TKyoseva/ARmini/docs/decisions/0002-chassis-on-beams.md

# 0002 · The chassis hangs from the beams, tracks level with the hull bottom (2026-10-02)

Context: the ROB0154 is a top plate plus side plates; the drive wheels are at the front top, and the motor axis is 62 mm above the tracks (measured). The waterline is ~42 mm.
Decision: the plate is bolted directly under the two beams (385 / 500 mm); the tracks are level with the bottom of the hulls, with no hangers and no lift.
Consequences: the motors are 20 mm above the water; the robot leaves the water on a wide ramp together with the hulls; v2 can raise the chassis by 10 mm if the tracks slow the boat down in the water.
