TKyoseva/ARmini/docs/releases/R-1101.md

# R-1101 · 01.11.2026 · G1

**What it shows:** AR-Mini left the bathtub. On one thruster hung from the beams (beam_leg), steered by a printed rudder, wired from the FINAL 2 sheet into a food box and powered by the 3S LiPo, it was launched from the bank at Pancharevo in rain and fog, drove and turned from the phone and came back to the bank. Before that: the right thruster's fault proven on a third driver, the left track driven from the DevKit, both thermal cameras giving first frames, the whole robot assembled dry with tracks.

Cut from Done on the AR-Mini Board, 10 cards. Previous cut: R-1024 (24.10).

| Card | What | Outcome | Number |
|---|---|---|---|
| C029 | MLX90640 110° on the arch, wired to the DevKit | Partial | 0x33 answers, hand max 34.8–35.0 °C, wall 18.3–18.6 °C vs ThermoSpot 17.6; intermittent "not found" at boot; 110° orientation unverified |
| C048 | MLX90642-D45 first heat map | Partial | 0x66 fw 1.20.0, 4 Hz, hand max 36.1 °C, wall 18.1–18.4 °C; range to Pesho not measured |
| C050 | Left track motor, one BTS7960 from the DevKit | Pass | idle 0.002 A at 12.00 V; `s 0.2` 0.067–0.088 A; dead-man stops in 2.000 s |
| C053 | First dry assembly of the whole robot with the tracks | Pass (record) | assembled; tracks removed again for the water runs |
| C054 | The home lab, 28.10 | Pass (record) | — |
| C055 | Both thrusters on an Arduino Mega (FAILS 173) | Pass | left 0.217 / 0.570 / 0.202 A at 1600 / 1650 / 1400 µs (C025 within 5 %); right brown-out loop 1.1–2.1 A, 12 → 8.75 V → right thruster faulty, confirmed |
| C056 | beam_leg: the thruster on the centreline under the beams | Pass | 2 h 37 min · 123.0 g black PETG; carried the thruster in the lake run |
| C057 | Rudder: MG90S + NACA 0015 blade behind the duct | Pass | blade + hub 3 h 09 min · 103.0 g; rudder_frame 2 h 27 min · 104.0 g; calibrated 31.10, turned the robot in the lake |
| C058 | Balance charge of the 3S LiPo | Pass | 11.10 → 12.60 V in 34 min, 1212 mAh, cells 4.20 / 4.20 / 4.20 V |
| C059 | Lake test at Pancharevo, FINAL 2 wiring, `remote_pool`, on battery | Partial | 01.11 08:40–08:52, rain, fog, 7–9 °C: launched, floated level, drove, turned and came back (C059_77 93 s). Lift: one servo on CH13 moved the cradle in the water and above it; Pesho was left at home, so no pick-up · VBAT at the end: not recorded · water in the box: none |

Still open and not in this cut: C021 Pesho v3, C030 pinout freeze, C032 carrier rev B (order pending), C047 camera mount, C049 OV3660 stream, C051 right track motor.

## ★ media (copied to iCloud `AR-Mini-Media/04_Releases/R-1101/`, originals stay in 01_Loops)

C050_11, C050_13, C050_15 · C053_01, C053_02, C053_07, C053_08 · C054_01, C054_04 · C055_03, C055_04, C055_06, C055_10, C055_11 · C056_05, C056_07, C056_08 · C057_04, C057_06, C057_07, C057_08, C057_09, C057_12 · C058_05, C058_06, C058_07, C058_09 · C059_01, C059_28, C059_31, C059_33, C059_37, C059_41, C059_44, C059_46, C059_50, C059_52, C059_53, C059_60, C059_62, C059_67, C059_72, C059_77, C059_78, C059_83, C059_91, C059_92

## Lessons (FAILS_AND_FIXES)

175–177 cameras (see C029/C048) · 178 the FINAL 2 sheet had the breadboard rails mirrored · 179 GPIO1 jumper in the 74HCT125 1OE row (thruster never got a pulse) · 180 OPEN: the cradle lift drives only the higher PCA9685 channel; the lake run used one lift servo on CH13.

## Milestones

R2a (thruster spins in a bucket from the DevKit) was met in R-1024 and is cut with this release. R2c ("swims in the pool on remote control") is met in open water instead of a pool: on battery, one thruster and a rudder, from the phone (12 min on battery; pick-up of Pesho not tried). R3a/R3b (thermal search → approach → lift) are not met: the cameras give frames but are not in the control loop.

## Portfolio

MIT Maker Portfolio v1 (G1): 24 slides P01–P02, P04–P25 + video P03 in iCloud `07_Portfolio/` (25 of 25 media). Not in git (photos never go into git).
