TKyoseva/ARmini/docs/releases/R-1024.md

# R-1024 · 24.10.2026 · G1

**What it shows:** both hulls are joined into one frame with beams, arch and arm; the arm lifts Pesho from the bench; the thruster spins from the DevKit and from a phone over WiFi with a tested fail-safe; and the whole robot floats stable in the bathtub and moves on one thruster.

Cut from Done on the AR-Mini Board, 13 cards. Previous cut: R-1018 (18.10).

| Card | What | Outcome | Number |
|---|---|---|---|
| C005 | thruster_arm on the thruster: 4 × M4 | Pass | all 4 M4 × 12 by hand → pattern 35.0 × 15.9 right; duct ring 42.95 long (not 112) |
| C006 | Thruster ESC at 9 V / 0.10 A in a bucket | Pass | idle 0.009 A; yellow idles 4.983 V, ~3.9 kΩ pull-up to 5 V → S8050 shifter, inverted output |
| C019 | 2 × pivot_bracket + 2 × TD-8120MG + linkages | Pass | assembled, bolted to both hull_fores, mirrored, swings by hand |
| C020 | Cradle: Ø5 aluminium rod bent into a U | Pass | legs ≈ 232, base not yet on the caliper; lifts Pesho between the hulls |
| C022 | R1b frame: right hull_fore + 2 × arch_post + arch tube | Pass | right hull_fore 6 h 17 min · 345.0 g PLA |
| C023 | Bench `pair` command: two TD-8120MG mirrored | Pass | lifts Pesho between the hulls at ~0.24 A |
| C024 | Bench `esc` env: both ESCs on GPIO1/2 | Pass | 1500 µs from the first line of setup(), arm 3 s, limit 1350–1650, ramp 200 µs/s |
| C025 | Thruster spins in a bucket from the DevKit | Pass | 1600 µs → 0.22 A, 1650 → 0.58 A, 1400 reverse → 0.21 A at 12 V; KILL → 1500 µs in 40 ms; right thruster faulty (FAILS 173) |
| C027 | Ladder bench: battery divider, leak, KILL | Pass | v_bat fit within ±0.02 V from 10 to 12.6 V |
| C028 | Drive on remote over WiFi + first float of the whole robot | Partial | draft 20 mm, dry hulls; left thruster 1640 µs · 0.58 A at 12 V moves and turns it; SAFE on stop / kill / disconnect / heartbeat. Open: second thruster, range walk, pool |
| C034 | hull_aft × 2 in PETG | Pass | 7 h 30 min + 7 h 34 min · 410.0 g each |
| C042 | Thruster mounts on the transom | Pass | 4 × ruthex M3 per pad at 220 °C; bracket plates do not rock |
| C045 | 4 × beam_bracket + 15 × 15 aluminium beams | Pass | 8 printed, 1 h 14 min · 39.0 g black PLA; beams seated at x 385 / 500 |

## ★ media (copied to iCloud `AR-Mini-Media/04_Releases/R-1024/`, originals stay in 01_Loops)

C005_04, C005_05 · C006_05 · C019_36, C019_41 · C020_03 · C022_16 · C023_15, C023_27 · C025_02, C025_04 · C027_01 · C028_04, C028_08, C028_10, C028_13, C028_16 · C034_35 · C042_04, C042_12 · C045_13

## Lessons (FAILS_AND_FIXES)

171 I2C one pin off · 172 two arm screws sheared on the first powered lift (arms clocked differently on the splines) · 173 right thruster clicks and never starts (swap onto the proven channel first) · 174 the phone remote went SAFE on ARM (unsigned time difference).

## Milestones

R2a ("thruster spins in a bucket from the DevKit; kick-up coupon fits") is met by C025 + C005/C042 and can be cut. R2c ("swims in the pool on remote control") is half-way: on remote in the bathtub, one thruster, tethered.

## Video

Release video: not cut yet (release video agent, `tools/video`).
