TKyoseva/ARmini/tasks/night/2026-10-22_T8_ladder-30k.md

# T8 · Ladder divider is 100k/30k, not 100k/33k · C027

**Branch** `night/ladder-30k` → PR to `dev` (small; can also go straight on `dev` from Desk 2)
**Budget** 15 min

## Goal
The fitted bottom resistor on the bench is 30 kΩ (measured 30 kΩ, top 100 kΩ, total 130 kΩ). Update the nominal so v_bat = v_adc × 130/30 (4.33) instead of 133/33 (4.03).

## Files to change
- `firmware/bench/include/pins_devkit.h` line ~60: `VBAT_DIV_R_BOT_OHM 30000.0f`, SOURCE note "C027 bench, measured 30 k".
- `firmware/bench/src/ladder/main.cpp`: comments "4.03" and "12.6 V × 33/133 = 3.13 V" → 4.33 and 12.6 × 30/130 = 2.91 V.
- `firmware/bench/src/ladder/PROTOCOL.md`: 133/33 → 130/30 everywhere.
- Do NOT change `pcb/carrier-revA/SPEC.md` (the PCB keeps 33 k); add one line there only if a note is useful: "bench C027 uses 30 k".

## Definition of done
- [ ] `grep -rn "133\|33000" firmware/bench` shows no stale divider value
- [ ] `pio run -e ladder` builds, `scripts/check.sh` green
- [ ] commit `firmware: ladder divider bottom (33k → 30k) · C027`
