TKyoseva/ARmini/docs/releases/R-1018.md

# R-1018 · 18.10.2026 · G1

**What it shows:** the R1b mechanical parts are printed and fitted by hand, the motor PWM pins are safe at boot, and every ordered part has arrived.

Cut from Done on the AR-Mini Board, 8 cards. Previous cut: R1a (11.10). Board tab History (CH01–CH15) added in the same period.

| Card | What | Outcome | Number |
|---|---|---|---|
| C011 | Orange plate: arm_drive, 2 × arm_idler, 2 × coupler (PLA) | Partial | 1 h 12 min · 41.0 g; thruster_coupon skipped (C005 tests the real arm) |
| C015 | GPIO39–42 at boot: is the left BTS7960 driven at reset? | Partial | 39 reads 3.148 V running / 3.231 V in download mode, 0 V with 10 kΩ → 10 kΩ pull-downs on 39–42 |
| C035 | Arrivals 12.10: lab supply, 4 × ST3215, MLX90640, BNO055, Pi 5, logic analyser | — | delivery record |
| C037 | Black R1b plate: 2 × pivot_bracket (mirrored) + 2 × arch_post | Pass | 5 h 45 min · 176.0 g |
| C038 | Cable hole in both pivot_brackets so the TD-8120MG seats | Pass | ears flat on the block face, arm_drive on the disc horn |
| C039 | Pesho v3: head + lid (PETG), body (PLA) | Partial | body 4 h 44 min · 143.0 g; left arm broke on removal |
| C040 | Arrivals 13.10: the last Amazon batch | — | BOM has no row left in Ordered or Dispatch |
| C041 | Thruster kick-up mounts after the CAD fix (pin 14 → 19) | Pass | 2 h 52 min · 96.0 g PETG |

## ★ media (copied to iCloud `AR-Mini-Media/04_Releases/R-1018/`, originals stay in 01_Loops)

C011_01 (timelapse), C011_11, C011_15, C011_16 · C015_02 · C019_04, C019_07 (C038) · C021_10, C021_21, C021_22 (C039) · C035_04 · C037_04, C037_08 · C040_18 · C041_03, C041_04, C041_06

## Lessons (FAILS_AND_FIXES)

151 thruster arm boss collided with the bracket plate (caught in CAD) · C038 servo pocket had no cable slot · C039 cut tree supports before lifting a part off the bed.

## Video

Release video: not cut yet (release video agent, `tools/video`).
