TKyoseva/ARmini/docs/timeline/TIMELINE.md

# Timeline (real dates)

The repository was created on 2026-10-06. Everything before that date was **imported** with the original files kept; the dates below are the real ones (photo EXIF, documents, emails), not the commit dates.

| Date | What | Evidence in the repo |
|---|---|---|
| 2025-09 | Start of AmphiReach with Horizon Academic (mentor John Hood) | — |
| 2025-… | Simulation environment, 64 missions | sim/ |
| 2026-… | Paper accepted by NHSJS; revision ready 30.09.2026 | (the manuscript is not in the repo) |
| 2026-… | Presented at the Bulgarian Academy of Sciences (IMI) and UchIMI | docs/ |
| 2026-09-28 | Decision to build the physical prototype AR-Mini for the MIT Maker Portfolio | docs/decisions/ |
| 2026-10-02 | First measurements of the ROB0154, TD-8120MG, XIAO; CAD v1.4–1.6 | cad/openscad |
| 2026-10-03 | Power box (printed, blue PLA, test piece); rev 0 breakout board generated | pcb/xiao-breakout-rev0 |
| 2026-10-04 | Lab equipment (Bauhaus); BOM v04.10; repository structure | docs/bom |
| 2026-10-05 | TD-8120MG measured → CAD v1.8; rev 0 DRC in three rounds → clean | pcb/xiao-breakout-rev0/drc |
| 2026-10-06 | 3D model → beams collide with the power box → CAD v1.9; architecture v1; visual BOM; first thruster arrived; repository created | cad/3d, docs/diagrams, media/photos |
| 2026-10-07 | DevKit-Lipo and measuring tools arrive; breadboard sheets; new plan: alone + AI agents, goal 01.11; test tracker, AGENTS.md, CI checks | AGENTS.md, docs/process, hardware/breadboard, .github |
| 2026-10-08 | C001 thruster measured, C002 thruster wires tested; first night task (T1) | data/board, docs/decisions/0004 |
| 2026-10-09 | C003 plate measured (Fail) → CAD v2.0 with the kick-up thruster mount; kanban board; specs for the parts and video agents | cad/openscad, tasks/night, parts/ |
