TKyoseva/ARmini/tasks/night/2026-10-08_T2_safety.md

# T2 · Safety layer (leak, kill, battery, heartbeat) with tests

**Branch:** `night/safety` → PR to `dev`
**Budget:** ~2 h agent time, or 3 failed attempts at one step.
**Depends on:** T1 (`firmware/armini/`). If T1's branch is not merged yet, branch from `night/state-machine`; say so in the PR.

## Goal
A pure C++ `Safety` module in `firmware/armini/lib/core/` that decides, every tick, whether the robot may run. It debounces the leak probe, reacts to the kill switch immediately, applies battery hysteresis, watches a heartbeat, **latches** once tripped and releases only on an explicit reset with no active cause. Its verdict feeds `StateMachine` (SAFE). Fully unit-tested on the host. Plus the ESP32 hardware watchdog armed in `main.cpp`.

## Context
Read: `pcb/carrier-revA/SPEC.md` (R10 / OE / kill rocker section, the A1 ladder), `hardware/wiring/PINOUT.md`, `hardware/breadboard/AR-Mini_breadboard_2b_devkit-lipo.png`, `docs/FAILS_AND_FIXES.md` (search "kill", "OE", "leak", "fuse").

Facts with source:
- XIAO design, A1 ladder (SPEC.md / breadboard sheet 2): 10 kΩ pull-up to 3.3 V; leak probe pulls down through 4.7 kΩ when wet; KILL pulls down through 1 kΩ. Expected ADC voltages: open ≈ 3.30 V, leak only ≈ 1.06 V, kill only ≈ 0.30 V, both ≈ 0.25 V. Decode thresholds: `< 0.6 V → KILL`, `0.6–2.0 V → LEAK`, `> 2.0 V → OK`. Put the resistor values and the formula in the header comment.
- DevKit-Lipo design (breadboard sheet 2b): leak and kill may be on separate GPIOs. The module must accept **both** forms: a ladder voltage decoder *and* plain booleans.
- Battery: 2 × LiPo 3S (README). VBAT divider 100 kΩ / 33 kΩ (PINOUT) → `v_bat = v_adc × 133 / 33`. Thresholds are **config**, defaults `trip 9.9 V` (3.3 V/cell) and `reset 10.5 V`, both `// VERIFY: Teddy decides`.
- PCA9685 OE: hardware kill already forces the PWM outputs off (SPEC.md). The software layer is the second line, not the first. Say that in the README.

## Files to create / change
```
firmware/armini/lib/core/Safety.h / .cpp
firmware/armini/lib/core/Ladder.h                  decodeLadder(float v) -> OK | LEAK | KILL (pure function)
firmware/armini/test/test_core/test_safety.cpp
firmware/armini/test/test_core/test_ladder.cpp
firmware/armini/src/main.cpp                       call Safety every tick; feed verdict into StateMachine; arm esp_task_wdt (2 s) and reset it each loop
firmware/armini/README.md                          add "Safety" section: causes, debounce times, hysteresis, latch/reset, what hardware does vs software
```

### Behaviour
- `Verdict tick(const SafetyInputs&, uint32_t now_ms)`; inputs: `leak_raw` (bool), `kill_raw` (bool), `v_bat`, `heartbeat_ok` (bool, main loop alive), optional `ladder_v` (if ≥ 0, decode it and OR into leak/kill).
- Leak: must be continuously true for `cfg.leak_debounce_ms` (default 100 ms, `// VERIFY`) before tripping. A 50 ms splash does not trip.
- Kill: trips on the **first** tick it is seen. No debounce.
- Battery: trips when `v_bat < cfg.v_trip` for `cfg.batt_debounce_ms` (default 500 ms); clears only when `v_bat > cfg.v_reset` (hysteresis). A single bad ADC sample (one tick) does not trip.
- Heartbeat: `heartbeat_ok == false` for `cfg.heartbeat_timeout_ms` (default 500 ms) → trip.
- Latch: once tripped, `verdict.safe == false` and `verdict.reason` stays until `reset()` is called **and** no cause is currently active. `reset()` with an active cause returns false and changes nothing.
- `reason` is a small enum: `NONE, LEAK, KILL, BATTERY, HEARTBEAT`. If several trip in the same tick, priority KILL > LEAK > BATTERY > HEARTBEAT.
- No heap, no Arduino types, time passed in.

## Do not touch
Everything outside `firmware/armini/` and `scripts/check.sh`. Do not change T1's state machine logic beyond consuming the verdict (it already has leak/kill/battery_low inputs; map `!verdict.safe` onto them or add one `safety_tripped` input, your choice, tests updated accordingly).

## Tests — minimum
Ladder: the four voltage cases; the two thresholds exactly at the boundary; negative value = "not present".
Safety:
1. leak 50 ms then dry → no trip; leak 100 ms → trip, reason LEAK
2. kill one tick → trip immediately, reason KILL
3. kill + leak same tick → reason KILL
4. battery 9.8 V one tick → no trip; 600 ms → trip; rises to 10.2 V → still tripped (latch); reset at 10.2 V → refused; reset at 10.6 V → accepted
5. heartbeat false 400 ms → ok; 500 ms → trip
6. latch: cause clears, verdict still unsafe until reset
7. verdict feeds StateMachine: SEARCH + leak 100 ms → SAFE (integration test over both modules)
8. ladder path and boolean path give the same result

## Definition of done
- [ ] `pio test -e native` all pass, 0 warnings, including T1's tests
- [ ] `pio run -e devkit_lipo` builds with the task watchdog armed
- [ ] `bash scripts/check.sh` → `check: OK`
- [ ] README "Safety" section written, with the resistor math
- [ ] PR to `dev`, title `fw: safety layer with latch + tests (T2)`

## PR description must include
- the defaults you chose and which are `VERIFY`
- confirmation that kill is the only non-debounced cause
