TKyoseva/ARmini/tasks/night/2026-10-08_T3_bench.md

# T3 · Bench sketches for every module (DevKit-Lipo) + serial logger

**Branch:** `night/bench` → PR to `dev`
**Budget:** ~3 h agent time, or 3 failed attempts at one step.
**Independent of T1/T2.**

## Goal
In the morning Teddy can plug one module at a time into the DevKit-Lipo and run a known-good test sketch that prints CSV at 10 Hz, accepts a few serial commands, ramps slowly, has a soft power limit and a dead-man timeout. Each sketch has a one-page protocol: wiring, what to measure before power, expected numbers, pass criterion, what to photograph. A Python logger saves the CSV under the loop id for the tracker.

## Context
Read: `firmware/mega/bench/bench_v1.ino` (the Mega version: pot → BTS7960 with PWM_MAX 150, servo 20–160°, CSV 10 Hz — keep the same spirit), `hardware/breadboard/*.png` (the three breadboard sheets; sheet 2b is the DevKit-Lipo), `hardware/wiring/PINOUT.md`, `pcb/carrier-revA/SPEC.md`, `docs/bom/bom.csv` (module names and specs), `firmware/xiao/platformio.ini` (library names already chosen: Adafruit MLX90640, PWM Servo Driver, BNO055; SCServo from Waveshare).

Olimex ESP32-S3-DevKit-Lipo facts (manual p7, already in the repo image `Olimex_DevKit-Lipo_pinout_manual-p7.png`): used on board: GPIO5 = PWR_SENS, GPIO6 = BAT_SENS, GPIO38 = LED (active low), GPIO0 = button — **do not use these for modules**. 3V3 output max 600 mA. On-board LiPo connector is 1S only, never the 3S pack.

Pins: take them from the DevKit-Lipo breadboard sheet (2b). Put every pin in **one** header `include/pins_devkit.h`, each line with `// SOURCE: breadboard 2b` or `// VERIFY` if the sheet is ambiguous (e.g. which of a pair is SDA/SCL: pick one, mark VERIFY, list it in the README). Also add a "DevKit-Lipo" table to `hardware/wiring/PINOUT.md` from that header.

## Files to create
```
firmware/bench/platformio.ini          one env per module, build_src_filter selects src/<module>/ + src/common/
firmware/bench/include/pins_devkit.h
firmware/bench/src/common/{Csv.h, Ramp.h, Deadman.h, Cli.h/.cpp}   small shared helpers
firmware/bench/src/bts7960/main.cpp    one BTS7960: cmd `s <-1..1>`, ramp 0.5/s, soft limit cfg (default 0.6 = 150/255), prints t,cmd,pwm_r,pwm_l,is_r,is_l(mV)
firmware/bench/src/pca9685/main.cpp    PCA9685: `ch <n> <us>`; sweeps a hobby servo on ch0; prints t,ch,us; OE handling per SPEC
firmware/bench/src/st3215/main.cpp     bus servo via Waveshare adapter: `id <n>`, `pos <deg>`, `read` → prints t,id,pos,load,temp,volt
firmware/bench/src/mlx90640/main.cpp   32×24 at 4 Hz: prints t,min,max,mean,hot_x,hot_y and every 2 s one ASCII heat map; `raw 1` streams all 768 values
firmware/bench/src/bno055/main.cpp     prints t,heading,roll,pitch,cal_sys,cal_gyro,cal_acc,cal_mag; `cal` prints calibration offsets
firmware/bench/src/ladder/main.cpp     reads VBAT divider + leak/kill inputs: prints t,v_adc,v_bat,leak,kill (no actuators)
firmware/bench/src/<module>/PROTOCOL.md   one per module (see below)
firmware/bench/README.md               how to pick an env, flash, log; table env → module → protocol
scripts/bench_log.py                   `python3 scripts/bench_log.py --port /dev/tty.usb* --card C005 --name bts-bench` → data/logs/<date>_C005_bts-bench.csv, echoes to screen, Ctrl-C closes cleanly
tests/data/README.md                   naming rule for CSV files (same loop id as the tracker)
```

### Common behaviour (all sketches)
- CSV header once, rows at 10 Hz (MLX: 4 Hz), `t_ms` first column, no units in values, units in the header name (`is_r_mV`).
- CLI over Serial 115200: `?` help, `0` stop everything, module commands as above. Unknown command → `ERR <cmd>`.
- **Dead-man:** any actuator sketch stops outputs if no command arrived for 2 s (configurable). Print `DEADMAN` once.
- **Ramp:** actuator commands never jump; rate limit in the `Ramp` helper.
- **Soft limit:** actuator sketches start with the limit at 60 % and refuse `s 1.0` until `limit 1.0` is sent explicitly (printed as a warning).
- No WiFi, no secrets, nothing stored.

### PROTOCOL.md (each module, ≤ 1 page)
1. Wiring table pin → pin (from `pins_devkit.h`), wire colours.
2. **Before power:** continuity / short checks with the multimeter and expected readings (Ω).
3. **First power:** source (bench supply, current limit value), what to watch.
4. Steps with the CLI commands and the expected CSV numbers, with tolerance where known (e.g. ST3215 reports position within ±2° of command). Where you do not know the expected number, write `expected: record` — never invent.
5. Pass criterion, 1 line.
6. Photos: which (meter display, wiring, screen) and the file name pattern `C###_NN.jpg` in the card folder (see media/LINKS.md).

## Do not touch
`firmware/xiao/`, `firmware/mega/`, `firmware/armini/`, `cad/`, `pcb/`, `docs/bom/`, `.github/`.

## Tests
Put `Ramp`, `Deadman` and the CSV formatter in `firmware/bench/lib/benchcore/` (pure C++) and add `[env:native]` with Unity tests:
1. Ramp never exceeds the rate; reaches the target; handles sign change
2. Deadman trips after the timeout, resets on any command
3. CSV row formatting (fixed decimals, no trailing comma)
4. Soft limit refuses above-limit commands until unlocked

## Definition of done
- [ ] `cd firmware/bench && pio run` builds **every** env, 0 warnings
- [ ] `pio test -e native` passes
- [ ] `bash scripts/check.sh` → `check: OK` (add `firmware/bench` to section 5 if the loop does not pick it up)
- [ ] 6 PROTOCOL.md files + README + `tests/data/README.md`
- [ ] `python3 scripts/bench_log.py --help` works; a `--fake` flag generates 3 s of fake CSV so the script can be tested without hardware
- [ ] `hardware/wiring/PINOUT.md` has the DevKit-Lipo table, with every `VERIFY` listed at the bottom
- [ ] PR to `dev`, title `fw: bench sketches for 6 modules + serial logger (T3)`

## PR description must include
- the pins marked `VERIFY`
- library versions pinned in `platformio.ini`
- anything that did not compile and why
