TKyoseva/ARmini/docs/diagrams/AR-Mini_architecture_v4.pdf

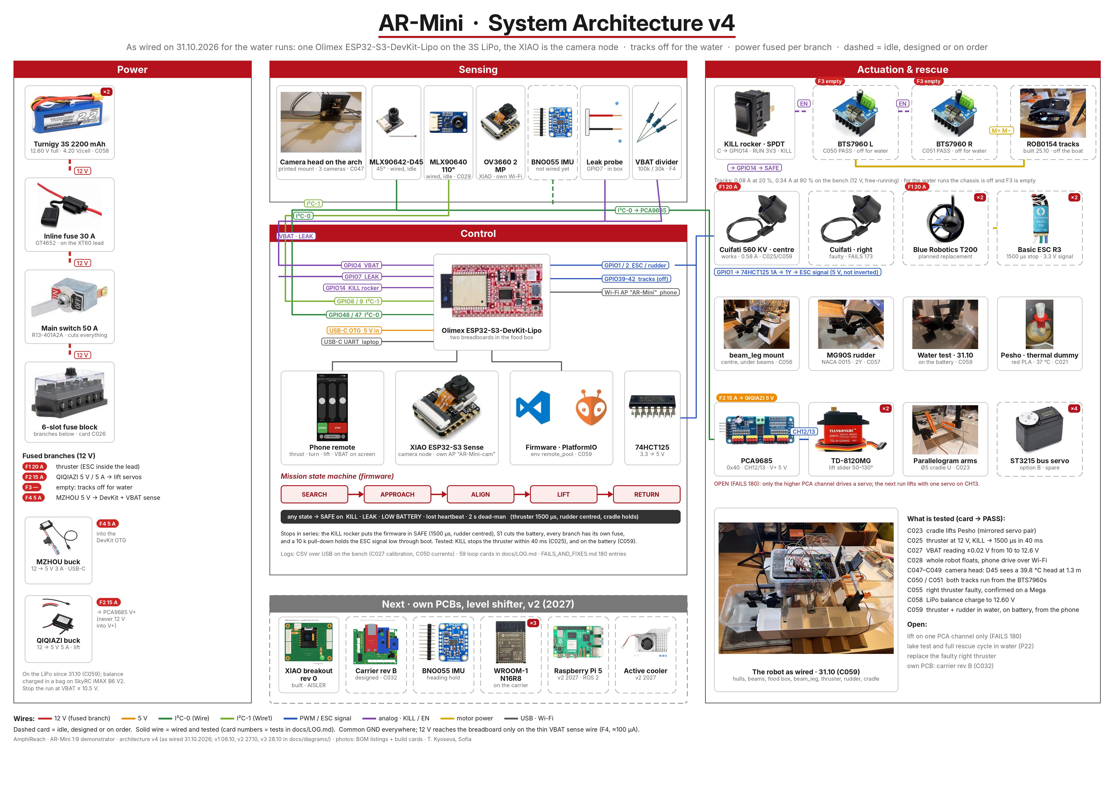
[picture p2: page 1]
