TKyoseva/ARmini/docs/diagrams/AR-Mini_hardware_poster_A3.pdf

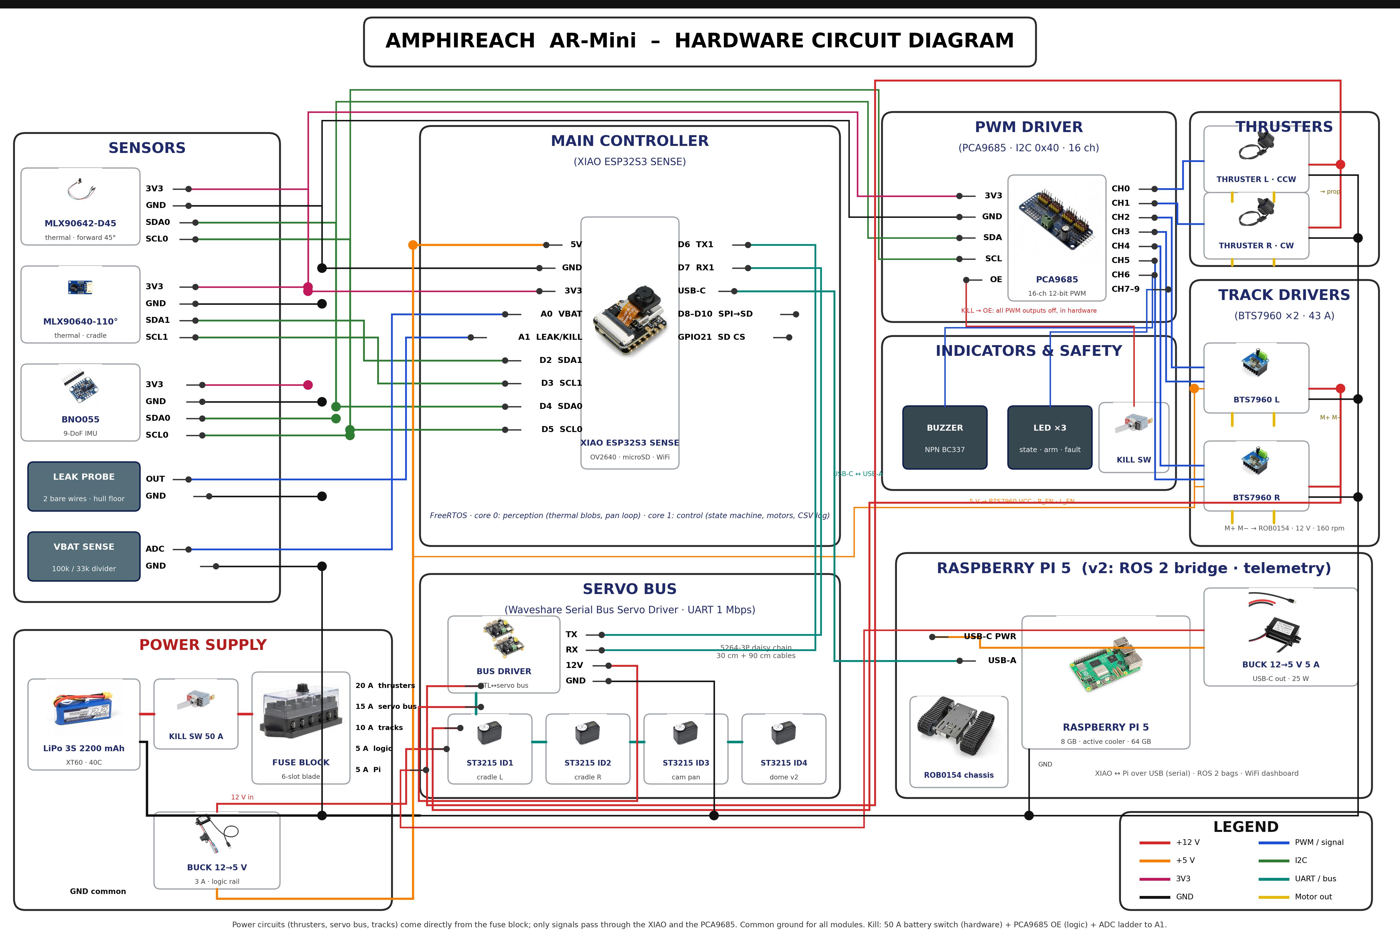
[picture p6: page 1]
