TKyoseva/ARmini/docs/process/AR-Mini_human_in_the_loop_v1.pdf

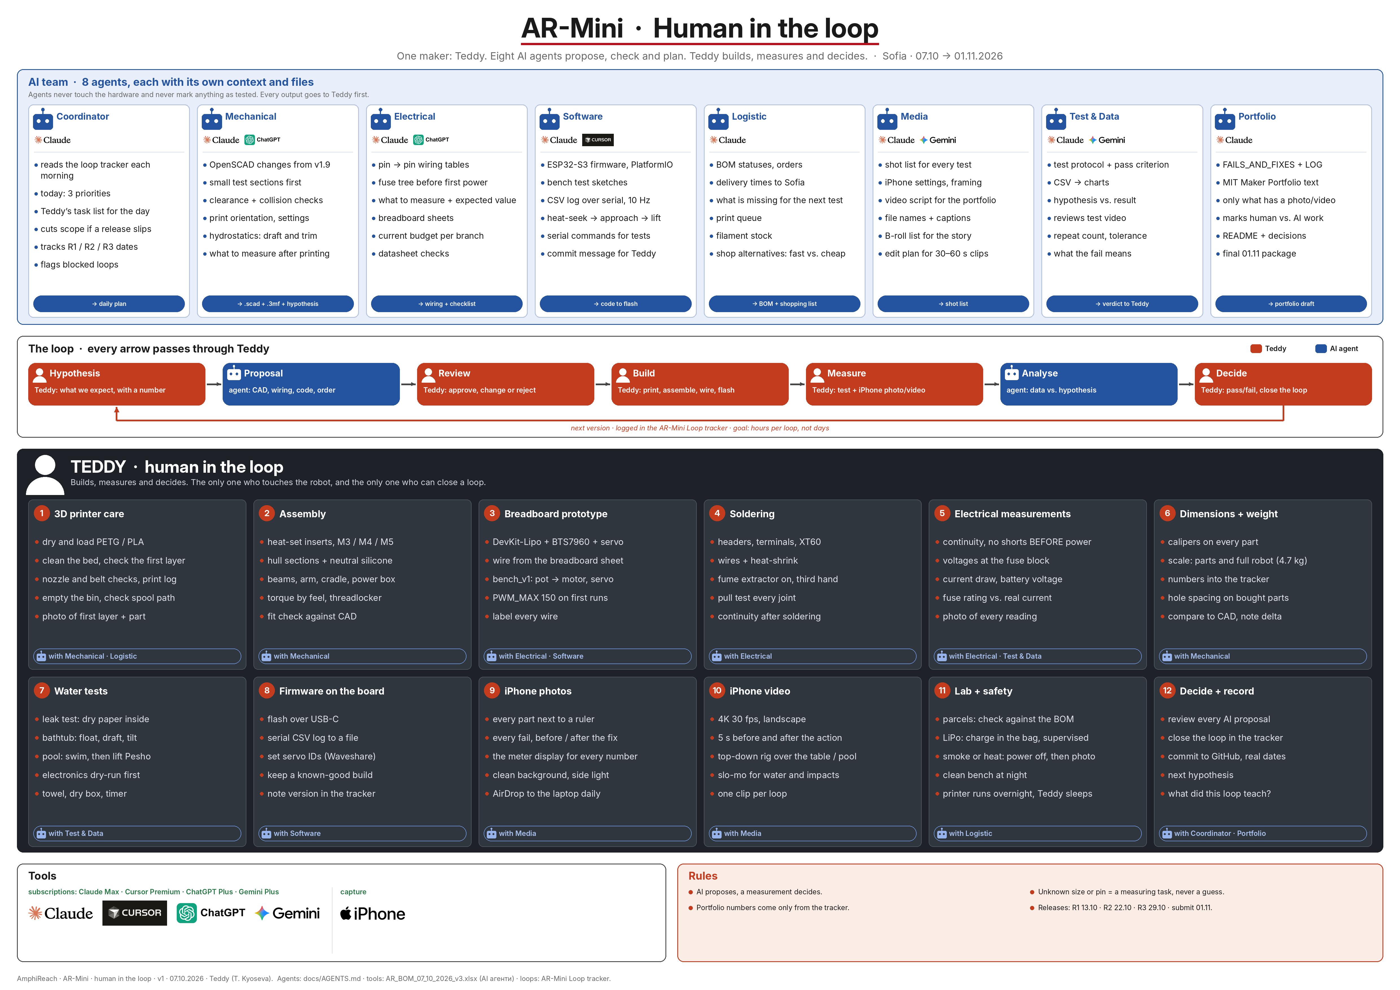
[picture p7: page 1]
