TKyoseva/ARmini/docs/process/AR-Mini_structure_v2.pdf

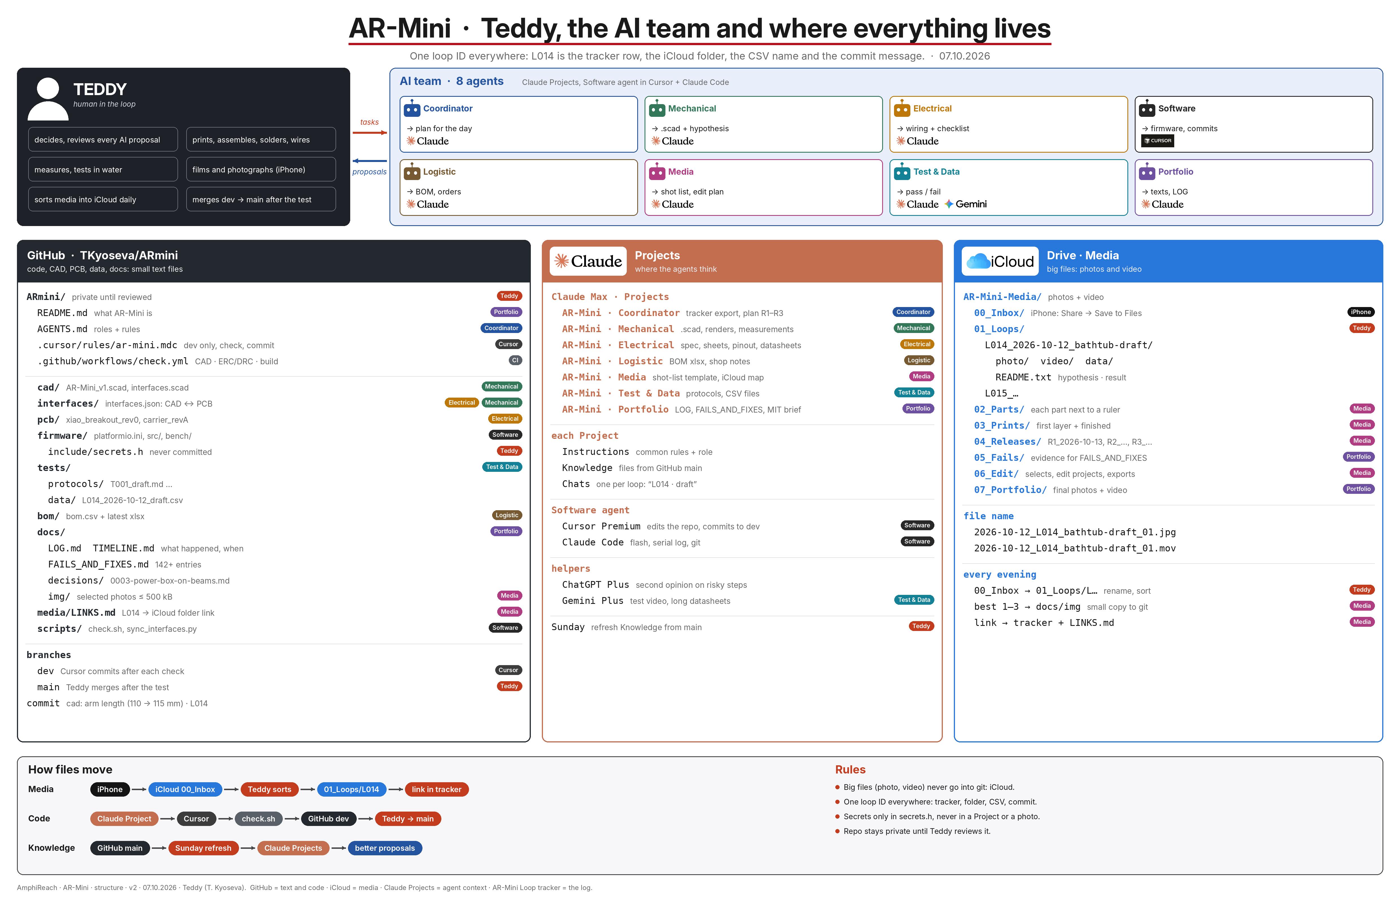
[picture p8: page 1]
