TKyoseva/ARmini/docs/process/AR-Mini_tool_map_v1.pdf

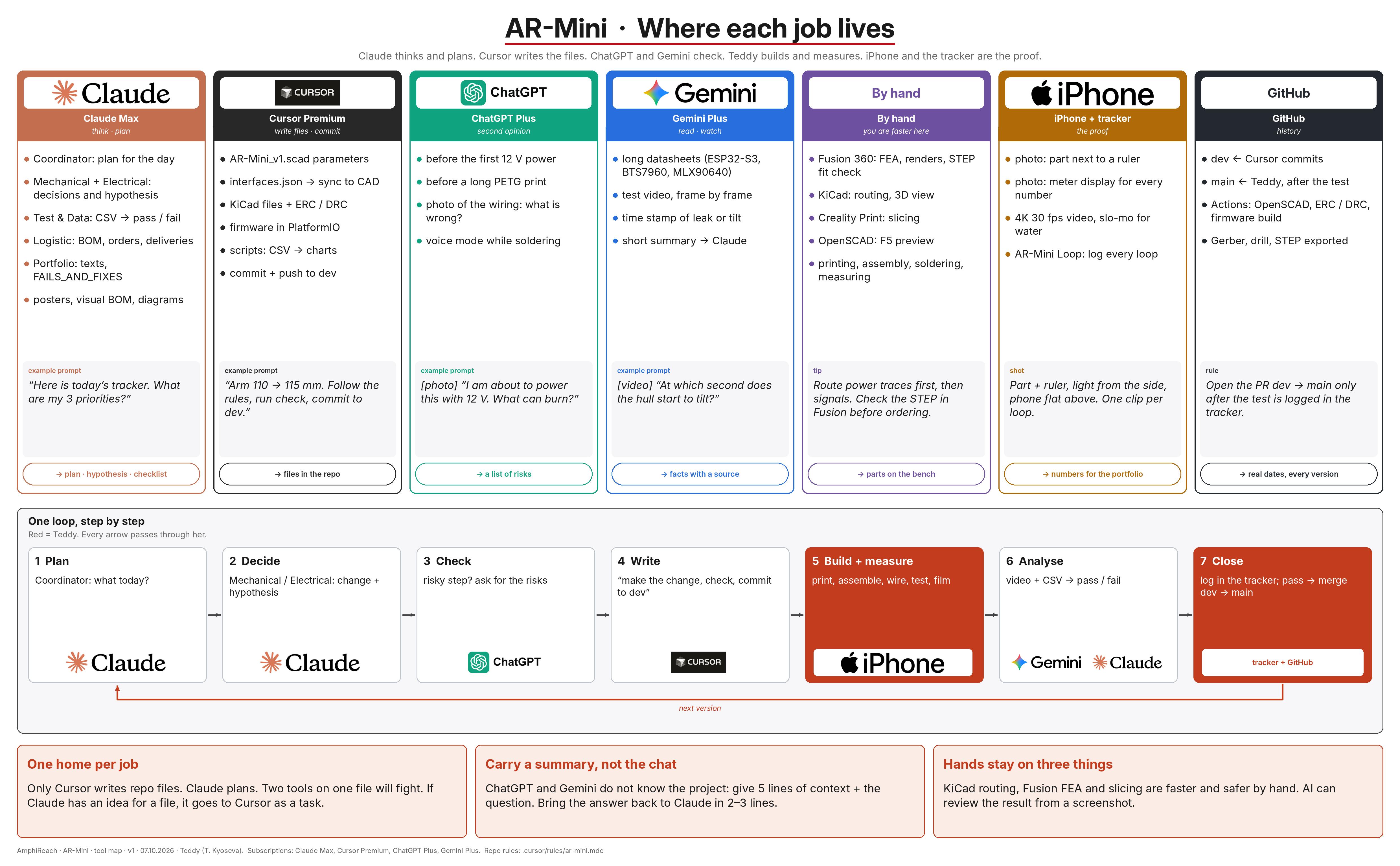
[picture p9: page 1]
