TKyoseva/ARmini/docs/diagrams/AR-Mini_states_T1_mission.pdf

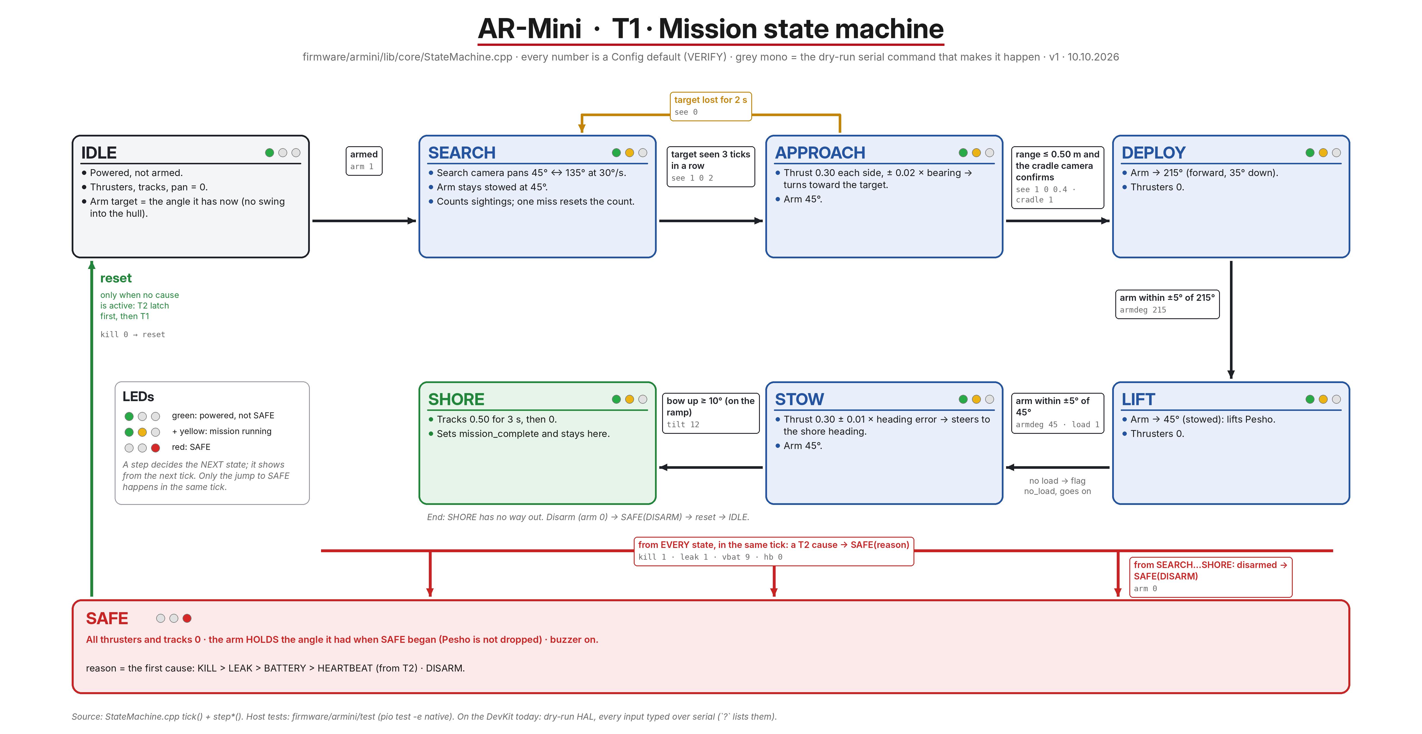
[picture p10: page 1]
