TKyoseva/ARmini/docs/diagrams/AR-Mini_states_T2_safety.pdf

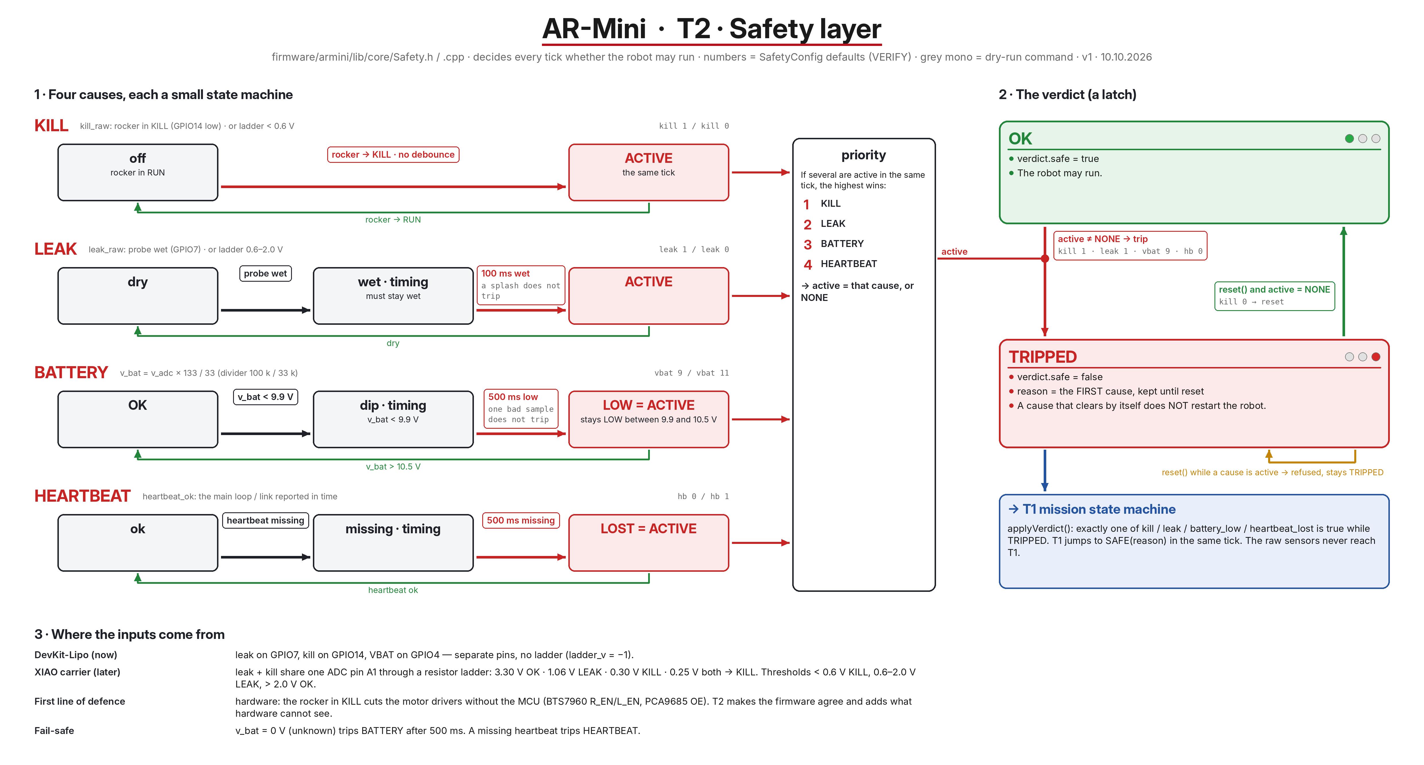
[picture p11: page 1]
