TKyoseva/ARmini/docs/diagrams/AR-Mini_states_T3_bench.pdf

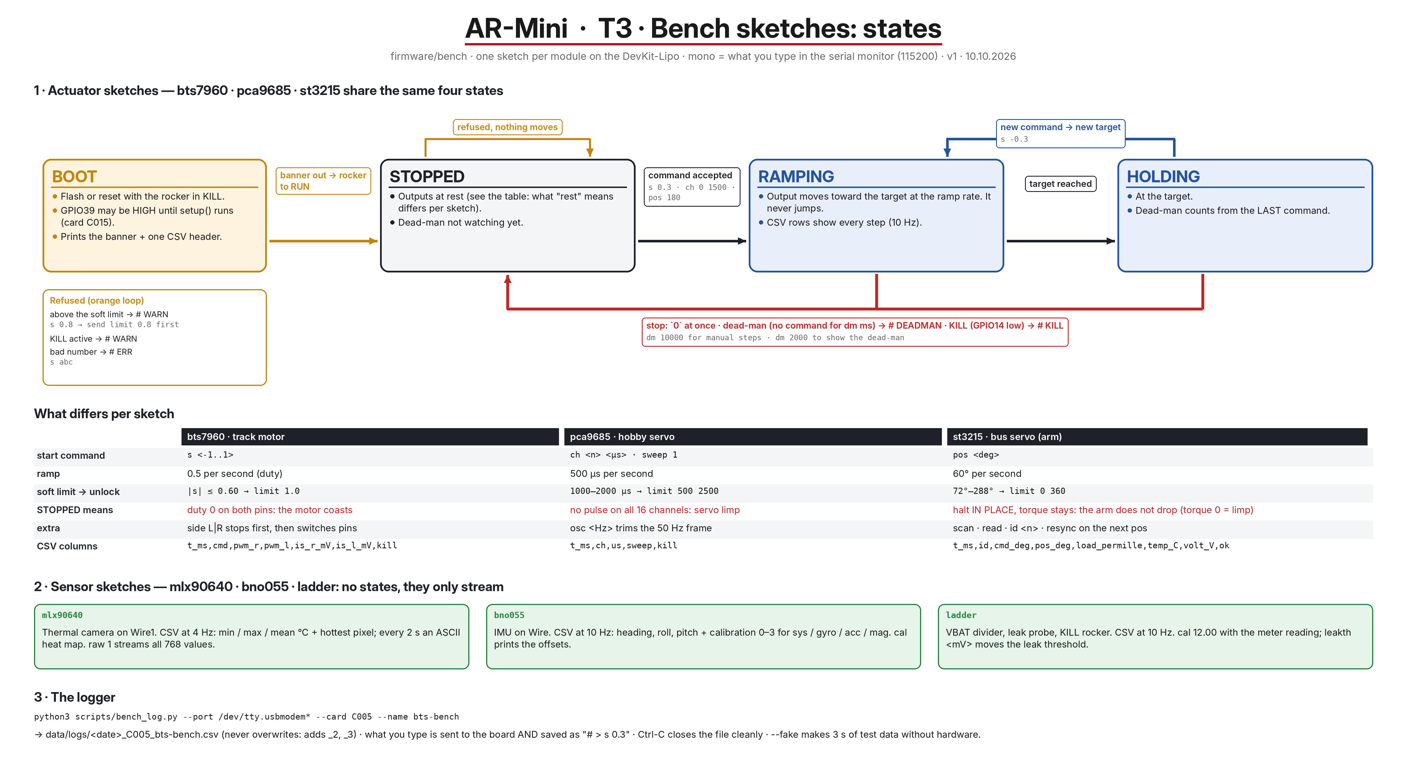
[picture p12: page 1]
