TKyoseva/ARmini/docs/process/AR-Mini_github_flow_v1.pdf

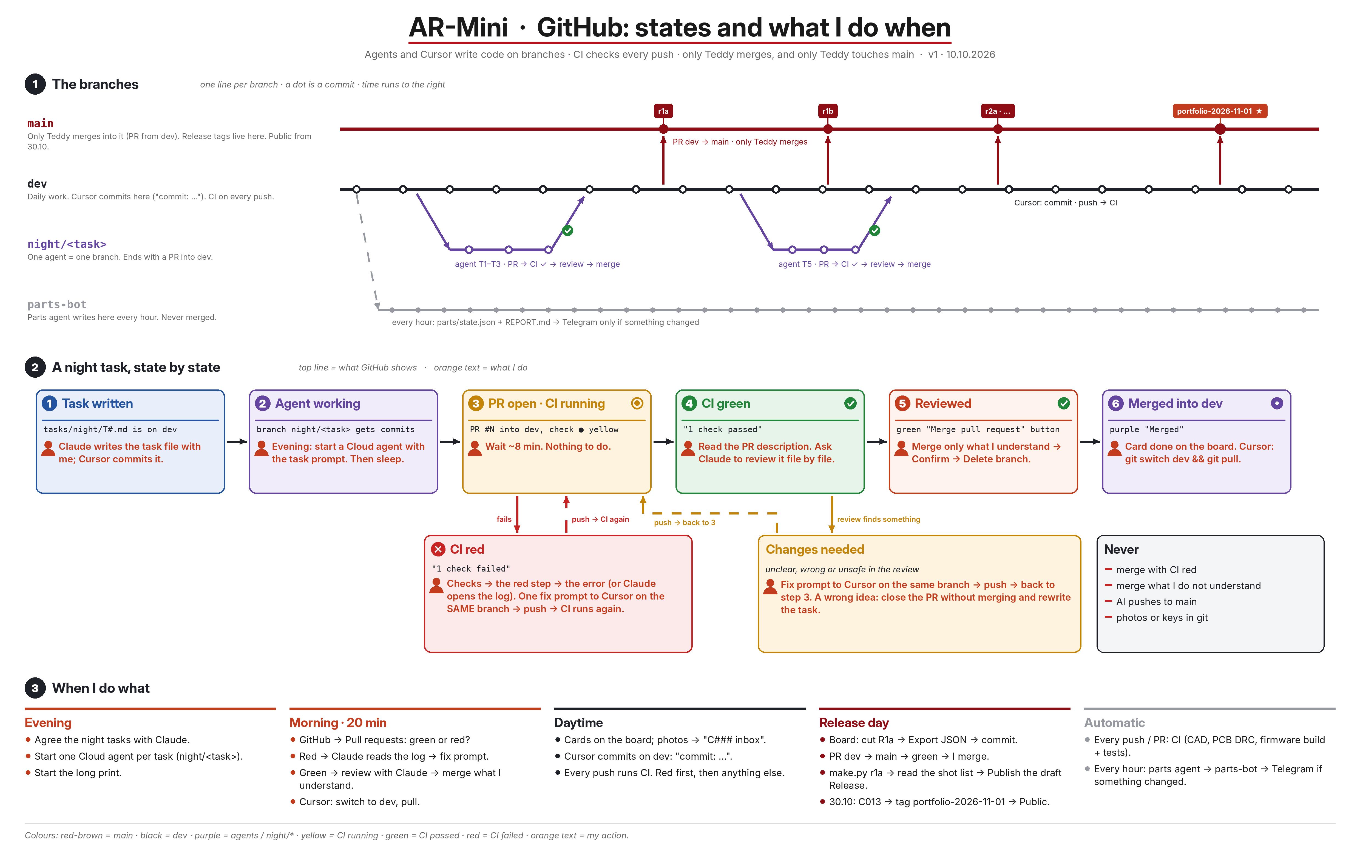
[picture p13: page 1]
