TKyoseva/ARmini/docs/process/AR-Mini_info_flow_v1.pdf

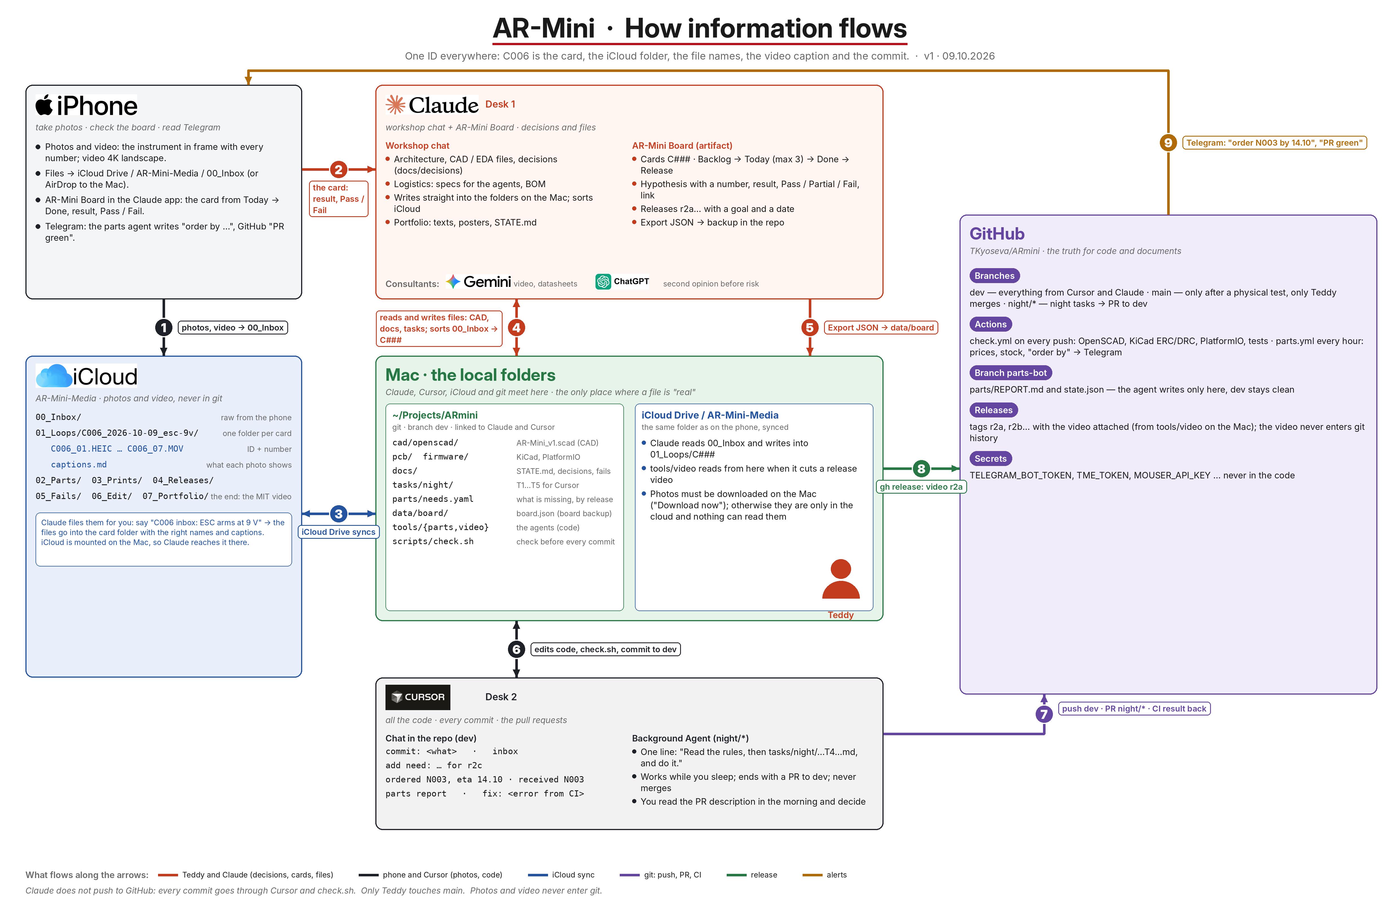
[picture p14: page 1]
