TKyoseva/ARmini/docs/process/AR-Mini_lab_protocol_v2_A3.pdf

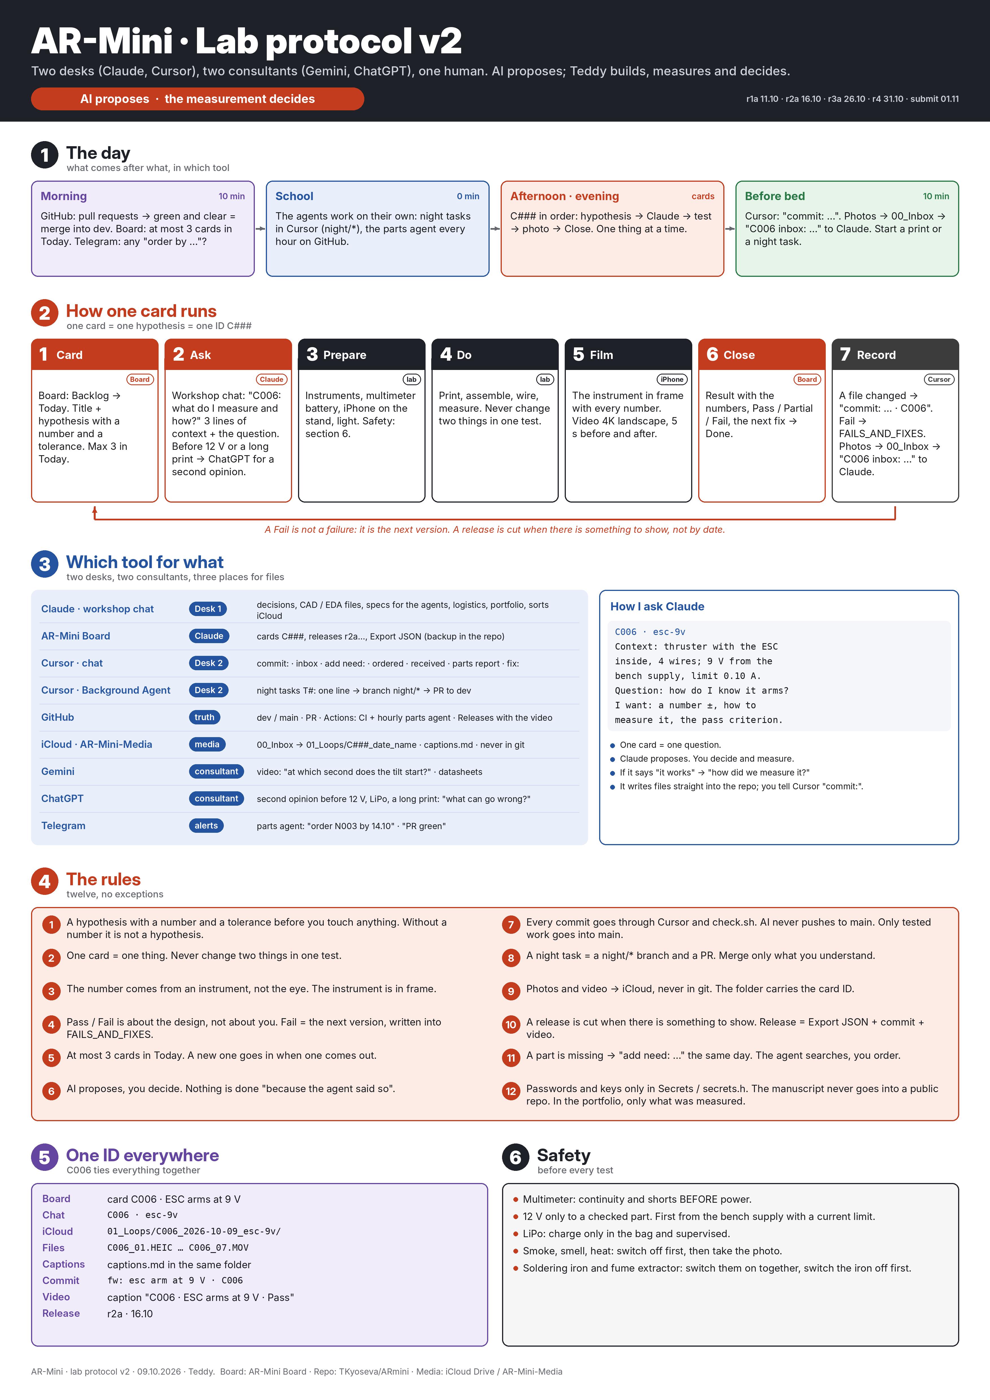
[picture p15: page 1]
