TKyoseva/ARmini/docs/diagrams/AR-Mini_architecture_v3.pdf

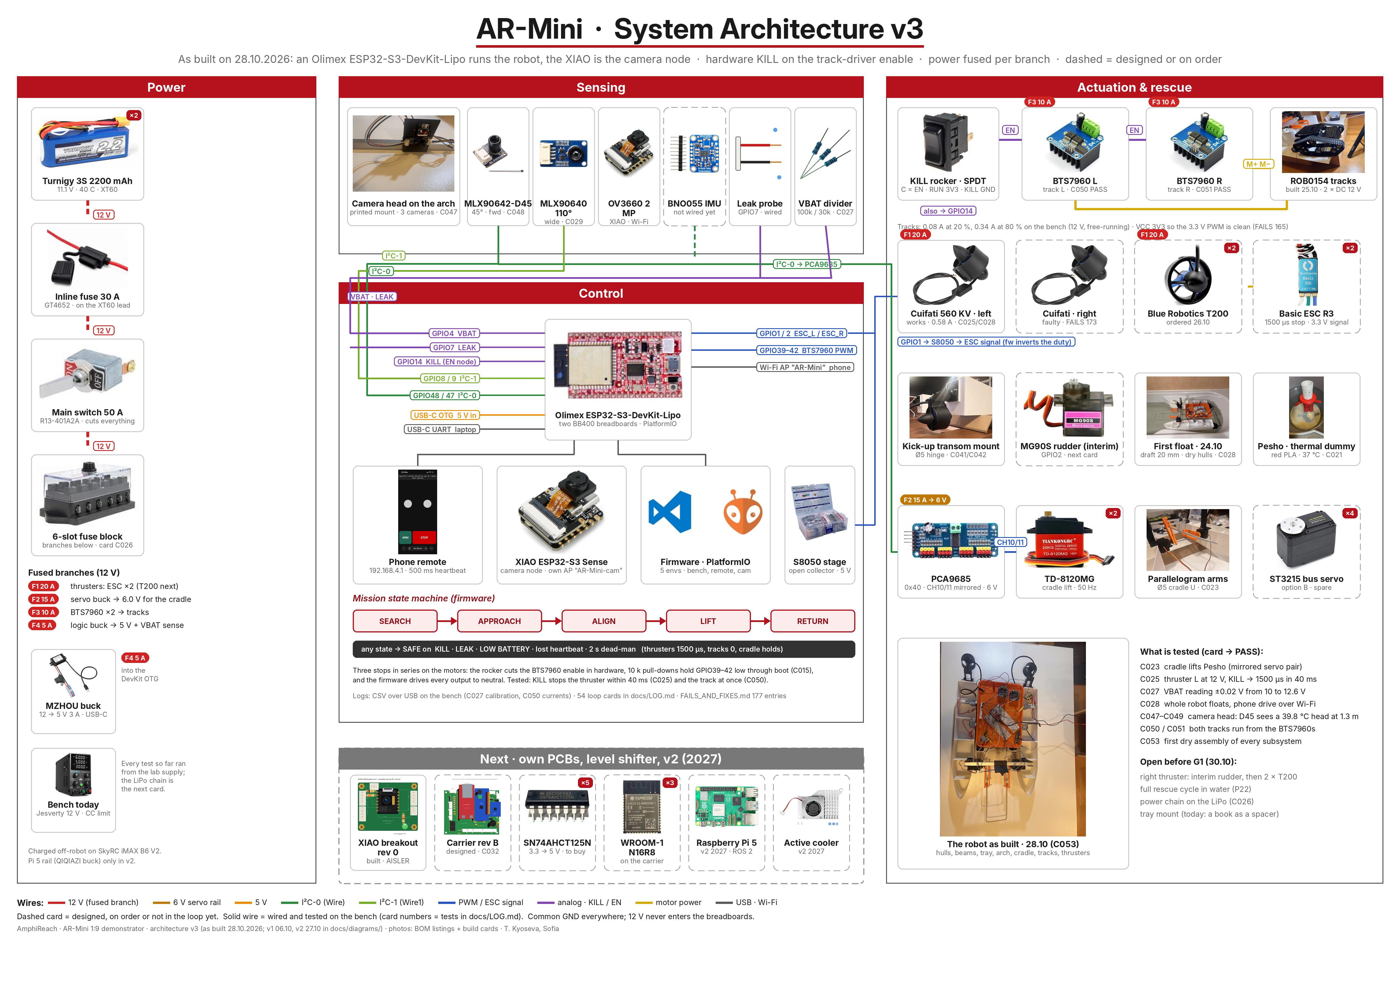
[picture p16: page 1]
