TKyoseva/ARmini/docs/diagrams/AR-Mini_architecture_v1.pdf

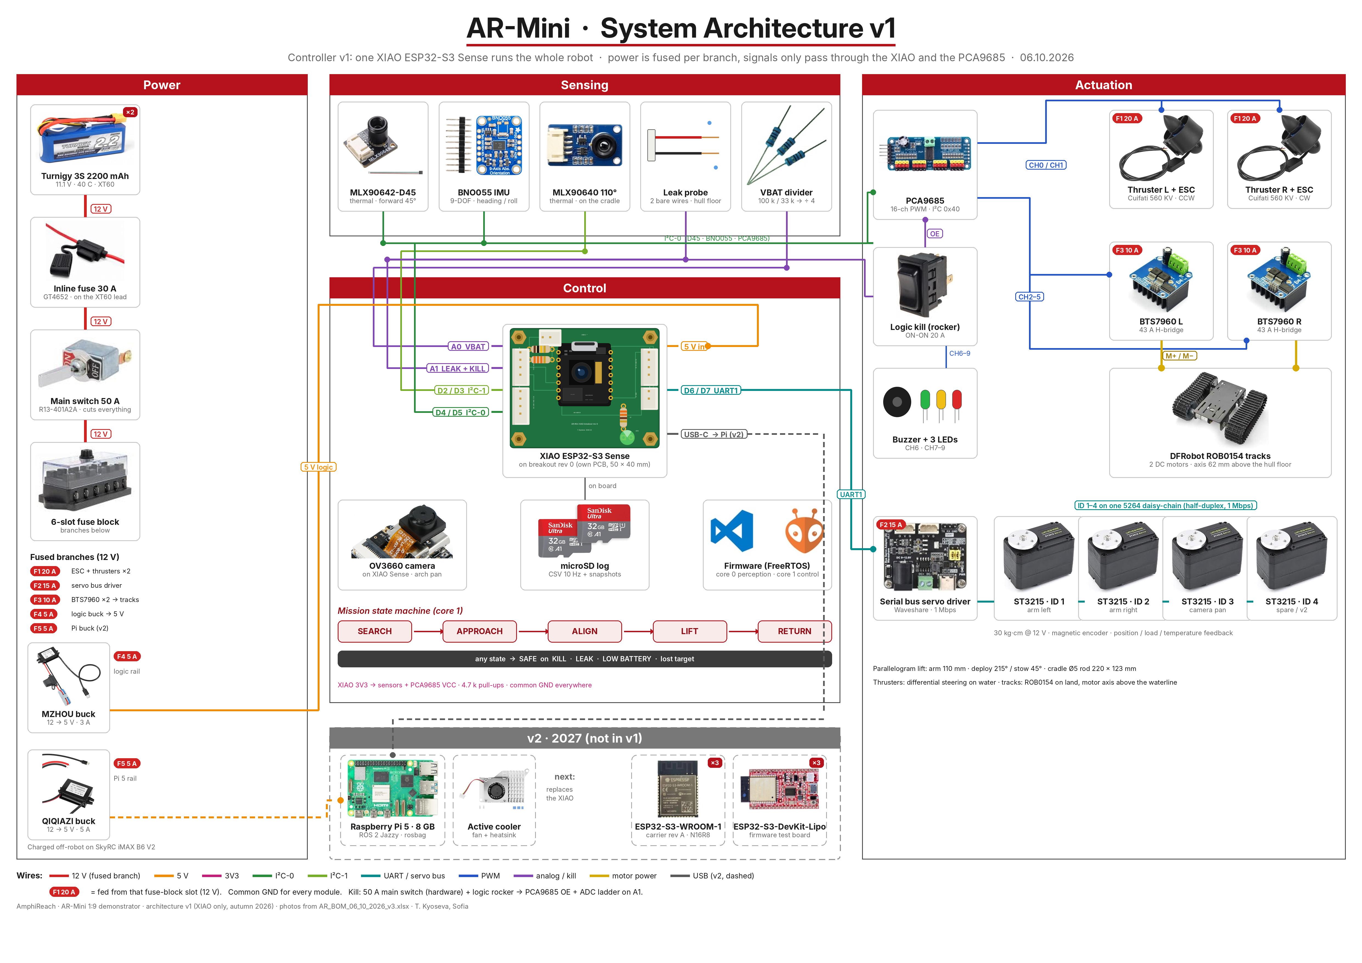
[picture p17: page 1]
