TKyoseva/ARmini/cad/3d/AR-Mini_3D_hero.png

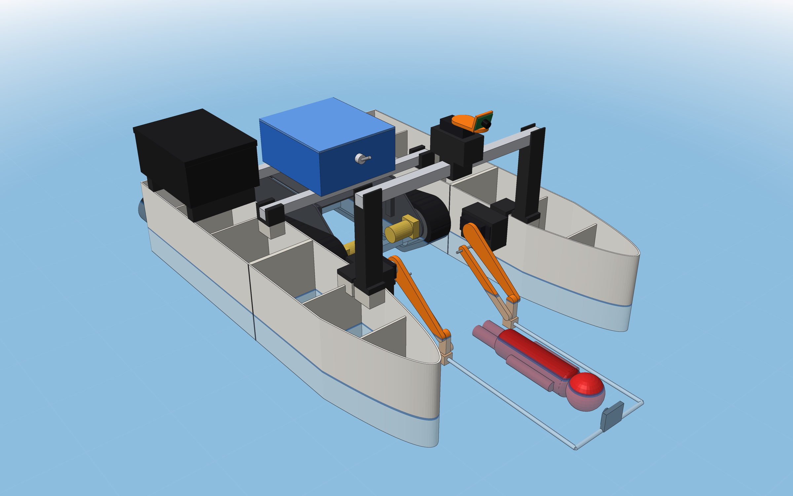
cad/3d/AR-Mini_3D_hero.png
