TKyoseva/ARmini/cad/3d/C072_logic_tray_fit_preview.png

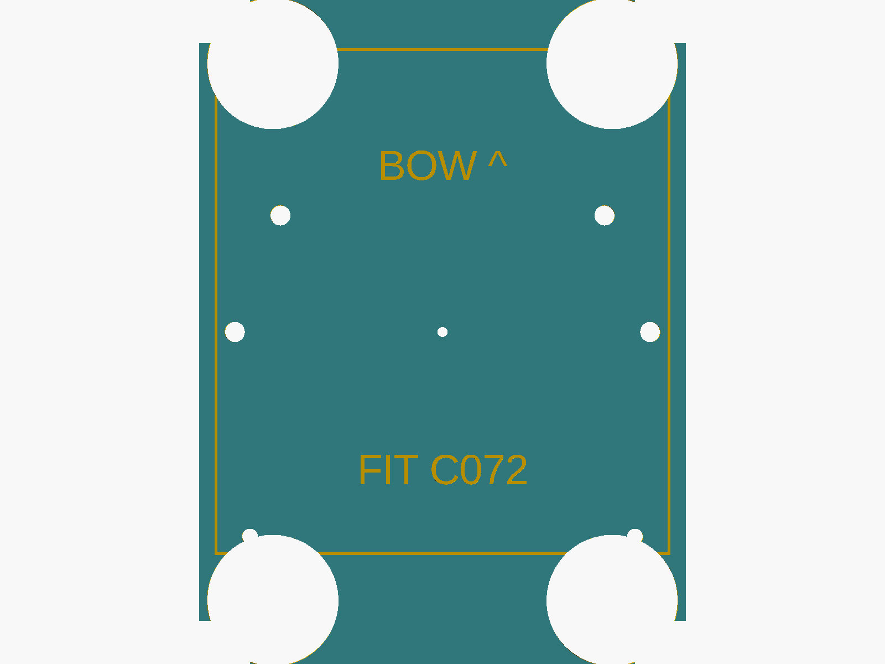
cad/3d/C072_logic_tray_fit_preview.png
