TKyoseva/ARmini/cad/pesho/pesho_float.png

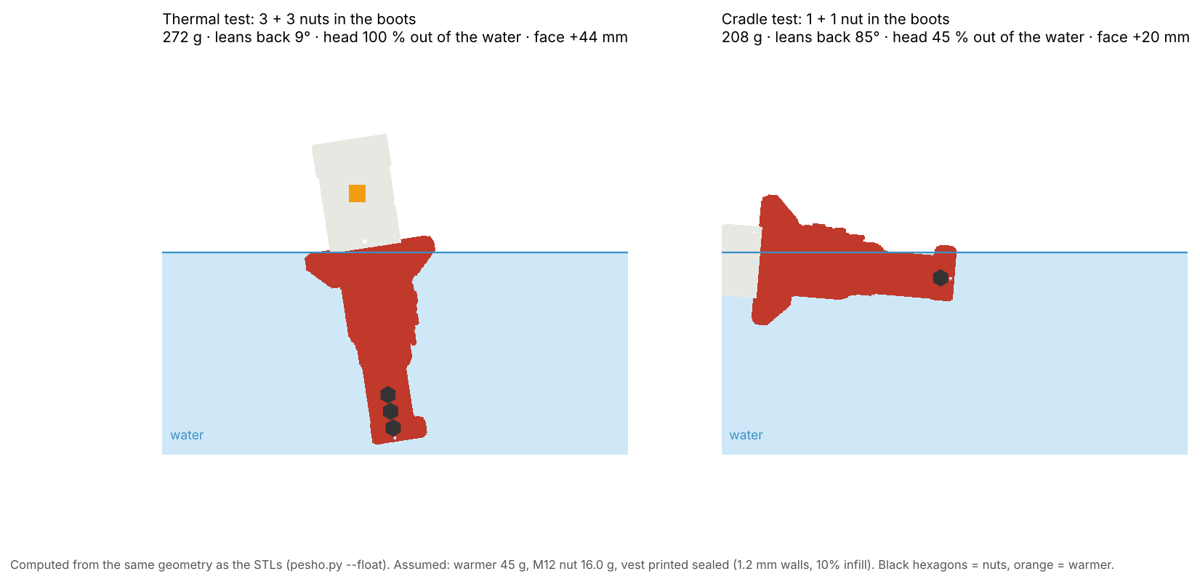
cad/pesho/pesho_float.png
