TKyoseva/ARmini/cad/pesho/pesho_views.png

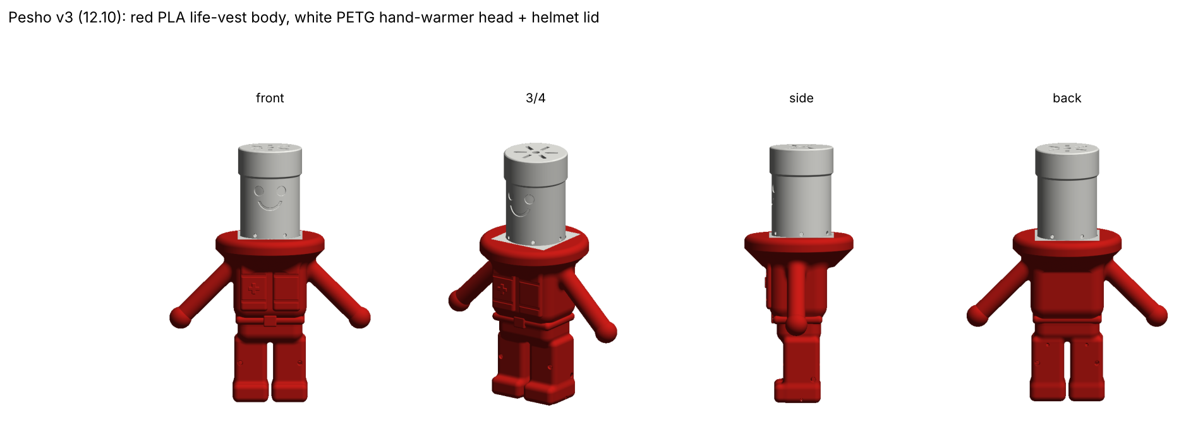
cad/pesho/pesho_views.png
