TKyoseva/ARmini/docs/diagrams/AR-Mini_5d_vbat_fuseblock_1031.png

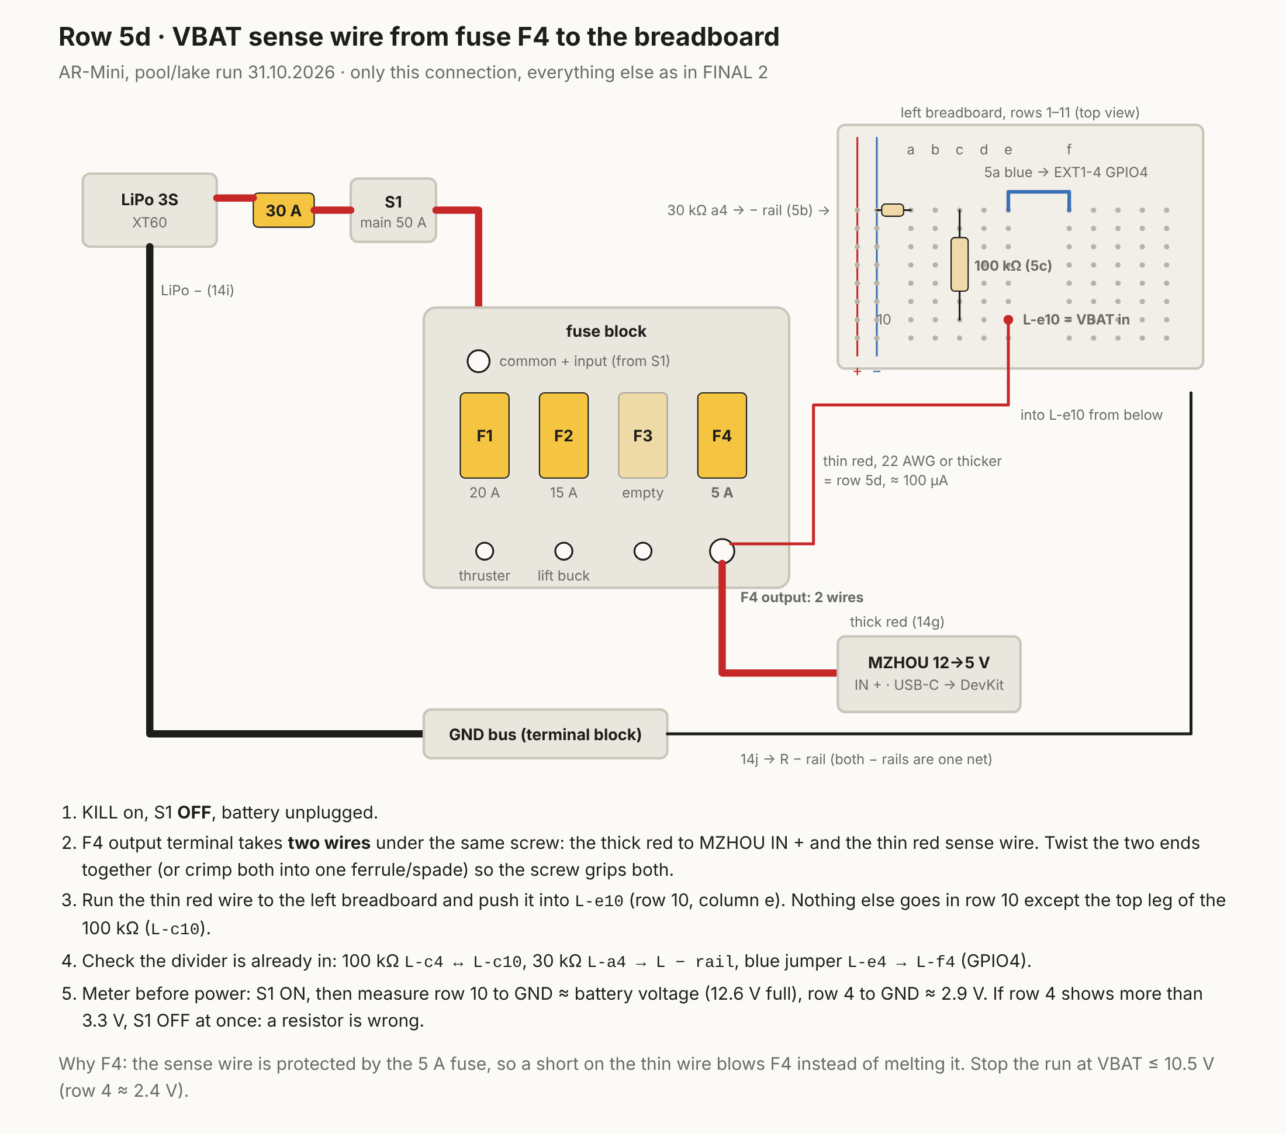
docs/diagrams/AR-Mini_5d_vbat_fuseblock_1031.png
