TKyoseva/ARmini/docs/diagrams/AR-Mini_9a_5v_bus_1031.png

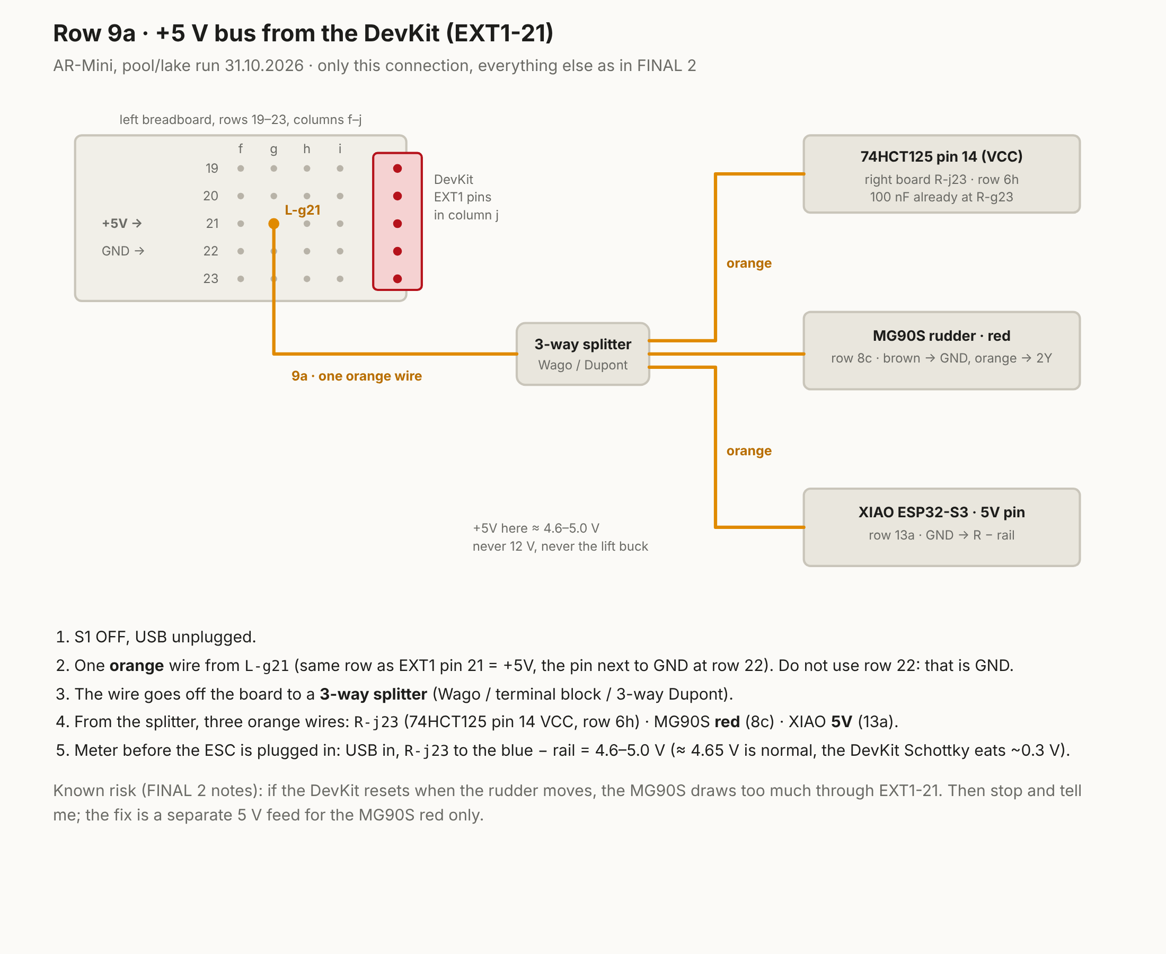
docs/diagrams/AR-Mini_9a_5v_bus_1031.png
