TKyoseva/ARmini/docs/diagrams/AR-Mini_10_i2c0_1031.png

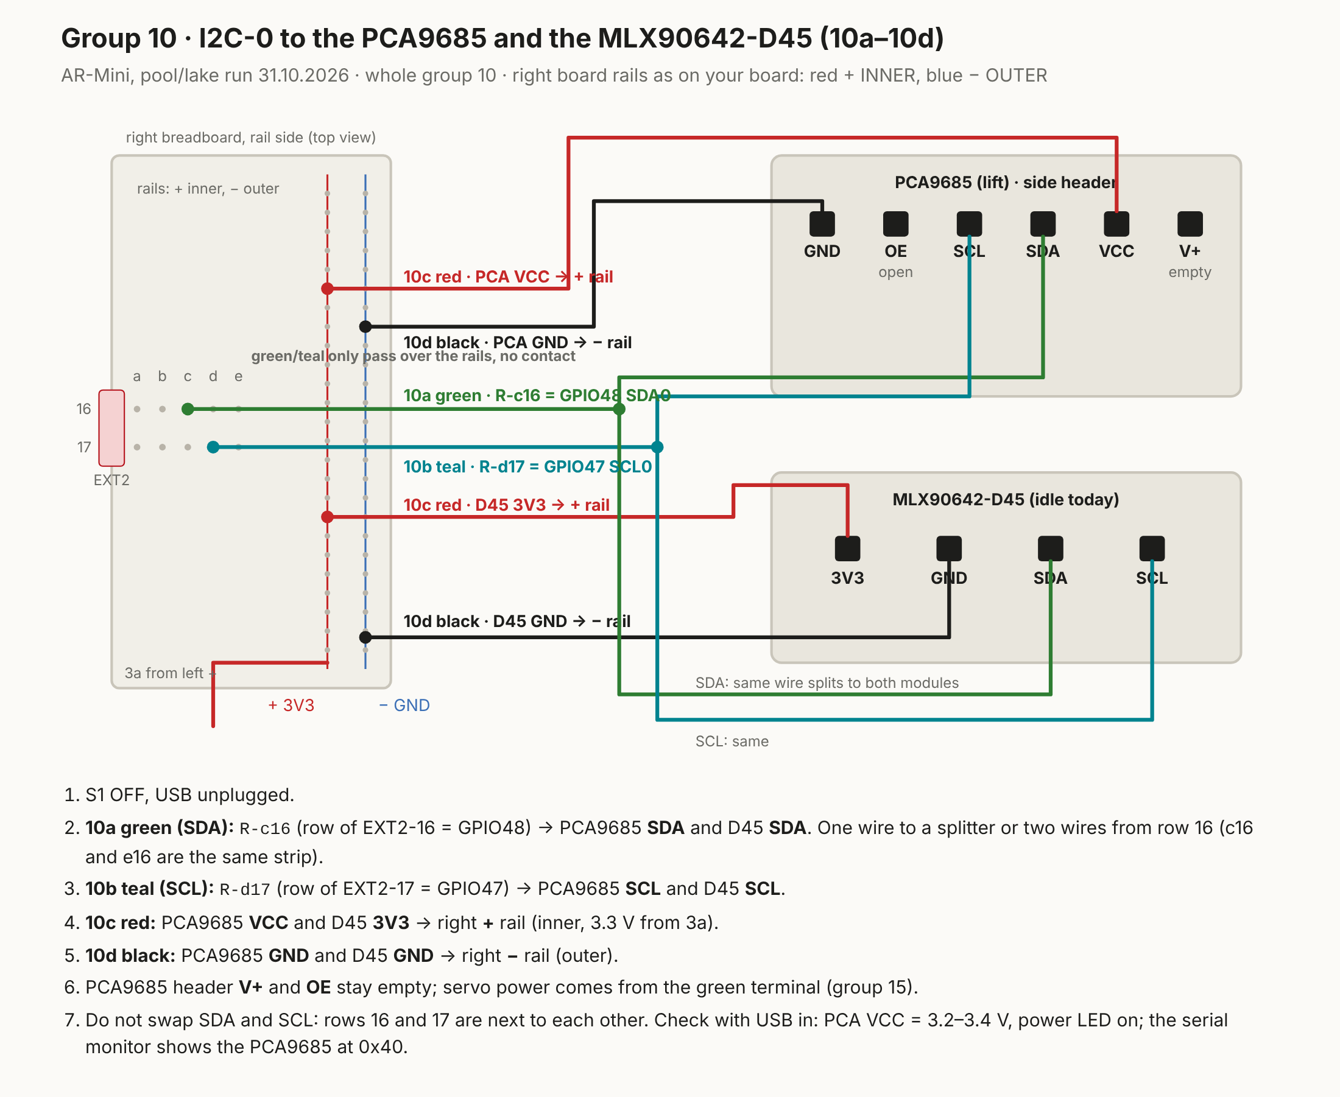
docs/diagrams/AR-Mini_10_i2c0_1031.png
