TKyoseva/ARmini/docs/diagrams/AR-Mini_10cd_logic_power_1031.png

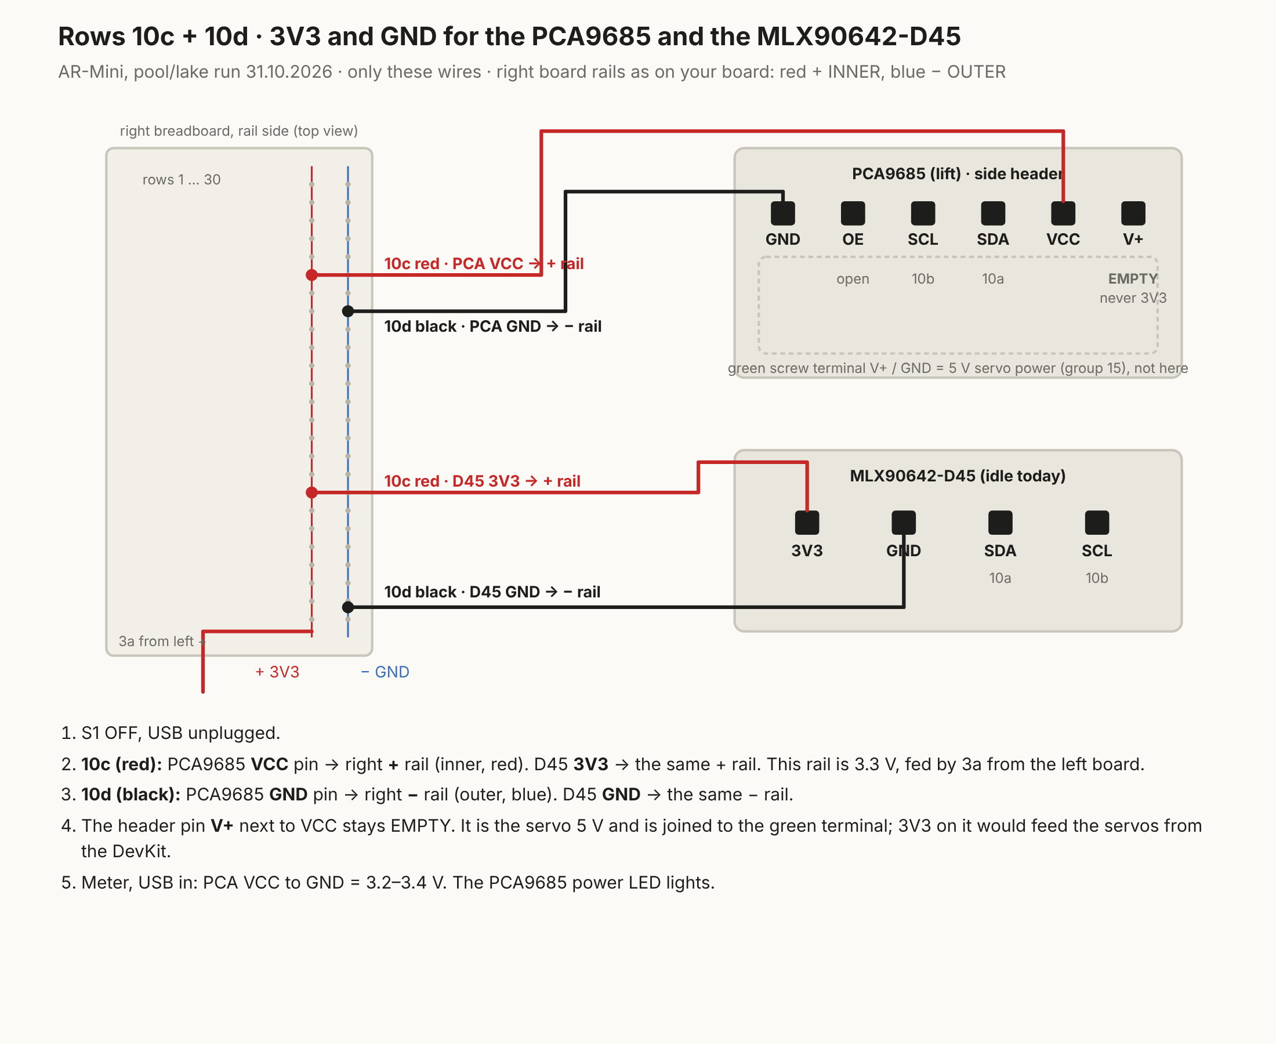
docs/diagrams/AR-Mini_10cd_logic_power_1031.png
