TKyoseva/ARmini/docs/diagrams/AR-Mini_12d_leak_probe_1031.png

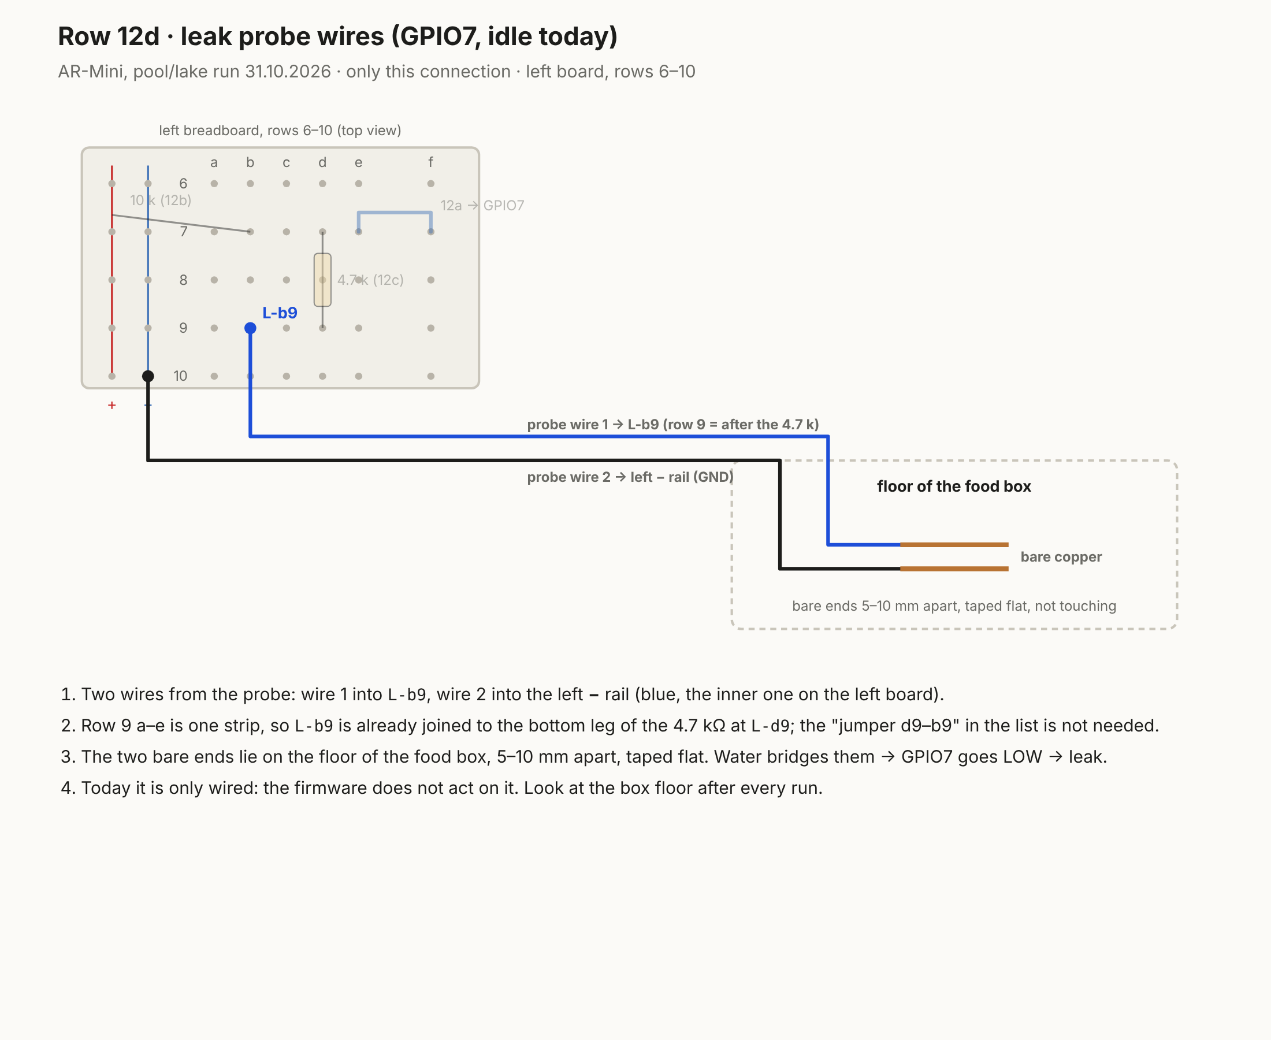
docs/diagrams/AR-Mini_12d_leak_probe_1031.png
