TKyoseva/ARmini/docs/diagrams/AR-Mini_14_battery_chain_1031.png

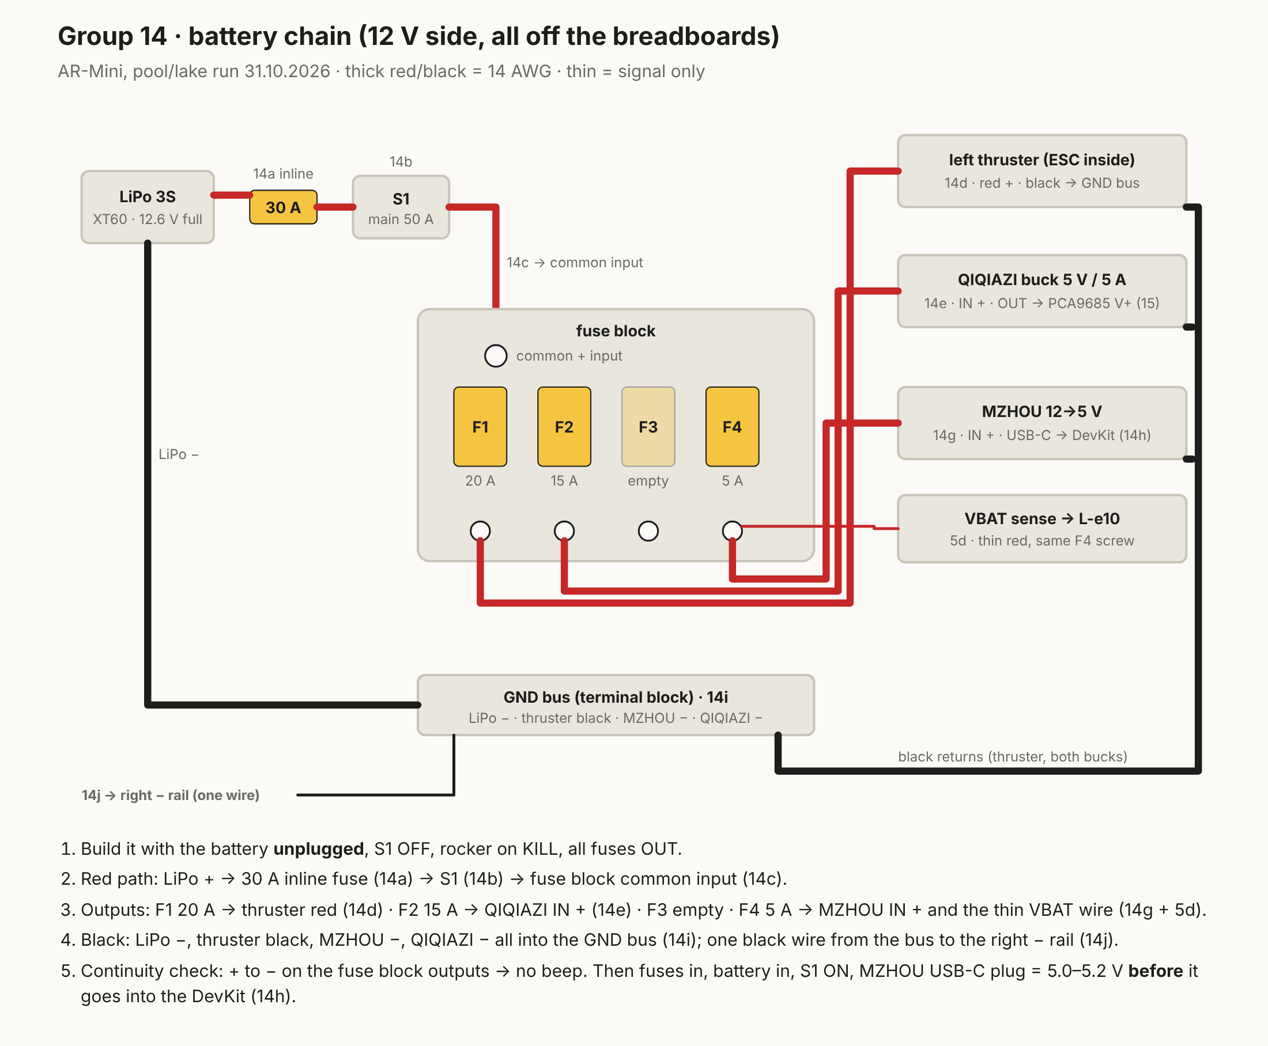
docs/diagrams/AR-Mini_14_battery_chain_1031.png
