TKyoseva/ARmini/docs/diagrams/AR-Mini_15_cradle_lift_1031.png

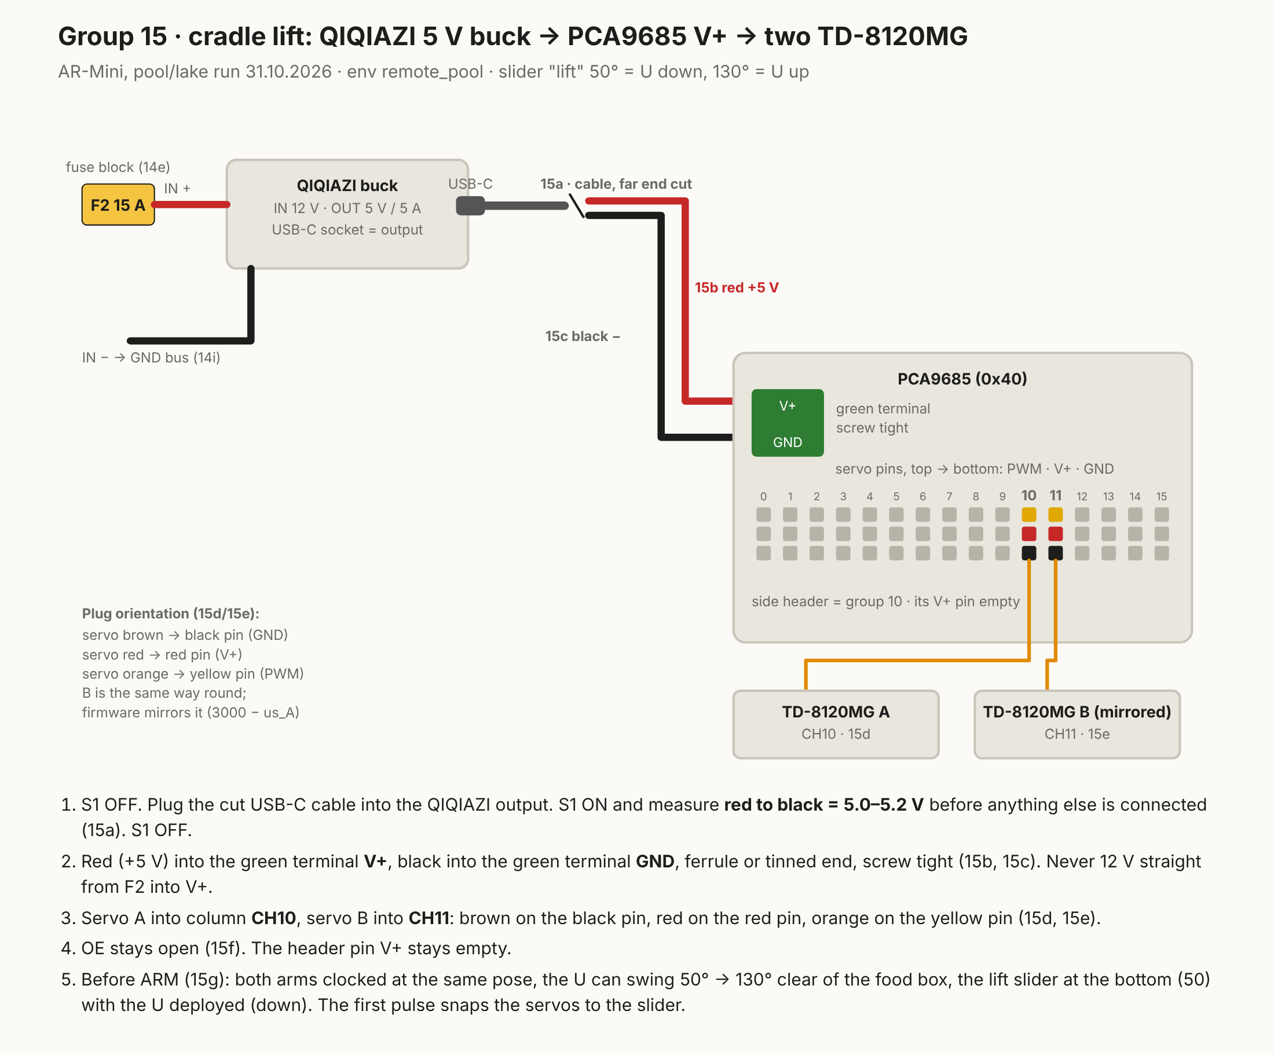
docs/diagrams/AR-Mini_15_cradle_lift_1031.png
