TKyoseva/ARmini/docs/diagrams/AR-Mini_architecture_v2.png

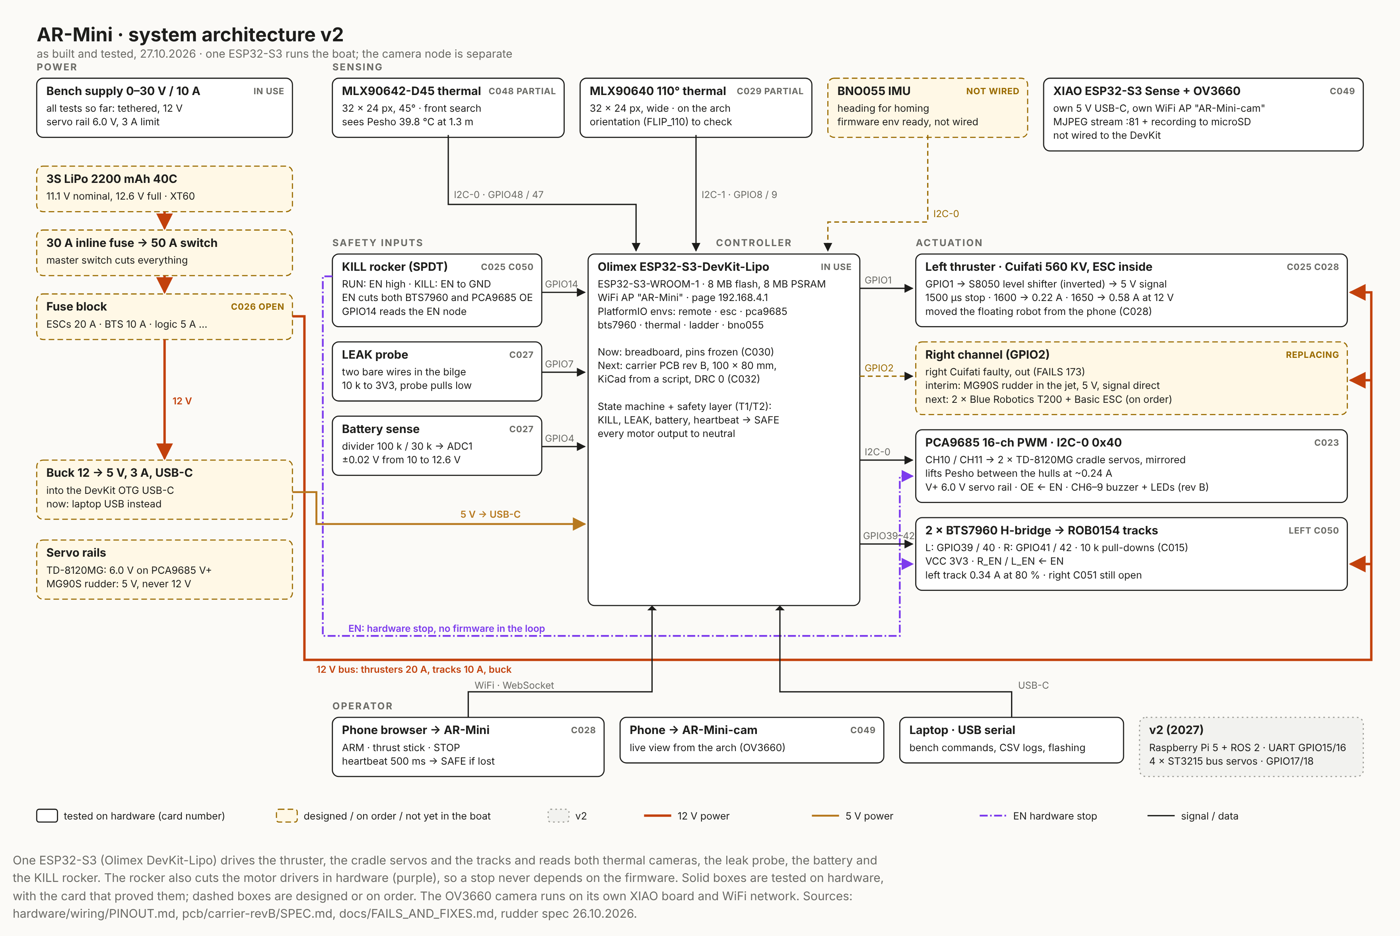
docs/diagrams/AR-Mini_architecture_v2.png
