TKyoseva/ARmini/docs/diagrams/AR-Mini_architecture_v2_pictorial.png

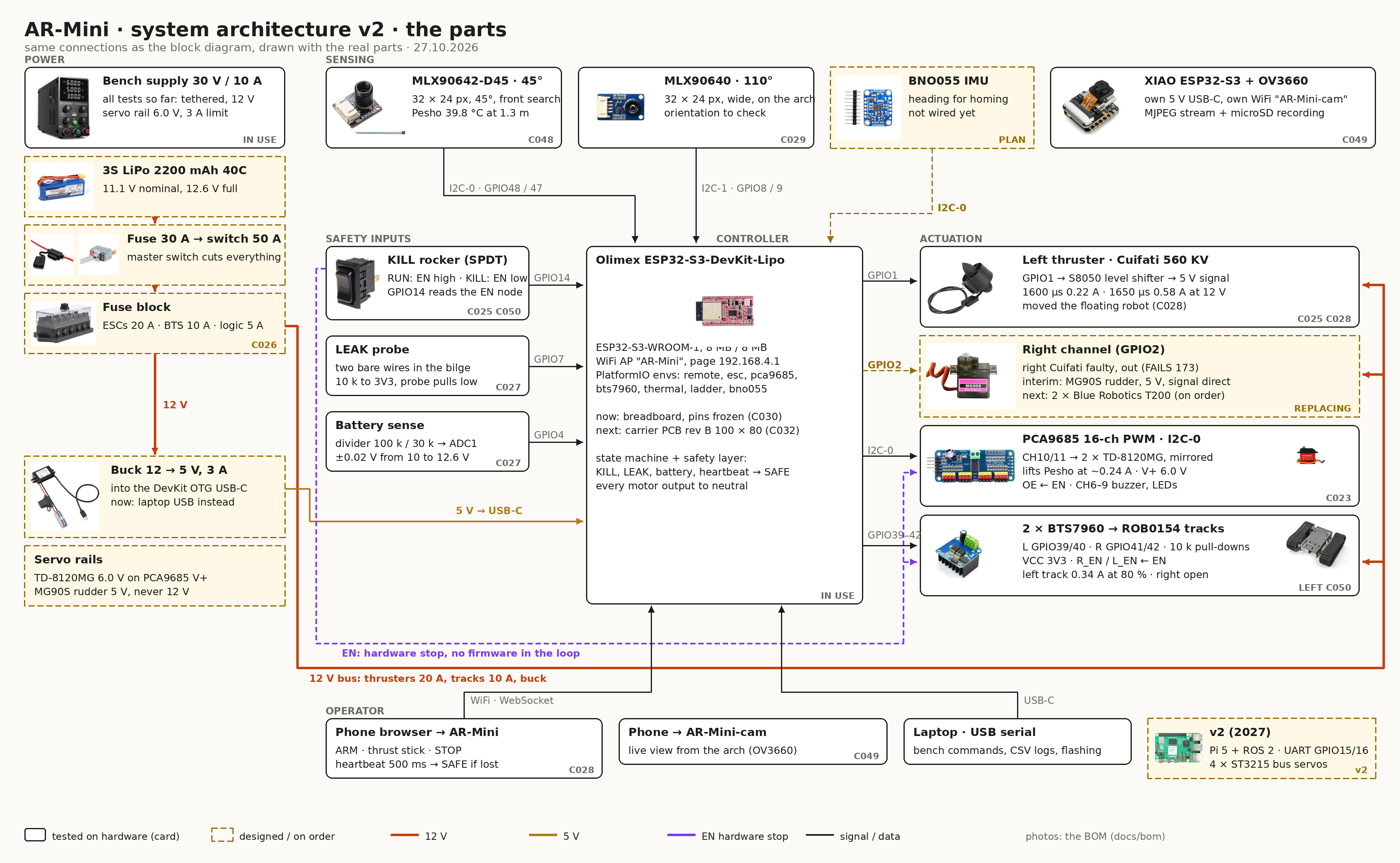
docs/diagrams/AR-Mini_architecture_v2_pictorial.png
