TKyoseva/ARmini/docs/diagrams/AR-Mini_breadboard_v2_as-wired.png

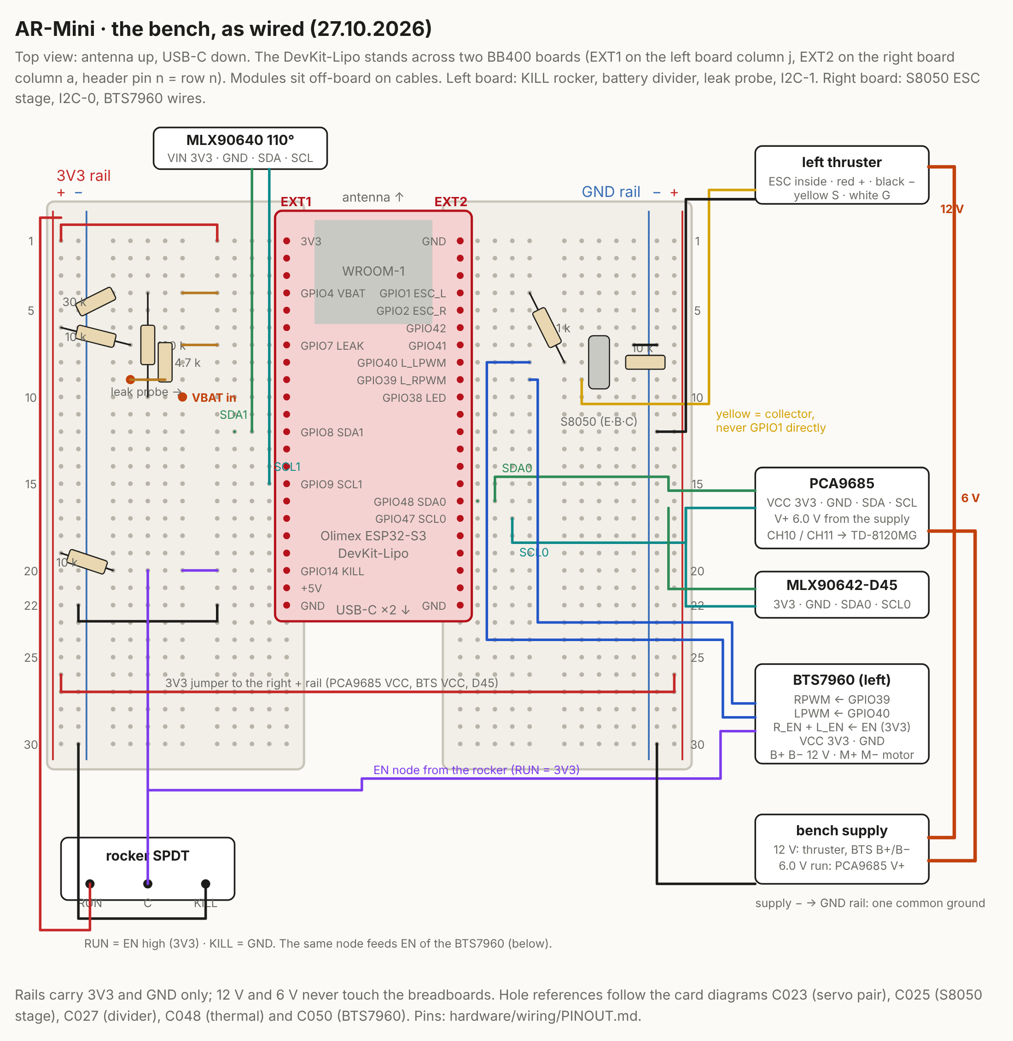
docs/diagrams/AR-Mini_breadboard_v2_as-wired.png
