TKyoseva/ARmini/docs/diagrams/AR-Mini_FINAL2_breadboard_pool_1031.png

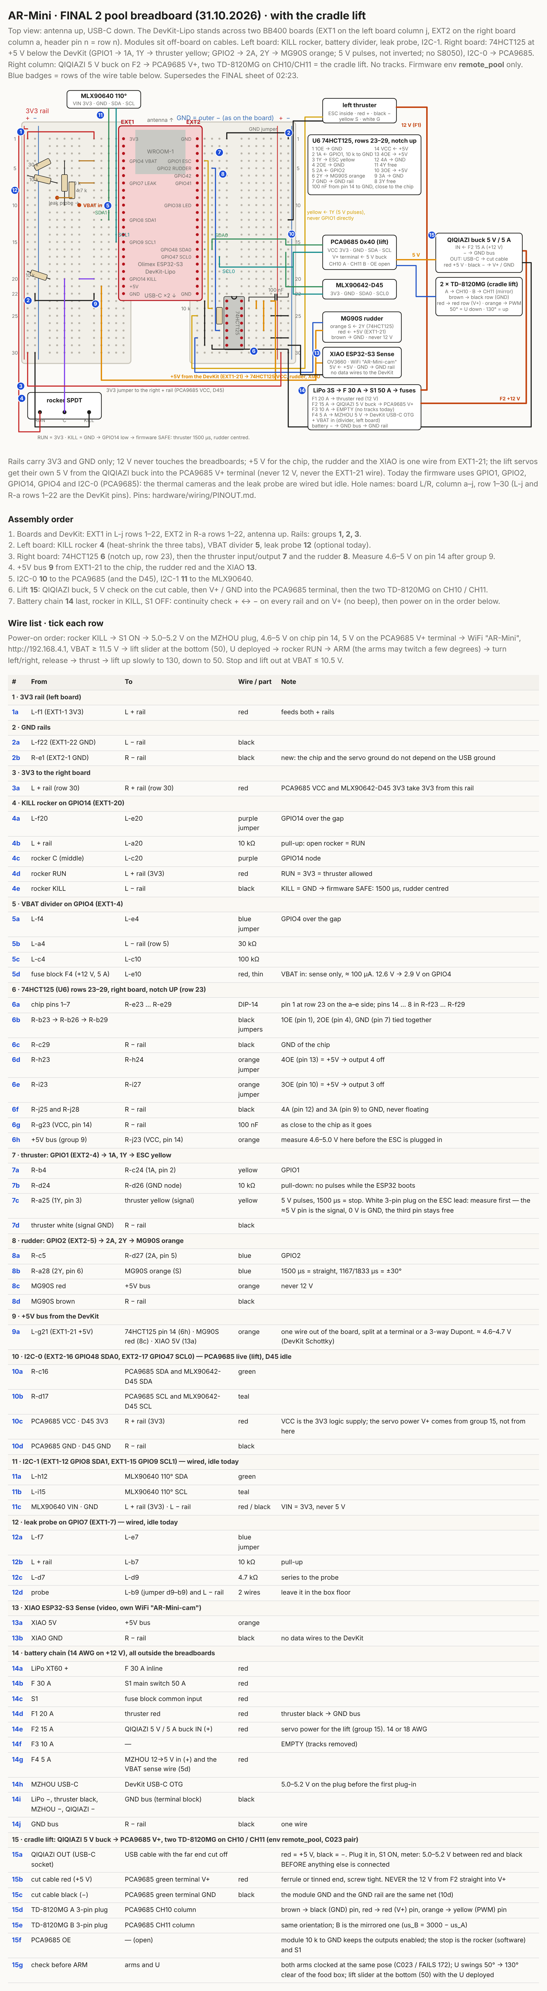
docs/diagrams/AR-Mini_FINAL2_breadboard_pool_1031.png
