TKyoseva/ARmini/docs/diagrams/AR-Mini_FINAL2_schematic_pool_1031.png

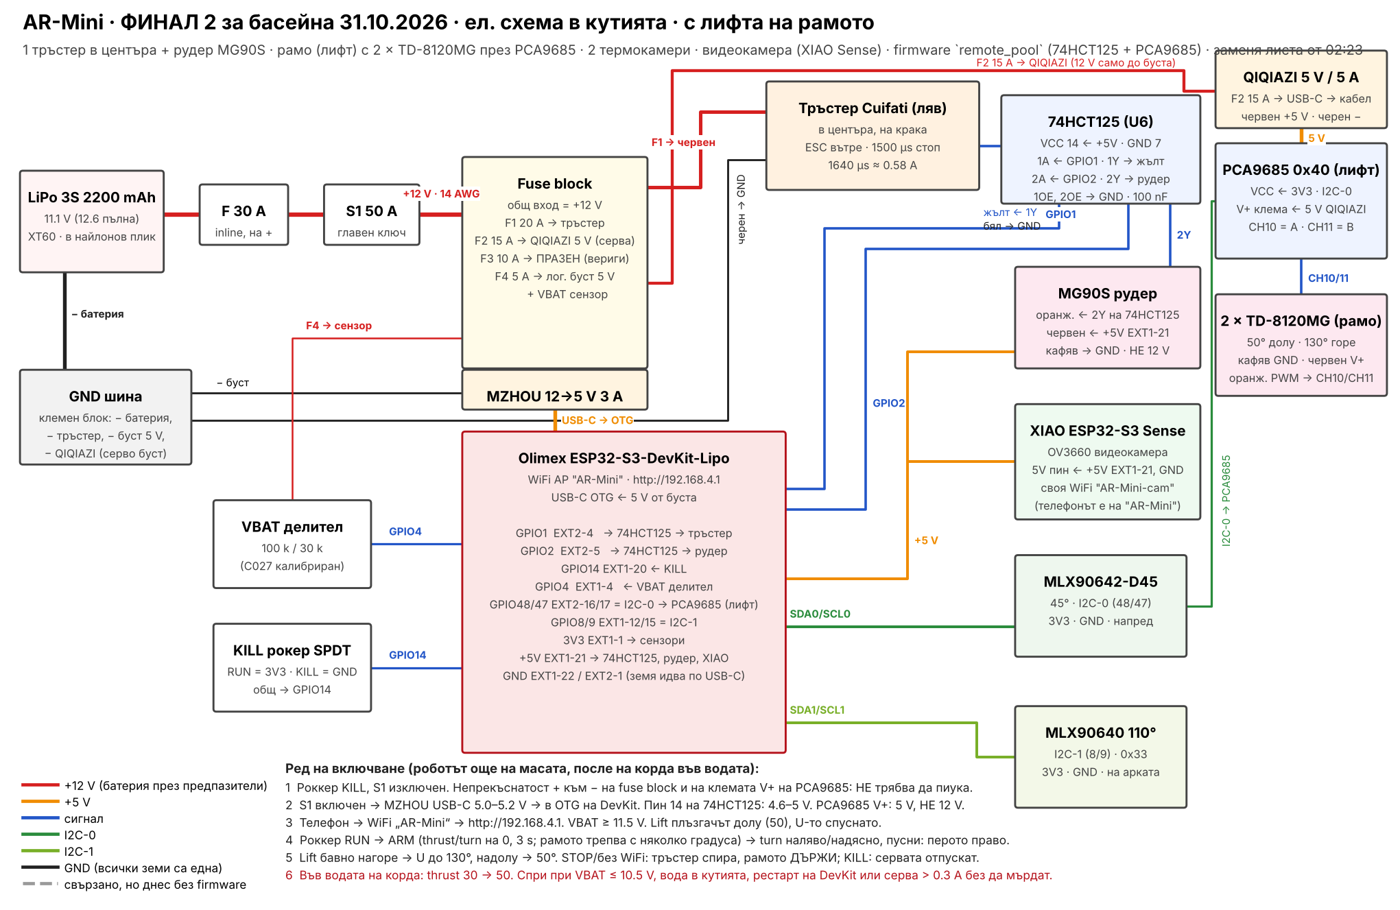
docs/diagrams/AR-Mini_FINAL2_schematic_pool_1031.png
