TKyoseva/ARmini/docs/diagrams/AR-Mini_hardware_diagram.png

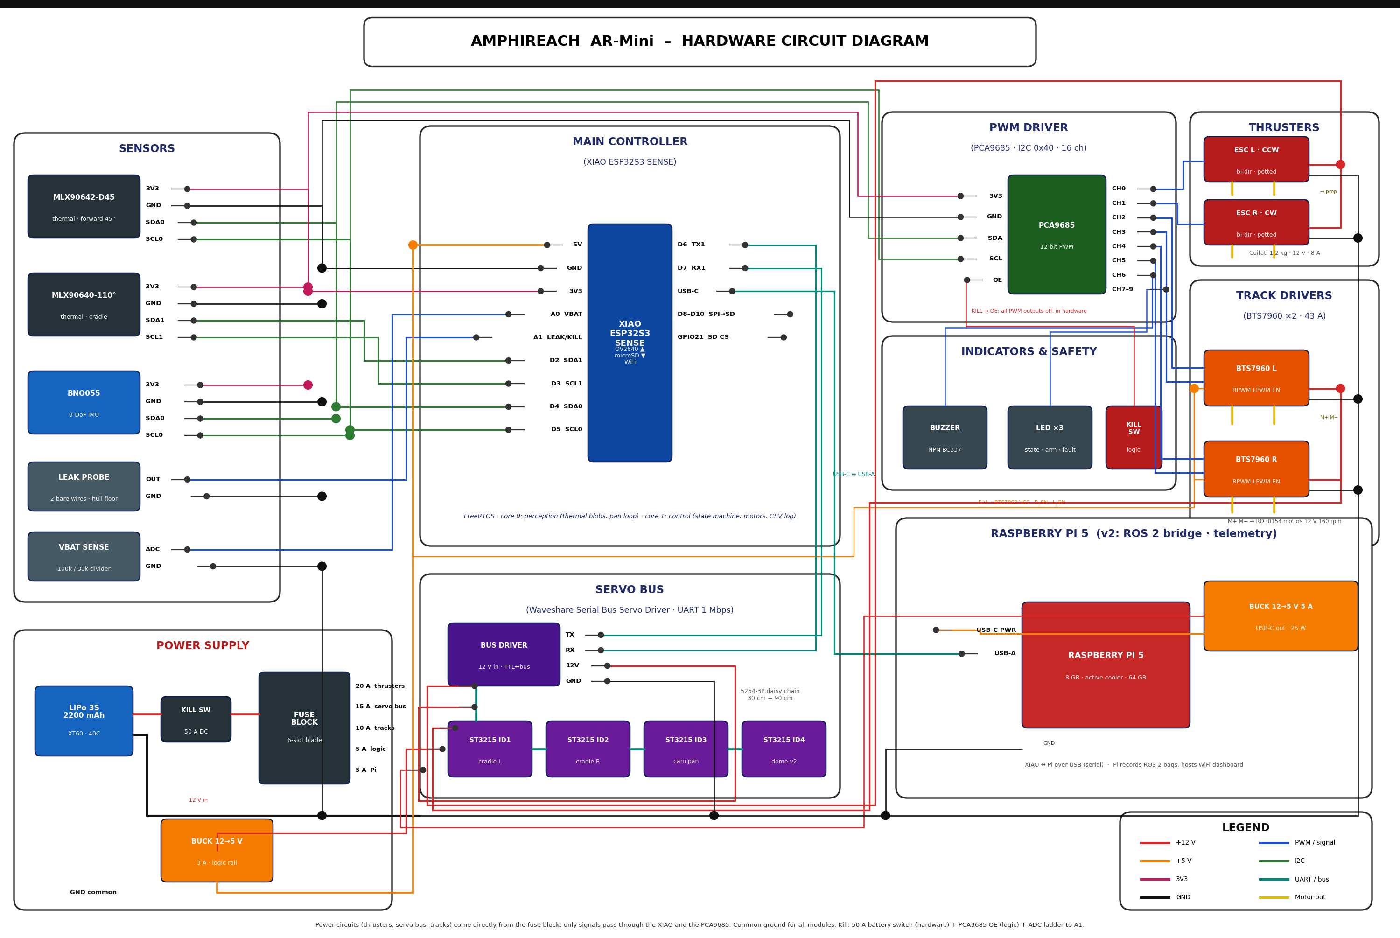
docs/diagrams/AR-Mini_hardware_diagram.png
