TKyoseva/ARmini/docs/diagrams/AR-Mini_pivot_bracket_mount.png

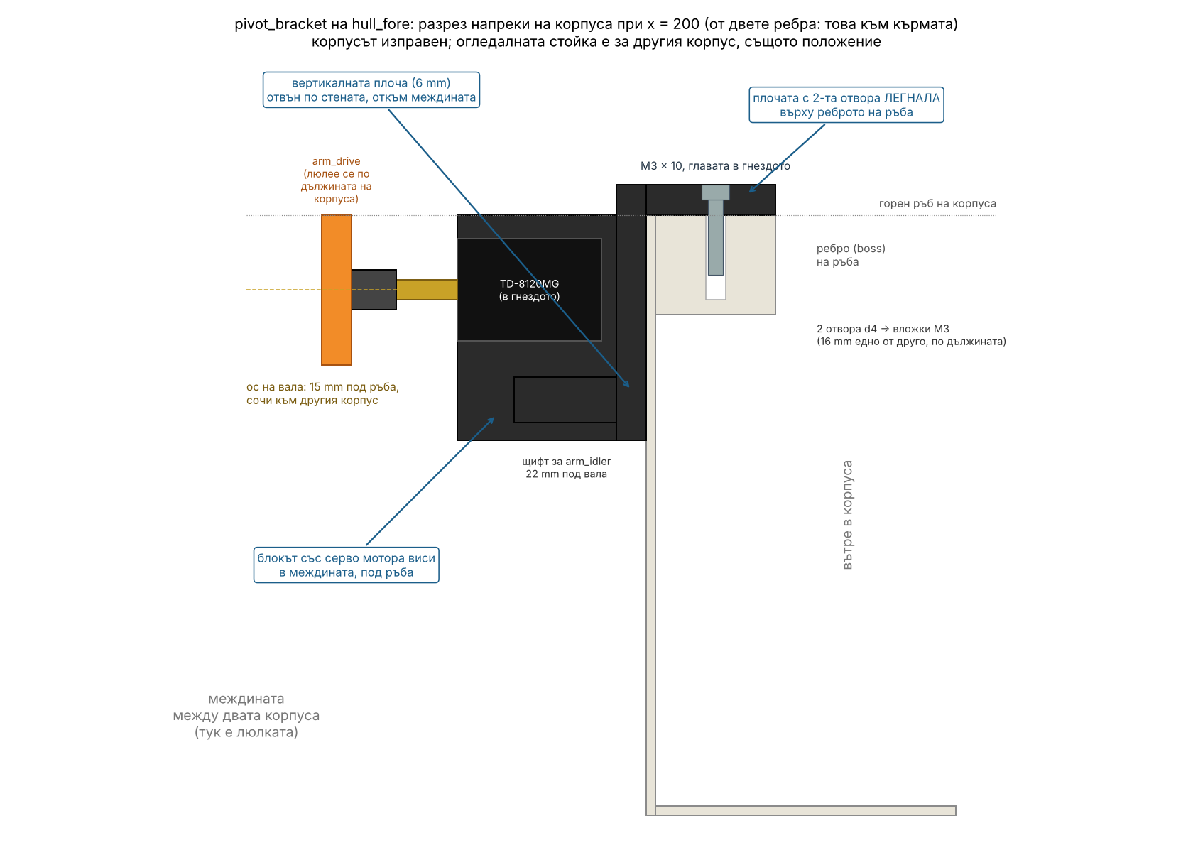
docs/diagrams/AR-Mini_pivot_bracket_mount.png
