TKyoseva/ARmini/docs/diagrams/AR-Mini_schematic_v1_as-built.png

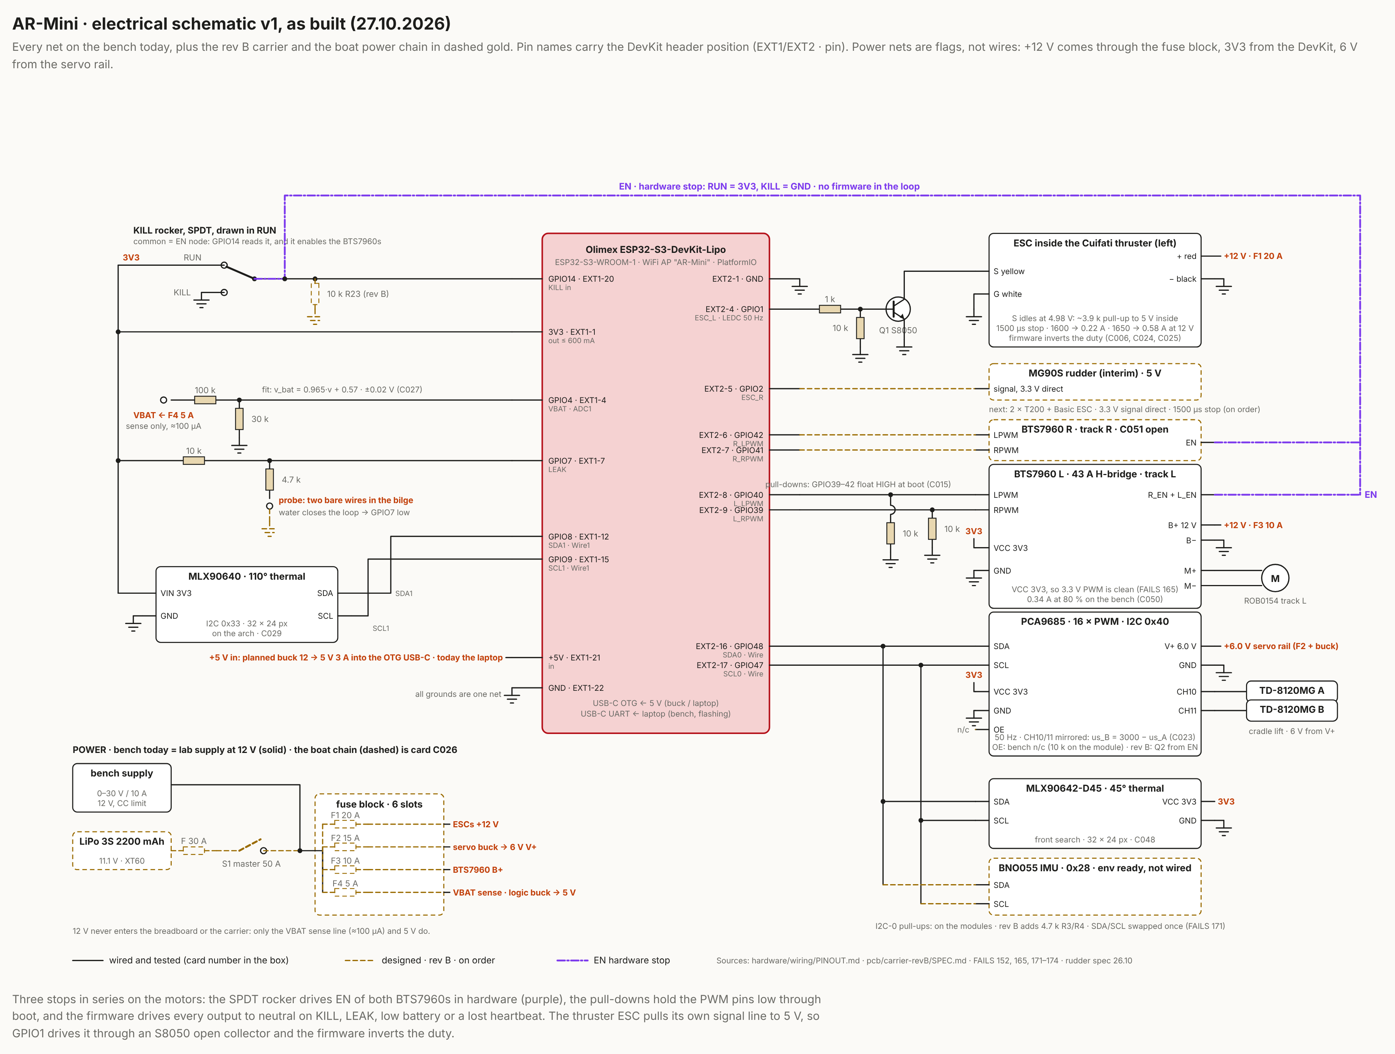
docs/diagrams/AR-Mini_schematic_v1_as-built.png
