TKyoseva/ARmini/docs/diagrams/AR-Mini_states_T2_safety.png

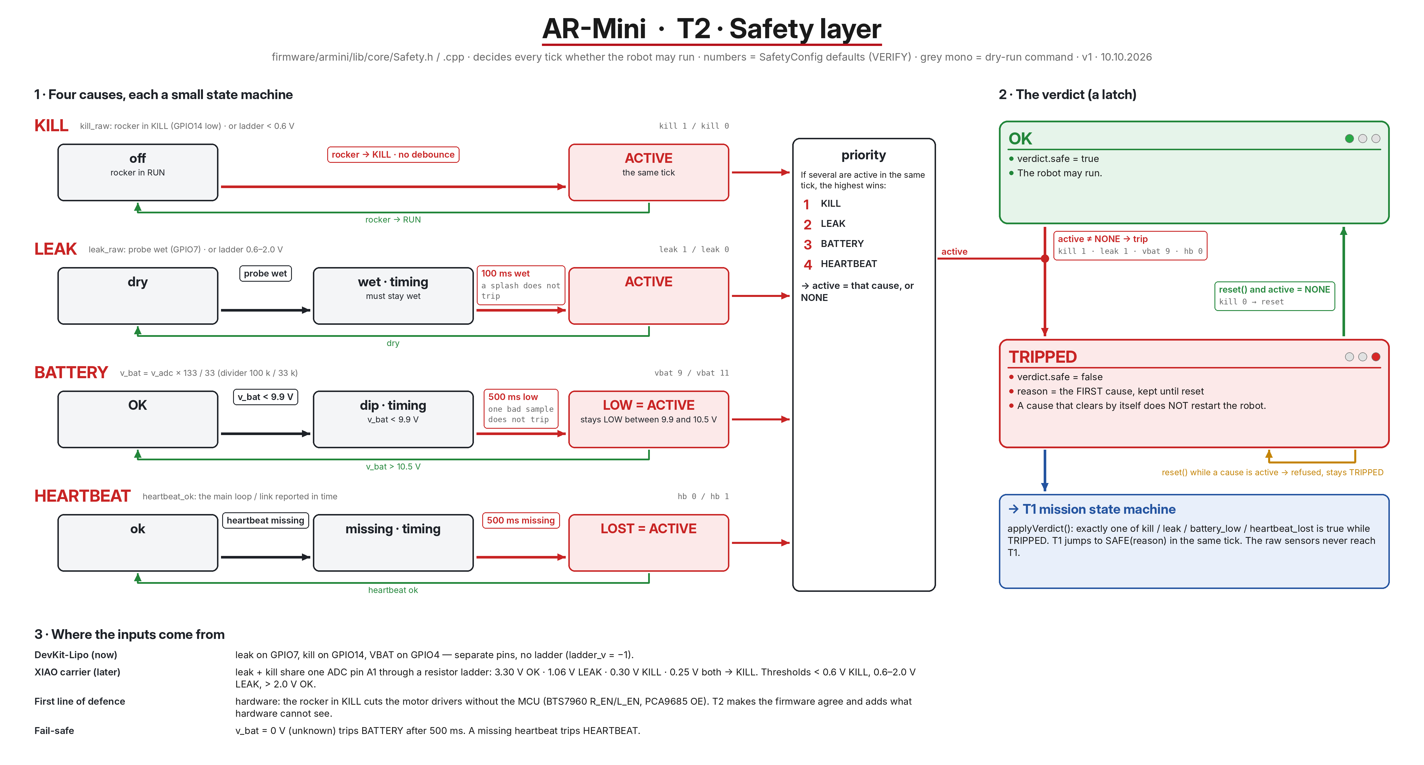
docs/diagrams/AR-Mini_states_T2_safety.png
