TKyoseva/ARmini/docs/diagrams/AR-Mini_thruster_kickup_mount.png

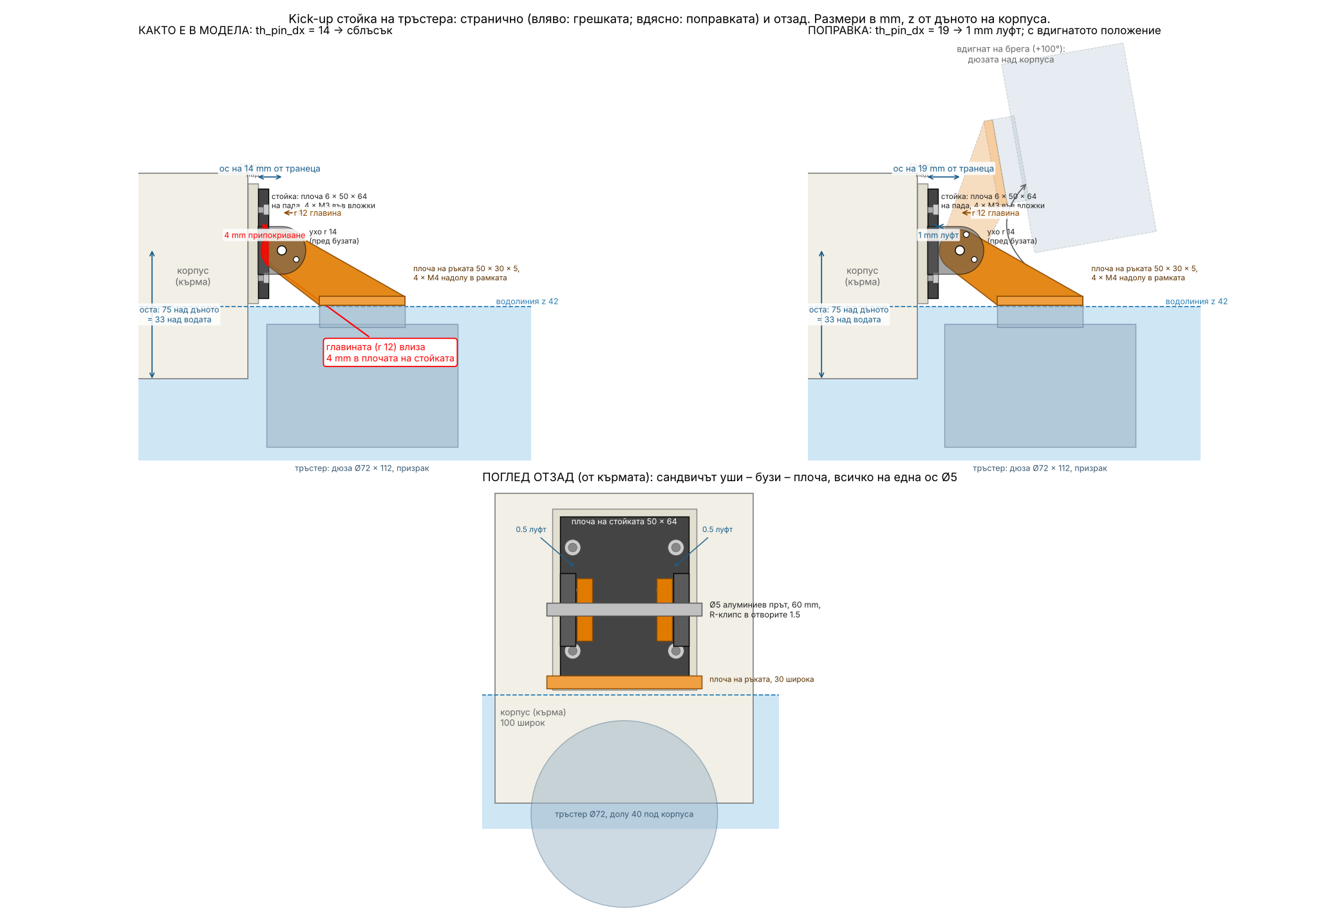
docs/diagrams/AR-Mini_thruster_kickup_mount.png
