TKyoseva/ARmini/docs/diagrams/C055_diagram_mega-thruster.png

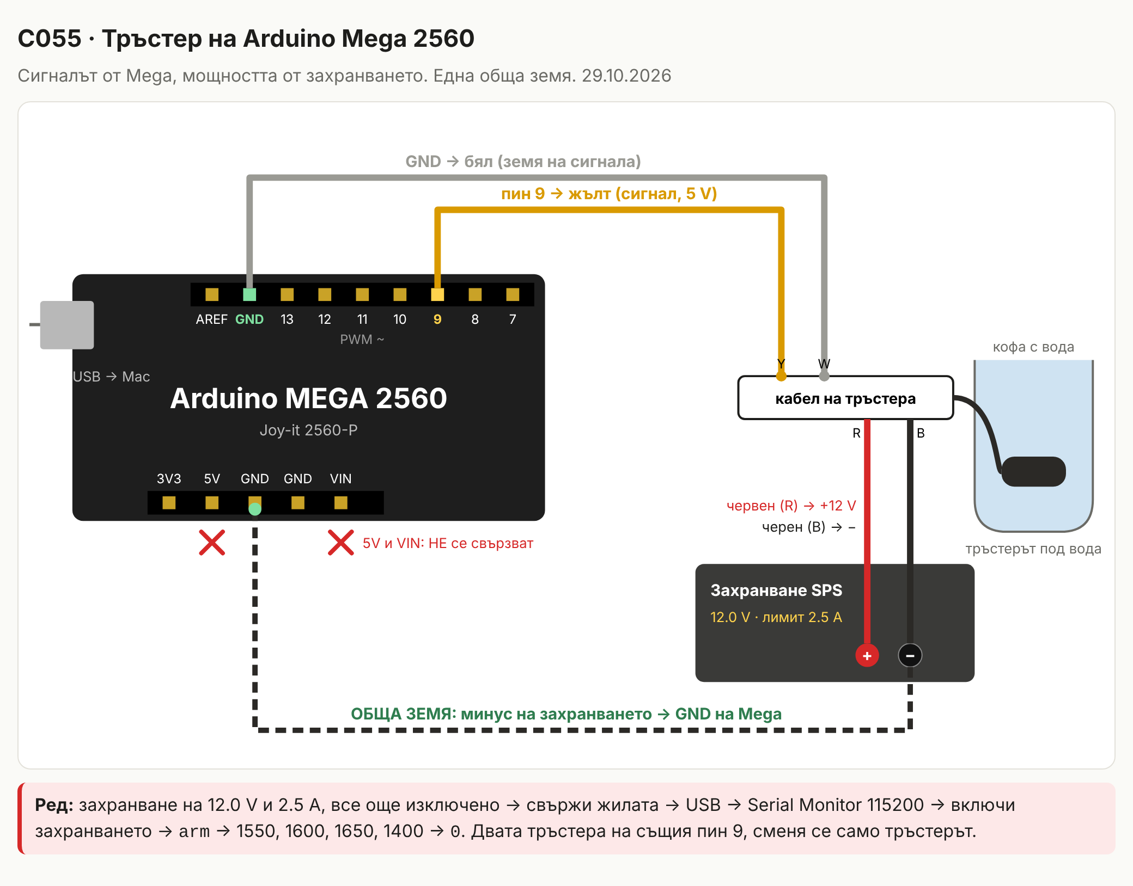
docs/diagrams/C055_diagram_mega-thruster.png
