TKyoseva/ARmini/docs/diagrams/C060_diagram_address-pads.png

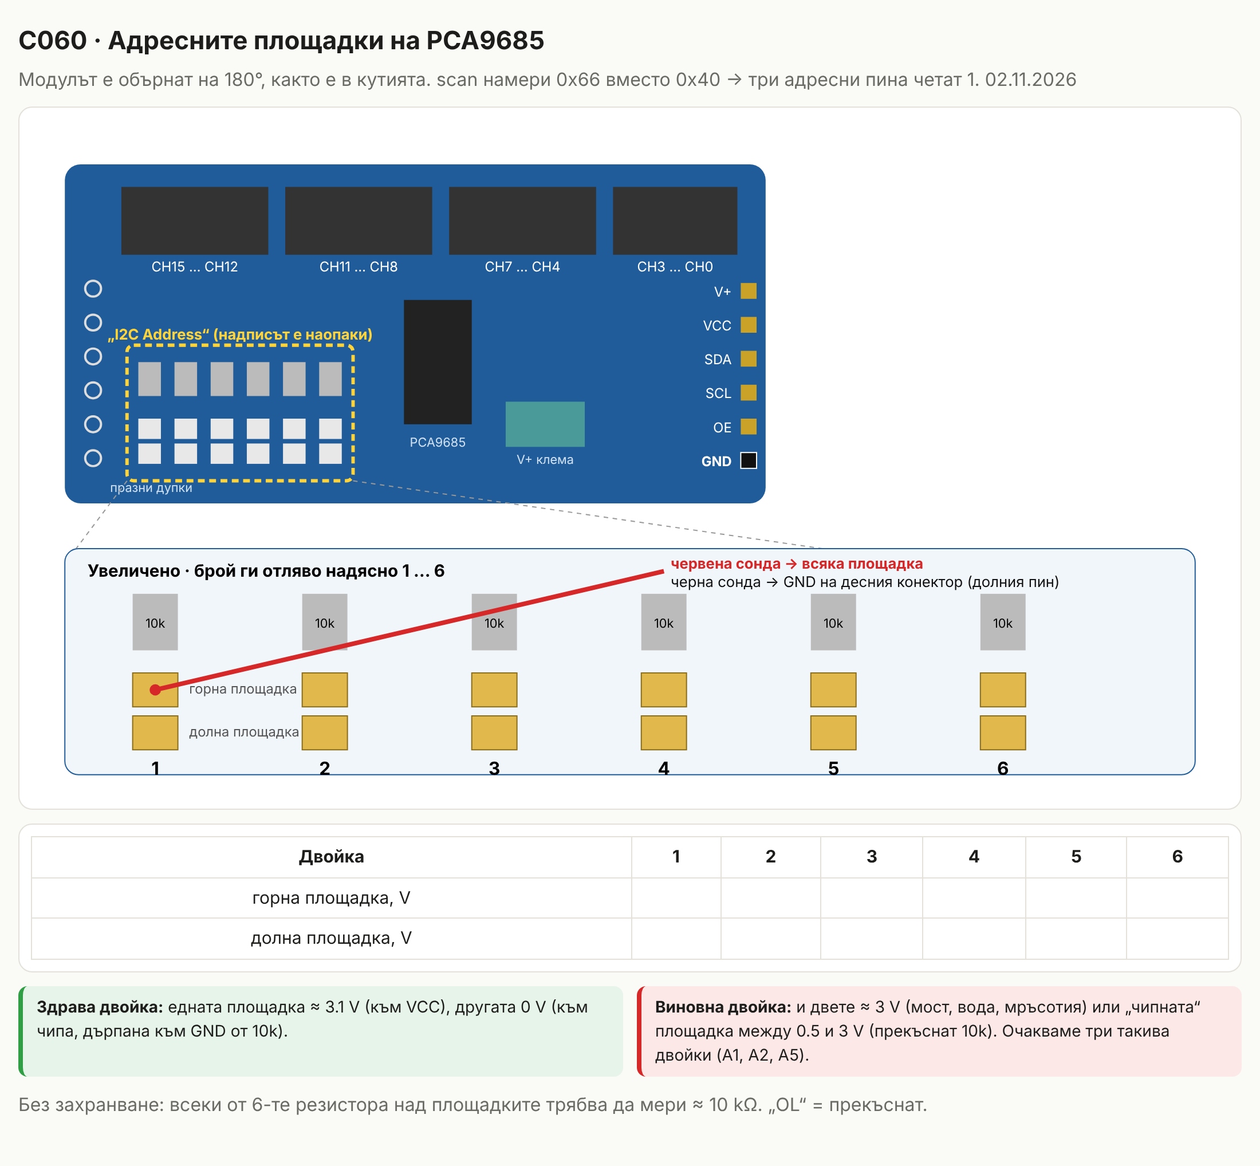
docs/diagrams/C060_diagram_address-pads.png
