TKyoseva/ARmini/docs/diagrams/C060_diagram_logic-analyser.png

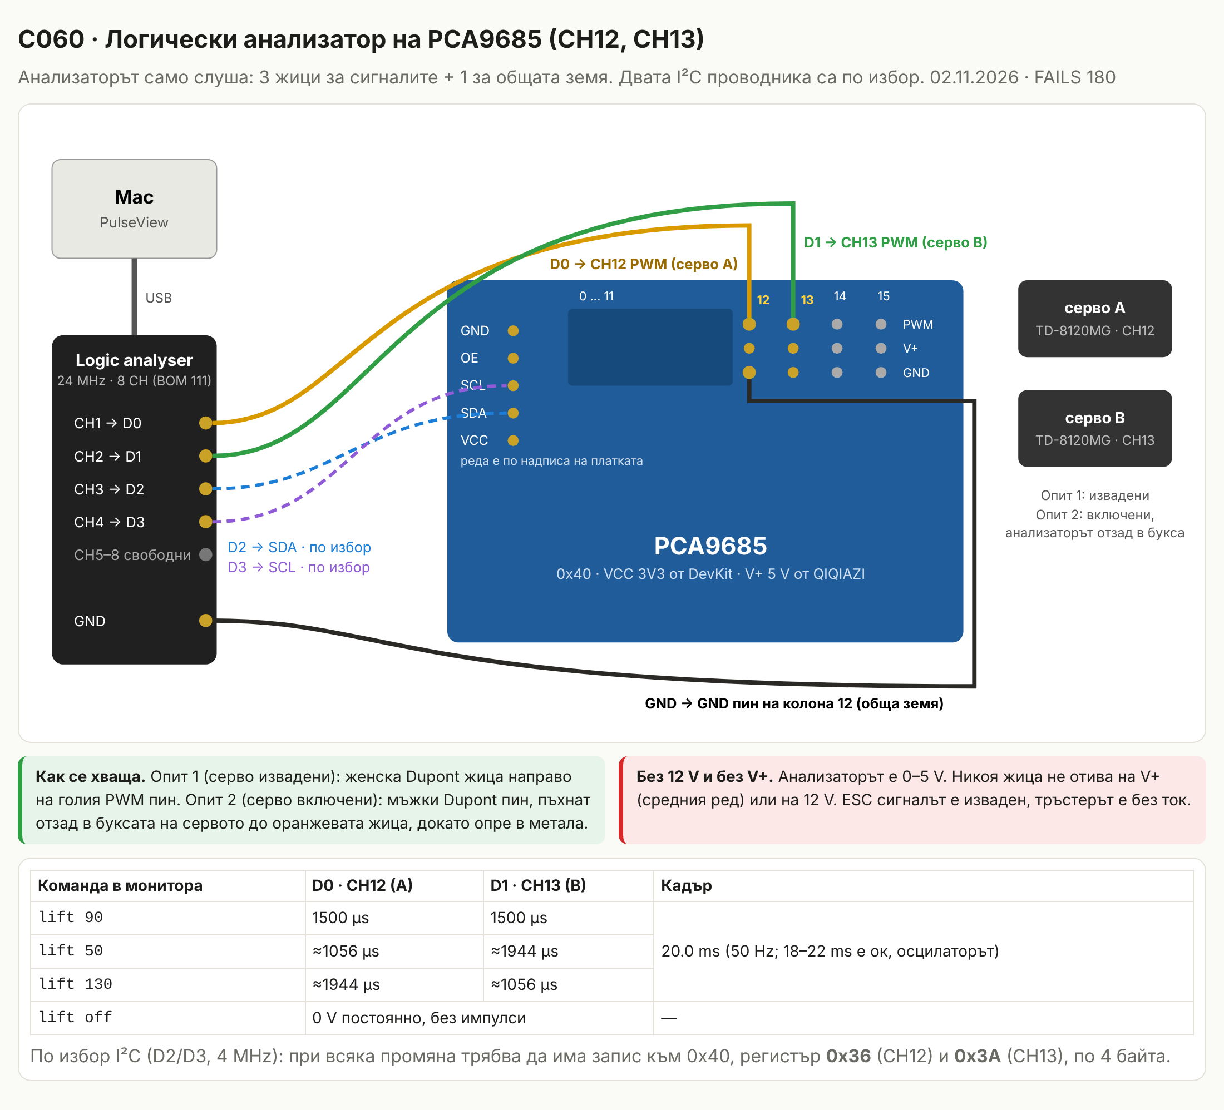
docs/diagrams/C060_diagram_logic-analyser.png
