TKyoseva/ARmini/docs/diagrams/C072_diagram_boxes.png

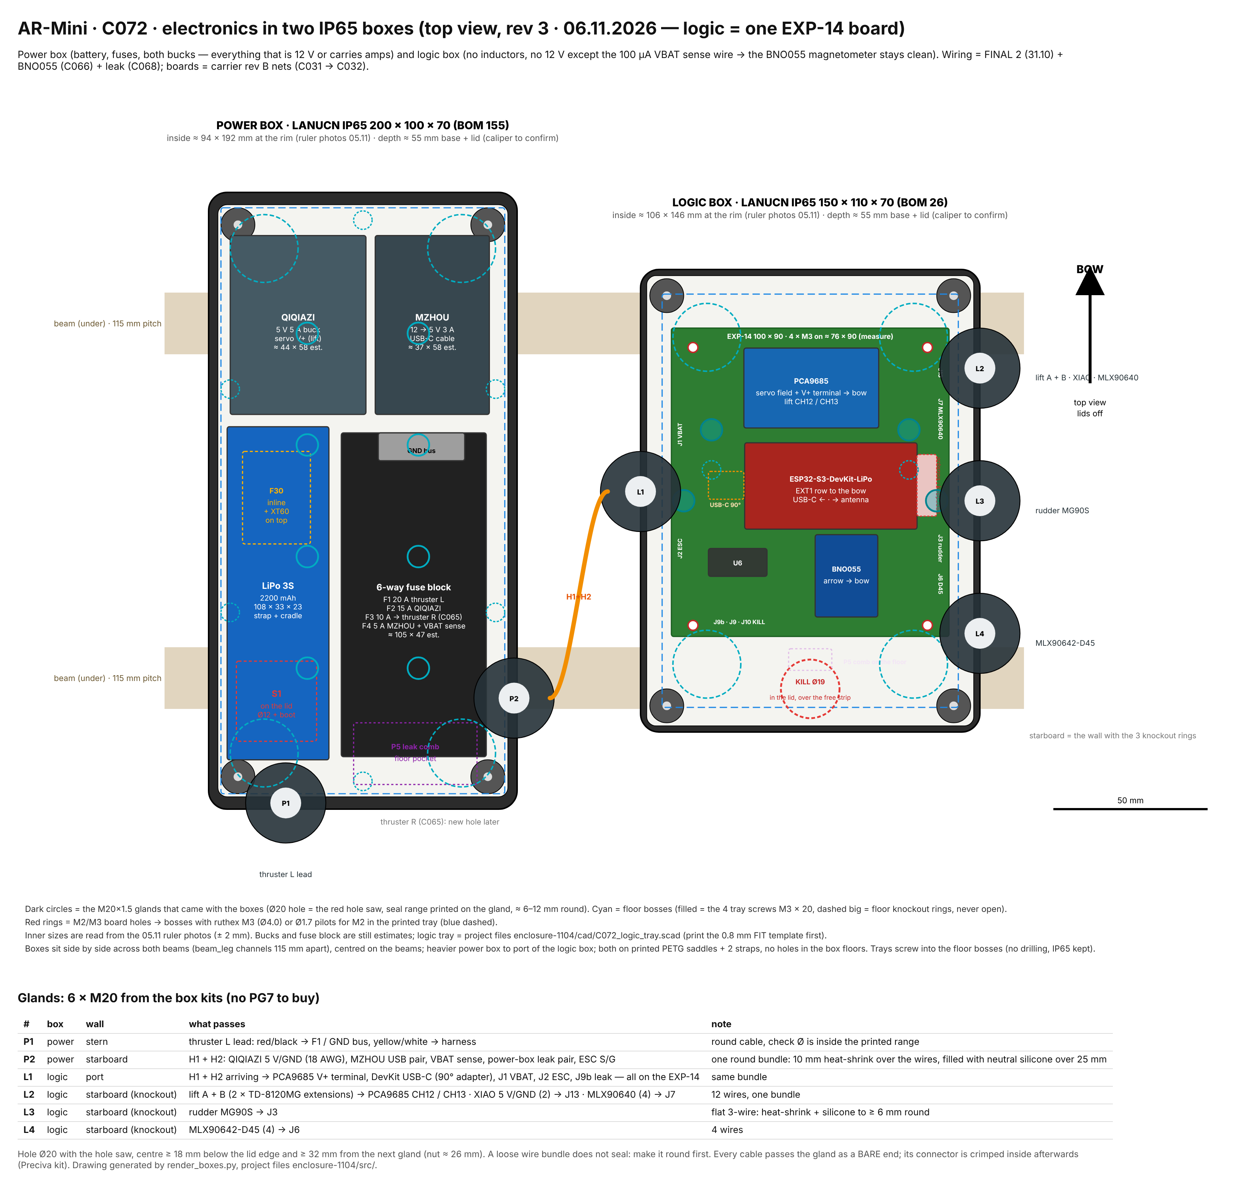
docs/diagrams/C072_diagram_boxes.png
