TKyoseva/ARmini/docs/diagrams/C072_diagram_carrier_exp14.png

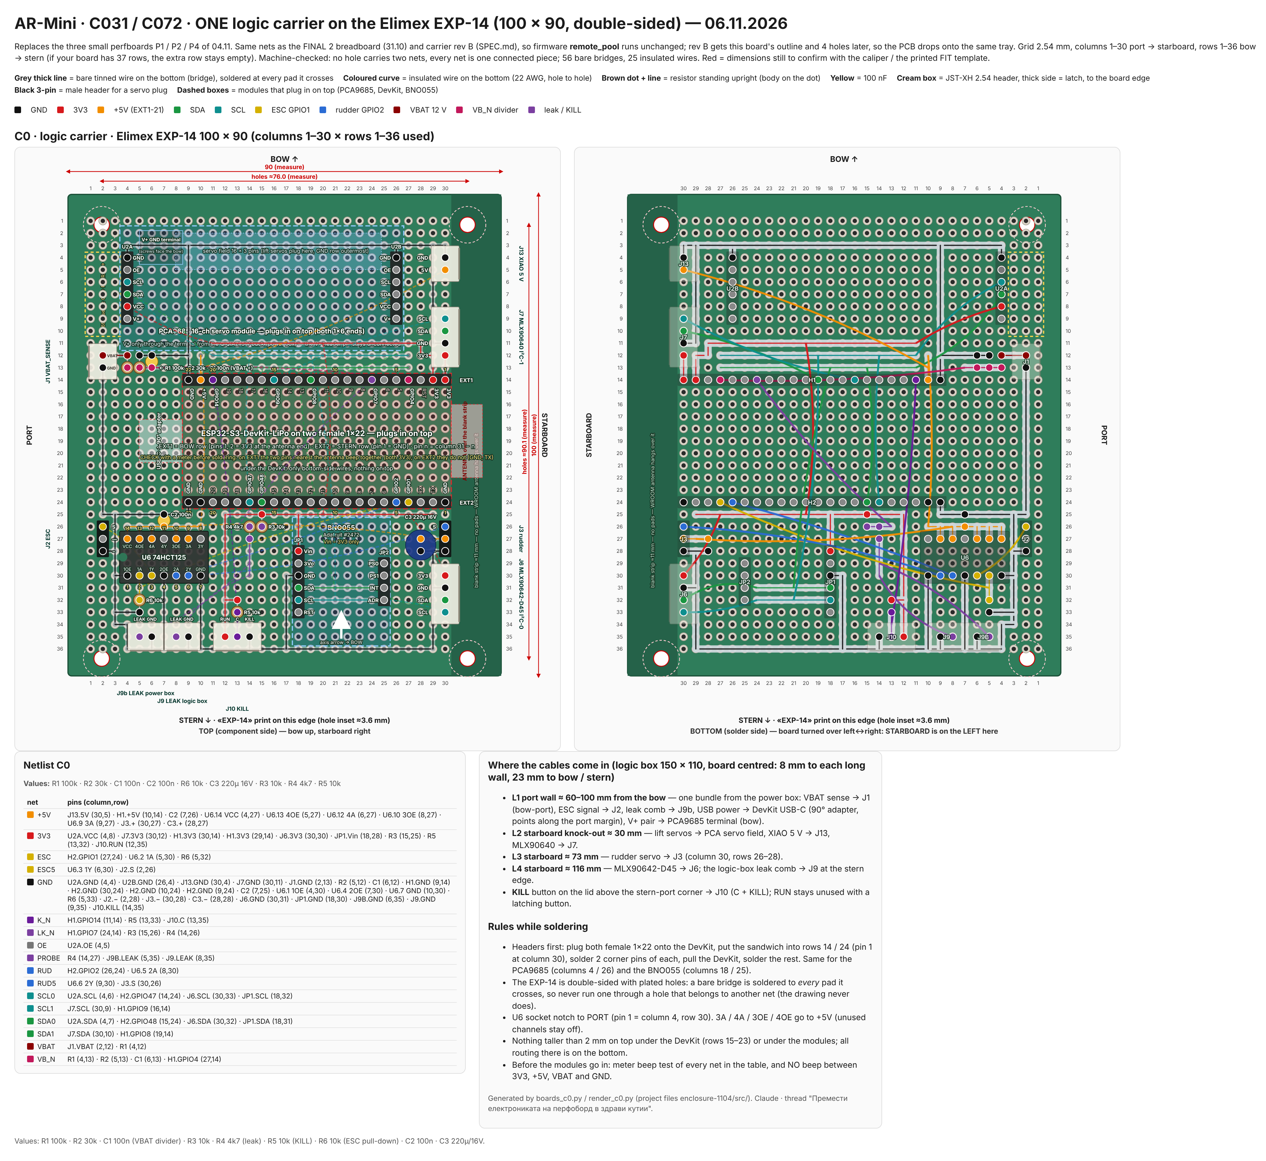
docs/diagrams/C072_diagram_carrier_exp14.png
