TKyoseva/ARmini/docs/diagrams/C072_diagram_perfboards.png

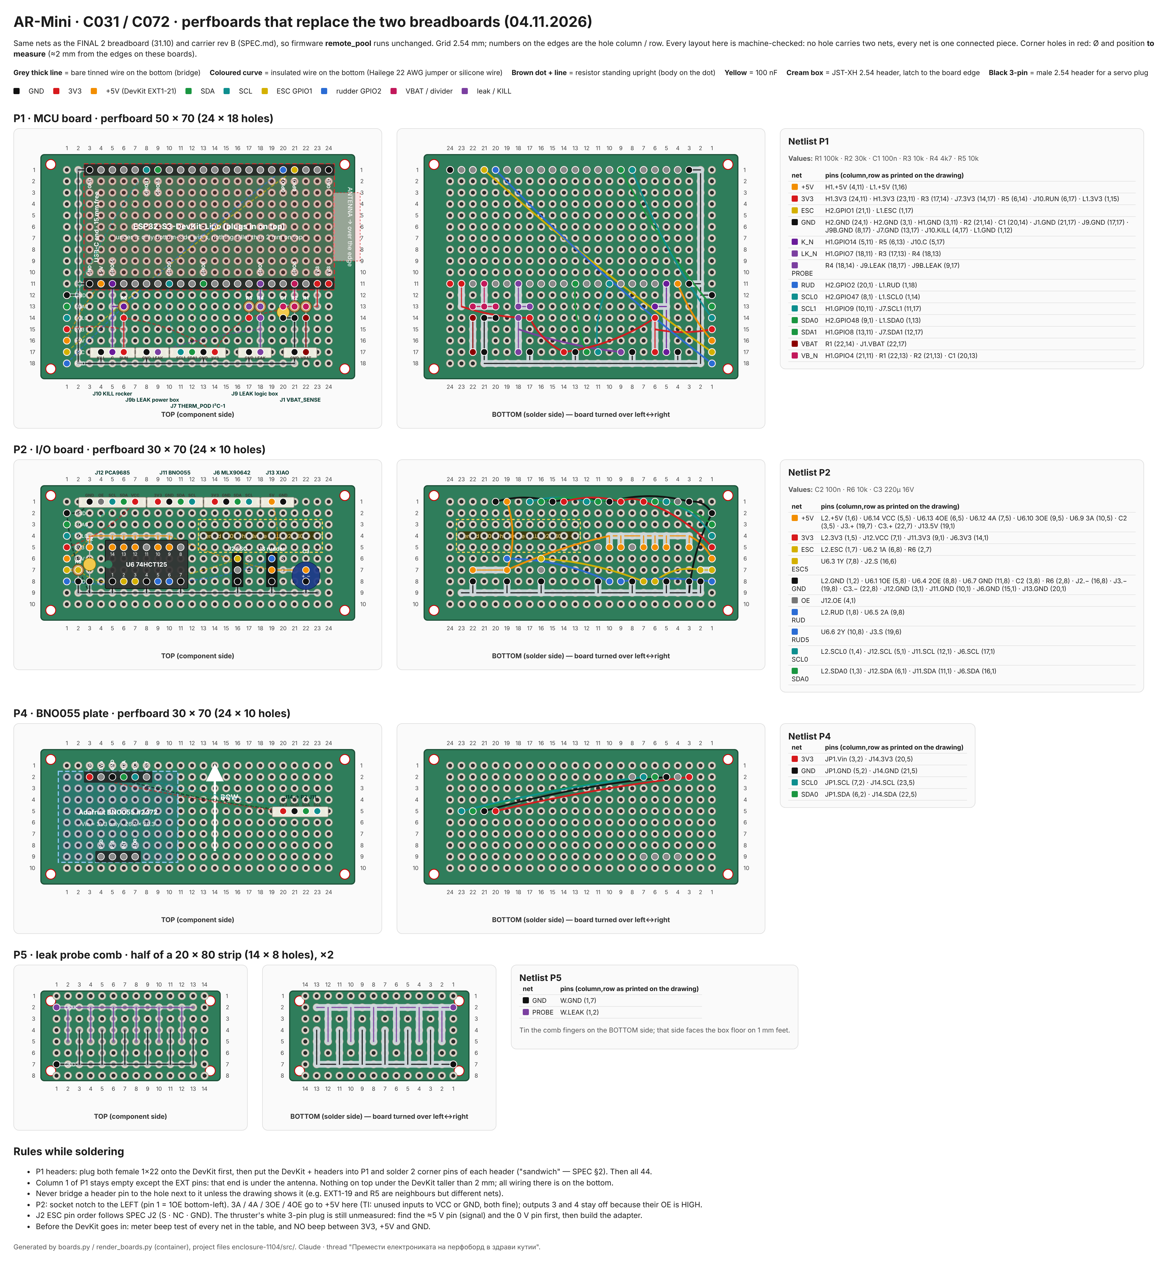
docs/diagrams/C072_diagram_perfboards.png
