TKyoseva/ARmini/hardware/breadboard/AR-Mini_breadboard_3_v1-all.png

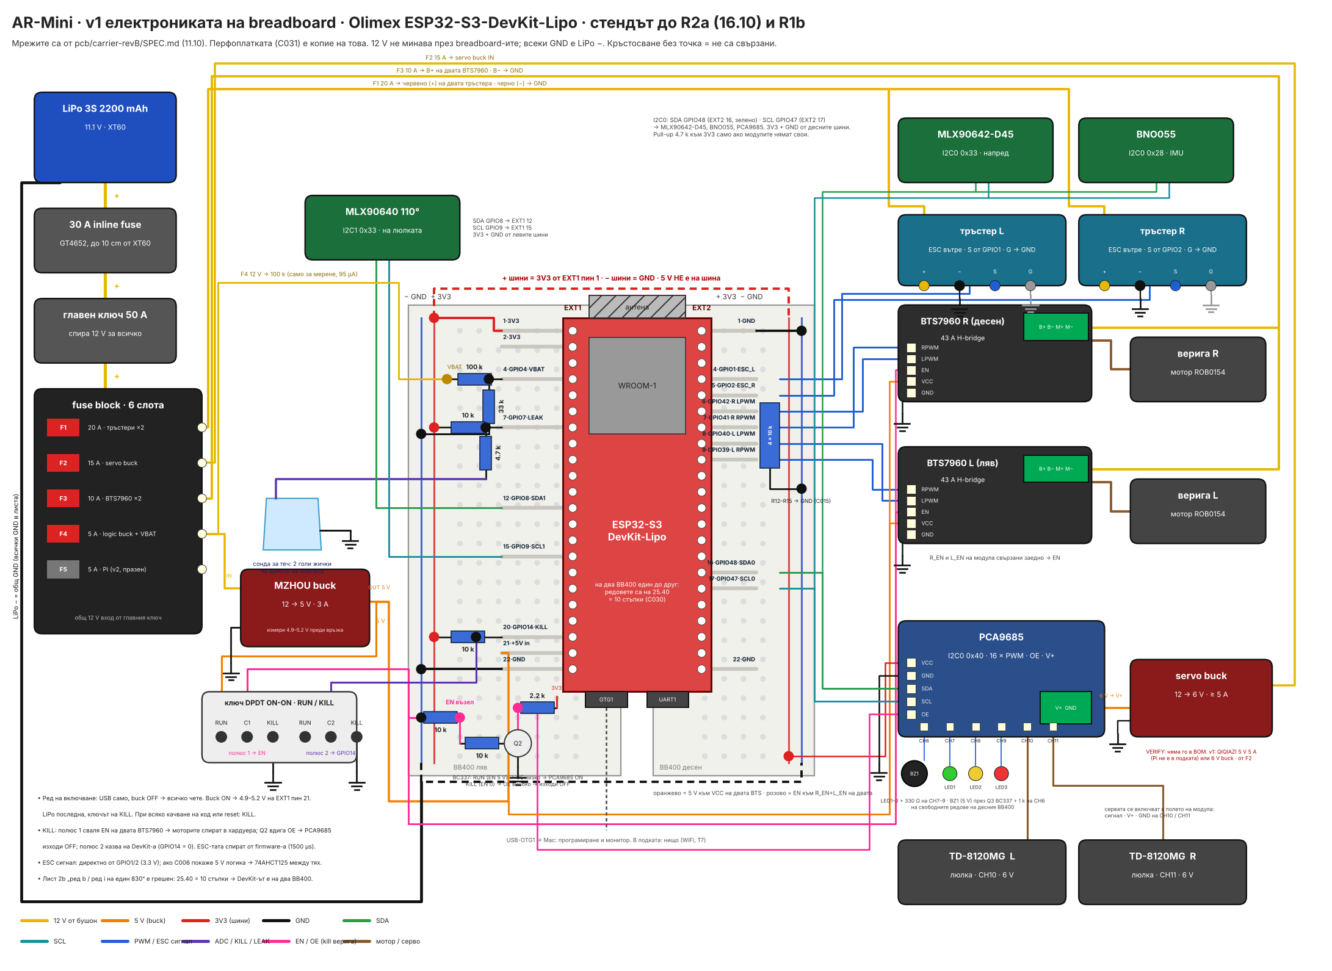
hardware/breadboard/AR-Mini_breadboard_3_v1-all.png
