TKyoseva/ARmini/media/photos/2026-10-06_thruster-and-servo-adapters/IMG_1200.jpg

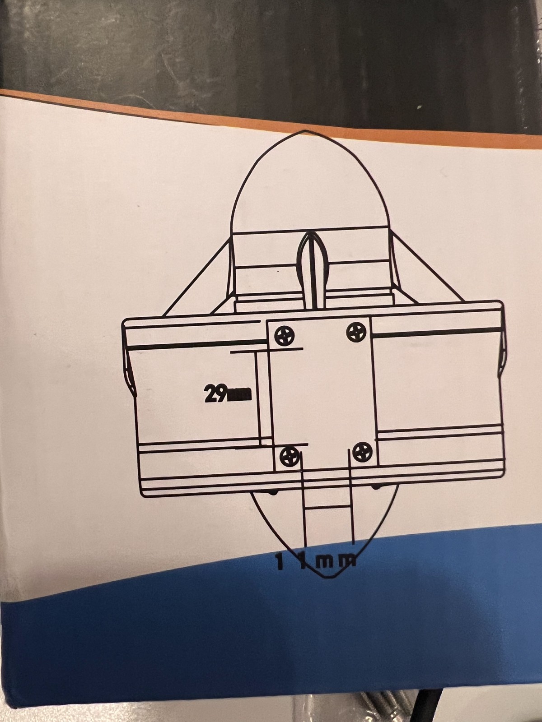
media/photos/2026-10-06_thruster-and-servo-adapters/IMG_1200.jpg
