TKyoseva/ARmini/pcb/carrier-revB/AR-Mini_carrier_revB_mockup.png

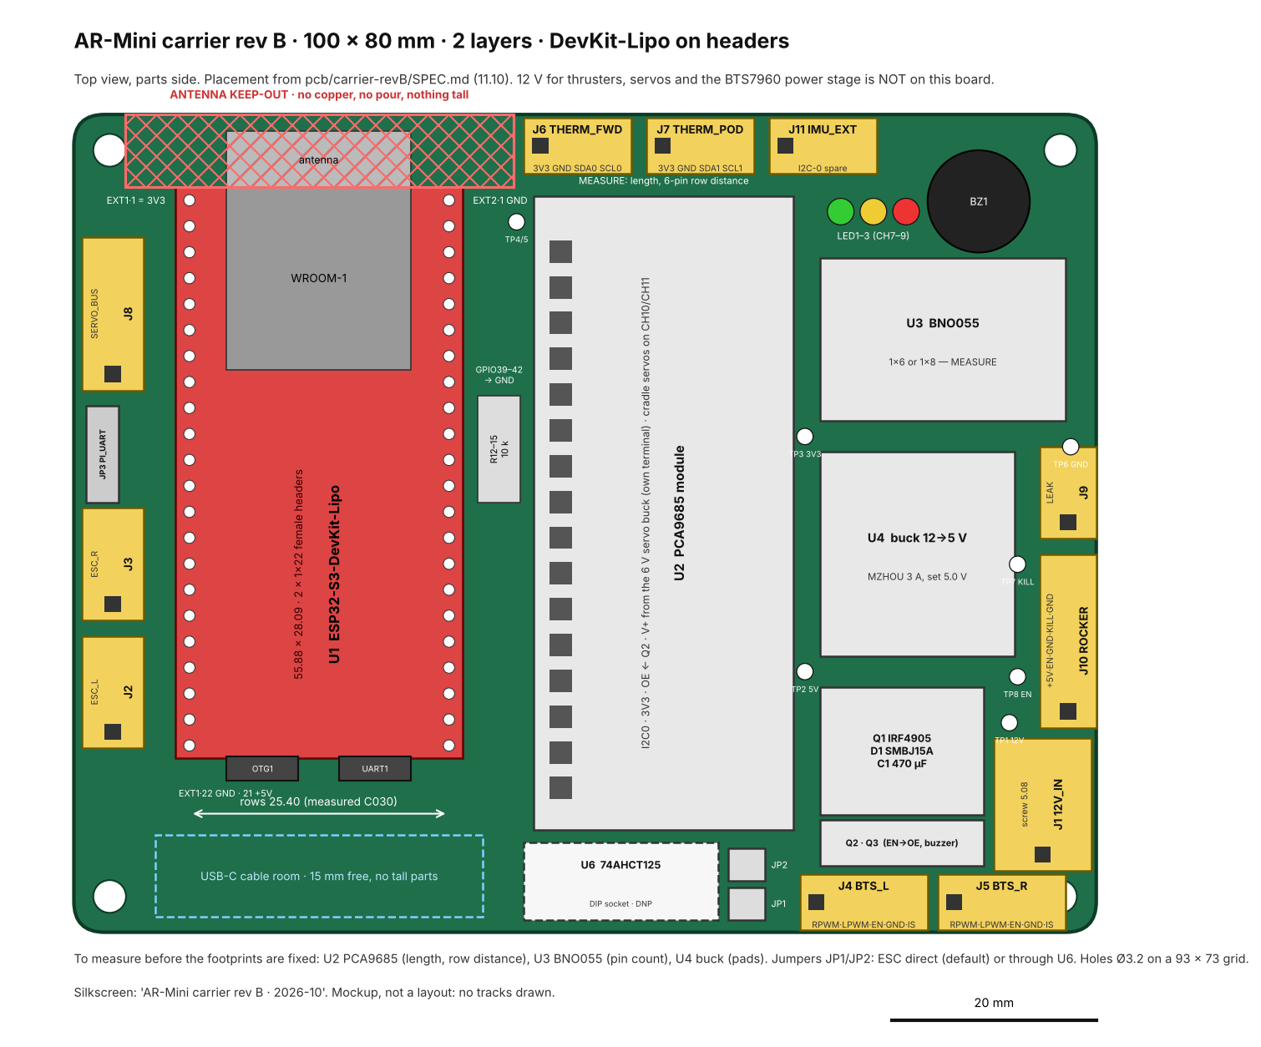
pcb/carrier-revB/AR-Mini_carrier_revB_mockup.png
