TKyoseva/ARmini/pcb/carrier-revB/AR-Mini_carrier_revB_top_view_v2.png

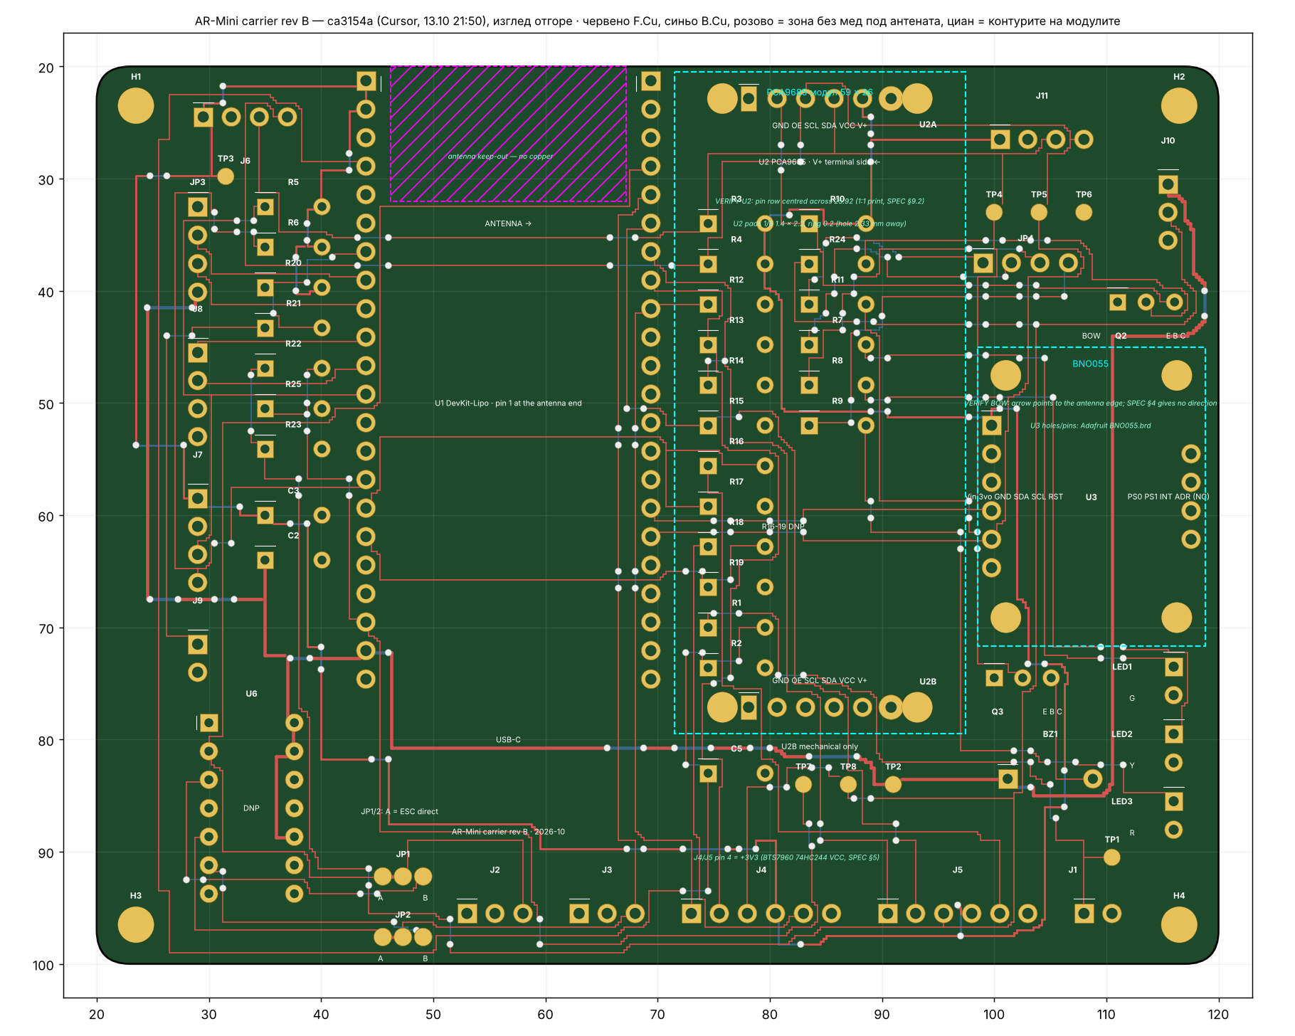
pcb/carrier-revB/AR-Mini_carrier_revB_top_view_v2.png
