TKyoseva/ARmini/docs/bom/bom.csv

# | Name | Qty | Type | Category | Specs (important for AR-Mini) | Use in AR-Mini | Status | Source
1 | Kantoflex aluminium square tube 15×15×1 mm | 2 | Mechanics | Metal | 1000 mm · 1.0 mm wall · ~0.15 kg/m · cut 3 × 304 mm (912 from one length) · drill Ø4.5 for M4 to the plate | 3 beams between the hulls (under the ROB0154 plate) + camera arch; the second one is spare/future beams | Have | Bauhaus
2 | Solid aluminium rod Ø5 mm | 1 | Mechanics | Metal | 1000 mm · Ø5.0 → 5.3 hole in the coupler · bends by hand around a Ø25 pipe (radius ~15 mm) · ~570 mm needed for the U-frame (220+123+220) + loss at the corners | The U-frame (cradle): two sides + front crossbar; the rest for axles and hinges | Have | Bauhaus
3 | Pattex Neutral Silicone (Alkoxy) | 1 | Mechanics | Adhesives | neutral cure (alkoxy) · 310 ml · skins over in ~15 min · full cure 24 h / 2 mm · −40…+150 °C · does not corrode copper/brass · does not bond well to PETG without primer → its role is sealing, not bonding | Gasket in the flanges between sections; groove in the power box lid; around the cable glands; thin layer along the outer edges of the joint | Have | Bauhaus
4 | Sikadur-31 CF Normal | 1 | Mechanics | Adhesives | 2K epoxy, thixotropic PASTE · A:B = 2:1 by weight · pot life ~45 min at 20 °C · handling strength 12 h, full 48 h · 10–30 °C when applying · tensile strength > 20 MPa · cannot be brushed on | Structural bonding: the rod into the couplers, the bosses to the hull, corner fillets along the inner edges. A thin coating on the hull needs liquid epoxy/XTC-3D | Have | Bauhaus
5 | Caulking gun 310 ml | 1 | Mechanics | Tools | standard skeleton · for 310 ml cartridges | For the Pattex | Have | Bauhaus
6 | Stanley hacksaw 300 mm | 1 | Mechanics | Tools | metal frame · 300 mm blades · cut with slow long strokes, aluminium snags under pressure | Cutting the beams (3 × 304) and the rod; always in the vise | Have | Bauhaus
7 | Wisent Bi-Metal blades 300 mm, 24 TPI | 1 | Mechanics | Tools | 24 teeth/inch · for walls ≤ 2 mm (rule: ≥ 3 teeth in the material) · bi-metal = do not snap | Fine teeth for 1 mm aluminium without a jagged edge | Have | Bauhaus
8 | Needle file set | 1 | Mechanics | Finishing | flat, round, triangular, square, half-round · ~140 mm · for holes 3–10 mm | Fitting the servo pocket, the insert holes, the edges of the printed parts | Have | Bauhaus
9 | Flat file 150 mm | 1 | Mechanics | Finishing | 150 mm · medium cut | Edges of the cut aluminium, flanges | Have | Bauhaus
10 | Bosch sandpaper P240 + P400 | 2 | Mechanics | Finishing | sheets · P240 = prepping PETG before silicone/epoxy · P400 = finish | Hull flanges (P240), smooth surfaces for photos (P400) | Have | Bauhaus
11 | Sanding Block | 1 | Mechanics | Finishing | hand block for 1/4 sheet | Flat flanges — a hand without a block makes waves | Have | Bauhaus
12 | Nuts M12 DIN 934 | 12 | Mechanics | Fasteners | zinc-plated · ~20 g/pc · total ~240 g | Ballast for the trim and heel of the hulls | Have | Bauhaus
13 | Nuts M3 DIN 934 | 100 | Mechanics | Fasteners | plain hex · 5.5 wrench · NOT self-locking | General assembly. For the arm axles → Loctite 243 or a jam nut | Have | Bauhaus
14 | Screws M3×25 + M3×30 DIN 7985 | 200 | Mechanics | Fasteners | cross head PH1 · zinc-plated · 25/30 mm | Parallelogram axles (6+8+6 mm stack + nut = 25 mm) and the power box lid | Have | Bauhaus
15 | Screws M5×20 + M5×30 DIN 912, nuts M5 DIN 985 | 200 | Mechanics | Fasteners | 4 mm hex socket · self-locking M5 · if the plate slots are ≥ 5.2 mm, instead of M4 | The ROB0154 plate to the beams; the arch mounts; vise → workbench | Have | Bauhaus
16 | DSM 640 pcs DIN 912 M3–M6 + nuts/washers | 1 | Mechanics | Fasteners | stainless A2 · hex socket · M3 up to 20 mm (the axles need 25/30 — from Bauhaus) | General assembly: brackets, mounts, bosses | Delivered | Amazon.de
17 | M2 kit 600 pcs | 1 | Mechanics | Fasteners | M2 bolts 4–20 mm, nuts, washers · black | Servo disc horns (M2), the MLX camera board | Delivered | Amazon.de
18 | ruthex inserts M2/M3/M4/M5 assortment + M3S ×100 | 2 | Mechanics | Fasteners | brass · M3: OD 4.0 mm, L 5.7 (RX-M3x5.7) → 4.0 mm hole · M3S: L 4.0 for thin walls · pressed in with the soldering iron at 230 °C | All bosses and lids on the printed parts (insert_d = 4.0 in CAD) | Delivered | Amazon.de
19 | Loctite 243 (medium-strength threadlocker) | 1 | Mechanics | Fasteners | 10 ml · medium strength · removable with tools · 24 h cure · for M3–M12 | The arm axles with plain M3 nuts — instead of the missing self-locking ones | To buy | Bauhaus / Vikiwat
20 | Screws M3 × 8 hex socket, 150 pcs | 1 | Mechanics | Fasteners | M3 × 8 · hex socket · black · 150 pcs | Modules and lids to the boxes; brackets and mounts into M3 inserts | Delivered | Amazon.de
21 | EVA foam 3 mm | 1 | Mechanics | Materials | closed-cell · 3 mm · cuts with a craft knife · does not absorb water | Gasket between the two bulkheads of the joint (two frames following the hull outline); torso of Pesho (the dummy) (variant A) | To buy | bookshop
22 | WEDZE hand warmers (Decathlon) | 30 | Mechanics | Materials | single-use · 5–6 h · up to ~50 °C in air · iron powder + charcoal + vermiculite · THEY NEED OXYGEN (the holes in the head) · bought 12.10: box 2 × 15 · pad 82.6 × 52.3 mm · EXP 2029.6 | Heat for Pesho (the dummy) — one warmer per session; for measurements at a set temperature → bottle of warm water | Have | Decathlon
23 | Creality Hyper PLA RFID 1.75 mm (7 spools: Black, Red, White ×2, Blue, Green, Orange) | 7 | Mechanics | Materials | PLA · 190–230 °C · RFID profile · softens at ~55 °C, brittle in the cold, creeps under load → NOT for the hull or for parts that sit in water or carry Pesho (the dummy); ideal for fit prototypes and anything dry | Colour code v1: orange = moving parts (arms, couplers, pivot bracket — fit version), black = structure (brackets, mounts, camera), white = fit prototype of a hull section, red = Pesho (the dummy), blue = boxes/lids/cable clips, green = Gridfinity bins | Have | have
24 | Creality Hyper PETG 1.75 mm | 4 | Mechanics | Materials | PETG · 230–260 °C · does not soften in warm water · tougher than PLA · 4 spools | The hulls (4 sections of 305 mm, at 45° on the plate), the flanges and everything wet | Delivered | Amazon.de
25 | PG7 cable glands | 0 | Mechanics | Hull | PG7 thread → 12.5 mm hole · cable 3–6.5 mm · IP68 with nut · nut ≈ 19 mm across flats → ≥ 25 mm between glands | C072 (05.11): NOT NEEDED. The two LANUCN boxes came with M20×1.5 glands + a Ø20 hole saw; 6 M20 glands cover all cables. Keep this row only as a fallback for a thin single cable | Not needed | Vikiwat
26 | LANUCN IP65 enclosure 150 × 110 × 70 mm | 1 | Mechanics | Hull | ABS · IP65 · with cable glands for 6–12 mm cable · black · inner ≈ 106 × 146 mm at the rim, base depth ≈ 55 mm (ruler 05.11) · 3 knockout rings on one long wall · came with M20×1.5 glands | C072 LOGIC box: P1 DevKit board, P2 74HCT125 / I²C hub, PCA9685 on a printed wall bracket, P4 BNO055 plate, leak comb. No bucks and no 12 V inside except the VBAT sense wire (clean magnetometer) | Delivered | Amazon.de
27 | DFRobot ROB0154 tracked chassis | 1 | Mechanics | Chassis | tracks · 2 DC motors · measured: height 124.6 mm, plate 152.2×134.8×2 mm, motor shaft 62 mm above the bottom edge · sprockets at the front top | The land part: the plate bolts under the beams (x = 385 / 500), the motor shafts are above the waterline; driven via BTS7960 | Delivered | Elimex
28 | Cuifati 560 KV underwater thruster | 2 | Mechanics | Drive | 560 KV · up to 300 m · bidirectional ESC included (three thin signal wires) · 12 V · anti-corrosion bearings | One at the stern of each hull; differential heading control (CH0 / CH1 on PCA9685; 12 V from 20 A fuse) | Delivered | Amazon.de
29 | Waveshare ST3215 30 kg servo (serial bus) | 4 | Mechanics | Servos | 30 kg·cm @ 12 V · 360° magnetic encoder · servo / motor mode · feedback (position, load, temperature) · ID 1–4 | The parallelogram arms (left / right) + thermal camera pan; the fourth = spare. Measure the mounting ears before the pivot_bracket | Delivered | Amazon.de
30 | TD-8120MG 20 kg servo | 2 | Mechanics | Servos | 20 kg·cm · metal gears · measured 40.3 × 20.14 × 40.7 mm, mounting ears at 50 mm, Ø4.34 holes at 10 mm, shaft 10.4 mm from the front wall | Preset "TD8120" in the SCAD: first tests of the arms and the pan before the ST3215s arrive; spare afterwards | Delivered | Ardboard
31 | MG90S 9 g micro servo | 8 | Mechanics | Servos | 9 g · metal gears · 180° · 4.8–6 V · 8 pcs | Light camera pan, cradle lock, test rigs | Delivered | Amazon.de
32 | iFixit Pro Tech Toolkit | 1 | Electronics | Kits | 64 bits (PH, Torx, Hex 1.5–6, Pentalobe) · tweezers · opening tools · anti-static wrist strap | Everything with M2/M2.5/Torx; the tweezers for JST terminals; the wrist strap to the ESD mat | Have | Bauhaus
33 | Joy-IT ARD-Set01 (Mega 2560 kit) | 1 | Electronics | Kits | ATmega2560 16 MHz · 54 I/O · 4 UART · 5 V logic · 2 breadboards · resistors/LED/buzzer/potentiometer/7-seg | Thrust test rig (potentiometer → ESC → scale); resistors for the divider; buzzer; wired teleoperation | Delivered | have
34 | Freenove Ultimate Starter Kit (Raspberry Pi) | 1 | Electronics | Kits | breadboard + 40-pin expansion board · joystick · HC-SR04 · thermistor · relay · L293D (0.6 A — too small for ROB0154) | Teleoperation with the joystick via Mega; ultrasound for the shore; thermistor for the v2 dome; relay for the thrusters on a leak | Delivered | have
35 | FNIRSI HS-03 soldering iron | 1 | Electronics | Soldering | battery-powered 2600 mAh · ~40 min at 350 °C · heat-up 3 s · 200–420 °C · for Sn60Pb40: 300–320 °C · switch to 350 for 14 AWG | All solder joints: splicing 5264 cables, the boards, cable lugs | Delivered | Amazon.de
36 | Solder CYNEL Sn60Pb40 0.8 mm 100 g | 1 | Electronics | Soldering | leaded · melts at 183–190 °C · 2.5 % flux core · 0.8 mm = all-purpose | Boards and cables; wash your hands; fumes away | Have | Proton
37 | Flux TOPNIK-ZEL RMA gel | 3 | Electronics | Soldering | syringe 1.4 ml · RMA · residue is mildly corrosive → wash off with IPA | Splicing wires, tinning 14 AWG, SMD repairs | Have | Proton
38 | Third hand ZD-126-4 with LED and soldering iron stand | 1 | Electronics | Soldering | 4 flexible arms · heavy base · LED · soldering iron stand | Holds the two wires while splicing; stand for the HS-03 | Have | Proton
39 | iFixit anti-static mat | 1 | Electronics | Soldering | heat-resistant up to 500 °C · magnetic/with compartments · on top of the ESD mat | While soldering; small screws do not roll away | Delivered | Amazon.de / Vikiwat
40 | Isopropyl alcohol 99 % + old toothbrush | 1 | Electronics | Soldering | 500 ml · 99 %, not 70 % (the water stays on the board) | Washing off flux — flux + water = corrosion within weeks | To buy | Vikiwat / pharmacy
41 | Desoldering braid 2 mm | 1 | Electronics | Soldering | 1.5 m · 2.0 mm · with flux | Removing a soldered wire from the BTS7960 / removing excess solder | To buy | Vikiwat
42 | Toolour third hand (parallel clamps, magnetic base) | 1 | Electronics | Soldering | two non-marring parallel clamps · magnetic base · 10 × 10 × 0.5 cm | Holds the XIAO / breakout rev 0 while soldering the headers (substitute for the PCB vise from row 37) | Delivered | Amazon.de
43 | KNIPEX NexStrip 12 72 190 | 1 | Electronics | Cables | stripper 0.03–10 mm² (AWG 32–8) · crimps ferrules 0.25–4 mm² · cuts up to 10 mm² | Stripping 14/18/22 AWG silicone; ferrules for the screw terminals on the BTS7960, the bucks, the terminal strips | Delivered | Amazon.de
44 | Preciva crimp kit Dupont/JST-XH/waterproof | 1 | Electronics | Cables | SN-28B type · 0.25–1.5 mm² (AWG 23–16) · 627 pieces · does NOT crimp 5264 (ST3215) or 6.3 mm lugs | JST-XH for all sensor and servo connectors; waterproof connectors for the thrusters and the leak sensor | Delivered | Amazon.de
45 | Alkan ferrules 800 pcs 0.5–10 mm² | 1 | Electronics | Cables | DIN 46228 · 22 AWG → 0.5 · 18 AWG → 0.75/1.0 · 14 AWG → 2.5 | Stranded wire in screw terminals | Delivered | Amazon.de
46 | Heat-shrink tubing, box Ø1.5–13 mm | 1 | Electronics | Cables | 2:1 · 100 mm pieces · 1.5/2.5 for single wires, 4/6 for sleeving a bundle · without adhesive (for below the waterline → with adhesive) | Splicing the 5264 cables, insulating solder joints | Delivered | Vikiwat
47 | Insulated flat terminals 6.3 mm, 25 M + 25 F | 1 | Electronics | Cables | flat (spade) 6.3 mm · insulated · 1.5–2.5 mm² | To the master switch, the rocker and the fuse block (14 AWG) | Delivered | Vikiwat
48 | Turnigy 14 AWG silicone wire, 1 m (2 × black + 2 × red) | 4 | Electronics | Cables | silicone · 2.1 mm² · flexible · up to ~30 A · 4 × 1 m | Battery → inline fuse → switch → fuse block → ESCs (everything over 10 A) | Delivered | NenovTechnic
49 | 18 AWG silicone wire, 1 m (2 × black + 2 × red) | 4 | Electronics | Cables | silicone · 0.82 mm² · 4 × 1 m | 5 V rails, BTS7960 → motors, 12 V to the servo driver | Delivered | NenovTechnic
50 | XT60 cables with connector, 10 pcs | 1 | Electronics | Cables | 5 male + 5 female · 12 AWG silicone · 100 mm | The battery line; adapters for the iMAX B6 and for the lab power supply | Delivered | Amazon.de
51 | Waveshare 5264 servo cables, 3-pin | 2 | Electronics | Cables | 5264 connector · 3 wires · ~20 cm | Daisy-chaining the four ST3215s (spliced with the 5264 connectors, not Dupont) | Delivered | Amazon.de
52 | SkyRC iMAX B6 V2 charger | 1 | Electronics | Batteries | 60 W · 1–6S · up to 6 A · input 11–18 V DC · 3S 2200 mAh: 2.2 A (1C), ~1 h · storage 3.8 V/cell | Balance charging and storage mode for both LiPos; from the lab supply at 13 V | Delivered | NenovTechnic
53 | Turnigy 2200 mAh 3S 40C LiPo | 2 | Electronics | Batteries | 11.1 V · 2200 mAh · 40C (88 A) · XT60 · measured 108×33×23 mm | One in the robot (XT60 → 30 A inline fuse → 50 A switch → fuse block), one on the charger; ~15–20 min test with two thrusters | Delivered | NenovTechnic
54 | FT232RL USB-TTL converter | 1 | Electronics | Programmers | 3.3/5 V switch · RX/TX LED · to servo driver: TX→RX, RX→TX, GND, no VCC | Waveshare software for ST3215 ID and testing without code | Delivered | Ardboard
55 | JST-XH 2.54 mm kit: PCB headers + housings + 22 AWG crimped leads (2–6 pin) | 8 | Electronics | Boards | JST-XH 2.54 mm · male PCB headers + female housings 2/3/4/5/6 pin · 22 AWG silicone, pre-crimped | Connectors on XIAO breakout rev 0 (J3–J7) and carrier rev A (J2–J11); the ready-made cables save crimping | Delivered | Amazon.de
56 | Resistors 100k and 33k 1 % (1/4 W) | 10 | Electronics | Boards | metal film 1 % · divider 12.6 V → 3.13 V · current 95 µA · if the kit has no 33 k → 10 k / 3.3 k (same ÷ 4) | rev 0 breakout + carrier | Delivered | Amazon.de (MOGAOPI kit)
57 | VooGenzek PCB kit 75 pcs | 2 | Electronics | Boards | 20 double-sided prototype boards · 20 M/F headers · 15 screw terminals 2/3-pin · 20 nylon standoffs | Perfboard version of the carrier, test boards for the ladder/divider, standoffs for mounting the modules in the IP65 enclosure | Delivered | Amazon.de
58 | YIXISI screw terminals 5 mm, 2/3/4 pin, 100 pcs | 100 | Electronics | Boards | 5.0 mm pitch (fits 5.08 / 2 × 2.54 mm) · green · 2, 3 and 4 pin · for 14–22 AWG with ferrules | J1 12V_IN on carrier rev A, buck input/output, VBAT; perfboard | Delivered | Amazon.de
59 | MOGAOPI component kit, 1390 pcs | 1 | Electronics | Boards | metal film resistors 1 % · ceramic and electrolytic capacitors · diodes · LED · NPN/PNP transistors | VBAT divider, the ladder (10 k / 4.7 k / 1 k), pull-up 2.2 k, 100 nF, buzzer (NPN), LEDs; check that the 470 µF is ≥ 25 V | Delivered | Amazon.de
60 | Glarks pin headers 2.54 mm, 112 pcs | 1 | Electronics | Boards | 100 stackable (Arduino shield: 6/8/10 pin, long legs) + 12 × 1×40 breakaway male | Modules on carrier rev A must be removable; XIAO: 8-pin female → cut to 7 | Delivered | Amazon.de
61 | ESP32-S3-DevKit-Lipo (Olimex) | 3 | Electronics | Controllers | ESP32-S3-WROOM-1 · 8 MB flash / 8 MB PSRAM · USB-C · LiPo charger + battery connector · can run Linux 6.3 | Candidate for controller v2 and test board for the firmware before carrier rev A (same chip as the WROOM module). 3 pcs: robot / desk / spare | Delivered | Comet.bg
62 | ESP32-S3-WROOM-1-N16R8 module | 3 | Electronics | Controllers | Wi-Fi 802.11 b/g/n + BT · 2.4–2.5 GHz · 150 Mb/s · 16 MB flash · 8 MB octal PSRAM · avoid GPIO 26–32, 35–37 | The module for carrier rev A — soldered directly to the board (January). 3 pcs for the 3 Aisler boards | Delivered | Comet.bg
63 | Seeed XIAO ESP32-S3 Sense | 1 | Electronics | Controllers | ESP32-S3 · 8 MB PSRAM / 8 MB flash · Wi-Fi + BLE 5 · OV3660 camera · microSD slot · 2×7 headers, 15.24 mm spacing between rows · measured 15.35 mm width | Controller v1: state machine, PCA9685 on I2C-0 (D4/D5), the two thermal cameras on two I2C buses, the servo bus on UART1 (D6/D7), ADC ladder leak + kill on A1, VBAT on A0; USB to Pi 5 for v2 | Delivered | Comet.bg
64 | Raspberry Pi 5 · 8 GB | 1 | Electronics | Controllers | 4× Cortex-A76 2.4 GHz · 8 GB · USB 3 · 5 V / 5 A via USB-C (from the QIQIAZI buck) · 85×56 mm | v2 (2027): ROS 2 Jazzy, rosbag recording and planning; talks to the XIAO over USB serial. During v1 it stays on the desk for development. | Delivered | Amazon.de (Astradis)
65 | Active cooler for Raspberry Pi 5 | 1 | Electronics | Controllers | PWM fan + aluminium heatsink · clips onto the two pins on the Pi 5 | Pi 5 in a closed case without cooling throttles at ~80 °C | Delivered | Amazon.de
66 | Eldraqth alligator clips double-ended, 10 pcs | 2 | Electronics | Measuring | 10 pcs insulated double-ended test lead clips | Multimeter to the fuse block / battery without holding the probes; temporary connections when testing the kill | Delivered | Amazon.de
67 | Cleqee alligator ↔ breadboard jumpers, 10 pcs | 1 | Electronics | Measuring | 10 pcs alligator clip → Dupont male, ~20 cm | Servo/ESC cables and bare wires (leak probe) to the breadboard during tests | Delivered | Amazon.de
68 | Hailege U-shaped breadboard jumpers, 2 × 140 pcs | 1 | Electronics | Prototyping | 2 boxes × 140 rigid U-jumpers · 22 AWG · colour-coded by length | Breadboard mock-ups: ADC ladder, VBAT divider, I2C bus with two sensors | Delivered | Amazon.de
69 | U-shaped breadboard jumpers, 840 pcs, 14 lengths | 1 | Electronics | Prototyping | 2–125 mm · rigid · colour-coded by length | Breadboard 1 / 2 / 2b — the ladder, the rails, the I²C branches | Delivered | Amazon.de
70 | SanDisk Extreme 64 GB microSDXC | 1 | Electronics | Storage | A2 · V30 · up to 170 MB/s read · with SD adapter | Pi OS Bookworm + ROS 2 Jazzy; the rosbag logs from the tests | Delivered | Amazon.de
71 | SanDisk Ultra 32 GB microSDHC | 2 | Electronics | Storage | A1 · up to 120 MB/s · 2 pcs | XIAO Sense microSD slot: CSV logs at 10 Hz + photos from the missions; the second one = spare/archive | Delivered | Amazon.de
72 | PCA9685 16-channel 12-bit PWM module | 1 | Electronics | Drivers | 16 channels · 12 bit · I2C address 0x40 · OE pin · V+ terminal for servo power · measured board length 62.15 mm | CH0/1 → ESC left/right, CH2–5 → BTS7960 RPWM/LPWM, CH6 buzzer, CH7–9 LEDs; OE is pulled by the logic kill | Delivered | Ardboard
73 | Hailege PCA9685 Servo Shield (Arduino) | 1 | Electronics | Drivers | shield format for Uno/Mega · 16 channels · same PCA9685 chip · I2C | The Mega 2560 test rig: testing the ESCs and servos before the XIAO; module spare | Delivered | Amazon.de
74 | BTS7960 43 A H-bridge (dual) | 2 | Electronics | Drivers | 43 A peak · 5.5–27 V · RPWM / LPWM + R_EN / L_EN · heatsink · measured 40.8 mm | One per ROB0154 track (left / right motor); 12 V from 10 A fuse; PWM from PCA9685 CH2–5 | Delivered | Ardboard
75 | Waveshare Serial Bus Servo Driver | 2 | Electronics | Drivers | UART TTL → half-duplex servo bus · input 6–12.6 V · up to 253 servos · small board | XIAO UART1 (D6 TX / D7 RX) → 4 × ST3215; 12 V from 15 A fuse. The second one = spare / test rig | Delivered | Amazon.de
76 | MLX90642-D45 thermal camera | 1 | Electronics | Sensors | 32×24 px · 45° field of view · I2C · 3.3 V · up to ~8 Hz | The front search camera (I2C-0, Wire D4/D5) — finds Pesho (the dummy) from 1–2 m by heat | Delivered | Amazon.de
77 | Waveshare MLX90640 110° thermal camera | 1 | Electronics | Sensors | 32×24 px · 110° · I2C address 0x33 · 3.3 V · wide-angle | On the cradle: confirms the object is between the arms before lifting (I2C-1: Wire1 SCL = D2, SDA = D3) | Delivered | Amazon.de
78 | BNO055 9-DOF IMU breakout | 1 | Electronics | Sensors | 9-axis · on-board fusion → Euler angles over I2C · 3.3 V · address 0x28 · measure the header for carrier rev A | Heading while homing on the target; roll / pitch while lifting (I2C-0) | Delivered | Amazon.de (GoTo)
79 | MZHOU 12 → 5 V USB-C buck | 1 | Electronics | Power | input 8–20 V · 5 V / 3 A · USB-C output · with cables | The logic 5 V rail (XIAO, sensors, PCA9685 VCC) from 5 A fuse | Delivered | Amazon.de
80 | QIQIAZI 10–90 V → 5 V 5 A buck | 1 | Electronics | Power | 25 W · USB-C · 5 A — what the Pi 5 asks for | Separate 5 V rail for the Pi 5 (v2); in v1 — Pi on the desk from the lab supply | Delivered | Amazon.de
81 | Master switch R13-401A2A-07, 50 A / 12 V DC | 1 | Electronics | Power | SPST OFF-ON · 50 A / 12 V DC · 2 terminals (6.3 mm flat) · Ø12 panel hole | Main switch after the inline fuse — cuts EVERYTHING (thrusters, servos, logic) | Delivered | Vikiwat
82 | Rocker switch ON-ON, 20 A / 12 V | 1 | Electronics | Power | 2-position ON-ON · 20 A / 12 V DC · 2 terminals | Logic kill: pulls PCA9685 OE + a step in the ADC ladder → motors stop, XIAO stays alive and logs | Delivered | Vikiwat
83 | Fuse holder GT4652 (inline) | 1 | Electronics | Power | moisture-proof · 12/24 V DC · blade fuses up to 30 A · 12 AWG wire | 30 A main fuse, directly on the battery XT60 (before the switch) | Delivered | Vikiwat
84 | Fuse block with cover, 6 slots | 1 | Electronics | Power | 6 slots · common input · cover · LED for a blown fuse · ~"too big" → in the printed power box | Distribution: 20 A ESCs, 15 A servo bus, 10 A BTS7960, 5 A logic, 5 A spare | Delivered | Vikiwat
85 | Automotive fuses, 250 pcs kit | 1 | Electronics | Power | blade standard + mini · 2–35 A · colour-coded | Fuses for the block (20/15/10/5/5 A) + 30 A for the inline holder; spares | Delivered | Vikiwat
86 | Autodesk Fusion 360 (Education) | 1 | Software | CAD/CAE | parametric CAD · Simulation (Static Stress, local solve) · Motion Study · STEP/STL export · cloud files | The hull from the AR_Mini_hull.py script; hydrostatics (CG vs CB); FEA of the arm and the bracket; renders and exploded view for the portfolio | Installed | autodesk.com
87 | OpenSCAD 2024 | 1 | Software | CAD | text-based parametric CAD · F5 preview / F6 render · STL export · the whole robot in AR-Mini_v1.scad | All printed parts, the assembly with the chassis and the waterline, plate_check for the K2 Pro bed | Installed | openscad.org
88 | KiCad 9 | 1 | Software | ECAD | schematic + PCB · DRC · 3D viewer · AISLER Push plugin · opens .kicad_pcb v7 | rev 0 XIAO breakout (finished file) and carrier rev A per the spec; Gerber/upload to Aisler | Installed | kicad.org
89 | Creality Print 6 (or Orca Slicer) | 1 | Software | Slicer | profiles for K2 Pro · RFID materials · 4 perimeters / 10 bottom layers for the hull · sending over WiFi | Slicing the STLs; rotating the hull section by 45°; drying PETG with the printer | Installed | creality.com
90 | VS Code + PlatformIO | 1 | Software | Firmware | Arduino framework for ESP32-S3 · libraries: Adafruit MLX90640, Melexis MLX90642, SCServo (Waveshare), Adafruit PWMServoDriver, Adafruit BNO055, SD, WiFi · FreeRTOS tasks | XIAO firmware: state machine, perception, pan loop, CSV log, WiFi telemetry | To install | platformio.org
91 | Arduino IDE 2 | 1 | Software | Firmware | for Mega 2560 · Servo, Wire libraries | Thrust test rig (potentiometer → ESC), wired teleoperation with the joystick, quick module tests | To install | arduino.cc
92 | Waveshare Bus Servo Control (Windows) | 1 | Software | Tool | via FT232 (TX↔RX, GND) · sets ID, middle position, limits · shows position/load/temperature live | ID 1–4 on the ST3215s, first arm test without code, zero calibration | To install | waveshare.com/wiki
93 | PulseView (sigrok) | 1 | Software | Tool | UART, I2C, SPI, PWM decoders · for the FX2 analyser (fx2lafw) | Debugging the servo bus and I2C when it "does not respond" | To install | sigrok.org
94 | Python 3 + pandas + matplotlib | 1 | Software | Data | CSV → graphs · the scripts for the diagrams and the poster (AR-Mini_hardware_diagram.py) | Graphs for the portfolio: homing, servo load, voltage, table of the 20 missions | Installed | python.org
95 | Git + GitHub | 1 | Software | Code | repo: firmware/ cad/ pcb/ docs/ data/ · commit every evening · README with BOM and schematic | The project history = proof of the process; S works in a branch | Installed | github.com
96 | Raspberry Pi OS Bookworm + ROS 2 Jazzy | 1 | Software | Software v2 | 64-bit · ROS 2 Jazzy · rosbag · USB serial bridge to the XIAO | v2: the ROS 2 stack from the simulation on the real robot; mission recordings | To install (v2) | raspberrypi.com / ros.org
97 | Eurocircuits PCB Visualizer | 1 | Software | Service | free DFM analysis of Gerbers · shows thin traces, small holes, mask | Checking rev 0 and rev A before Aisler | Online | eurocircuits.com
98 | AISLER | 1 | Software | Service | 2 layers 1.6 mm · 3 pcs minimum · ~1 week to Bulgaria · accepts .kicad_pcb directly | PCB manufacturing | Online | aisler.net
99 | Printables | 1 | Software | Service | STL library · Gridfinity, PCB vise, tool holders | Organisation bins, holders; uploading your models after December | Online | printables.com
100 | SlideRoom (MIT Maker Portfolio) | 1 | Software | Service | separate account · questionnaire · ≤ 2 min video total · photos ≤ 5 MB · $10 · by 4.01.2027 | Portfolio submission by 28.12 | Online | mitadmissions.slideroom.com
101 | DaVinci Resolve (free) or CapCut | 1 | Software | Video | cutting, split screen, text · export 1080p H.264 ≤ 250 MB | 90 s full cycle + 30 s "what broke" for the portfolio | To install | blackmagicdesign.com
102 | Claude Max (Projects + Claude Code) | 1 | Software | AI agents | Max subscription (200 USD) · separate Project for each agent · Project knowledge = the agent's files · Claude Code on the laptop: reads the repo, compiles, uploads to the board | The Coordinator, Mechanical, Electrical, Logistic, Media, Test & Data and Portfolio agents; Claude Code for the firmware on the laptop | Subscription | claude.ai
103 | Cursor Premium | 1 | Software | AI agents | Premium subscription, 3000 USD limit · AI editor based on VS Code · works with the PlatformIO extension · chat and edits across the whole project | Software agent: ESP32-S3 firmware with AI in the editor; the main code editor; Claude Code for compiling, uploading and git | Subscription | cursor.com
104 | ChatGPT Plus | 1 | Software | AI agents | subscription 20 USD · separate model for independent checking · uploading photos and PDFs | Second opinion (red team) on key Mechanical and Electrical decisions before printing or first power-up; voice mode while soldering | Subscription | chatgpt.com
105 | Gemini Plus | 1 | Software | AI agents | Plus subscription · accepts long videos and PDF datasheets | Test & Data: frame-by-frame review of the water test video; second opinion on datasheets | Subscription | gemini.google.com
106 | AR-Mini Loop tracker | 1 | Software | AI agents | page in Claude · loops (hypothesis → result), tasks, dashboard · written from the phone | The log of every loop and the source of the numbers in the portfolio | Using | claude.ai (artifact)
107 | Laserliner ThermoSpot One | 1 | Lab | Measuring | IR: −38…+365 °C · accuracy ±2.5 °C · resolution 0.2 °C · 12:1 optics (at 30 cm measures a Ø2.5 cm spot = the head of Pesho (the dummy)) · fixed emissivity 0.95 (plastic/skin ok, NOT shiny metal) · 2×AAA · 173 g | Temperature of the head of Pesho (the dummy) and of the water before each test; calibration of the MLX cameras (target = same surface, same spot); ESC, BTS7960, motors, LiPo while charging | Have | Bauhaus
108 | Jesverty SPS-3010N lab power supply 30 V / 10 A | 1 | Lab | Measuring | 0–30 V · 0–10 A · CC/CV · V/A/W display · USB 5 V/2 A · ordered as 60 V / 5 A, the 30 V / 10 A model came (12.10) · for tests: 12.0 V, CC = 3 A at first (protects against shorts), then the 20 A branch from LiPo only | The whole robot on the desk without LiPo; input for iMAX B6 V2 (13 V); current draw of each module; thrust test rig | Delivered | Amazon.de
109 | Caliper SUW-DIGIP54 0–150 mm | 1 | Lab | Measuring | 0–150 mm · 0.03 mm · inside/outside/depth · LR44 battery | All MEASURE values in the CAD; checking the printed parts (3.3 hole, 110.0 between the axles) | Delivered | Vikiwat
110 | UNI-T UT61E+ multimeter | 1 | Lab | Measuring | True RMS · 22000 counts · 10 A jack (thruster 8 A ok, not 20 A) · mA/µA · CAT III 600 V · bargraph | Rails, motor/servo current, the battery divider, solder joints (continuity) | Delivered | Amazon.de
111 | USB logic analyser 24 MHz 8 CH | 1 | Lab | Measuring | 24 MS/s · 8 channels · 0–5 V · 1.5 V threshold · PulseView (sigrok) · UART up to ~2 Mbps, I2C up to 1 MHz | Debugging the servo bus (UART 1 Mbps) and both I2C buses | Delivered | Amazon.de
112 | Scale up to 5–10 kg (kitchen) | 1 | Lab | Measuring | 1 g resolution · tare | Weight of the parts and of the whole robot (target 4.7 kg) → draft · used 12.10 for the warmer (45 g) and the M12 nut (16 g) | Have | at home
113 | Scotch Mounting Tape 19 mm | 1 | Lab | Mounting | foam, double-sided · 19 mm · ~1 kg hold per 10 cm · not on PETG under water | Boards and bucks in the boxes during tests (before mounts); the fuse block temporarily | Have | Bauhaus
114 | Cable ties white + coloured | 2 | Lab | Mounting | assortment 100–200 mm · 2.5–3.6 mm width | Cable bundles; colour = subsystem (red power, green sensors, yellow servos) | Have | Bauhaus
115 | iFixit Portable Anti-Static Mat | 1 | Lab | Organisation | ESD mat · with grounding cord (1 MΩ) · surface resistance 10⁶–10⁹ Ω · not heat-resistant (the soldering iron does not rest on it) | "Clean" zone: XIAO, boards, sensors. Grounded to the Schuko earth or the lab supply's ground | Have | Bauhaus
116 | TEDi Mini Printer D-44309 | 1 | Lab | Organisation | thermal · no toner/ribbon · Bluetooth from the phone · thermal paper fades with heat/sun → not on the BTS7960 | Label on every connector, cable and box — four people on the project | Have | TEDi
117 | Anti-static zip bags 10×15 and 15×20 cm | 50 | Lab | Organisation | pink (dissipative) or silver (shielding) · with zip | Every board that is not mounted lives in a labelled bag | To buy | Vikiwat / Amazon.de
118 | Gridfinity bins (printed) | 20 | Lab | Organisation | 42 mm grid · baseplate + bins 1×1…2×3 · PLA from leftovers · labels from TEDi | Inserts, M3 by length, M2, JST terminals, fuses — each in its own bin | Printing | Printables
119 | IKEA SAMLA 78 L + 45 L | 2 | Lab | Organisation | 79×57×43 cm (the robot is 61×45) / 45 L · with lids | Transporting the robot to the pool; "the pool kit" | To buy | IKEA
120 | Stanley vise | 1 | Lab | Workbench | bench-mounted · jaw width ~75–100 mm · with pads for soft material (printed) | Cutting beams and rod; holds a hull section while filing | Have | Bauhaus
121 | Wisent vise | 1 | Lab | Workbench | small · for parts ≤ 50 mm | Couplers, brackets, filing small parts | Have | Bauhaus
122 | Brennenstuhl power strip | 1 | Lab | Workbench | 16 A · switch(es) · surge protection (if it is this version) | Printer, lab supply, soldering iron, charger — on separate switches | Have | Bauhaus
123 | Work gloves | 1 | Lab | Safety | nitrile/latex for epoxy; heavy-duty for cutting | Cutting, filing, epoxy (Sikadur is a strong sensitiser — always with gloves) | Have | Bauhaus
124 | YIHUA 948DQ-I fume extractor (with third hand + 6 filters) | 1 | Lab | Safety | tilting fan · carbon filter + 6 spares · built-in third hand · EU plug | Leaded solder → fumes away from the face | Delivered | Amazon.de
125 | FLASLD LiPo safe bag 22 × 17 × 15 cm | 1 | Lab | Safety | fireproof, with an opening for the charger cable · 22 × 17 × 15 cm (both 3S 2200 mAh fit together) | Battery charging and storage | Delivered | Amazon.de
126 | Inflatable pool 2 m | 1 | Lab | Tests | Ø ~2 m · depth ≥ 40 cm (draft 42 + tracks) · ~1000 L · room ≥ 2.5 × 2.5 m · floor protection · the boat is 61 × 45 cm → there is room to turn | All water tests October–December; ramp (250 mm board + rubber) from the edge | To buy | eMAG
127 | NEEWER Magic Arm 22" with desk clamp | 1 | Lab | Filming | 56 cm · 1/4" and 3/8" · ~1.5 kg load · C-clamp for tabletops up to 5 cm | The phone above the table — overhead process shots, hands in frame | Delivered | Amazon.de
128 | ULANZI MT-79 tripod 204 cm | 1 | Lab | Filming | light stand 204 cm · 1/4" screw · no phone clamp (ST-02/ST-10 separate) · no remote | Overhead shot above the pool; with phone clamp and timer | Delivered | Amazon.de
129 | ULANZI VL49 LED light | 1 | Lab | Filming | 5500 K · CRI 95+ · 2000 mAh ~3 h · 1/4" + 3 cold shoe · aim at a white wall, not at the subject | Light for soldering and for the process photos | Delivered | Amazon.de
130 | iPhone | 1 | Lab | Filming | 4K 30 fps landscape · slo-mo for waves and impacts · timer · AirDrop to the laptop | All photos and video for the portfolio; proof for every closed loop | Have | Apple
131 | iCloud+ 2 TB | 1 | Lab | Filming | 2 TB · photos and video from iPhone · iCloud Drive visible on the laptop · folder link for sharing | AR-Mini/ in iCloud Drive: 00_Inbox → 01_Loops/L### … 07_Portfolio; link to each loop in the tracker | Subscription | Apple
132 | Phone clamp 1/4" (e.g. ULANZI ST-02) | 1 | Lab | Filming | 1/4" thread · for MT-79 and Magic Arm | iPhone on the tripod above the pool and on the arm above the table | To buy | Amazon.de
133 | Creality K2 Pro Combo | 1 | Lab | Manufacturing | 300 × 300 × 300 mm · enclosed chamber · RFID filament · CFS (multicolour) · PLA / PETG profiles | All printed parts; hull sections at 45° along the plate diagonal (291 / 300 mm) | Delivered | 3D Colour
134 | MacBook Pro 14" (2021) | 1 | Lab | Computers | Apple M1 Max · 64 GB · macOS Sequoia 15.7.4 | The main workstation: the repo, Cursor, OpenSCAD, Creality Print; the Claude desktop app linked to this project | Have | have
135 | Lenovo 21G2000PBM laptop | 1 | Lab | Computers | Intel Core Ultra 7 165H · 64 GB · NVIDIA RTX 500 Ada Laptop GPU 4 GB + Intel Arc Pro · 2 TB SSD · Windows 11 Pro 25H2 (x64) | Research simulations: Gazebo + ROS 2, NVIDIA Isaac Sim (the NVIDIA GPU); second machine next to the MacBook | Have | have
136 | Dremel 4000 rotary tool (kit with 225 flex shaft, 565 cutting guide, 678 line & circle cutter, accessory box) | 1 | Lab | Workbench | 175 W · 5,000–35,000 rpm · 3.2 mm collet · flex shaft for work in the vise · cut-off wheels, sanding drums, grinding and polishing bits in the box | Cutting the cable slot in the pivot brackets (C038); trimming supports and brim on PETG/PLA; cut-off wheel for the Ø5 rod and the 15 × 15 arch tube; deburring the printed holes | Have | have
137 | Dremel Workstation 220 | 1 | Lab | Workbench | drill-press stand for the rotary tool · vertical and tilted drilling · depth stop · slotted base with a scale · holds the tool horizontally for the flex shaft | Square holes in printed parts (the insert holes if a print closes them, the transom pad), the beam holes drilled true; the flex shaft hangs from it while cutting | Have | have
138 | Dremel Multi-Vise 2500 | 1 | Lab | Workbench | clamps to the table edge · ball joint: rotates 360°, tilts · jaws open ~100 mm · the jaws come off to hold the rotary tool as a bench grinder | Holds a pivot bracket while the slot is cut and the arch tube while it is sawn; third vise next to the Stanley and the Wisent | Have | have
139 | Digital hanging (luggage) scale, 50 kg / 10 g | 2 | Lab | Measuring | strain-gauge hanging scale · 50 kg range · 10 g steps · auto-hold on the display · strap loop (black) and hook (red) · check both on a 1 L water bottle first | Bollard-pull thrust of each thruster: scale in line with the tether in the tub (C025), read it live or film the display because of the auto-hold; the cradle lift force at the rod (servo stall check); weighing the whole boat hanging from the strap (target 4.7 kg) | Have | have
140 | Quick ratcheting bar clamp 12" / 300 mm | 1 | Mechanics | Tools | one-hand trigger · 300 mm opening · push button to release and slide the jaw · plastic jaw pads (non-marring) · fixed jaw probably reverses into a spreader (wing nut) | Clamps the Dremel Workstation 220 base and the wood blocks to the work stool while drilling; holds parts to the table edge while sawing, presses glued parts while the Pattex cures | Have | have
141 | Pebaro pyrography set (Brandmalen), tips + stamps | 1 | Mechanics | Tools | Art. 0261 · pen MT-30WBEU · 30 W · 230 V~ 50 Hz · NO temperature control (always full power, hotter than the 220–230 °C inserts need; not measured) · mains cable 2 × 0.5 mm² · wire stand · ~9 screw-in brass tips + extension · 9 brass stamps · craft-knife insert · for wood only, not on PETG/PLA (fumes) | Burning labels and the AR-Mini mark into the wood blocks/jigs (fume extractor on). Not for ruthex inserts on real parts: no temperature control → the plastic around the insert overheats; inserts stay on the HS-03 at 220 °C | Have | have
142 | Pine wood blocks | 4 | Mechanics | Materials | untreated pine/spruce · one measured 20.10: 172.81 × 38.41 × 24.36 mm (caliper; the other 3 look the same) · soft, takes pyrography and screws | Parallels on the Dremel Workstation 220 base (row 137): the part sits on two blocks so the bit exits into wood, not the aluminium; spacers under the hulls while gluing or curing | Have | have
143 | Plastic mop bucket with wringer basket | 1 | Lab | Tests | grey plastic · round · pour spout · steel handle · lift-out wringer basket on one side · volume TBD (fill it with a 1 L bottle and count) · keep the thruster clear of the basket | The bucket for the first thruster runs: ESC at 9 V with a 0.10 A limit (C006), then DevKit → ESC forward and reverse (C025); also the bollard-pull tether with the hanging scale (row 139) if it is deep enough | Have | have
144 | SN74AHCT125N quad buffer (DIP-14) | 5 | Electronics | ICs | 5 V supply (pin 14), GND pin 7 · TTL inputs: HIGH ≥ 2.0 V, so 3.3 V GPIO reads HIGH · 0/5 V push-pull out · OE active low (tie to GND) · N = DIP-14 · NOT 74HC125 (needs 3.5 V for HIGH at 5 V) | ESC signal level shifter (C006, 21.10: the ESC yellow wire idles at 4.983 V through a ~3.95 kΩ pull-up to 5 V). One chip drives both ESCs: breadboard (C025), perfboard (C031), rev B U6 (C032) + 2 spares | To buy
145 | DIP-14 IC socket | 3 | Electronics | ICs | 2.54 pitch · 7.62 row spacing · turned-pin or flat | Socket for the 74AHCT125 on the perfboard (C031) and rev B U6 (C032): the chip stays replaceable | To buy
146 | Brass M3 standoff kit, 240 pcs (Elimex 88692) | 1 | Electronics | Fasteners | brass hex standoffs, 20 pcs each: female–female M3 × 5 / 10 / 15 / 20 mm (DI5M3X05–X20) and male–female M3 × 5 / 10 / 15 / 20 mm (DA5M3X05–X20) · 40 × M3 × 5 screws · 40 × M3 nuts · "5" in the code is probably the 5 mm hex (caliper to confirm) · compartment box | Lifting the boards off the carrier and the deck: DevKit-Lipo, PCA9685, BNO055; stacking two boards with male–female. Pi 5 has M2.5 holes → not these | Have | Elimex
147 | Cotter pins DIN 94, 2 × 30, zinc (BMontage) | 16 | Mechanics | Fasteners | 2 packs × 8 · nominal 2 = for a Ø2.0 hole · 30 mm long · zinc-plated steel (rusts slowly in water; rinse after the pool) | Retaining the Ø5 hinge rod of the thruster kick-up (C042) and other pins: Ø2.0 cross-hole near the rod end, legs bent back — to confirm in the CAD | Have | have
148 | Cotter pins DIN 94, 3.2 × 40, zinc (BMontage) | 8 | Mechanics | Fasteners | 2 packs × 4 · nominal 3.2 = for a Ø3.2 hole · 40 mm long · zinc-plated steel | Spare / bigger pins only: a Ø3.2 hole in the Ø5 rod leaves 0.9 mm per side → too weak there | Have | have
149 | inventiv Métal HSS drill set ×5 (Ø 1 / 1.5 / 2 / 2.5 / 3 mm) | 1 | Mechanics | Tools | HSS · for steel, galvanised steel, aluminium · shank = drill Ø · the Dremel 4000 (row 136) needs the matching collet or a keyless chuck for shanks under 3.2 mm | Ø2.0 cross-holes for the 2 × 30 cotter pins; Ø2.5 = tapping drill for M3 in aluminium; pilot holes in the 15 × 15 beams before Ø4.5 | Have | have
150 | Bosch Metal HSS drill Ø1.5 mm (2 608 577 831) | 4 | Mechanics | Tools | 2 packs × 2 · 18 mm flute / 40 mm overall · the thinnest bit breaks first → spares | Pilot holes in aluminium and the Ø5 rod; spares for the Ø1.5 of the inventiv set | Have | have
151 | Countersunk screws DIN 965 M4 × 40, zinc, PH2 (BMontage) | 15 | Mechanics | Fasteners | Phillips PH2 · 90° countersunk head · zinc-plated steel · 40 mm long | M4 through the beams and the plate (row 1: Ø4.5 holes), head flush after countersinking — to confirm where | Have | have
152 | Hex nuts DIN 934 M4, stainless A2 (BMontage) | 40 | Mechanics | Fasteners | stainless A2/304 · 7 mm wrench · NOT self-locking → Loctite 243 (row 19) or a second nut | The nuts for the M4 × 40 (row 151); stainless for everything that gets wet | Have | have
153 | GTIWUNG servo extension cables T328, JR/Futaba 3-pin male–female, pack of 30 | 30 | Electronics | Cables | 3-pin 2.54 mm · male–female · 22 AWG, 60 strands · black/red/white = GND/+5 V/signal (Futaba colours) · lengths 10 / 15 / 30 / 50 / 60 cm (split per length not stated) · arrived 04.11.2026 | Extending the MG90S rudder and TD-8120MG lift servo leads to the PCA9685 / 74HCT125 without loose jumper wires at the breadboard (the 31.10 lake-test problem) | Delivered | Amazon
154 | M3 socket screw kit 1110 pcs, alloy steel, black | 1 | Mechanics | Fasteners | hex socket · black alloy steel (rusts in water → rinse, or stainless for wet parts) · M3 × 6 / 8 / 10: 55 pcs each · M3 × 16 / 18 / 20: 30 pcs each · M3 × 25 / 30 · 300 nuts · 300 washers · arrived 04.11.2026 | Fills the gap of row 16 (DSM stops at M3 × 20): M3 × 16/20 for the rudder frame and thruster bracket into ruthex inserts, M3 × 30 for the beam leg; spares for all brackets and lids | Delivered | Amazon
155 | LANUCN IP65 junction box 200 × 100 × 70 mm, black (LEU153) | 1 | Mechanics | Hull | ABS · IP65 · outer 200 × 100 × 70 mm · 4 corner lid screws · arrived 04.11.2026 · inner ≈ 94 × 192 mm at the rim, base depth ≈ 55 mm (ruler 05.11) · floor bosses for screws · came with M20×1.5 glands, terminal strips, Ø20 hole saw | C072 POWER box (replaces the taped food box 280 × 190 × 130): LiPo, 30 A inline fuse + XT60, S1 on the lid, 6-way fuse block, QIQIAZI + MZHOU bucks, GND bus, leak comb | Delivered | Amazon
156 | Elimex EXP-14 double-sided perfboard 100 × 90 mm | 1 | Electronics | Boards | green FR4 · plated through-holes both sides · 2.54 mm grid ≈ 30 × 36 pads with a blank ≈ 11 mm strip along one long edge · 4 factory corner holes ≈ 76.0 across × 90.1 along (caliper 06.11, confirm with the FIT template) · NOT cut, NOT drilled | C072 logic board: ONE board instead of P1 + P2 + P4 (layout C072_diagram_carrier_exp14); uses its own 4 holes on the logic-tray standoffs; carrier rev B gets the same outline + holes later | Have | Elimex
157 | Latching push button 19 mm, IP67 (KILL) | 1 | Electronics | Switches | Ø19 mm panel hole · latching (push on / push off) · IP67 front seal · contacts to choose: NO + NC or C/NO/NC (RUN / C / KILL) | C072: KILL on the logic-box lid → P1 J10 (GPIO14); replaces the rocker; later C069 hardware KILL through PCA9685 OE | To buy | to choose
158 | Battery disconnect switch (main power, 12 V / 30 A class) | 1 | Electronics | Switches | must carry the 30 A fuse current · panel mount · sealed (IP65+) · model to choose | C072 power box: main disconnect next to the LiPo / 30 A fuse, so the battery can be isolated without opening XT60 | To buy | to choose
159 | USB-C 90° angled adapter / cable end | 1 | Electronics | Cables | male USB-C → female USB-C, right angle (90°) · data not needed, 5 V / 3 A | C072: MZHOU 5 V → DevKit USB-C; the DevKit USB face sits ≈ 31 mm from the logic-box port wall, a straight plug + strain relief does not bend in time | To buy | to choose
160 | Preciva 992D+ soldering station + hot-air rework station (2-in-1) | 1 | Electronics | Soldering | mains-powered bench station · soldering iron with stand, brass-wool tip cleaner and sponge · hot-air gun with holder and auto-sleep when docked · separate HOT AIR and SOLDERING switches and ▲▼ set buttons · AIR knob MIN–MAX · 3 presets CH1–CH3 · MENU/COOL · brushless fan · ESD-safe · arrived 09.11.2026 · wattage and temperature range to read from the manual/label | Bench iron for the C072 EXP-14 logic board and all 14 AWG / XT60 joints (the HS-03 of row 35 stays the portable iron); hot air for heat-shrink (row 46) and SMD rework on the carrier rev B | Delivered | Amazon
161 | Cuifati 560 KV underwater thruster (replacement for the defective right one) | 1 | Mechanics | Drive | same model as row 28 · ESC inside, 4 wires: red +12 V, black GND, yellow PWM signal, white signal GND · arrived 09.11.2026 · not bench-tested yet (remote_pool, 12.0 V / 2.5 A limit, 1600 → ≈0.22 A, 1650 → ≈0.58 A) | Replaces the right thruster of row 28 that fails since 24.10 (FAILS 173, C055); drops into the same bracket and 74HCT125 1Y signal path | Delivered | Amazon
 | Status: Have / Delivered = on the table · Ordered = ordered, not shipped yet · Dispatch = in transit · To buy · Printing = from the printer. Specs column: only the parameters that affect the project.
 | Type: Mechanics / Electronics / Software / Lab (filter on row 1). Status: Have / Delivered / Installed = done · Dispatch = in transit · To buy / To install · Printing. Subscription = paid and active · Using = in use. Check at home = we probably have it.
