TKyoseva/ARmini/docs/bom/AR-Mini_BOM_visual_v3.pdf

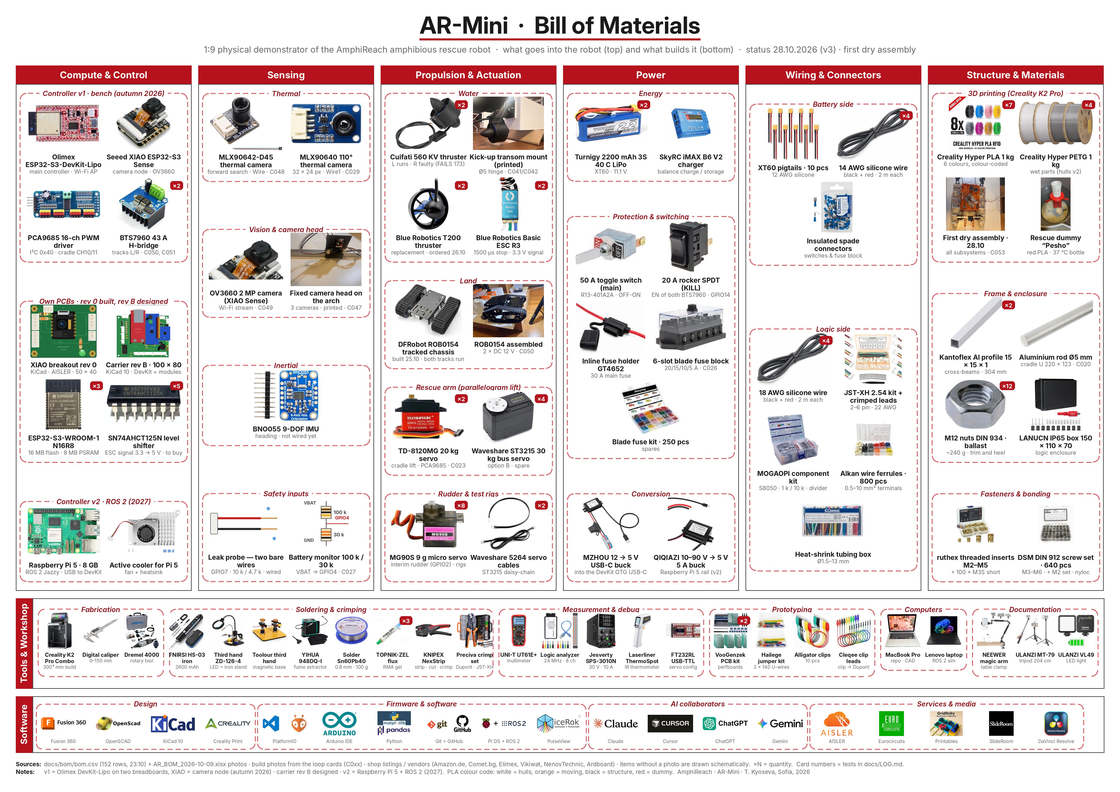
[picture p56: page 1]
