TKyoseva/ARmini/docs/bom/history/2026-10-06_AR-Mini_BOM_visual_v1.pdf

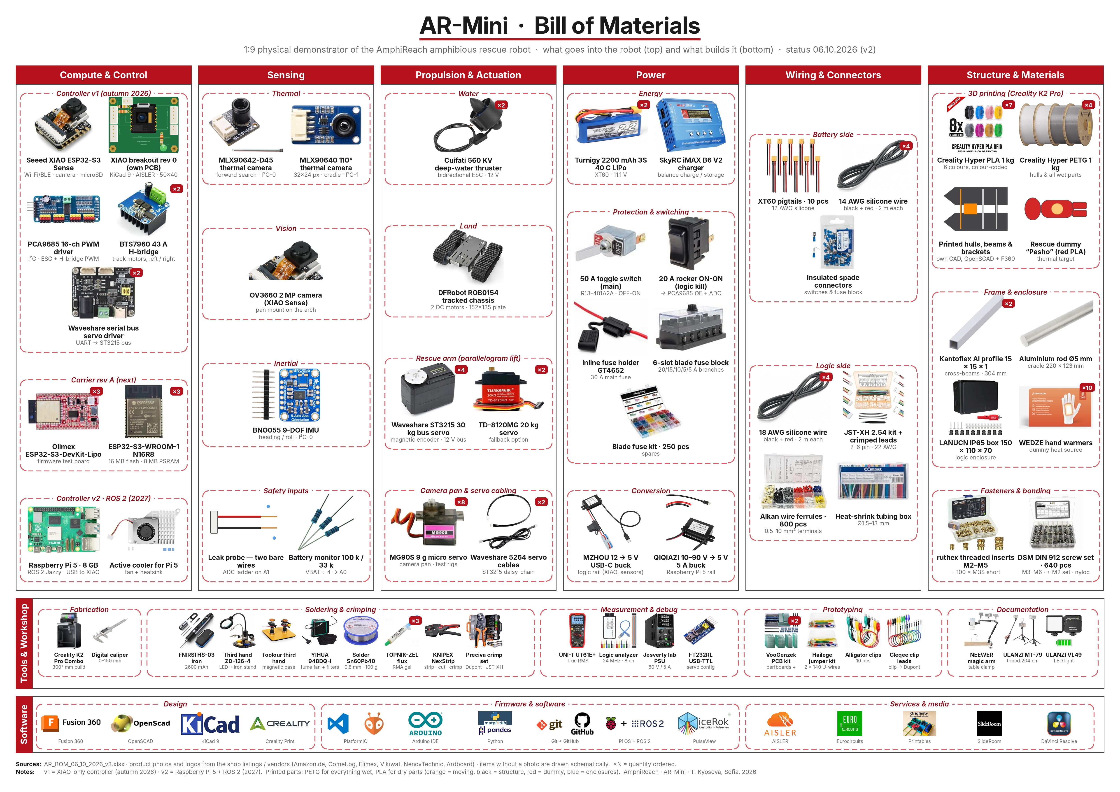
[picture p57: page 1]
