TKyoseva/ARmini/docs/bom/history/2026-10-09_AR-Mini_BOM_visual_v2.pdf

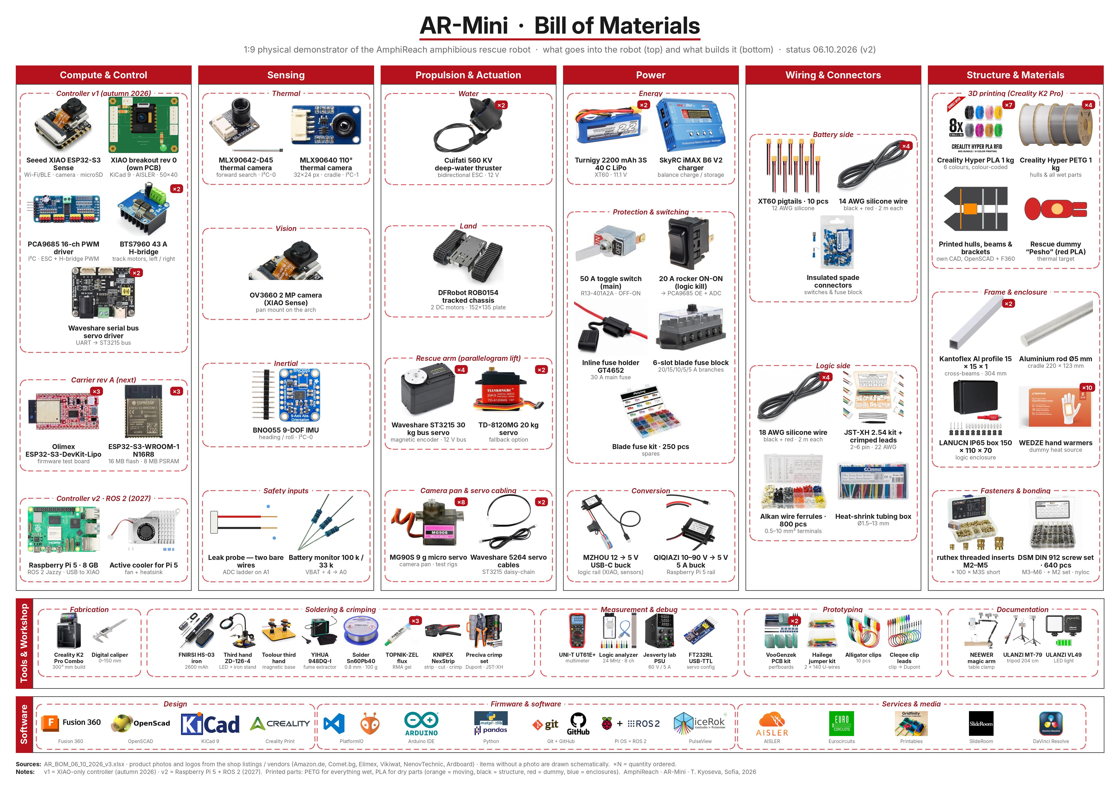
[picture p58: page 1]
