TKyoseva/ARmini/docs/bom/src/photos/basic_esc.png

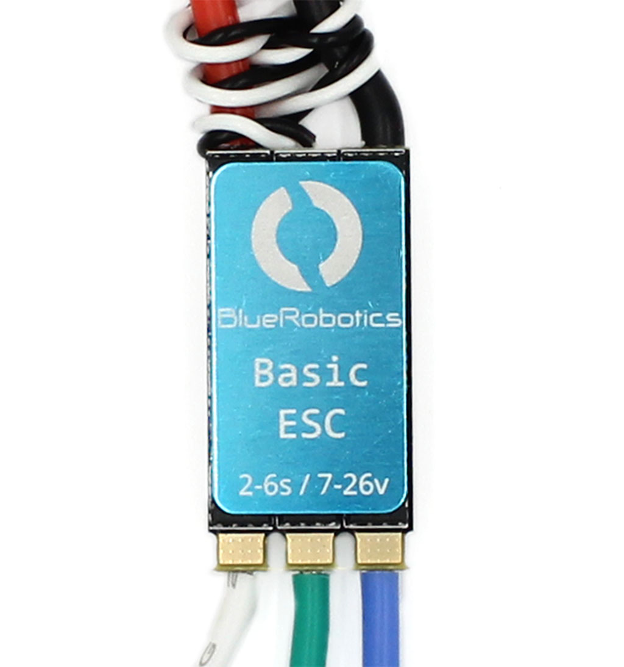
docs/bom/src/photos/basic_esc.png
