TKyoseva/ARmini/docs/bom/src/photos/dremel4000.png

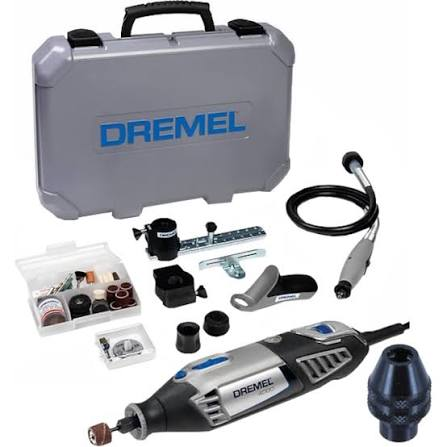
docs/bom/src/photos/dremel4000.png
