TKyoseva/ARmini/docs/bom/src/photos/lenovo.png

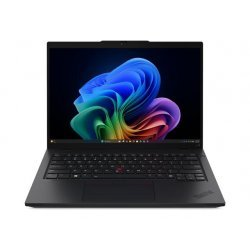
docs/bom/src/photos/lenovo.png
