TKyoseva/ARmini/docs/bom/src/photos/macbook.png

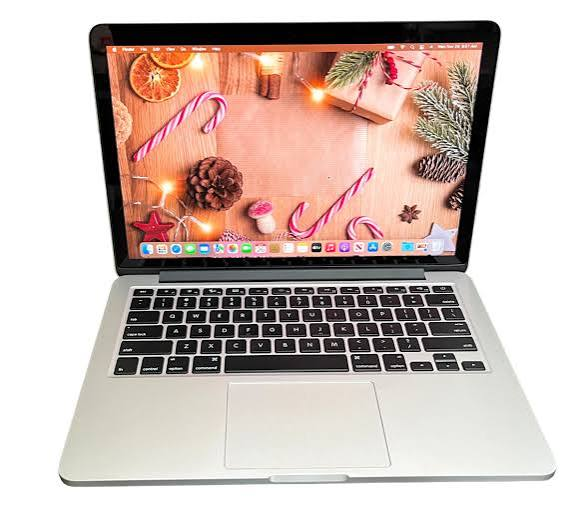
docs/bom/src/photos/macbook.png
