TKyoseva/ARmini/docs/bom/src/photos/sn74ahct125n.png

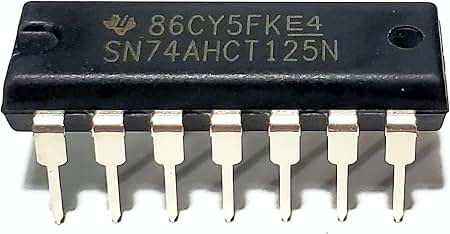
docs/bom/src/photos/sn74ahct125n.png
