TKyoseva/ARmini/docs/bom/src/photos/t200.png

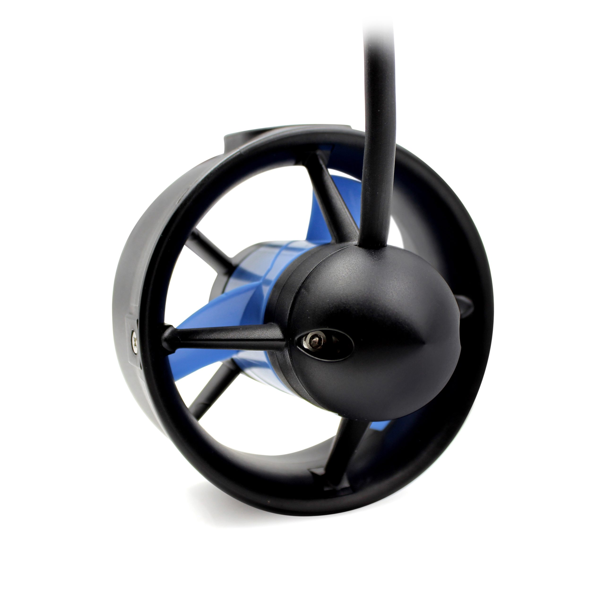
docs/bom/src/photos/t200.png
