TKyoseva/ARmini/cad/printed/AR-Mini_printed_parts.step

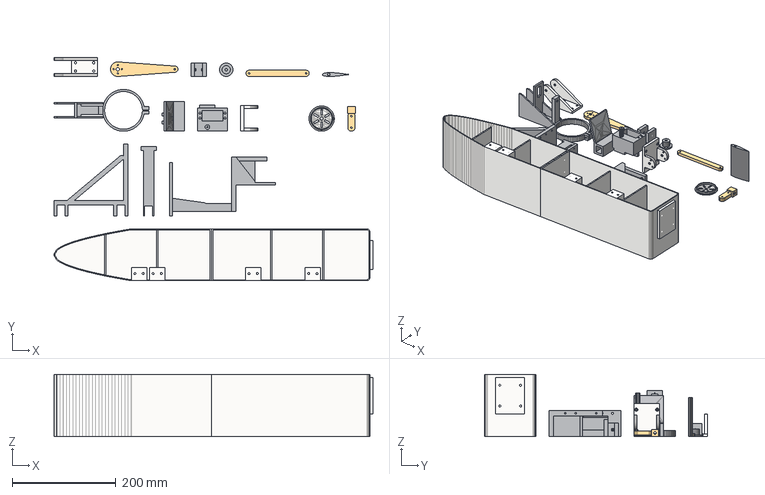
[picture p65: CAD file, 2026-11-01]
cad/printed/AR-Mini_printed_parts.step
615.0 x 430.8 x 120.0 mm
