TKyoseva/ARmini/cad/stl/v1/rudder_mount.stl

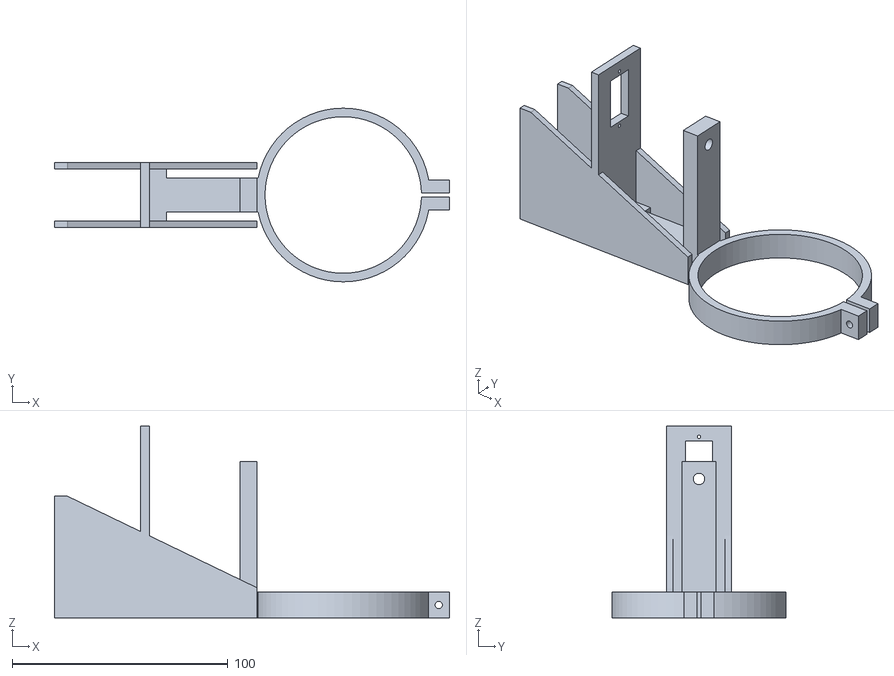
[picture p66: CAD file, 2026-11-01]
cad/stl/v1/rudder_mount.stl
183.3 x 80.6 x 89.0
