TKyoseva/ARmini/cad/stl/v1/rudder_hub.stl

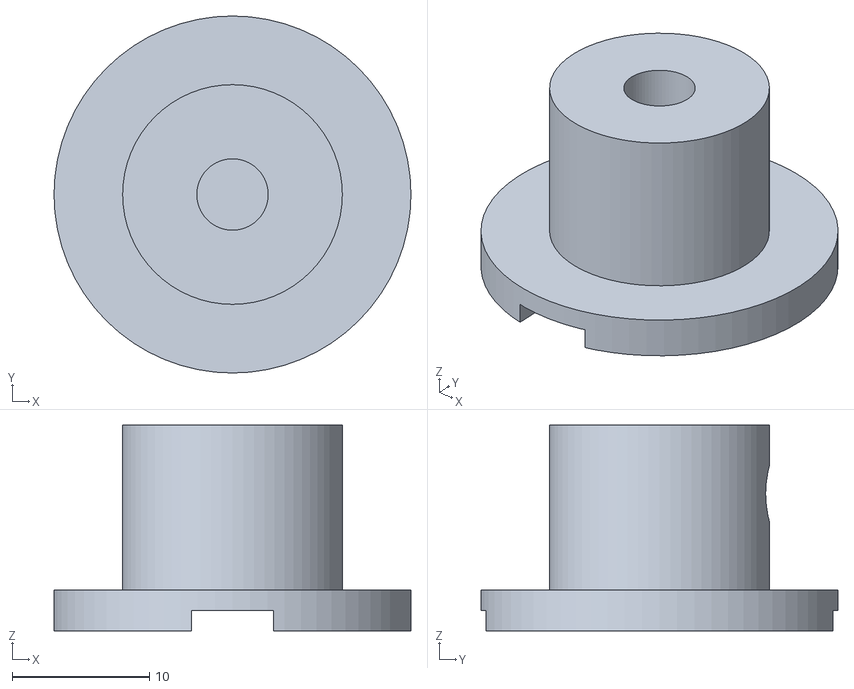
[picture p67: CAD file, 2026-11-01]
cad/stl/v1/rudder_hub.stl
26.0 x 26.0 x 15.0
