TKyoseva/ARmini/cad/stl/v1/rudder_frame.stl

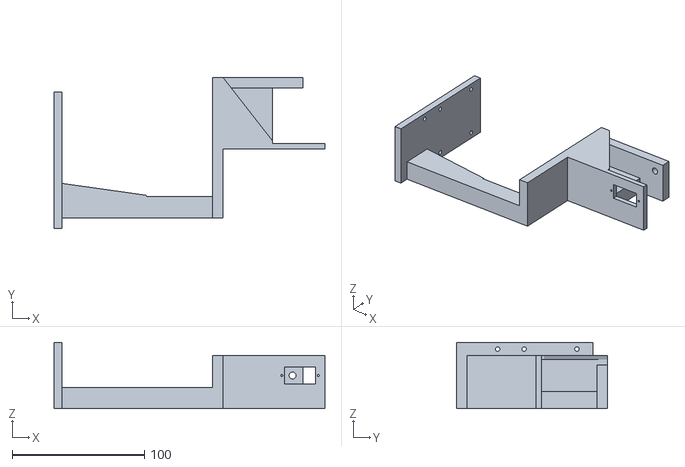
[picture p68: CAD file, 2026-11-01]
cad/stl/v1/rudder_frame.stl
205.1 x 114.0 x 50.0
