TKyoseva/ARmini/cad/stl/v1/beam_bracket.stl

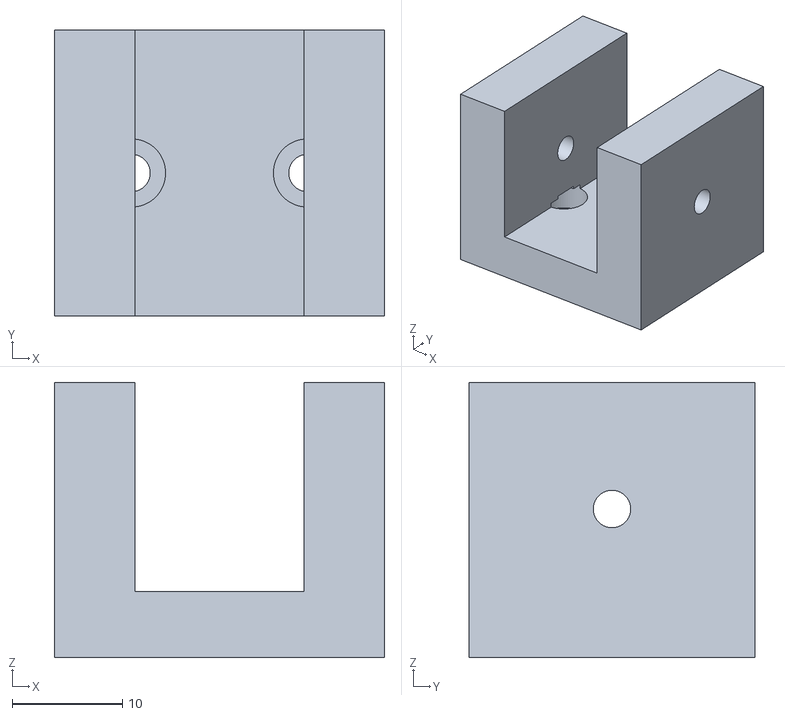
[picture p69: CAD file, 2026-11-01]
cad/stl/v1/beam_bracket.stl
30.0 x 26.0 x 25.0
