TKyoseva/ARmini/cad/stl/v1/rudder_blade.stl

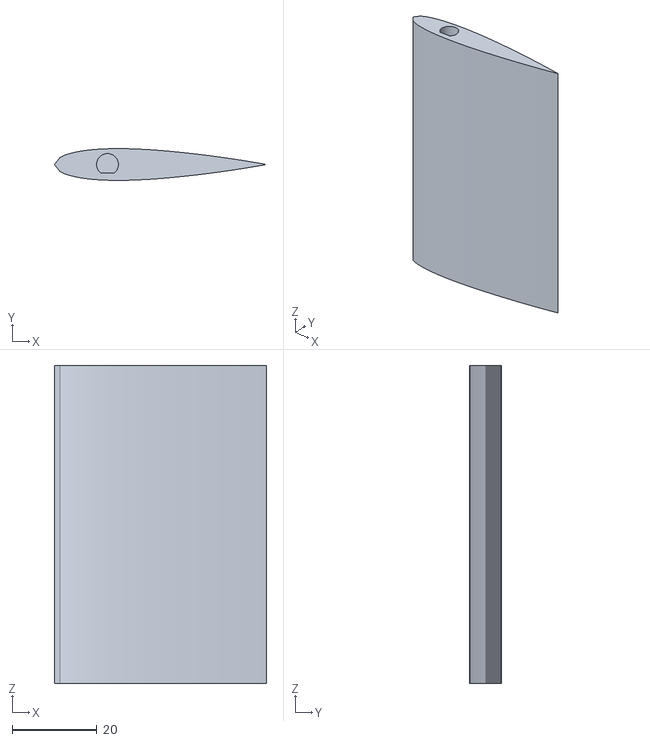
[picture p70: CAD file, 2026-11-01]
cad/stl/v1/rudder_blade.stl
50.0 x 7.50 x 75.0
