TKyoseva/ARmini/cad/stl/v1/cam_fixed_mount.stl

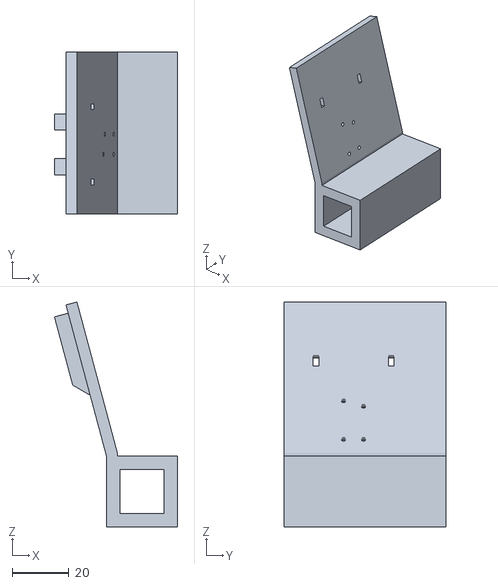
[picture p71: CAD file, 2026-11-01]
cad/stl/v1/cam_fixed_mount.stl
43.2 x 57.0 x 79.0
