TKyoseva/ARmini/cad/stl/v1/beam_leg.stl

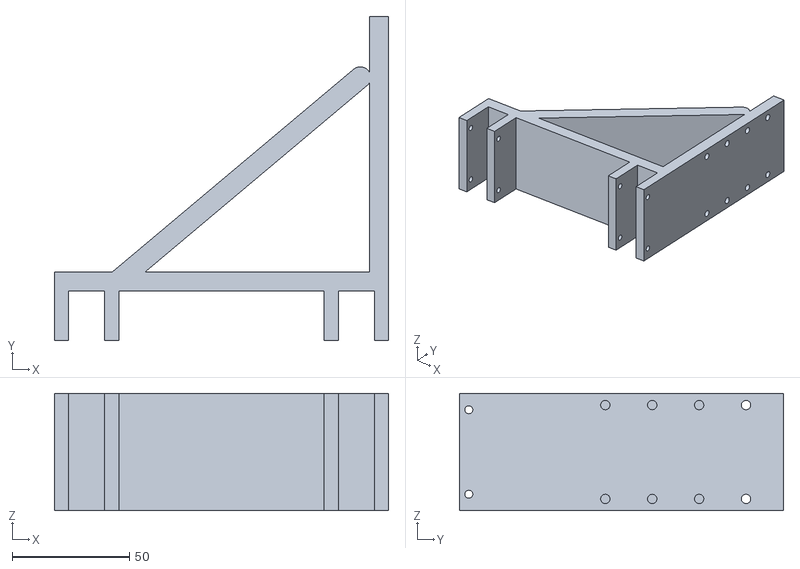
[picture p72: CAD file, 2026-11-01]
cad/stl/v1/beam_leg.stl
142.4 x 138.2 x 50.0
