TKyoseva/ARmini/cad/stl/v1/thruster_coupon.stl

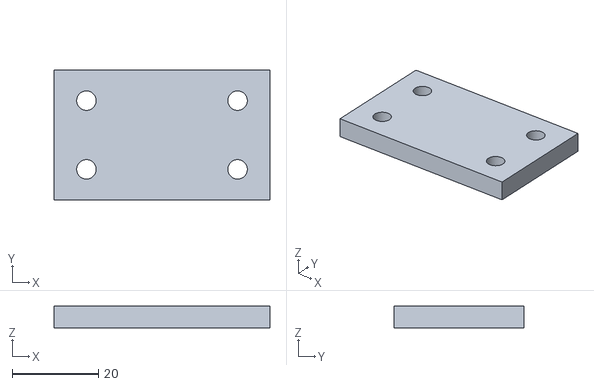
[picture p73: CAD file, 2026-10-18]
cad/stl/v1/thruster_coupon.stl
50.0 x 30.0 x 5.00
