TKyoseva/ARmini/cad/stl/v1/coupler.stl

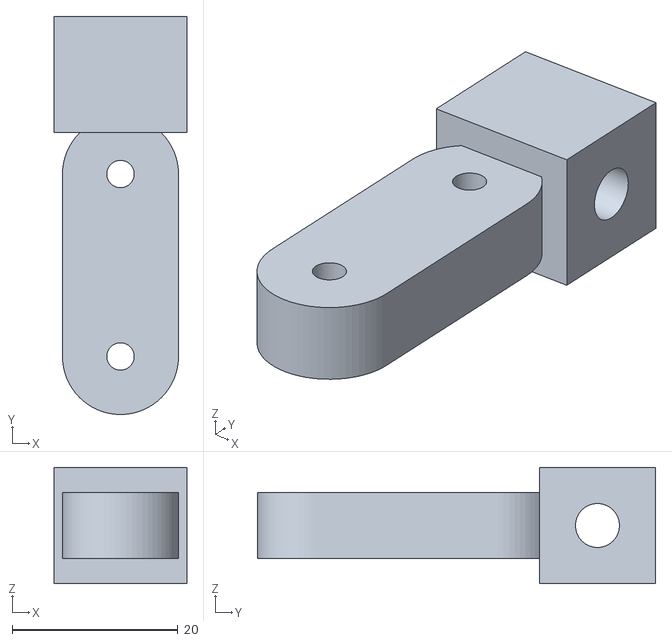
[picture p74: CAD file, 2026-10-18]
cad/stl/v1/coupler.stl
16.0 x 48.0 x 14.0
