TKyoseva/ARmini/cad/stl/v1/pivot_bracket.stl

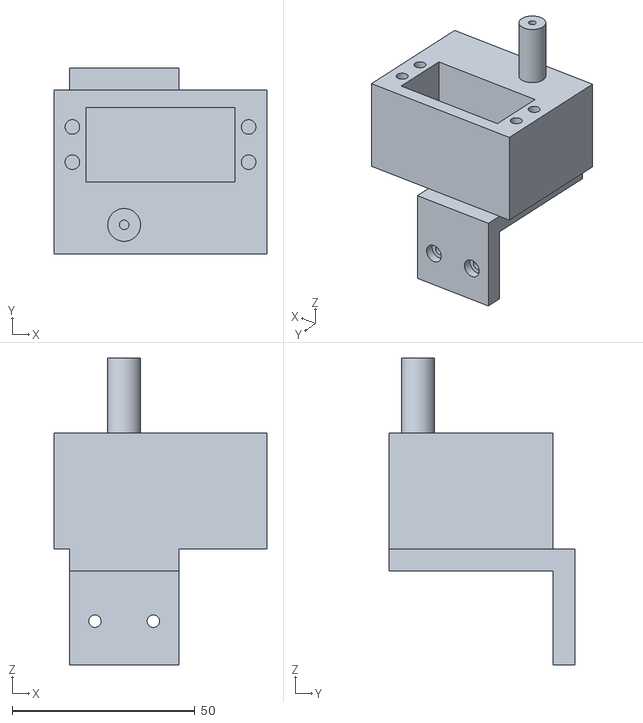
[picture p75: CAD file, 2026-10-18]
cad/stl/v1/pivot_bracket.stl
58.3 x 51.0 x 84.1
