TKyoseva/ARmini/cad/stl/v1/thruster_bracket.stl

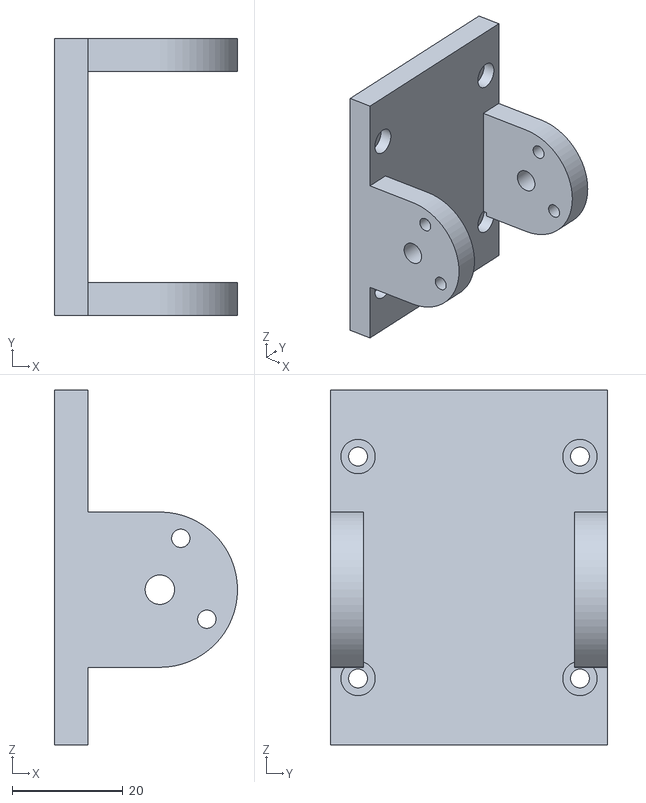
[picture p76: CAD file, 2026-10-18]
cad/stl/v1/thruster_bracket.stl
33.0 x 50.0 x 64.0
