TKyoseva/ARmini/cad/stl/v1/hull_fore.stl

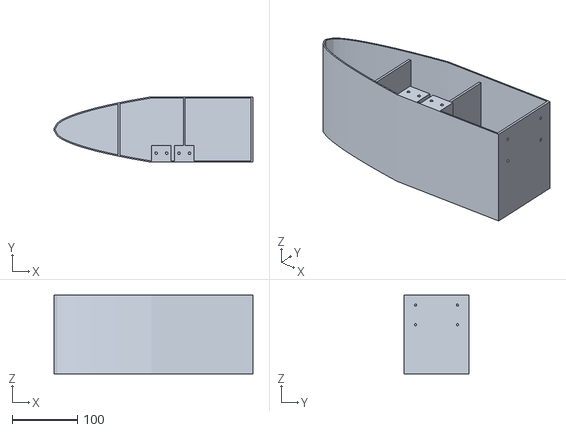
[picture p77: CAD file, 2026-10-18]
cad/stl/v1/hull_fore.stl
304.0 x 100.0 x 120.0
