TKyoseva/ARmini/cad/stl/v1/arch_post.stl

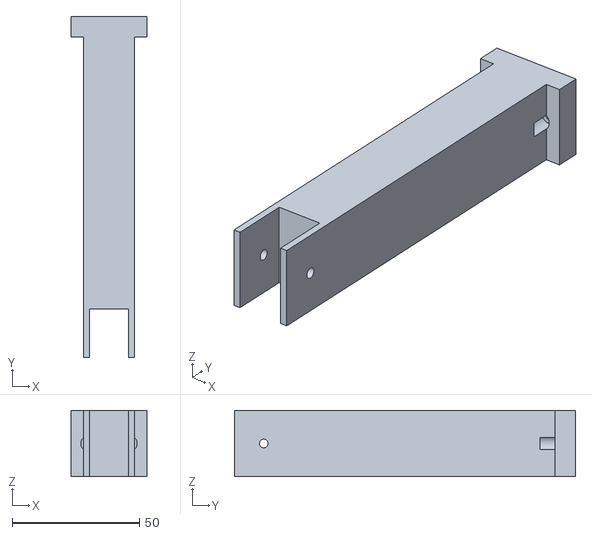
[picture p78: CAD file, 2026-10-18]
cad/stl/v1/arch_post.stl
30.0 x 134.0 x 26.0
