TKyoseva/ARmini/cad/stl/v1/hull_aft.stl

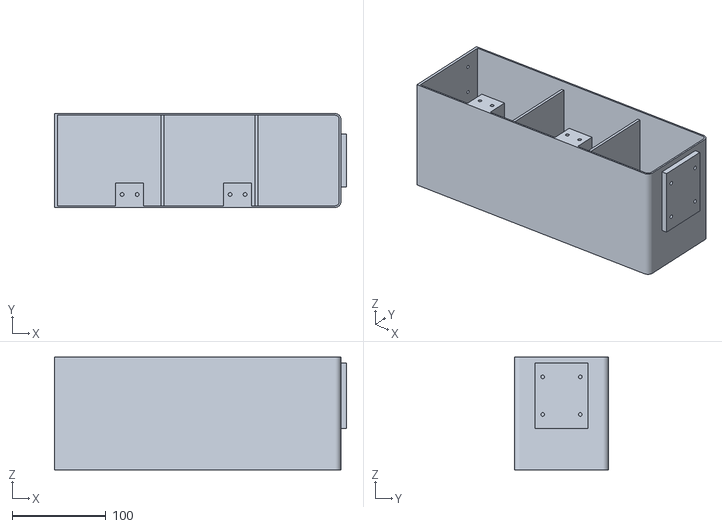
[picture p79: CAD file, 2026-10-18]
cad/stl/v1/hull_aft.stl
311.0 x 100.0 x 120.0
