TKyoseva/ARmini/cad/stl/v1/arm_drive.stl

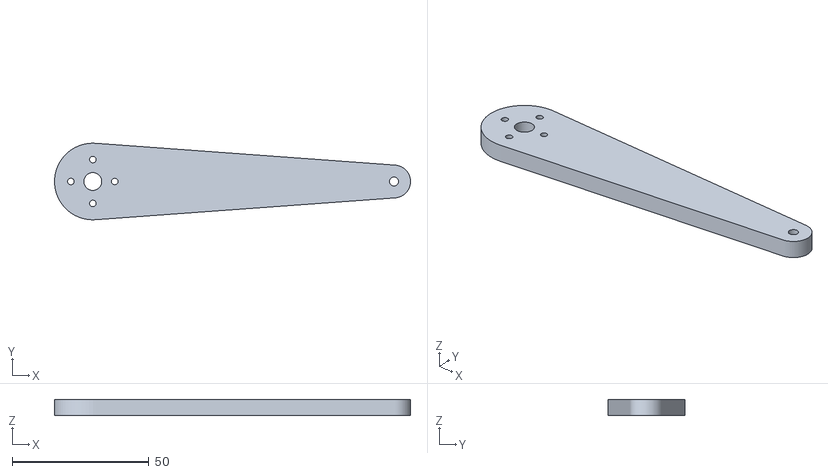
[picture p80: CAD file, 2026-10-18]
cad/stl/v1/arm_drive.stl
130.0 x 28.0 x 6.00
