TKyoseva/ARmini/cad/stl/v1/thruster_arm.stl

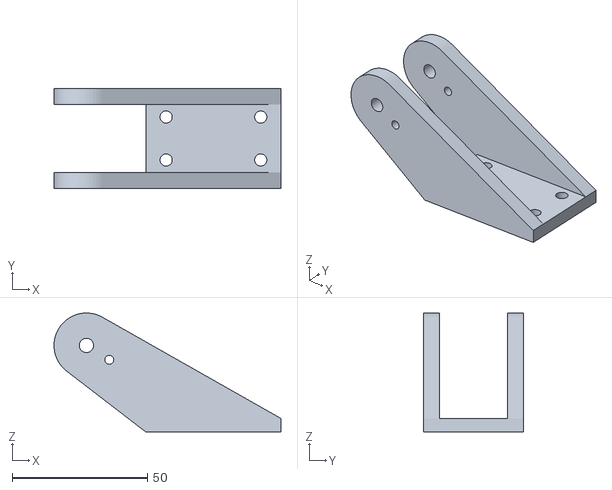
[picture p81: CAD file, 2026-10-18]
cad/stl/v1/thruster_arm.stl
84.0 x 37.0 x 44.0
