TKyoseva/ARmini/cad/stl/v1/arm_idler.stl

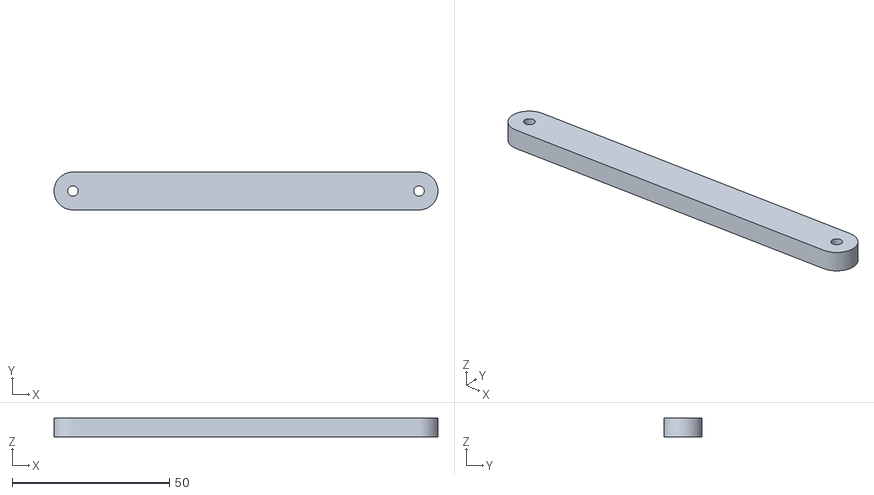
[picture p82: CAD file, 2026-10-18]
cad/stl/v1/arm_idler.stl
122.0 x 12.0 x 6.00
