TKyoseva/ARmini/cad/openscad/interfaces.scad

// GENERATED from interfaces/interfaces.json by scripts/sync_interfaces.py. Do not edit.
if_power_box_outer = [152, 135, 66];
if_power_box_wall = undef;
if_power_box_z_on_beams = 141;
if_carrier_pcb_outline = [undef, undef];
if_carrier_pcb_thickness = 1.6;
if_carrier_pcb_mount_holes = [];
if_carrier_pcb_mount_hole_d = 3.2;
if_devkit_lipo_board = [undef, undef];
if_devkit_lipo_usb_c_edge = "to measure";
if_bts7960_board = [undef, undef];
if_bts7960_mount_holes = [];
