TKyoseva/ARmini/(list of files, cad)

Other CAD files:
cad/printed/AR-Mini_printed_parts.3mf
