TKyoseva/ARmini/docs/process/AR-Mini_build_process_architecture.pdf

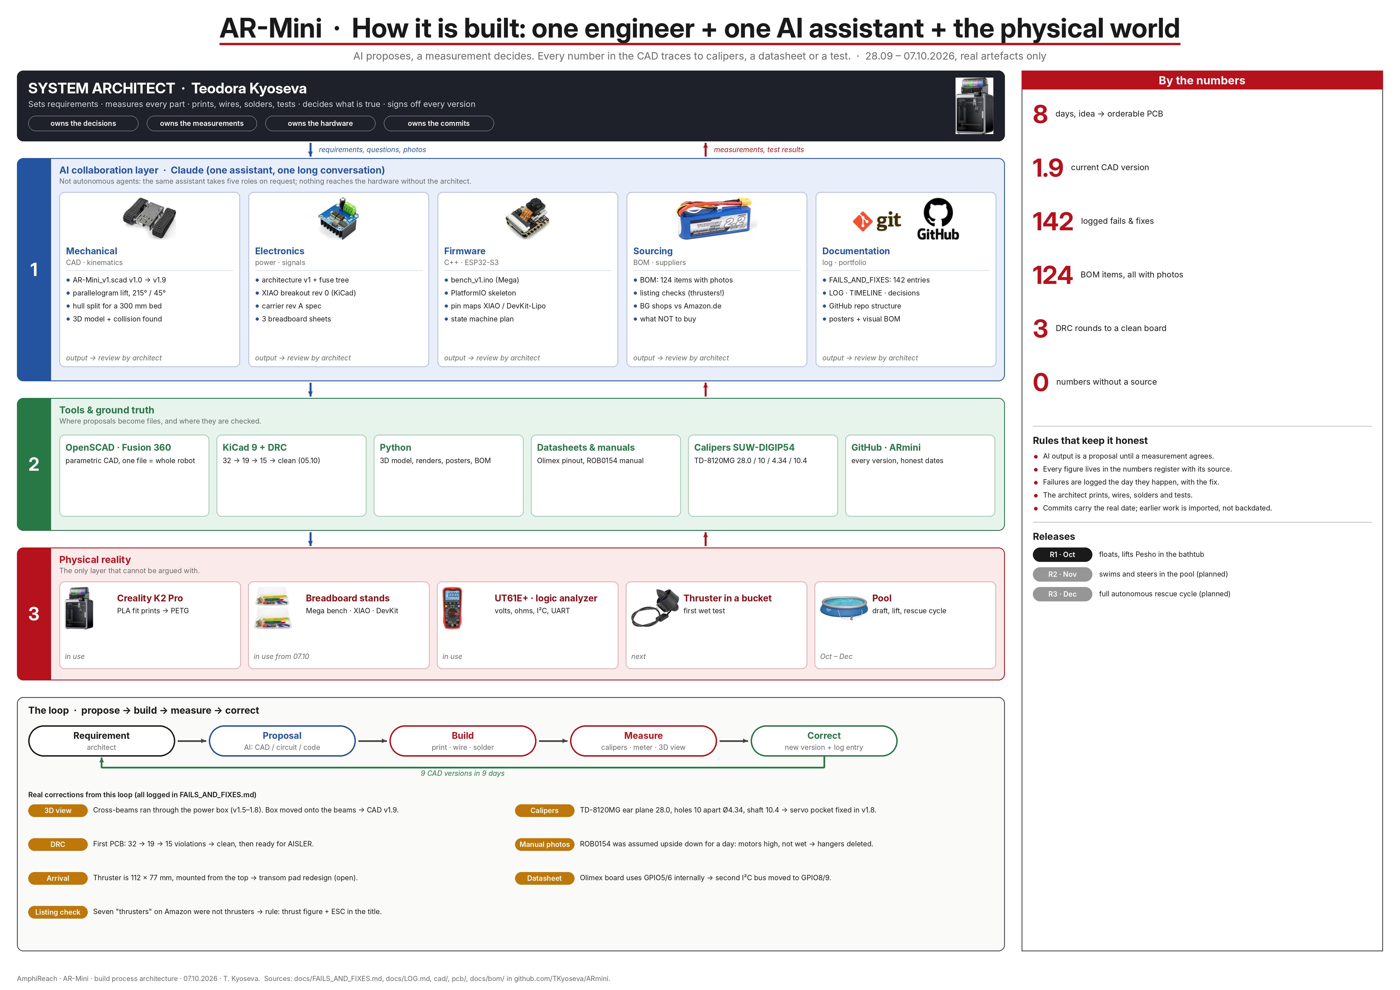
[picture p83: page 1]
