TKyoseva/ARmini/docs/process/AR-Mini_setup_v3.pdf

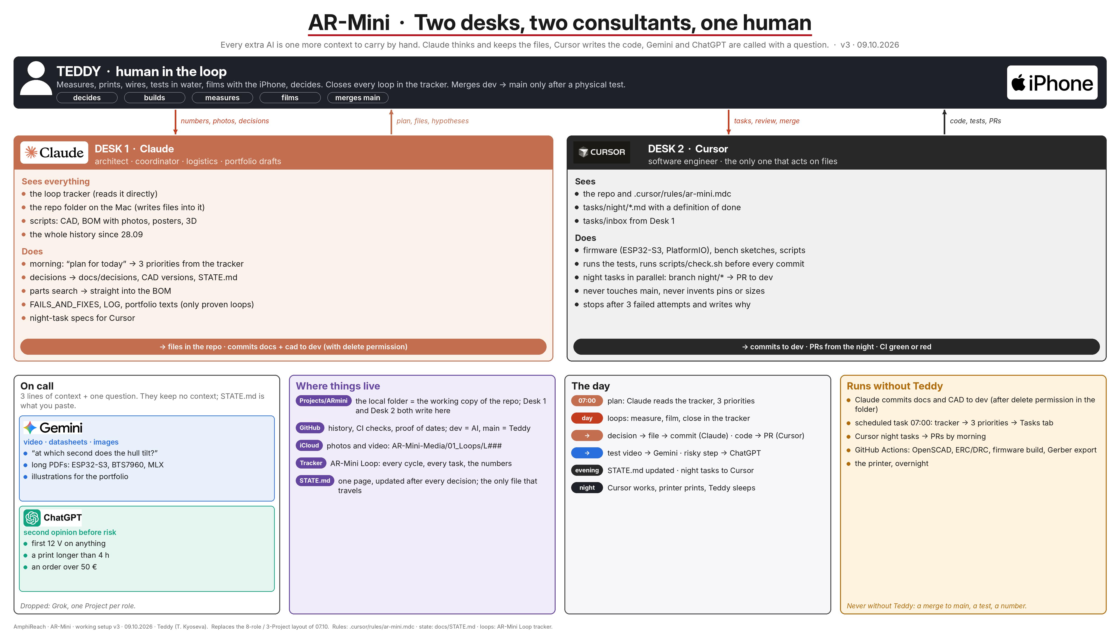
[picture p84: page 1]
