TKyoseva/ARmini/hardware/breadboard/AR-Mini_breadboard_2b_ladder-step.png

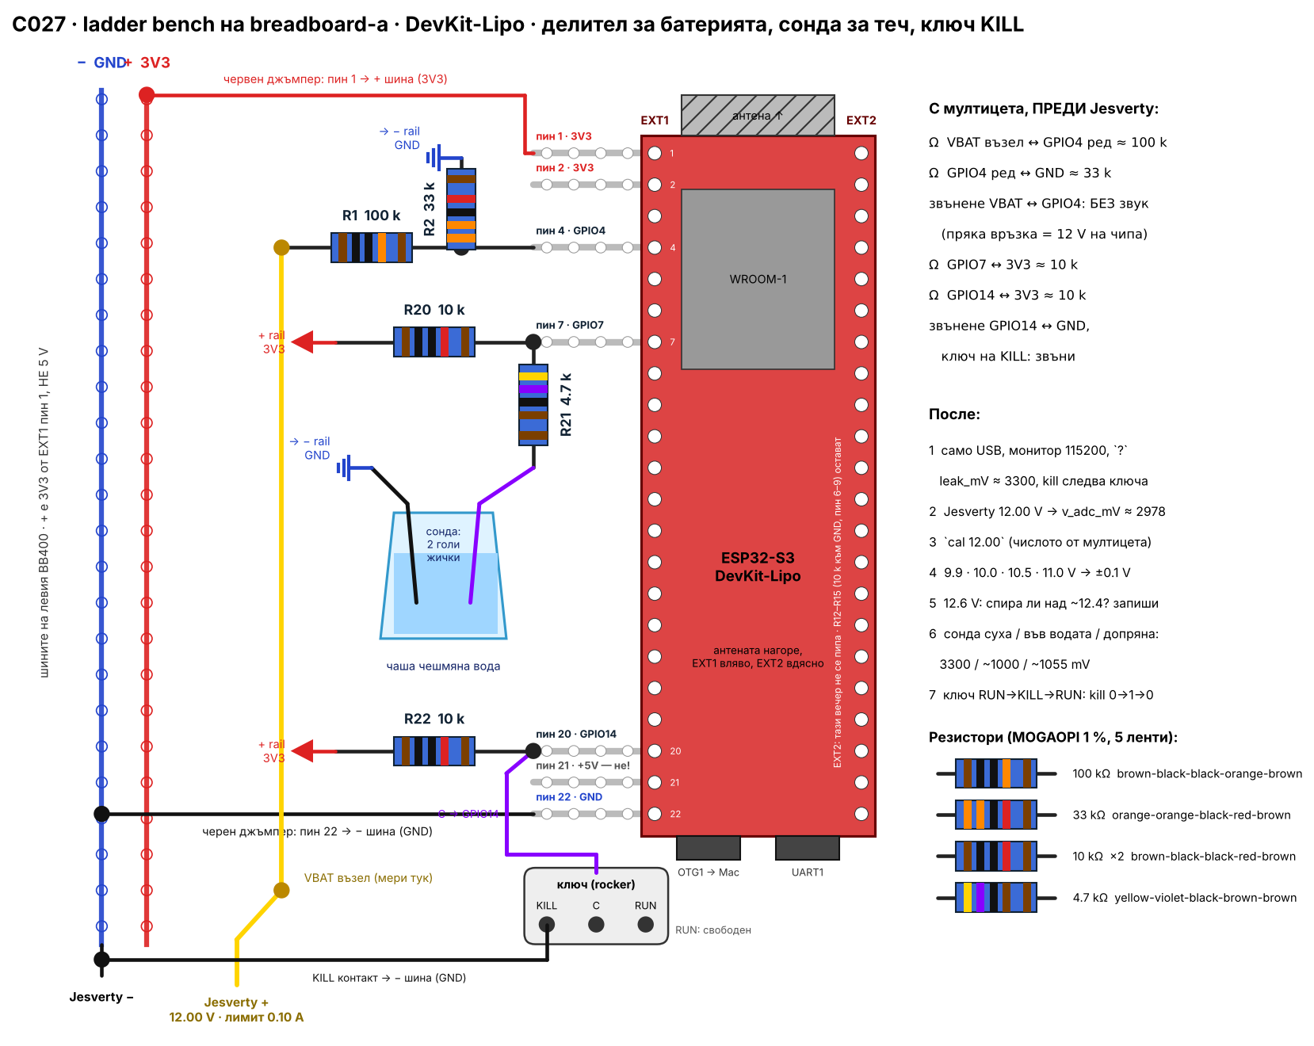
hardware/breadboard/AR-Mini_breadboard_2b_ladder-step.png
