TKyoseva/ARmini/hardware/breadboard/Olimex_DevKit-Lipo_pinout_manual-p7.png

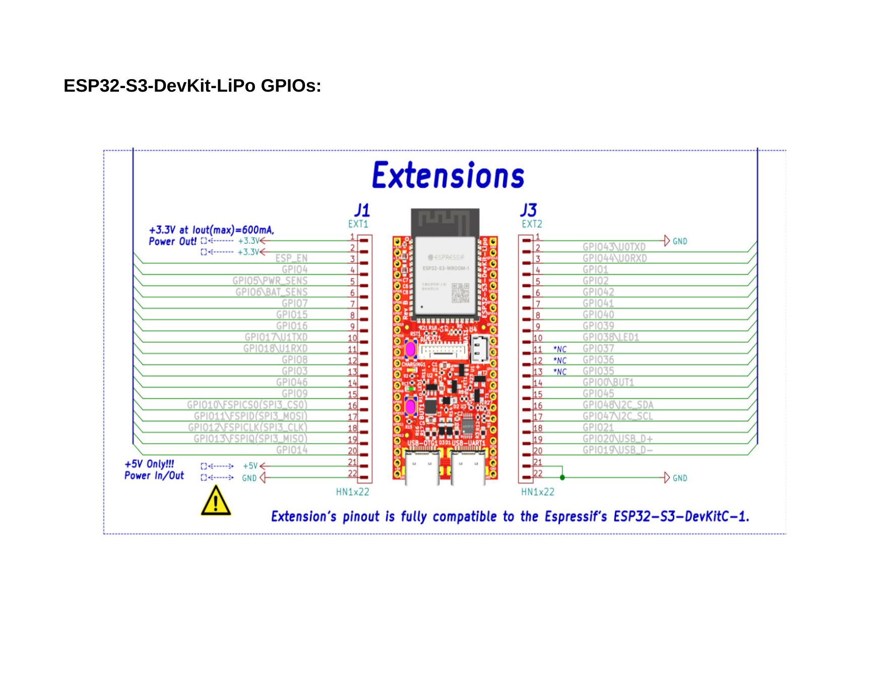
hardware/breadboard/Olimex_DevKit-Lipo_pinout_manual-p7.png
