TKyoseva/ARmini/pcb/carrier-revB/AR-Mini_carrier_revB_assembled.png

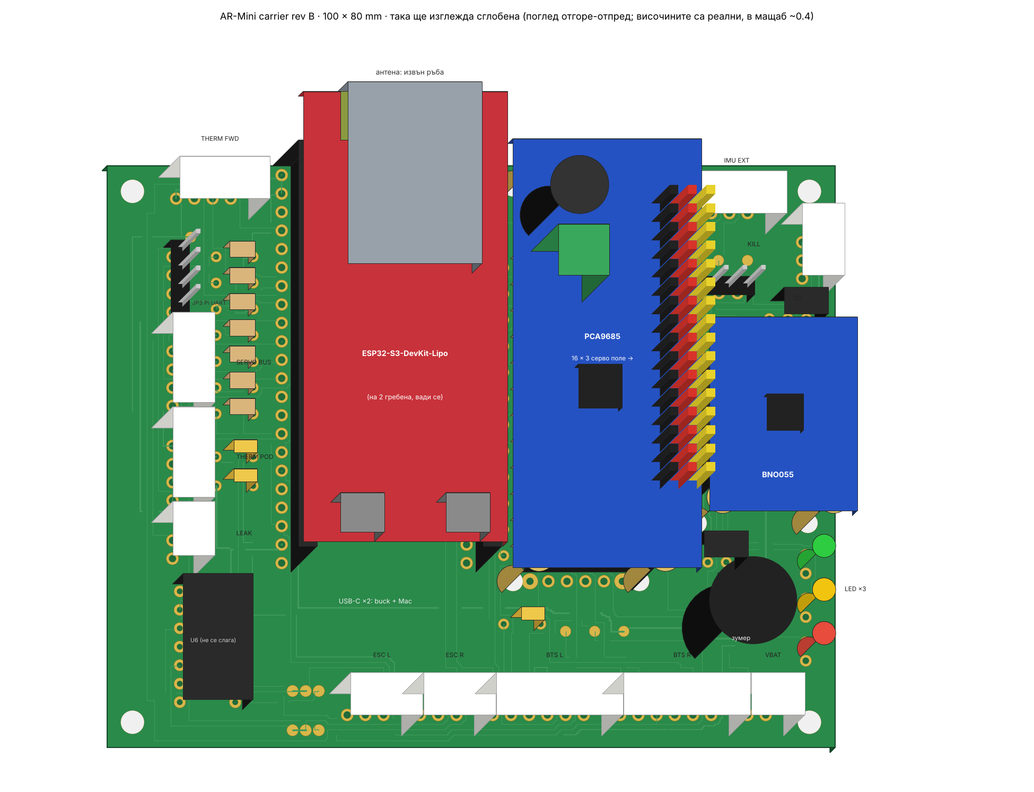
pcb/carrier-revB/AR-Mini_carrier_revB_assembled.png
