TKyoseva/ARmini/pcb/xiao-breakout-rev0/AR-Mini_xiao_breakout_rev0_assembled.png

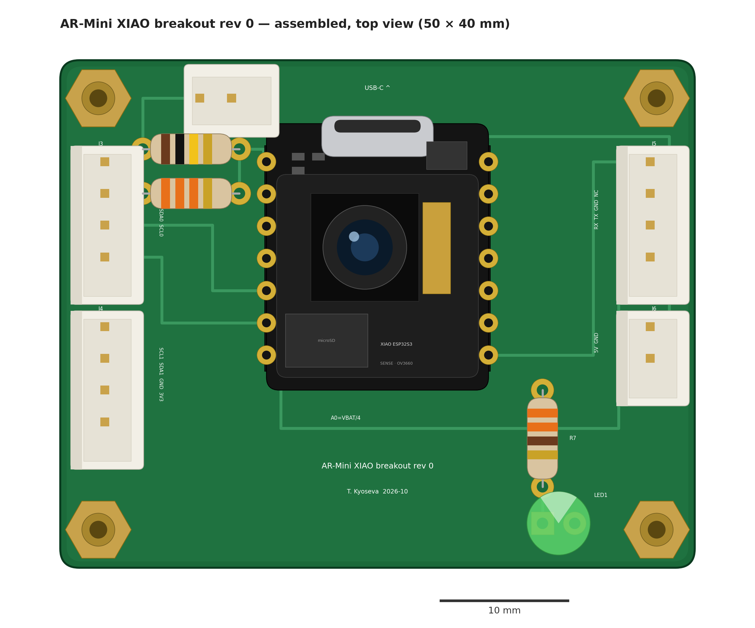
pcb/xiao-breakout-rev0/AR-Mini_xiao_breakout_rev0_assembled.png
