TKyoseva/ARmini/pcb/carrier-revB/measure/U2_PCA9685_measure.png

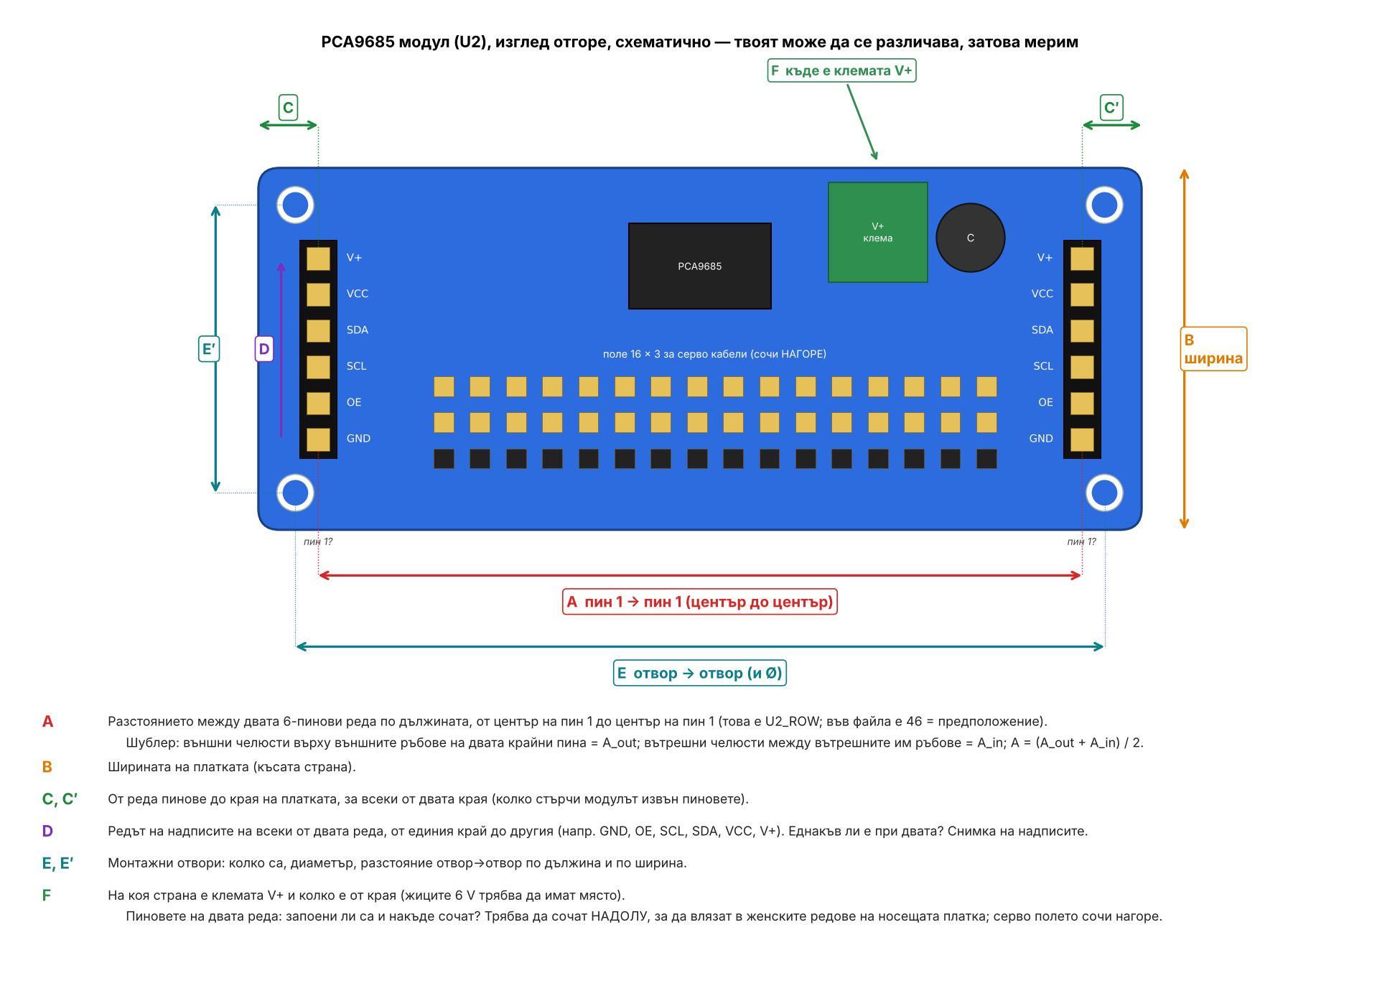
pcb/carrier-revB/measure/U2_PCA9685_measure.png
