TKyoseva/ARmini/tools/video/tests/fixtures/media/C001_2026-10-08_thruster-measure/C001_01.PNG

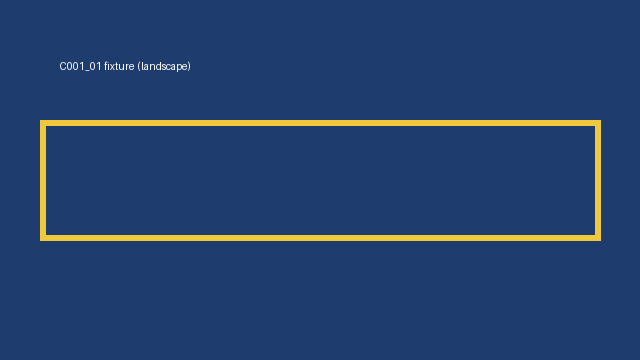
tools/video/tests/fixtures/media/C001_2026-10-08_thruster-measure/C001_01.PNG
