TKyoseva/ARmini/docs/bom/history/README.md

# docs/bom/history

`2026-10-06_AR-Mini_BOM_visual_v1.pdf` — the first visual BOM poster (06.10), superseded by v2 on 09.10 (English, the arrivals of 12–13.10 not yet in it). The spreadsheet history (`AR_BOM_04_10 … 07_10_v4.xlsx`) is not in git: the diff-friendly `../bom.csv` carries every row, the xlsx of 09.10 is the last full one.

`2026-10-09_AR-Mini_BOM_visual_v2.png` / `.pdf` — the second visual BOM (09.10, English), superseded by `../AR-Mini_BOM_visual_v3.pdf` on 28.10 (DevKit-Lipo as controller, own PCBs, first dry assembly C053, right Cuifati marked faulty, T200 + Basic ESC).
