TKyoseva/ARmini/data/board/history/README.md

# data/board/history

Older exports of the board, one per release or per structural change of the board itself. `board_2026-10-11.json` = the R1a export (12 cards, no goals, no analyses).
