TKyoseva/ARmini/docs/diagrams/history/README.md

# docs/diagrams/history

`2026-09-29_AR-Mini_v1_layout_BG.png` — the first drawing of AR-Mini (side + top, mm): 610 mm hulls, gap 240, ROB0154 300 × 230 between the beams, parallelogram arm with the ST3215, mast with the thermal camera, waterline at 42 mm, Pesho 20 cm. Drawn the day after "a dog that became a boat". Several numbers changed later (gap 250, beam 450, arm on TD-8120MG first); the shape did not.
