TKyoseva/ARmini/pcb/carrier-revB/history/README.md

# pcb/carrier-revB/history

`2026-10-13_U2-54.26_failed-paper-check.kicad_pcb` — the board as generated on 13.10 with the PCA9685 rows 54.26 mm apart (holes 54.26 × 17.36). DRC-clean, 1:1-printed, and wrong: real pins missed the pads by ~0.8 mm per end on 15.10. The measurement error and the rule that came out of it are FAILS 152; the fixed board (55.88 × 19.05, Ø3.0 standoff holes) is the file one level up. Kept as evidence, not for ordering.
