TKyoseva/ARmini/tools/board/history/2026-10-09_ar-mini-loop_v1.html

# AR-Mini Board

backlog → today → done → release

–days to 1 Nov

Board Backlog Today Done Releases

## Backlog

Card Expected number (if it is a test) Note

AddAdd to Today

## Today

## Done

Enough to show? Cut a release from everything here.Release ▾

Release

Name Goal

CutCancel

0releases

0cards done

–median time

0last 7 days

## Releases

Export JSON+ target

Name Target date

Goal

SaveCancel

Target dates are a guide. A release is cut from Done when there is something to show.

## Cards done per day

## Time from Today to Done, hours
