TKyoseva/ARmini/docs/process/history/README.md

# docs/process/history — superseded process posters

Kept because the portfolio tells how the way of working changed, not only what was built.

| File | Replaced by | Why |
|---|---|---|
| `2026-10-07_AR-Mini_team3_agents_v1.*` | `AR-Mini_human_in_the_loop_v1.*` | the plan with three friends in named roles → one builder, AI agents in the roles, human in the loop (decision 07.10) |
| `2026-10-07_AR-Mini_structure_v1.pdf/png` | `AR-Mini_structure_v2.*` | repo structure before the firmware/bench and tools/ folders existed |
| `2026-10-08_AR-Mini_lab_protocol_v1_A3.*` | `AR-Mini_lab_protocol_v2_A3.*` | v1 had no card IDs on the bench sheet and no iCloud rule |
| `*_BG.*` | the English files one level up | the Bulgarian originals; the repo language is English |
