TKyoseva/ARmini/docs/process/history/2026-10-07_AR-Mini_info_flow_v1_BG.pdf

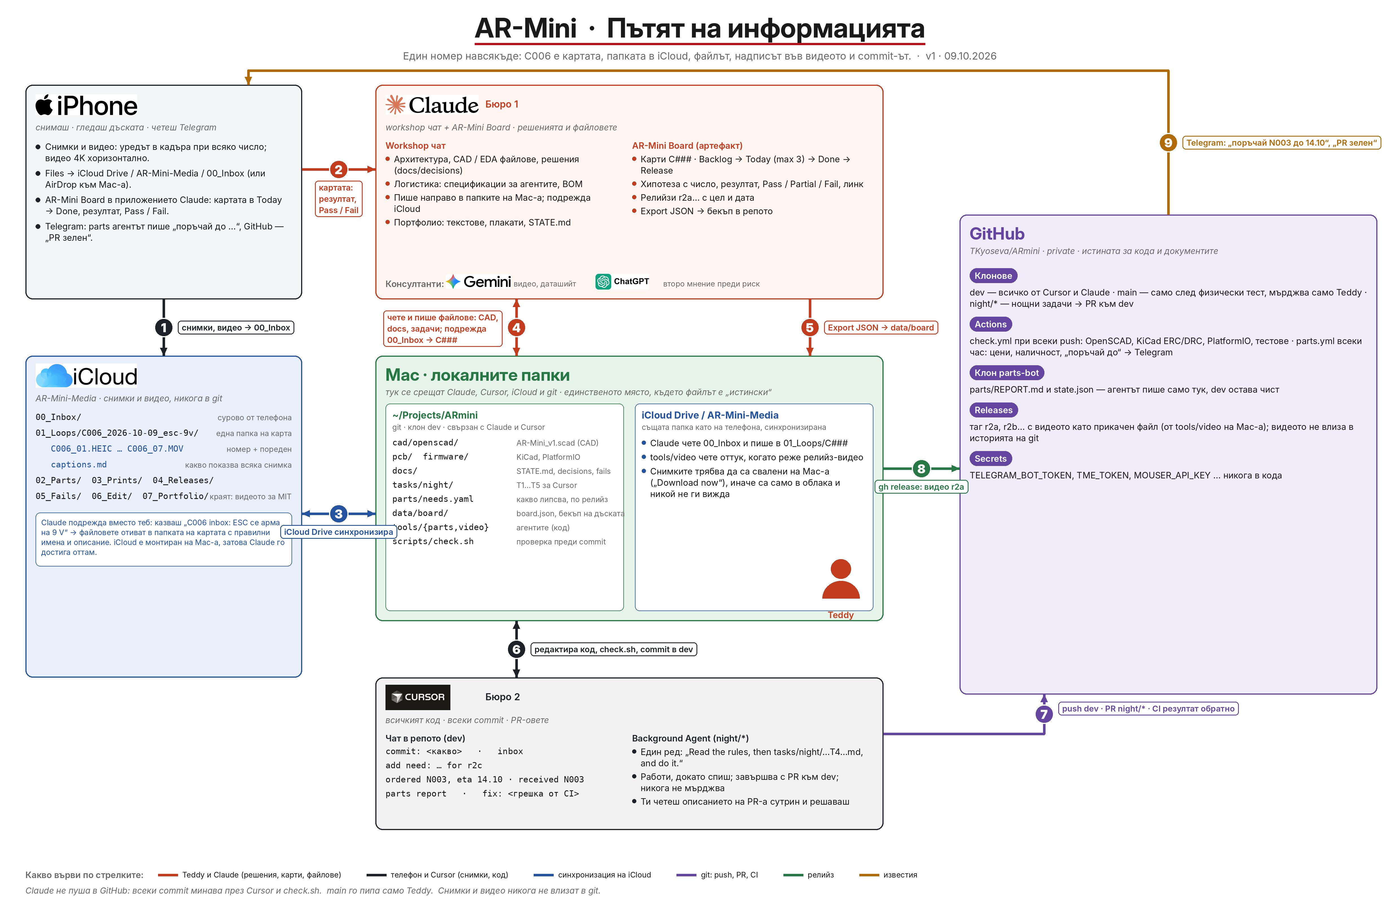
[picture p92: page 1]
