TKyoseva/ARmini/docs/process/history/2026-10-07_AR-Mini_structure_v1.pdf

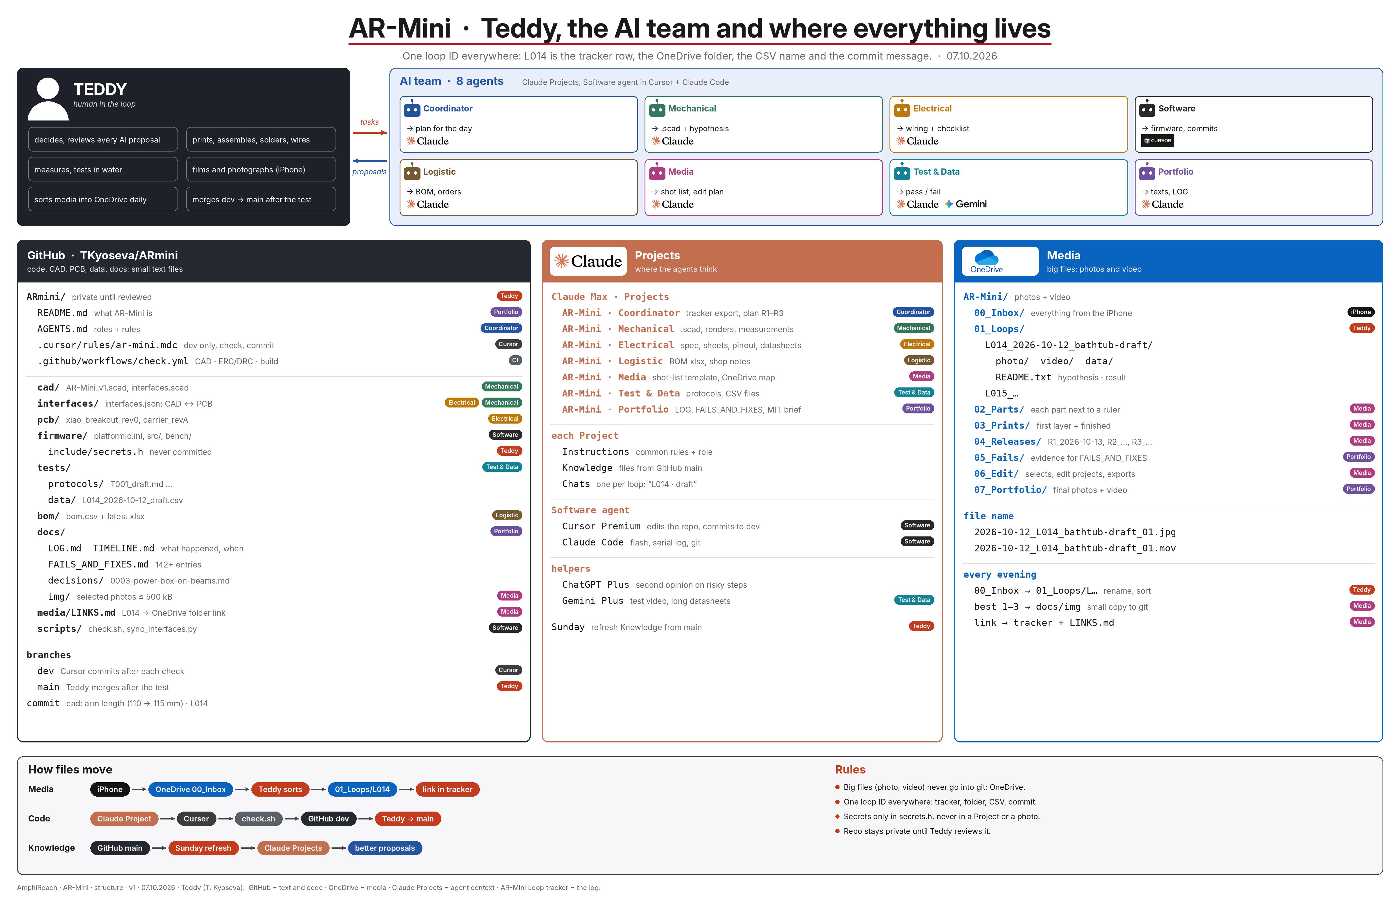
[picture p93: page 1]
