TKyoseva/ARmini/docs/process/history/2026-10-07_AR-Mini_team3_agents_v1.pdf

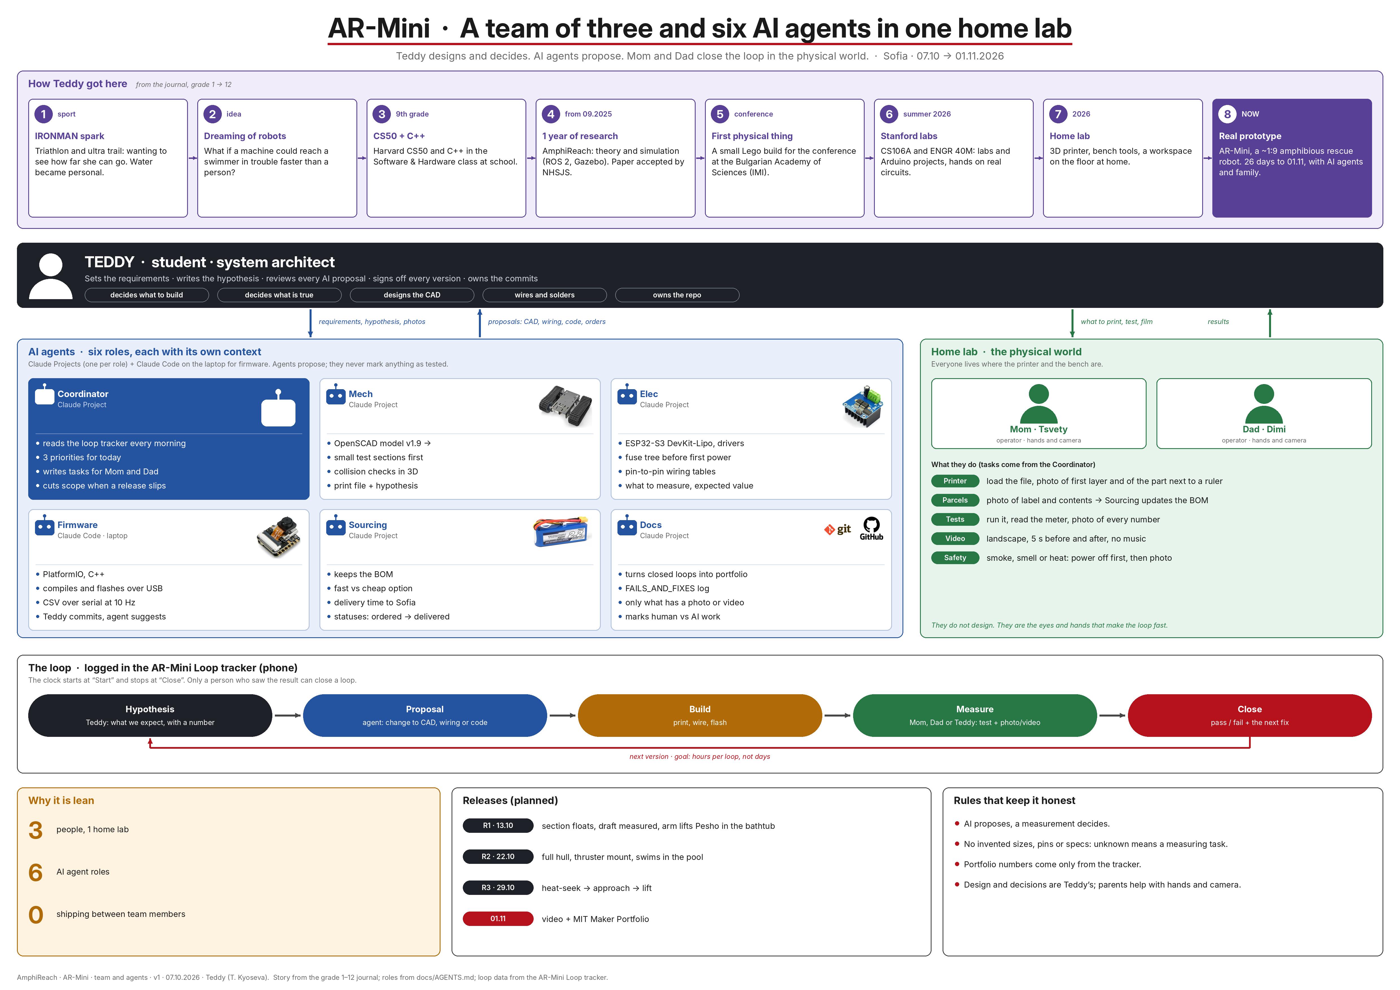
[picture p94: page 1]
