TKyoseva/ARmini/docs/process/history/2026-10-08_AR-Mini_lab_protocol_v2_A3_BG.pdf

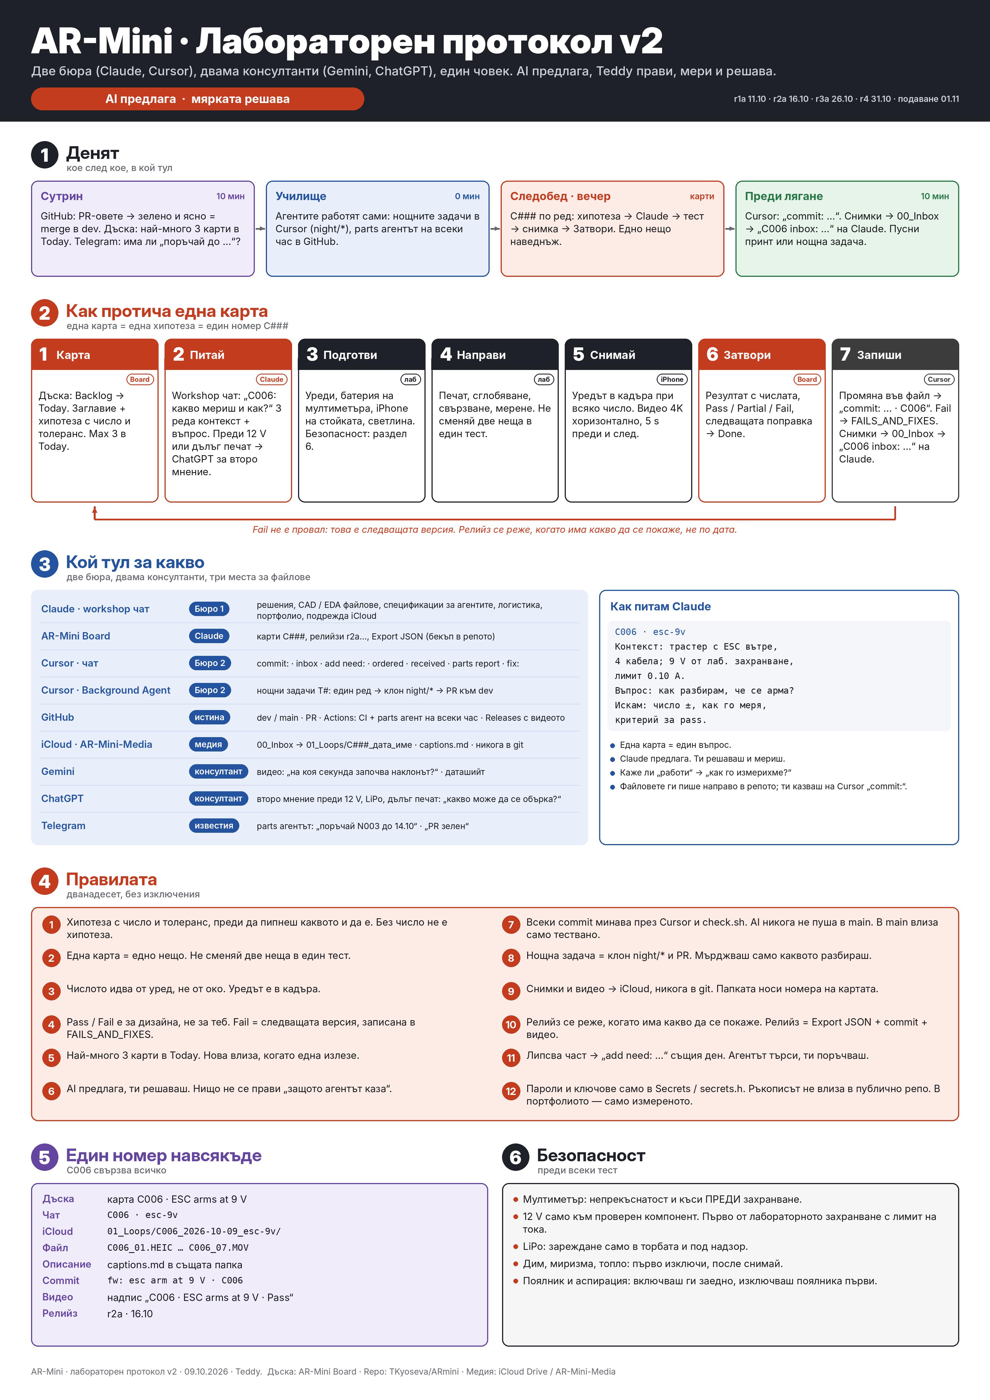
[picture p96: page 1]
