TKyoseva/ARmini/docs/diagrams/history/2026-09-29_AR-Mini_v1_layout_BG.png

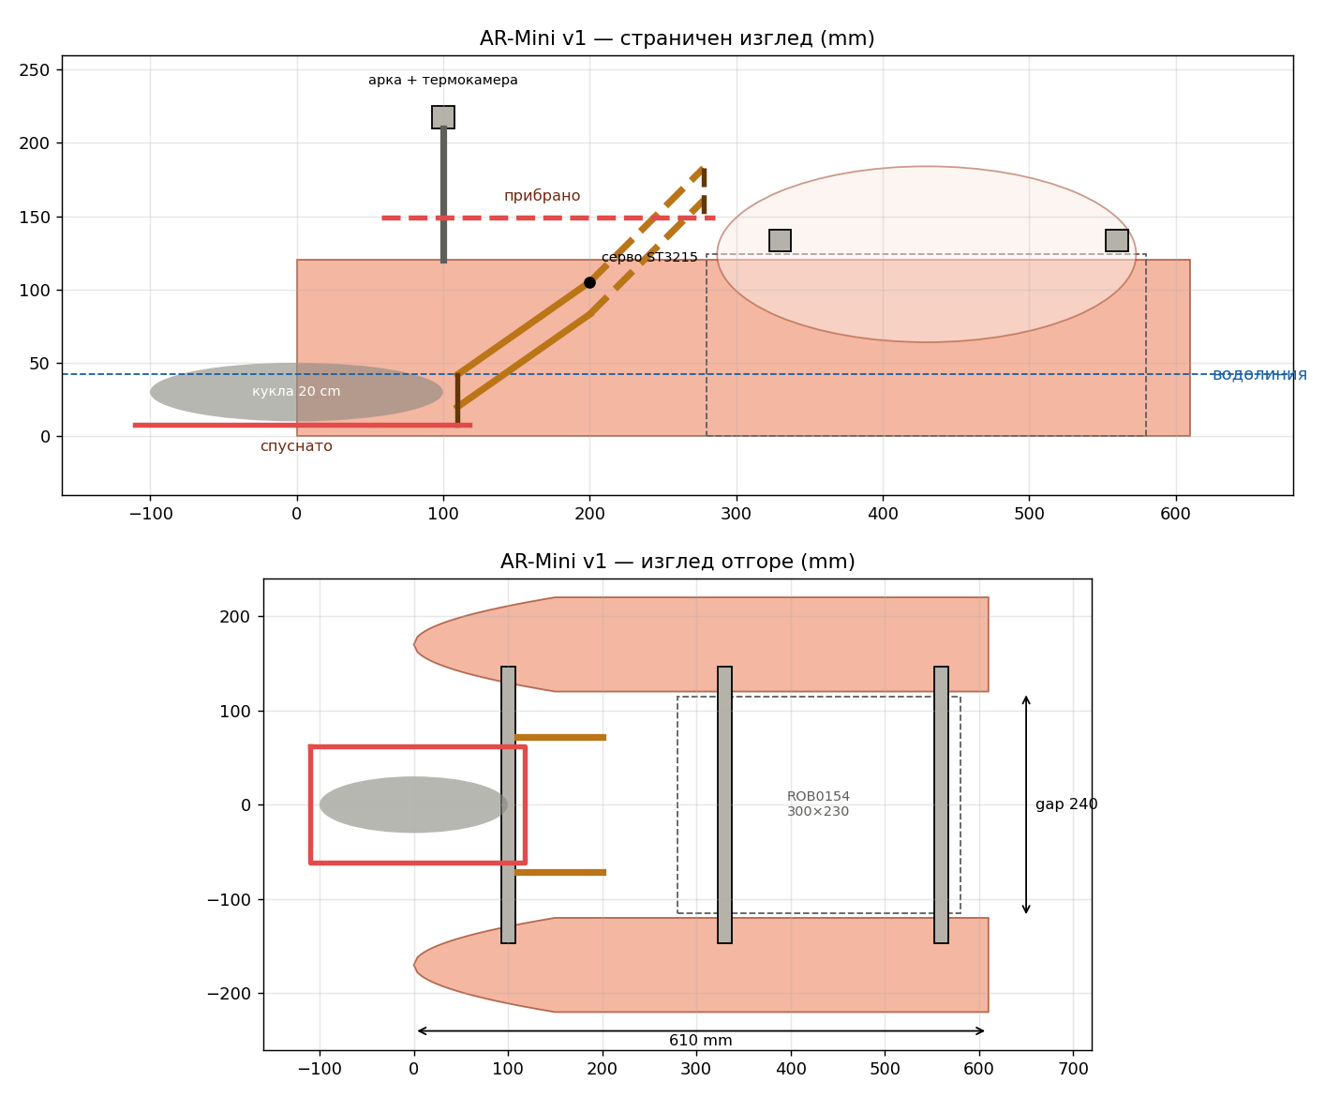
docs/diagrams/history/2026-09-29_AR-Mini_v1_layout_BG.png
