TKyoseva/ARmini/docs/process/history/2026-10-08_AR-Mini_lab_protocol_v1_A3.png

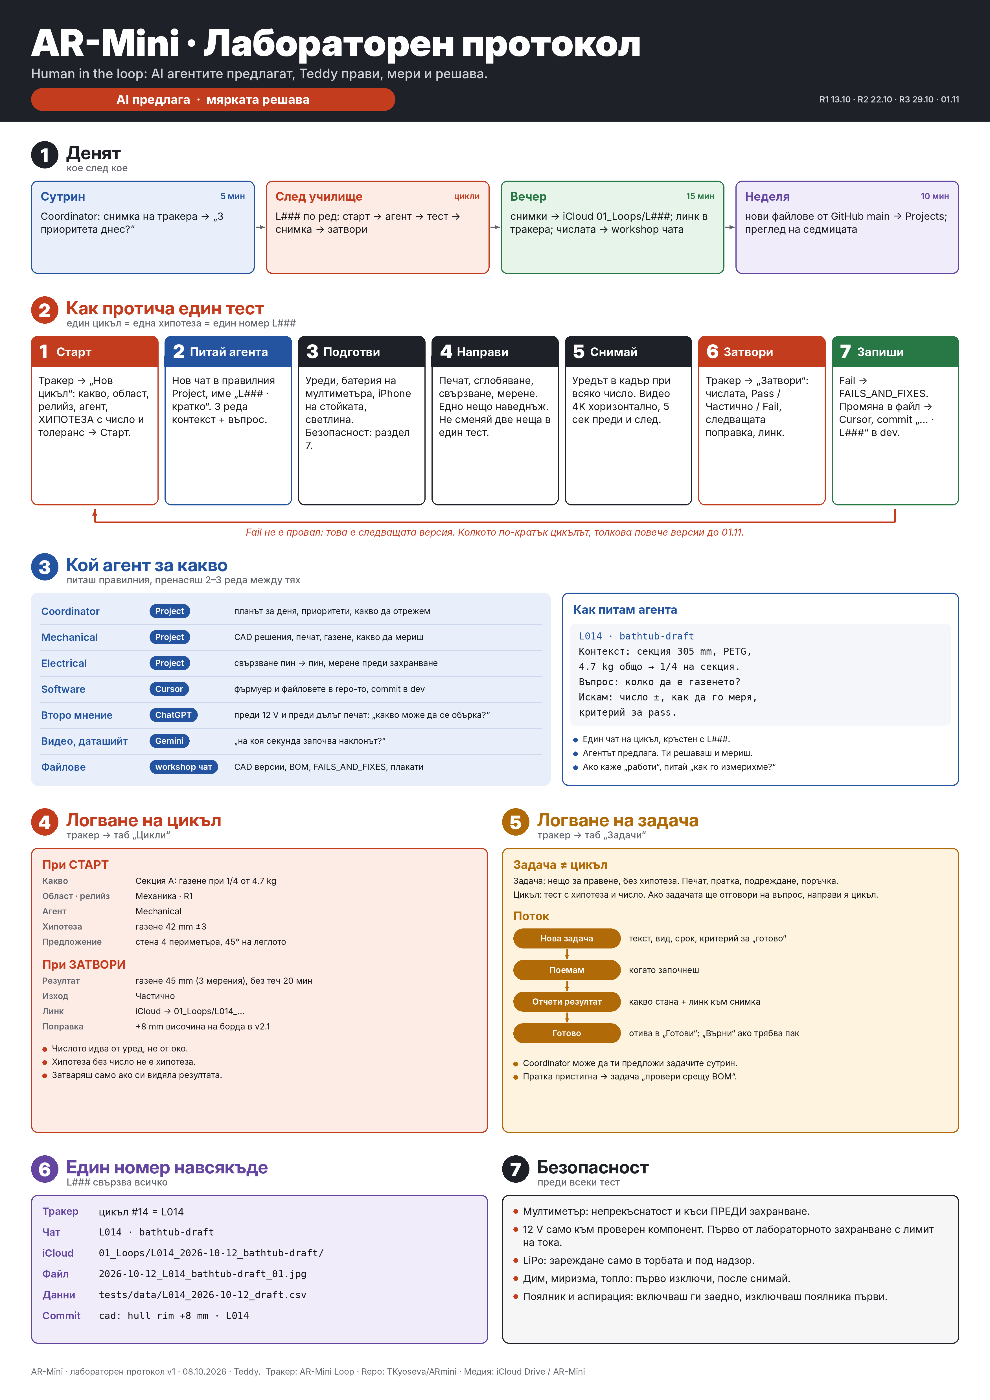
docs/process/history/2026-10-08_AR-Mini_lab_protocol_v1_A3.png
