TKyoseva/ARmini/pcb/carrier-revB/AR-Mini_carrier_revB_fitcheck_1to1.pdf

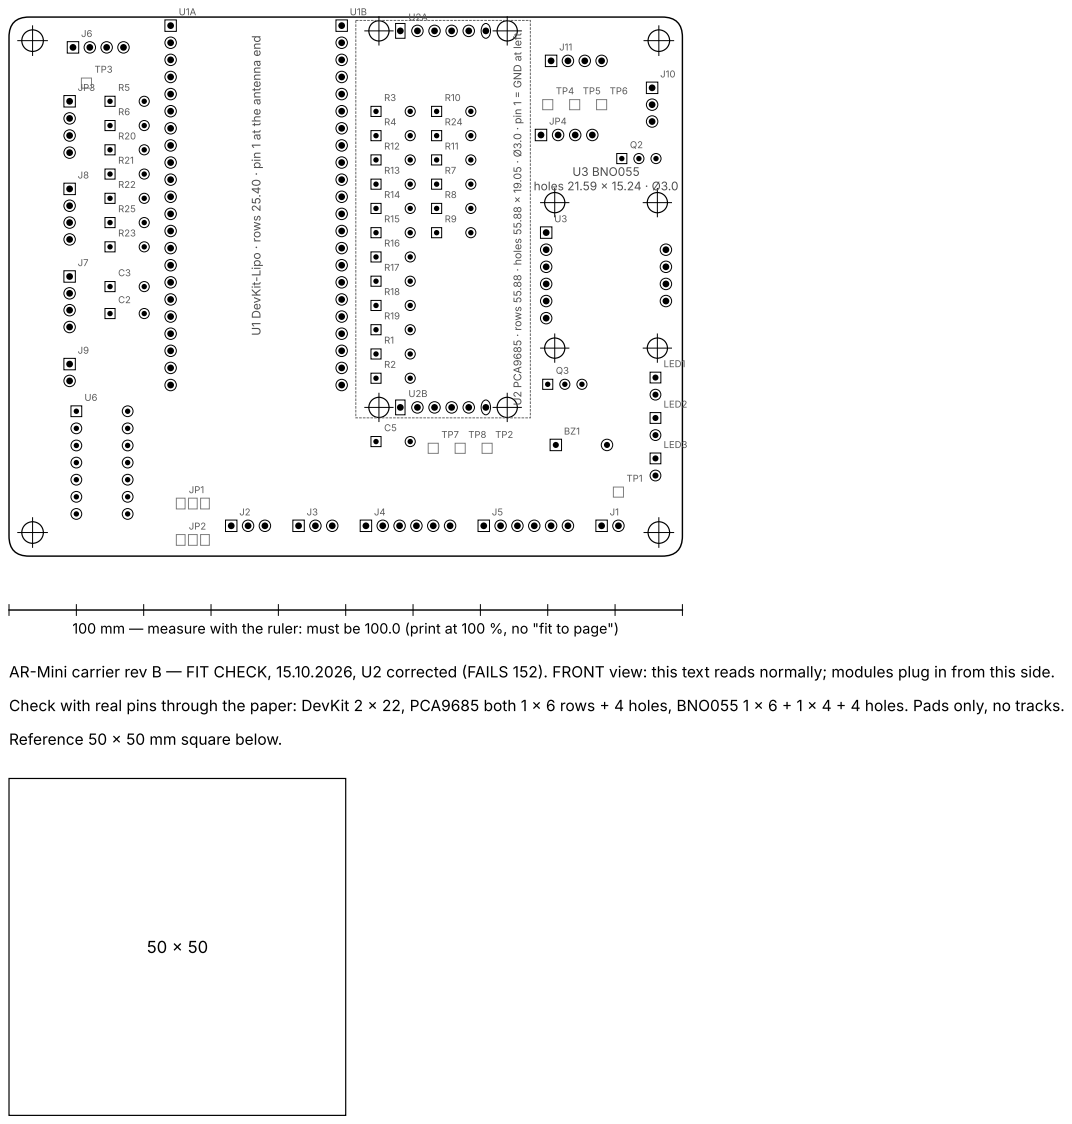
[picture p99: page 1]

U1 DevKit-Lipo · rows 25.40 · pin 1 at the antenna end

U2 PCA9685 · rows 55.88 · holes 55.88 x 19.05 · Ø3.0 · pin 1 = GND at left

100 mm — measure with the ruler: must be 100.0 (print at 100 %, no "fit to page")

AR-Mini carrier rev B — FIT CHECK, 15.10.2026, U2 corrected (FAILS 152). FRONT view: this text reads normally; modules plug in from this side.

Check with real pins through the paper: DevKit 2 x 22, PCA9685 both 1 x 6 rows + 4 holes, BNO055 1 x 6 + 1 x 4 + 4 holes. Pads only, no tracks.

Reference 50 x 50 mm square below.
