TKyoseva/ARmini/pcb/carrier-revB/AR-Mini_carrier_revB_1to1_F.pdf

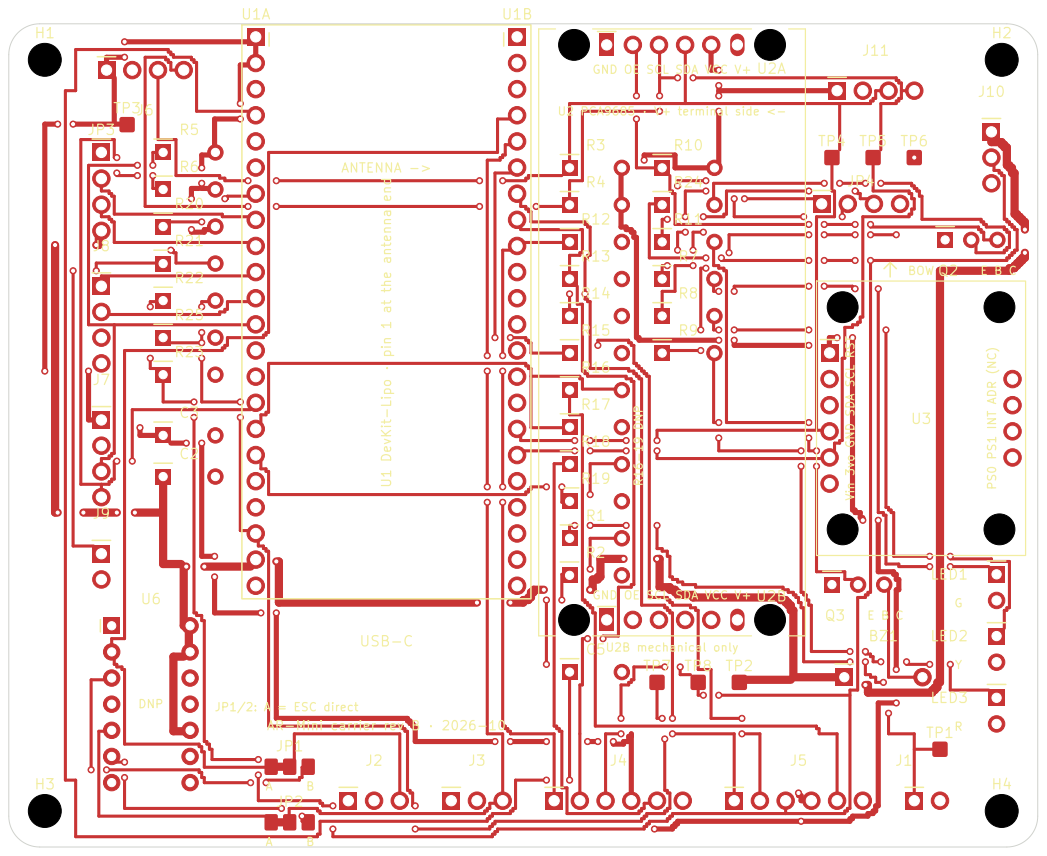
[picture p100: page 1]
