TKyoseva/ARmini/pcb/carrier-revB/history/2026-10-13_U2-54.26_failed-paper-check.kicad_pcb

## KiCad design pcb/carrier-revB/history/2026-10-13_U2-54.26_failed-paper-check.kicad_pcb (2026-10-18)

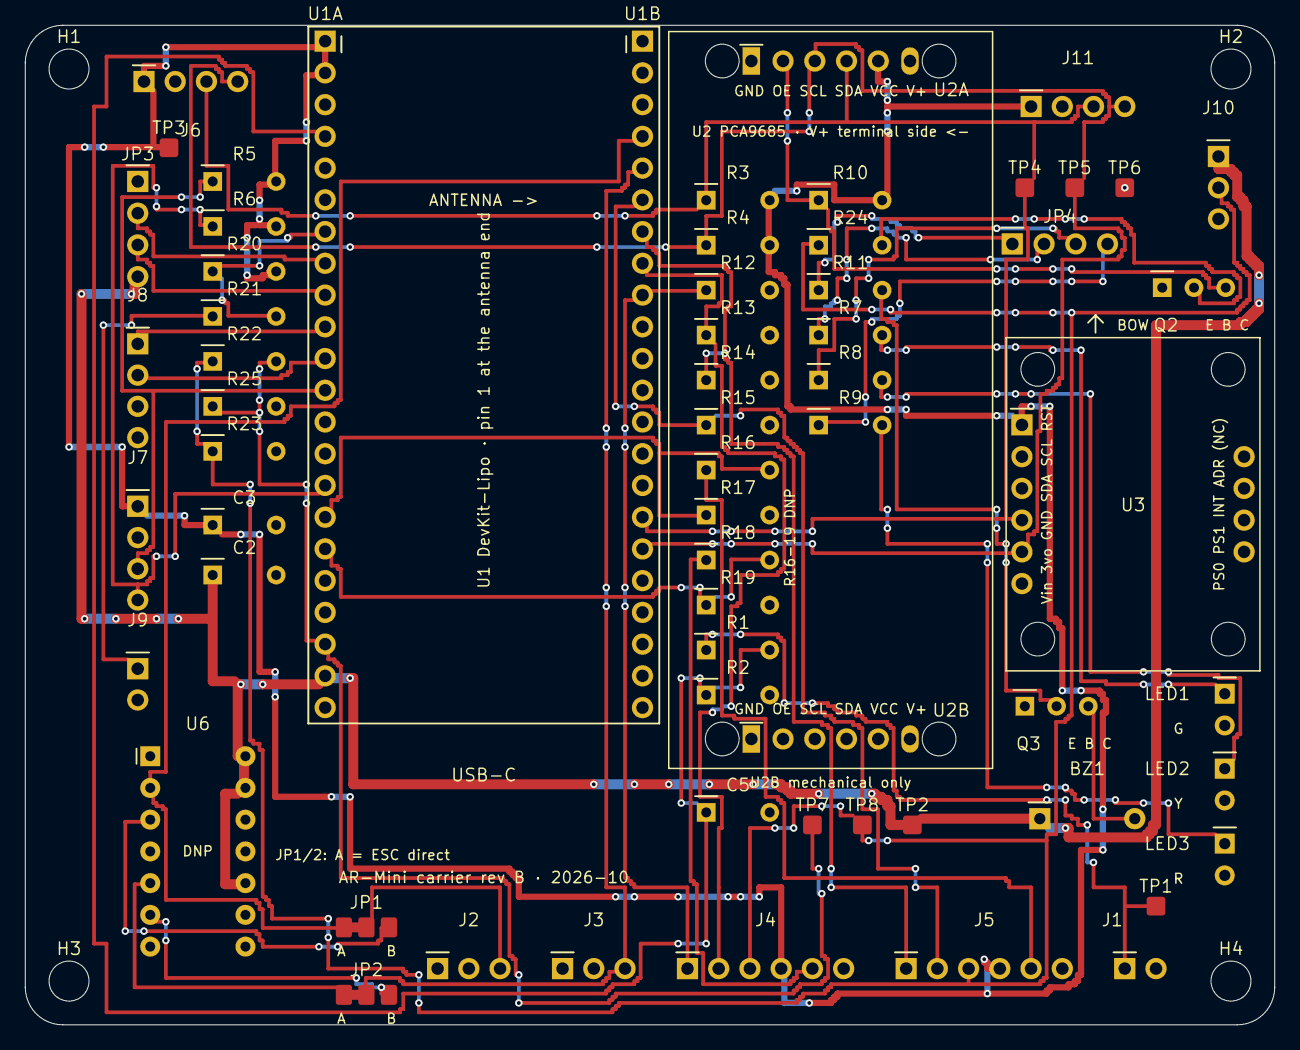
[picture p101: board 2026-10-13_U2-54.26_failed-paper-check.kicad_pcb from above]

Board: 2 copper layers, 100.0 x 80.0 mm, 67 parts (0 on the bottom side), 40 nets.

Parts:
BZ1: BUZZER; BZ1
C2: 100nF; C2
C3: 100nF; C3
C5: 100nF; C5
H1, H2, H3, H4: M3
J1: VBAT_SENSE; J1
J2: ESC_L; J2
J3: ESC_R; J3
J4: BTS_L; J4
J5: BTS_R; J5
J6: THERM_FWD; J6
J7: THERM_POD; J7
J8: SERVO_BUS; J8
J9: LEAK; J9
J10: ROCKER; J10
J11: IMU_EXT; J11
JP1: SJ; JP1
JP2: SJ; JP2
JP3: PI_UART; JP3
JP4: CH6-9; JP4
LED1: LED; LED1
LED2: LED; LED2
LED3: LED; LED3
Q2: S8050; Q2
Q3: S8050; Q3
R1: 100k; R1
R2: 33k; R2
R3: 4k7; R3
R4: 4k7; R4
R5: 4k7; R5
R6: 4k7; R6
R7: 330; R7
R8: 330; R8
R9: 330; R9
R10: 2k2; R10
R11: 1k; R11
R12: 10k; R12
R13: 10k; R13
R14: 10k; R14
R15: 10k; R15
R16: 10k; R16
R17: 10k; R17
R18: 10k; R18
R19: 10k; R19
R20: 10k; R20
R21: 4k7; R21
R22: 10k; R22
R23: 10k; R23
R24: 10k; R24
R25: 20k; R25
TP1: VBAT; TP1
TP2: +5V; TP2
TP3: +3V3; TP3
TP4: SDA0; TP4
TP5: SCL0; TP5
TP6: GND; TP6
TP7: KILL; TP7
TP8: EN; TP8
U1A: DevKit_EXT1; U1A
U1B: DevKit_EXT2; U1B
U2A: PCA9685_row; U2A
U2B: PCA9685_row; U2B
U3: BNO055; U3
U6: 74AHCT125; U6

Connections:
+3V3: C3.1, J4.4, J5.4, J6.1, J7.1, J11.1, R3.2, R4.2, R5.2, R6.2, R10.2, R20.2, TP3.1, U1A.1, U1A.2, U2A.5, U3.1
+5V: BZ1.1, C2.1, J10.1, JP3.4, TP2.1, U1A.21, U6.10, U6.13, U6.14
BTS_IS_L: R18.2, R19.1, U1A.17
BTS_IS_R: R16.2, R17.1, U1A.16
BTS_L_LPWM: J4.2, R13.1, U1B.8
BTS_L_RPWM: J4.1, R12.1, U1B.9
BTS_R_LPWM: J5.2, R15.1, U1B.6
BTS_R_RPWM: J5.1, R14.1, U1B.7
BZ_N: BZ1.2, Q3.3
CH6: JP4.1, R11.1
CH7: JP4.2, R7.1
CH8: JP4.3, R8.1
CH9: JP4.4, R9.1
EN: J4.3, J5.3, J10.2, R22.1, R23.1, R24.1, TP8.1
ESC_L: J2.3, JP1.A, JP1.C, U1B.4, U6.2
ESC_L_5V: JP1.B, U6.3
ESC_R: J3.3, JP2.A, JP2.C, U1B.5, U6.5
ESC_R_5V: JP2.B, U6.6
GND: C2.2, C3.2, C5.2, J1.2, J2.1, J3.1, J4.6, J5.6, J6.2, J7.2, J8.3, J9.2, J10.3, J11.2, JP3.1, LED1.2, LED2.2, LED3.2, Q2.1, Q3.1, R2.2, R12.2, R13.2, R14.2, R15.2, R17.2, R19.2, R23.2, R25.2, TP6.1, U1A.22, U1B.1, U1B.22, U2A.1, U3.3, U6.1, U6.4, U6.7, U6.9, U6.12
IS_L_MOD: J4.5, R18.1
IS_R_MOD: J5.5, R16.1
KILL: R22.2, R25.1, TP7.1, U1A.20
LEAK: R20.1, R21.2, U1A.7
LEAK_P: J9.1, R21.1
LED1_A: LED1.1, R7.2
LED2_A: LED2.1, R8.2
LED3_A: LED3.1, R9.2
OE: Q2.3, R10.1, U2A.2
PI_RX: JP3.3, U1A.9
PI_TX: JP3.2, U1A.8
Q2B: Q2.2, R24.2
Q3B: Q3.2, R11.2
SCL0: J6.4, J11.4, R4.1, TP5.1, U1B.17, U2A.3, U3.5
SCL1: J7.4, R6.1, U1A.15
SDA0: J6.3, J11.3, R3.1, TP4.1, U1B.16, U2A.4, U3.4
SDA1: J7.3, R5.1, U1A.12
SRV_RX: J8.2, U1A.11
SRV_TX: J8.1, U1A.10
VBAT: J1.1, R1.1, TP1.1
VBAT_S: C5.1, R1.2, R2.1, U1A.4
