TKyoseva/ARmini/pcb/xiao-breakout-rev0/AR-Mini_xiao_breakout_rev0.kicad_pcb

## KiCad design pcb/xiao-breakout-rev0/AR-Mini_xiao_breakout_rev0.kicad_pcb (2026-10-09)

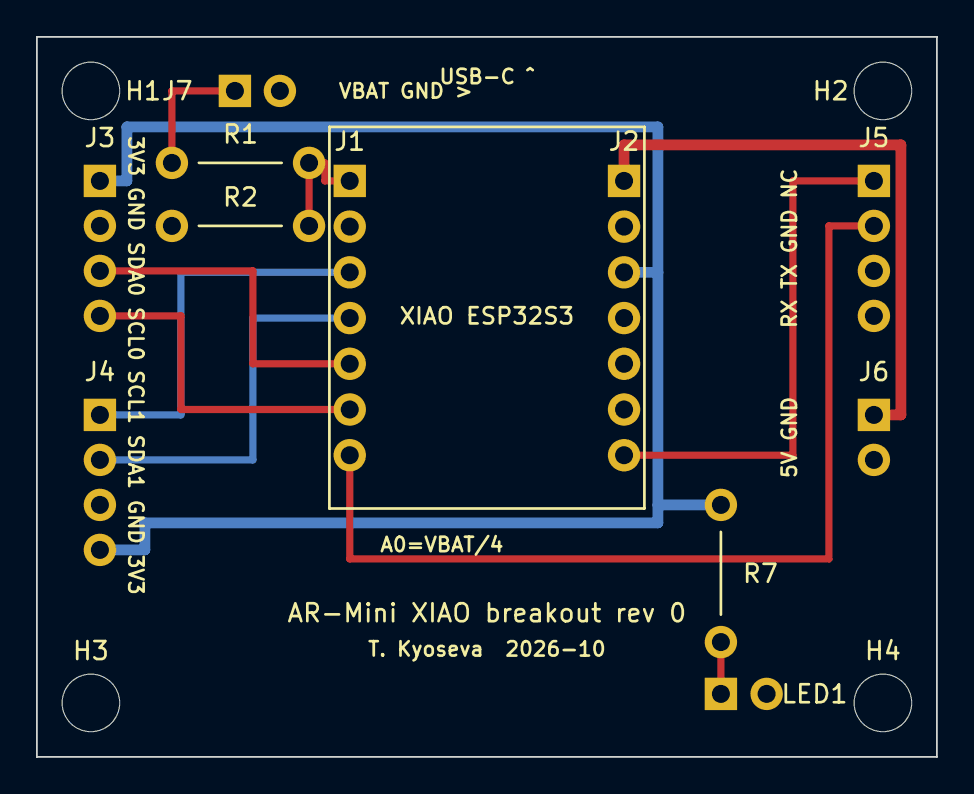
[picture p102: board AR-Mini_xiao_breakout_rev0.kicad_pcb from above]

Board: 2 copper layers, 50.0 x 40.0 mm, 15 parts (0 on the bottom side), 12 nets.

Parts:
H1, H2, H3, H4: M3
J1: XIAO_L
J2: XIAO_R
J3: I2C0
J4: I2C1
J5: SERVO
J6: PWR5V
J7: VBAT
LED1: PWR
R1: 100k
R2: 33k
R7: 330

Connections:
+3V3: J2.3, J3.1, J4.4, R7.1
+5V: J2.1, J6.1
GND: J2.2, J3.2, J4.3, J5.3, J6.2, J7.2, LED1.2, R2.1
LED_A: LED1.1, R7.2
SCL0: J1.6, J3.4
SCL1: J1.3, J4.1
SDA0: J1.5, J3.3
SDA1: J1.4, J4.2
SRV_RX: J2.7, J5.1
SRV_TX: J1.7, J5.2
VBAT: J7.1, R1.1
VBAT_S: J1.1, R1.2, R2.2
