TKyoseva/ARmini/docs/bom/src/build_bom_map.py

import json, re, sys

SP = ""   # run from docs/bom/src/
src = json.load(open(SP + "bom_bg_strings.json", encoding="utf-8"))

T = {
0: '"Clean" zone: XIAO, boards, sensors. Grounded to the Schuko earth or the lab supply\'s ground',
1: '0–150 mm · 0.03 mm · inside/outside/depth · LR44 battery',
2: '0–60 V · 0–5 A · CC/CV · 4-digit display (0.01 V / 0.001 A) · USB 5 V/2 A · for tests: 12.0 V, CC = 3 A at first (protects against shorts), then the 20 A branch from LiPo only',
3: '1.5 m · 2.0 mm · with flux',
4: '1/4" thread · for MT-79 and Magic Arm',
5: '10 ml · medium strength · removable with tools · 24 h cure · for M3–M12',
6: '10 pcs insulated double-ended test lead clips',
7: '10 pcs alligator clip → Dupont male, ~20 cm',
8: '100 stackable (Arduino shield: 6/8/10 pin, long legs) + 12 × 1×40 breakaway male',
9: '1000 mm · Ø5.0 → 5.3 hole in the coupler · bends by hand around a Ø25 pipe (radius ~15 mm) · ~570 mm needed for the U-frame (220+123+220) + loss at the corners',
10: '1000 mm · 1.0 mm wall · ~0.15 kg/m · cut 3 × 304 mm (912 from one length) · drill Ø4.5 for M4 to the plate',
11: '11.1 V · 2200 mAh · 40C (88 A) · XT60 · measured 108×33×23 mm',
12: '150 mm · medium cut',
13: '16 A · switch(es) · surge protection (if it is this version)',
14: '16 channels · 12 bit · I2C address 0x40 · OE pin · V+ terminal for servo power · measured board length 62.15 mm',
15: '18 AWG silicone wire, 1 m (2 × black + 2 × red)',
16: '2 TB · photos and video from iPhone · iCloud Drive visible on the laptop · folder link for sharing',
17: '2 boxes × 140 rigid U-jumpers · 22 AWG · colour-coded by length',
18: '2-position ON-ON · 20 A / 12 V DC · 2 terminals',
19: '2 layers 1.6 mm · 3 pcs minimum · ~1 week to Bulgaria · accepts .kicad_pcb directly',
20: '20 kg·cm · metal gears · measured 40.3 × 20.14 × 40.7 mm, mounting ears at 50 mm, Ø4.34 holes at 10 mm, shaft 10.4 mm from the front wall',
21: '20 double-sided prototype boards · 20 M/F headers · 15 screw terminals 2/3-pin · 20 nylon standoffs',
22: '24 MS/s · 8 channels · 0–5 V · 1.5 V threshold · PulseView (sigrok) · UART up to ~2 Mbps, I2C up to 1 MHz',
23: '24 teeth/inch · for walls ≤ 2 mm (rule: ≥ 3 teeth in the material) · bi-metal = do not snap',
24: '25 W · USB-C · 5 A — what the Pi 5 asks for',
25: '2:1 · 100 mm pieces · 1.5/2.5 for single wires, 4/6 for sleeving a bundle · without adhesive (for below the waterline → with adhesive)',
26: '2K epoxy, thixotropic PASTE · A:B = 2:1 by weight · pot life ~45 min at 20 °C · handling strength 12 h, full 48 h · 10–30 °C when applying · tensile strength > 20 MPa · cannot be brushed on',
27: '2–125 mm · rigid · colour-coded by length',
28: '3 beams between the hulls (under the ROB0154 plate) + camera arch; the second one is spare/future beams',
29: '3.3/5 V switch · RX/TX LED · to servo driver: TX→RX, RX→TX, GND, no VCC',
30: '30 A main fuse, directly on the battery XT60 (before the switch)',
31: '30 kg·cm @ 12 V · 360° magnetic encoder · servo / motor mode · feedback (position, load, temperature) · ID 1–4',
32: '300 × 300 × 300 mm · enclosed chamber · RFID filament · CFS (multicolour) · PLA / PETG profiles',
33: '32×24 px · 110° · I2C address 0x33 · 3.3 V · wide-angle',
34: '32×24 px · 45° field of view · I2C · 3.3 V · up to ~8 Hz',
35: '4 flexible arms · heavy base · LED · soldering iron stand',
36: '43 A peak · 5.5–27 V · RPWM / LPWM + R_EN / L_EN · heatsink · measured 40.8 mm',
37: '4K 30 fps landscape · slo-mo for waves and impacts · timer · AirDrop to the laptop',
38: '4× Cortex-A76 2.4 GHz · 8 GB · USB 3 · 5 V / 5 A via USB-C (from the QIQIAZI buck) · 85×56 mm',
39: '5 V rails, BTS7960 → motors, 12 V to the servo driver',
40: '5 male + 5 female · 12 AWG silicone · 100 mm',
41: '5.0 mm pitch (fits 5.08 / 2 × 2.54 mm) · green · 2, 3 and 4 pin · for 14–22 AWG with ferrules',
42: '500 ml · 99 %, not 70 % (the water stays on the board)',
43: '5500 K · CRI 95+ · 2000 mAh ~3 h · 1/4" + 3 cold shoe · aim at a white wall, not at the subject',
44: '56 cm · 1/4" and 3/8" · ~1.5 kg load · C-clamp for tabletops up to 5 cm',
45: '560 KV · up to 300 m · bidirectional ESC included (three thin signal wires) · 12 V · anti-corrosion bearings',
46: '6 slots · common input · cover · LED for a blown fuse · ~"too big" → in the printed power box',
47: '60 W · 1–6S · up to 6 A · input 11–18 V DC · 3S 2200 mAh: 2.2 A (1C), ~1 h · storage 3.8 V/cell',
48: '64 bits (PH, Torx, Hex 1.5–6, Pentalobe) · tweezers · opening tools · anti-static wrist strap',
49: '64-bit · ROS 2 Jazzy · rosbag · USB serial bridge to the XIAO',
50: '79×57×43 cm (the robot is 61×45) / 45 L · with lids',
51: '9 g · metal gears · 180° · 4.8–6 V · 8 pcs',
52: '9-axis · on-board fusion → Euler angles over I2C · 3.3 V · address 0x28 · measure the header for carrier rev A',
53: '90 s full cycle + 30 s "what broke" for the portfolio',
54: 'A1 · up to 120 MB/s · 2 pcs',
55: 'A2 · V30 · up to 170 MB/s read · with SD adapter',
56: 'ABS · IP65 · with cable glands for 6–12 mm cable · black',
57: 'AI agents',
58: 'AR-Mini Loop tracker',
59: 'AR-Mini/ in iCloud Drive: 00_Inbox → 01_Loops/L### … 07_Portfolio; link to each loop in the tracker',
60: 'ATmega2560 16 MHz · 54 I/O · 4 UART · 5 V logic · 2 breadboards · resistors/LED/buzzer/potentiometer/7-seg',
61: 'Active cooler for Raspberry Pi 5',
62: 'Alkan ferrules 800 pcs 0.5–10 mm²',
63: 'Amazon.de (MOGAOPI kit)',
64: 'Arduino framework for ESP32-S3 · libraries: Adafruit MLX90640, Melexis MLX90642, SCServo (Waveshare), Adafruit PWMServoDriver, Adafruit BNO055, SD, WiFi · FreeRTOS tasks',
65: 'BTS7960 43 A H-bridge (dual)',
66: 'Bosch sandpaper P240 + P400',
67: 'Breadboard 1 / 2 / 2b — the ladder, the rails, the I²C branches',
68: 'Breadboard mock-ups: ADC ladder, VBAT divider, I2C bus with two sensors',
69: 'Brennenstuhl power strip',
70: 'CH0/1 → ESC left/right, CH2–5 → BTS7960 RPWM/LPWM, CH6 buzzer, CH7–9 LEDs; OE is pulled by the logic kill',
71: 'CSV → graphs · the scripts for the diagrams and the poster (AR-Mini_hardware_diagram.py)',
72: 'Cleqee alligator ↔ breadboard jumpers, 10 pcs',
73: 'The Coordinator, Mechanical, Electrical, Logistic, Media, Test & Data and Portfolio agents; Claude Code for the firmware on the laptop',
74: 'Creality Hyper PLA RFID 1.75 mm (7 spools: Black, Red, White ×2, Blue, Green, Orange)',
75: 'Creality Print 6 (or Orca Slicer)',
76: 'Cuifati 560 KV underwater thruster',
77: 'DFRobot ROB0154 tracked chassis',
78: 'DSM 640 pcs DIN 912 M3–M6 + nuts/washers',
79: 'DaVinci Resolve (free) or CapCut',
80: 'ESD mat · with grounding cord (1 MΩ) · surface resistance 10⁶–10⁹ Ω · not heat-resistant (the soldering iron does not rest on it)',
81: 'ESP32-S3 · 8 MB PSRAM / 8 MB flash · Wi-Fi + BLE 5 · OV3660 camera · microSD slot · 2×7 headers, 15.24 mm spacing between rows · measured 15.35 mm width',
82: 'ESP32-S3-WROOM-1 · 8 MB flash / 8 MB PSRAM · USB-C · LiPo charger + battery connector · can run Linux 6.3',
83: 'ESP32-S3-WROOM-1-N16R8 module',
84: 'EVA foam 3 mm',
85: 'FLASLD LiPo safe bag 22 × 17 × 15 cm',
86: 'FNIRSI HS-03 soldering iron',
87: 'FT232RL USB-TTL converter',
88: 'XIAO firmware: state machine, perception, pan loop, CSV log, WiFi telemetry',
89: 'Glarks pin headers 2.54 mm, 112 pcs',
90: 'Gridfinity bins (printed)',
91: 'Hailege U-shaped breadboard jumpers, 2 × 140 pcs',
92: 'ID 1–4 on the ST3215s, first arm test without code, zero calibration',
93: 'IR: −38…+365 °C · accuracy ±2.5 °C · resolution 0.2 °C · 12:1 optics (at 30 cm measures a Ø2.5 cm spot = the head of Pesho (the dummy)) · fixed emissivity 0.95 (plastic/skin ok, NOT shiny metal) · 2×AAA · 173 g',
94: 'J1 12V_IN on carrier rev A, buck input/output, VBAT; perfboard',
95: 'JST-XH 2.54 mm · male PCB headers + female housings 2/3/4/5/6 pin · 22 AWG silicone, pre-crimped',
96: 'JST-XH 2.54 mm kit: PCB headers + housings + 22 AWG crimped leads (2–6 pin)',
97: 'JST-XH for all sensor and servo connectors; waterproof connectors for the thrusters and the leak sensor',
98: 'Jesverty lab power supply 60 V / 5 A',
99: 'Joy-IT ARD-Set01 (Mega 2560 kit)',
100: 'Kantoflex aluminium square tube 15×15×1 mm',
101: 'LANUCN IP65 enclosure 150 × 110 × 70 mm',
102: 'Loctite 243 (medium-strength threadlocker)',
103: 'M2 bolts 4–20 mm, nuts, washers · black',
104: 'M2 kit 600 pcs',
105: 'M3 × 8 · hex socket · black · 150 pcs',
106: 'MG90S 9 g micro servo',
107: 'MLX90642-D45 thermal camera',
108: 'MOGAOPI component kit, 1390 pcs',
109: 'NEEWER Magic Arm 22" with desk clamp',
110: 'PCA9685 16-channel 12-bit PWM module',
111: 'PETG · 230–260 °C · does not soften in warm water · tougher than PLA · 4 spools',
112: 'PG7 cable glands',
113: 'PLA · 190–230 °C · RFID profile · softens at ~55 °C, brittle in the cold, creeps under load → NOT for the hull or for parts that sit in water or carry Pesho (the dummy); ideal for fit prototypes and anything dry',
114: 'Perfboard version of the carrier, test boards for the ladder/divider, standoffs for mounting the modules in the IP65 enclosure',
115: 'Pi 5 in a closed case without cooling throttles at ~80 °C',
116: 'Pi OS Bookworm + ROS 2 Jazzy; the rosbag logs from the tests',
117: 'Preciva crimp kit Dupont/JST-XH/waterproof',
118: 'Preset "TD8120" in the SCAD: first tests of the arms and the pan before the ST3215s arrive; spare afterwards',
119: 'Rocker switch ON-ON, 20 A / 12 V',
120: 'SN-28B type · 0.25–1.5 mm² (AWG 23–16) · 627 pieces · does NOT crimp 5264 (ST3215) or 6.3 mm lugs',
121: 'SPST OFF-ON · 50 A / 12 V DC · 2 terminals (6.3 mm flat) · Ø12 panel hole',
122: 'STL library · Gridfinity, PCB vise, tool holders',
123: 'SkyRC iMAX B6 V2 charger',
124: 'Software agent: ESP32-S3 firmware with AI in the editor; the main code editor; Claude Code for compiling, uploading and git',
125: 'Specs (important for AR-Mini)',
126: 'Stanley vise',
127: 'Stanley hacksaw 300 mm',
128: 'TD-8120MG 20 kg servo',
129: 'Test & Data: frame-by-frame review of the water test video; second opinion on datasheets',
130: 'Toolour third hand (parallel clamps, magnetic base)',
131: 'True RMS · 22000 counts · 10 A jack (thruster 8 A ok, not 20 A) · mA/µA · CAT III 600 V · bargraph',
132: 'Turnigy 14 AWG silicone wire, 1 m (2 × black + 2 × red)',
133: 'U-shaped breadboard jumpers, 840 pcs, 14 lengths',
134: 'The U-frame (cradle): two sides + front crossbar; the rest for axles and hinges',
135: 'UART TTL → half-duplex servo bus · input 6–12.6 V · up to 253 servos · small board',
136: 'ULANZI MT-79 tripod 204 cm',
137: 'ULANZI VL49 LED light',
138: 'UNI-T UT61E+ multimeter',
139: 'USB logic analyser 24 MHz 8 CH',
140: 'Vikiwat / pharmacy',
141: 'VooGenzek PCB kit 75 pcs',
142: 'WEDZE hand warmers (Decathlon)',
143: 'Waveshare 5264 servo cables, 3-pin',
144: 'Waveshare MLX90640 110° thermal camera',
145: 'Waveshare ST3215 30 kg servo (serial bus)',
146: 'Waveshare software for ST3215 ID and testing without code',
147: 'Wi-Fi 802.11 b/g/n + BT · 2.4–2.5 GHz · 150 Mb/s · 16 MB flash · 8 MB octal PSRAM · avoid GPIO 26–32, 35–37',
148: 'Wisent Bi-Metal blades 300 mm, 24 TPI',
149: 'Wisent vise',
150: 'XIAO UART1 (D6 TX / D7 RX) → 4 × ST3215; 12 V from 15 A fuse. The second one = spare / test rig',
151: 'XT60 cables with connector, 10 pcs',
152: 'YIHUA 948DQ-I fume extractor (with third hand + 6 filters)',
153: 'YIXISI screw terminals 5 mm, 2/3/4 pin, 100 pcs',
154: 'breadboard + 40-pin expansion board · joystick · HC-SR04 · thermistor · relay · L293D (0.6 A — too small for ROB0154)',
155: 'iPhone on the tripod above the pool and on the arm above the table',
156: 'light stand 204 cm · 1/4" screw · no phone clamp (ST-02/ST-10 separate) · no remote',
157: 'XIAO Sense microSD slot: CSV logs at 10 Hz + photos from the missions; the second one = spare/archive',
158: 'repo: firmware/ cad/ pcb/ docs/ data/ · commit every evening · README with BOM and schematic',
159: 'rev 0 XIAO breakout (finished file) and carrier rev A per the spec; Gerber/upload to Aisler',
160: 'ruthex inserts M2/M3/M4/M5 assortment + M3S ×100',
161: 'shield format for Uno/Mega · 16 channels · same PCA9685 chip · I2C',
162: 'v2 (2027): ROS 2 Jazzy, rosbag recording and planning; talks to the XIAO over USB serial. During v1 it stays on the desk for development.',
163: 'v2: the ROS 2 stack from the simulation on the real robot; mission recordings',
164: 'Ø ~2 m · depth ≥ 40 cm (draft 42 + tracks) · ~1000 L · room ≥ 2.5 × 2.5 m · floor protection · the boat is 61 × 45 cm → there is room to turn',
165: 'Subscription',
166: 'Automotive fuses, 250 pcs kit',
167: 'Solid aluminium rod Ø5 mm',
168: 'iFixit anti-static mat',
169: 'Anti-static zip bags 10×15 and 15×20 cm',
170: 'Balance charging and storage mode for both LiPos; from the lab supply at 13 V',
171: 'Ballast for the trim and heel of the hulls',
172: 'Batteries',
173: 'The battery line; adapters for the iMAX B6 and for the lab power supply',
174: 'Battery → inline fuse → switch → fuse block → ESCs (everything over 10 A)',
175: 'Safety',
176: 'Fuse block with cover, 6 slots',
177: 'Fuses for the block (20/15/10/5/5 A) + 30 A for the inline holder; spares',
178: 'Scale up to 5–10 kg (kitchen)',
179: 'Daisy-chaining the four ST3215s (spliced with the 5264 connectors, not Dupont)',
180: 'Video',
181: 'Screws M3 × 8 hex socket, 150 pcs',
182: 'Screws M3×25 + M3×30 DIN 7985',
183: 'Screws M5×20 + M5×30 DIN 912, nuts M5 DIN 985',
184: 'Inserts, M3 by length, M2, JST terminals, fuses — each in its own bin',
185: 'All MEASURE values in the CAD; checking the printed parts (3.3 hole, 110.0 between the axles)',
186: 'All bosses and lids on the printed parts (insert_d = 4.0 in CAD)',
187: 'All water tests October–December; ramp (250 mm board + rubber) from the edge',
188: 'All printed parts, the assembly with the chassis and the waterline, plate_check for the K2 Pro bed',
189: 'All printed parts; hull sections at 45° along the plate diagonal (291 / 300 mm)',
190: 'All photos and video for the portfolio; proof for every closed loop',
191: 'All solder joints: splicing 5264 cables, the boards, cable lugs',
192: 'Everything with M2/M2.5/Torx; the tweezers for JST terminals; the wrist strap to the ESD mat',
193: 'Every board that is not mounted lives in a labelled bag',
194: 'Second opinion (red team) on key Mechanical and Electrical decisions before printing or first power-up; voice mode while soldering',
195: 'Nuts M12 DIN 934',
196: 'Nuts M3 DIN 934',
197: 'Gasket in the flanges between sections; groove in the power box lid; around the cable glands; thin layer along the outer edges of the joint',
198: 'Gasket between the two bulkheads of the joint (two frames following the hull outline); torso of Pesho (the dummy) (variant A)',
199: 'Main switch after the inline fuse — cuts EVERYTHING (thrusters, servos, logic)',
200: 'Graphs for the portfolio: homing, servo load, voltage, table of the 20 missions',
201: 'Data',
202: 'Debugging the servo bus (UART 1 Mbps) and both I2C buses',
203: 'Debugging the servo bus and I2C when it "does not respond"',
204: 'VBAT divider, the ladder (10 k / 4.7 k / 1 k), pull-up 2.2 k, 100 nF, buzzer (NPN), LEDs; check that the 470 µF is ≥ 25 V',
205: 'Servo disc horns (M2), the MLX camera board',
206: 'The log of every loop and the source of the numbers in the portfolio',
207: 'Drivers',
208: 'Fuse holder GT4652 (inline)',
209: 'Holds the XIAO / breakout rev 0 while soldering the headers (substitute for the PCB vise from row 37)',
210: 'Holds the two wires while splicing; stand for the HS-03',
211: 'One in the robot (XT60 → 30 A inline fuse → 50 A switch → fuse block), one on the charger; ~15–20 min test with two thrusters',
212: 'Electronics',
213: 'Label on every connector, cable and box — four people on the project',
214: 'For the Pattex',
215: 'To install',
216: 'To install (v2)',
217: 'To buy',
218: 'Drive',
219: 'Rear wall of the power box (6 cables)',
220: 'Mounting',
221: 'Soldering',
222: 'Battery charging and storage',
223: 'Power',
224: 'Removing a soldered wire from the BTS7960 / removing excess solder',
225: 'Measuring',
226: 'Insulated flat terminals 6.3 mm, 25 M + 25 F',
227: 'Isopropyl alcohol 99 % + old toothbrush',
228: 'Use in AR-Mini',
229: 'Have',
230: 'Installed',
231: 'Tool',
232: 'Tools',
233: 'The project history = proof of the process; S works in a branch',
234: 'Cables',
235: 'Cable ties white + coloured',
236: 'Cable bundles; colour = subsystem (red power, green sensors, yellow servos)',
237: 'Overhead shot above the pool; with phone clamp and timer',
238: 'Candidate for controller v2 and test board for the firmware before carrier rev A (same chip as the WROOM module). 3 pcs: robot / desk / spare',
239: 'Code',
240: 'Needle file set',
241: 'Kits',
242: 'Connectors on XIAO breakout rev 0 (J3–J7) and carrier rev A (J2–J11); the ready-made cables save crimping',
243: 'Structural bonding: the rod into the couplers, the bosses to the hull, corner fillets along the inner edges. A thin coating on the hull needs liquid epoxy/XTC-3D',
244: 'Controller v1: state machine, PCA9685 on I2C-0 (D4/D5), the two thermal cameras on two I2C buses, the servo bus on UART1 (D6/D7), ADC ladder leak + kill on A1, VBAT on A0; USB to Pi 5 for v2',
245: 'Controllers',
246: 'Hull',
247: 'The hulls (4 sections of 305 mm, at 45° on the plate), the flanges and everything wet',
248: 'The hull from the AR_Mini_hull.py script; hydrostatics (CG vs CB); FEA of the arm and the bracket; renders and exploded view for the portfolio',
249: 'Fasteners',
250: 'Alligator clips double-ended, 10 pcs',
251: 'Couplers, brackets, filing small parts',
252: 'Heading while homing on the target; roll / pitch while lifting (I2C-0)',
253: 'Organisation bins, holders; uploading your models after December',
254: 'To the master switch, the rocker and the fuse block (14 AWG)',
255: 'Lab',
256: 'Light camera pan, cradle lock, test rigs',
257: 'Adhesives',
258: 'The logic 5 V rail (XIAO, sensors, PCA9685 VCC) from 5 A fuse',
259: 'The logic box: XIAO breakout / carrier (holes on a 93 × 73 grid), PCA9685, BNO055, 5 V buck. The power box is printed, on the chassis',
260: 'Logic kill: pulls PCA9685 OE + a step in the ADC ladder → motors stop, XIAO stays alive and logs',
261: 'Materials',
262: 'Metal',
263: 'Mechanics',
264: 'Washing off flux — flux + water = corrosion within weeks',
265: 'Stranded wire in screw terminals',
266: 'Modules and lids to the boxes; brackets and mounts into M3 inserts',
267: 'Modules on carrier rev A must be removable; XIAO: 8-pin female → cut to 7',
268: 'The module for carrier rev A — soldered directly to the board (January). 3 pcs for the 3 Aisler boards',
269: 'Multimeter to the fuse block / battery without holding the probes; temporary connections when testing the kill',
270: 'On the cradle: confirms the object is between the arms before lifting (I2C-1: Wire1 SCL = D2, SDA = D3)',
271: 'Inflatable pool 2 m',
272: 'Fitting the servo pocket, the insert holes, the edges of the printed parts',
273: 'Finishing',
274: 'General assembly. For the arm axles → Loctite 243 or a jam nut',
275: 'General assembly: brackets, mounts, bosses',
276: 'Leaded solder → fumes away from the face',
277: 'Online',
278: 'Desoldering braid 2 mm',
279: 'Organisation',
280: 'Parallelogram axles (6+8+6 mm stack + nut = 25 mm) and the power box lid',
281: 'The arm axles with plain M3 nuts — instead of the missing self-locking ones',
282: 'Separate 5 V rail for the Pi 5 (v2); in v1 — Pi on the desk from the lab supply',
283: 'Printing',
284: 'Caulking gun 310 ml',
285: 'Boards',
286: 'Boards and bucks in the boxes during tests (before mounts); the fuse block temporarily',
287: 'Boards and cables; wash your hands; fumes away',
288: 'Flat file 150 mm',
289: 'The ROB0154 plate to the beams; the arch mounts; vise → workbench',
290: 'One per ROB0154 track (left / right motor); 12 V from 10 A fuse; PWM from PCA9685 CH2–5',
291: 'One at the stern of each hull; differential heading control (CH0 / CH1 on PCA9685; 12 V from 20 A fuse)',
292: 'Portfolio submission by 28.12',
293: 'Using',
294: 'The front search camera (I2C-0, Wire D4/D5) — finds Pesho (the dummy) from 1–2 m by heat',
295: 'While soldering; small screws do not roll away',
296: 'Printer, lab supply, soldering iron, charger — on separate switches',
297: 'Check at home',
298: 'Checking rev 0 and rev A before Aisler',
299: 'Programmers',
300: 'Manufacturing',
301: 'PCB manufacturing',
302: 'Prototyping',
303: 'Workbench',
304: 'Work gloves',
305: 'Flat flanges — a hand without a block makes waves',
306: 'Distribution: 20 A ESCs, 15 A servo bus, 10 A BTS7960, 5 A logic, 5 A spare',
307: 'The parallelogram arms (left / right) + thermal camera pan; the fourth = spare. Measure the mounting ears before the pivot_bracket',
308: 'Resistors 100k and 33k 1 % (1/4 W)',
309: 'Edges of the cut aluminium, flanges',
310: 'Cutting beams and rod; holds a hull section while filing',
311: 'Cutting the beams (3 × 304) and the rod; always in the vise',
312: 'Cutting, filing, epoxy (Sikadur is a strong sensitiser — always with gloves)',
313: 'Light for soldering and for the process photos',
314: 'Sensors',
315: 'Servos',
316: 'Servo/ESC cables and bare wires (leak probe) to the breadboard during tests',
317: 'Slicing the STLs; rotating the hull section by 45°; drying PETG with the printer',
318: 'Slicer',
319: 'Splicing wires, tinning 14 AWG, SMD repairs',
320: 'Splicing the 5264 cables, insulating solder joints',
321: 'Filming',
322: 'Software',
323: 'Software v2',
324: 'Status: Have / Delivered = on the table · Ordered = ordered, not shipped yet · Dispatch = in transit · To buy · Printing = from the printer. Specs column: only the parameters that affect the project.',
325: 'Thrust test rig (potentiometer → ESC → scale); resistors for the divider; buzzer; wired teleoperation',
326: 'Thrust test rig (potentiometer → ESC), wired teleoperation with the joystick, quick module tests',
327: 'The Mega 2560 test rig: testing the ESCs and servos before the XIAO; module spare',
328: 'Stripping 14/18/22 AWG silicone; ferrules for the screw terminals on the BTS7960, the bucks, the terminal strips',
329: 'The land part: the plate bolts under the beams (x = 385 / 500), the motor shafts are above the waterline; driven via BTS7960',
330: 'Storage',
331: 'Weight of the parts and of the whole robot (target 4.7 kg) → draft',
332: 'Teleoperation with the joystick via Mega; ultrasound for the shore; thermistor for the v2 dome; relay for the thrusters on a leak',
333: 'The phone above the table — overhead process shots, hands in frame',
334: 'Temperature of the head of Pesho (the dummy) and of the water before each test; calibration of the MLX cameras (target = same surface, same spot); ESC, BTS7960, motors, LiPo while charging',
335: 'Heat-shrink tubing, box Ø1.5–13 mm',
336: 'Tests',
337: 'Solder CYNEL Sn60Pb40 0.8 mm 100 g',
338: 'Type',
339: 'Type: Mechanics / Electronics / Software / Lab (filter on row 1). Status: Have / Delivered / Installed = done · Dispatch = in transit · To buy / To install · Printing. Subscription = paid and active · Using = in use. Check at home = we probably have it.',
340: 'Heat for Pesho (the dummy) — one warmer per session; for measurements at a set temperature → bottle of warm water',
341: 'Transporting the robot to the pool; "the pool kit"',
342: 'Third hand ZD-126-4 with LED and soldering iron stand',
343: 'Service',
344: 'Fine teeth for 1 mm aluminium without a jagged edge',
345: 'Hull flanges (P240), smooth surfaces for photos (P400)',
346: 'Flux TOPNIK-ZEL RMA gel',
347: 'Master switch R13-401A2A-07, 50 A / 12 V DC',
348: 'Colour code v1: orange = moving parts (arms, couplers, pivot bracket — fit version), black = structure (brackets, mounts, camera), white = fit prototype of a hull section, red = Pesho (the dummy), blue = boxes/lids/cable clips, green = Gridfinity bins',
349: 'The whole robot on the desk without LiPo; input for iMAX B6 V2 (13 V); current draw of each module; thrust test rig',
350: 'Chassis',
351: 'Rails, motor/servo current, the battery divider, solder joints (continuity)',
352: 'Caliper SUW-DIGIP54 0–150 mm',
353: 'Phone clamp 1/4" (e.g. ULANZI ST-02)',
354: 'subscription 20 USD · separate model for independent checking · uploading photos and PDFs',
355: 'Max subscription (200 USD) · separate Project for each agent · Project knowledge = the agent\'s files · Claude Code on the laptop: reads the repo, compiles, uploads to the board',
356: 'Plus subscription · accepts long videos and PDF datasheets',
357: 'Premium subscription, 3000 USD limit · AI editor based on VS Code · works with the PlatformIO extension · chat and edits across the whole project',
358: 'assortment 100–200 mm · 2.5–3.6 mm width',
359: 'battery-powered 2600 mAh · ~40 min at 350 °C · heat-up 3 s · 200–420 °C · for Sn60Pb40: 300–320 °C · switch to 350 for 14 AWG',
360: 'free DFM analysis of Gerbers · shows thin traces, small holes, mask',
361: 'PWM fan + aluminium heatsink · clips onto the two pins on the Pi 5',
362: 'tilting fan · carbon filter + 6 spares · built-in third hand · EU plug',
363: 'at home / Lidl',
364: 'moisture-proof · 12/24 V DC · blade fuses up to 30 A · 12 AWG wire',
365: 'input 8–20 V · 5 V / 3 A · USB-C output · with cables',
366: 'tracks · 2 DC motors · measured: height 124.6 mm, plate 152.2×134.8×2 mm, motor shaft 62 mm above the bottom edge · sprockets at the front top',
367: 'two non-marring parallel clamps · magnetic base · 10 × 10 × 0.5 cm',
368: 'UART, I2C, SPI, PWM decoders · for the FX2 analyser (fx2lafw)',
369: '1 g resolution · tare',
370: 'single-use · 5–6 h · up to ~50 °C in air · iron powder + charcoal + vermiculite · THEY NEED OXYGEN (the holes in the head)',
371: 'for Mega 2560 · Servo, Wire libraries',
372: 'closed-cell · 3 mm · cuts with a craft knife · does not absorb water',
373: 'have',
374: '4 mm hex socket · self-locking M5 · if the plate slots are ≥ 5.2 mm, instead of M4',
375: 'bookshop',
376: '5264 connector · 3 wires · ~20 cm',
377: 'cross head PH1 · zinc-plated · 25/30 mm',
378: 'sheets · P240 = prepping PETG before silicone/epoxy · P400 = finish',
379: 'small · for parts ≤ 50 mm',
380: 'brass · M3: OD 4.0 mm, L 5.7 (RX-M3x5.7) → 4.0 mm hole · M3S: L 4.0 for thin walls · pressed in with the soldering iron at 230 °C',
381: 'metal film 1 % · divider 12.6 V → 3.13 V · current 95 µA · if the kit has no 33 k → 10 k / 3.3 k (same ÷ 4)',
382: 'metal film resistors 1 % · ceramic and electrolytic capacitors · diodes · LED · NPN/PNP transistors',
383: 'metal frame · 300 mm blades · cut with slow long strokes, aluminium snags under pressure',
384: 'bench-mounted · jaw width ~75–100 mm · with pads for soft material (printed)',
385: 'stainless A2 · hex socket · M3 up to 20 mm (the axles need 25/30 — from Bauhaus)',
386: 'neutral cure (alkoxy) · 310 ml · skins over in ~15 min · full cure 24 h / 2 mm · −40…+150 °C · does not corrode copper/brass · does not bond well to PETG without primer → its role is sealing, not bonding',
387: 'nitrile/latex for epoxy; heavy-duty for cutting',
388: 'blade standard + mini · 2–35 A · colour-coded',
389: 'plain hex · 5.5 wrench · NOT self-locking',
390: 'fireproof, with an opening for the charger cable · 22 × 17 × 15 cm (both 3S 2200 mAh fit together)',
391: 'leaded · melts at 183–190 °C · 2.5 % flux core · 0.8 mm = all-purpose',
392: 'separate account · questionnaire · ≤ 2 min video total · photos ≤ 5 MB · $10 · by 4.01.2027',
393: 'parametric CAD · Simulation (Static Stress, local solve) · Motion Study · STEP/STL export · cloud files',
394: 'flat, round, triangular, square, half-round · ~140 mm · for holes 3–10 mm',
395: 'flat (spade) 6.3 mm · insulated · 1.5–2.5 mm²',
396: 'zinc-plated · ~20 g/pc · total ~240 g',
397: 'via FT232 (TX↔RX, GND) · sets ID, middle position, limits · shows position/load/temperature live',
398: 'profiles for K2 Pro · RFID materials · 4 perimeters / 10 bottom layers for the hull · sending over WiFi',
399: 'foam, double-sided · 19 mm · ~1 kg hold per 10 cm · not on PETG under water',
400: 'PG7 thread → 12.5 mm hole · cable 3–6.5 mm · IP68 with nut',
401: '42 mm grid · baseplate + bins 1×1…2×3 · PLA from leftovers · labels from TEDi',
402: 'pink (dissipative) or silver (shielding) · with zip',
403: 'hand block for 1/4 sheet',
404: 'cutting, split screen, text · export 1080p H.264 ≤ 250 MB',
405: 'silicone · 0.82 mm² · 4 × 1 m',
406: 'silicone · 2.1 mm² · flexible · up to ~30 A · 4 × 1 m',
407: 'syringe 1.4 ml · RMA · residue is mildly corrosive → wash off with IPA',
408: 'standard skeleton · for 310 ml cartridges',
409: 'page in Claude · loops (hypothesis → result), tasks, dashboard · written from the phone',
410: 'stripper 0.03–10 mm² (AWG 32–8) · crimps ferrules 0.25–4 mm² · cuts up to 10 mm²',
411: 'schematic + PCB · DRC · 3D viewer · AISLER Push plugin · opens .kicad_pcb v7',
412: 'text-based parametric CAD · F5 preview / F6 render · STL export · the whole robot in AR-Mini_v1.scad',
413: 'thermal · no toner/ribbon · Bluetooth from the phone · thermal paper fades with heat/sun → not on the BTS7960',
414: 'heat-resistant up to 500 °C · magnetic/with compartments · on top of the ESD mat',
}

assert sorted(T) == list(range(len(src))), (len(T), set(range(len(src))) - set(T))
out = {src[i]: T[i] for i in range(len(src))}
json.dump(out, open(SP + "bom_en_map.json", "w", encoding="utf-8"), ensure_ascii=False, indent=1)
print("written", len(out))
