TKyoseva/ARmini/hardware/breadboard/src/ladder_step.py

import matplotlib
matplotlib.use("Agg")
import matplotlib.pyplot as plt
from matplotlib.patches import Rectangle, Circle, Polygon, FancyBboxPatch

fig, ax = plt.subplots(figsize=(15, 11), dpi=150)
ax.set_xlim(0, 136); ax.set_ylim(-8, 104); ax.set_aspect("equal"); ax.axis("off")

COL = {"brown": "#7b3f00", "black": "#111", "red": "#d22", "orange": "#f80", "yellow": "#ffd400",
       "green": "#2a2", "blue": "#24c", "violet": "#80f", "grey": "#888", "white": "#fff", "gold": "#c9a227"}
CODES = {"100k": ["brown", "black", "black", "orange", "brown"],
         "33k":  ["orange", "orange", "black", "red", "brown"],
         "10k":  ["brown", "black", "black", "red", "brown"],
         "4k7":  ["yellow", "violet", "black", "brown", "brown"]}

def wire(p, q, c="#222", lw=2.2, z=3):
    ax.plot([p[0], q[0]], [p[1], q[1]], color=c, lw=lw, solid_capstyle="round", zorder=z)

def dot(p, c="#222"):
    ax.add_patch(Circle(p, 0.9, fc=c, ec="none", zorder=5))

def resistor(p, q, value, label=None, lw=2.2):
    """resistor body in the middle of the p→q wire, 5 colour bands"""
    import math
    (x1, y1), (x2, y2) = p, q
    L = math.hypot(x2 - x1, y2 - y1); ux, uy = (x2 - x1)/L, (y2 - y1)/L
    bl = 9.0; bw = 3.2
    mx, my = (x1 + x2)/2, (y1 + y2)/2
    wire((x1, y1), (mx - ux*bl/2, my - uy*bl/2), lw=lw)
    wire((mx + ux*bl/2, my + uy*bl/2), (x2, y2), lw=lw)
    ang = math.degrees(math.atan2(uy, ux))
    body = Rectangle((mx - bl/2, my - bw/2), bl, bw, fc="#3b6bd6", ec="#123", lw=1, zorder=6)
    import matplotlib.transforms as T
    tr = T.Affine2D().rotate_deg_around(mx, my, ang) + ax.transData
    body.set_transform(tr); ax.add_patch(body)
    for i, cname in enumerate(CODES[value]):
        off = -bl/2 + 1.3 + i*1.45 + (0.8 if i == 4 else 0)
        band = Rectangle((mx + off - 0.45, my - bw/2), 0.9, bw, fc=COL[cname], ec="none", zorder=7)
        band.set_transform(tr); ax.add_patch(band)
    if label:
        lx, ly = mx - uy*3.6, my + ux*3.6
        ax.text(lx, ly, label, ha="center", va="center", fontsize=8.5, weight="bold", color="#123", zorder=8,
                rotation=(ang if abs(ang) < 1 else 90))

def tap(p, kind):
    x, y = p
    if kind == "gnd":
        wire((x, y), (x - 2.5, y), c="#24c");
        for i, w in enumerate((2.6, 1.7, 0.8)):
            ax.plot([x - 2.5 - 0.6*i, x - 2.5 - 0.6*i], [y - w/2, y + w/2], color="#24c", lw=2)
        ax.text(x - 4.6, y + 2.2, "→ − rail\nGND", ha="right", va="center", fontsize=7, color="#24c")
    else:
        wire((x, y), (x - 2.5, y), c="#d22")
        ax.add_patch(Polygon([[x - 2.5, y - 1.3], [x - 2.5, y + 1.3], [x - 5.0, y]], closed=True, fc="#d22", ec="none"))
        ax.text(x - 5.6, y, "+ rail\n3V3", ha="right", va="center", fontsize=7, color="#d22")

# ---------- rails (left breadboard edge)
for x, c, lab in [(10, "#24c", "−  GND"), (15, "#d22", "+  3V3")]:
    ax.plot([x, x], [2, 97], color=c, lw=3, alpha=0.9)
    for yy in range(4, 97, 4): ax.add_patch(Circle((x, yy), 0.6, fc="white", ec=c, lw=0.8))
    ax.text(x, 99.5, lab, ha="center", fontsize=9, weight="bold", color=c)
ax.text(3.5, 50, "шините на левия BB400 · + е 3V3 от EXT1 пин 1, НЕ 5 V", ha="center", va="center", fontsize=7.5, color="#333", rotation=90)

# ---------- DevKit
DX, DY, DW, DH = 70, 14, 26, 78
ax.add_patch(Rectangle((DX, DY), DW, DH, fc="#d44", ec="#600", lw=1.5, zorder=2))
ax.add_patch(Rectangle((DX + 4.5, DY + 52), 17, 20, fc="#999", ec="#333", lw=0.8, zorder=3))
ax.text(DX + 13, DY + 62, "WROOM-1", ha="center", va="center", fontsize=7, zorder=4)
ax.add_patch(Rectangle((DX + 4.5, DY + DH), 17, 4.5, fc="#bbb", ec="#333", hatch="//", zorder=3))
ax.text(DX + 13, DY + DH + 2.2, "антена ↑", ha="center", va="center", fontsize=7, zorder=4)
for xx, lab in ((DX + 4, "OTG1 → Mac"), (DX + 15, "UART1")):
    ax.add_patch(Rectangle((xx, DY - 2.6), 7, 2.6, fc="#444", ec="#111", zorder=3))
    ax.text(xx + 3.5, DY - 4.4, lab, ha="center", fontsize=6.2, color="#333")
ax.text(DX + 13, DY + 30, "ESP32-S3\nDevKit-Lipo", ha="center", va="center", fontsize=9, weight="bold", zorder=4)
ax.text(DX + 13, DY + 20, "антената нагоре,\nEXT1 вляво, EXT2 вдясно", ha="center", va="center", fontsize=6.5, zorder=4)
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
