TKyoseva/ARmini/(commit log)

2026-10-07 repo: import of 28.09–07.10 work + rules + checks
    [AR-Mini_v1.scad, AR-Mini_xiao_breakout_rev0.kicad_pcb, AR_BOM_2026-10-07.xlsx, bom.csv, interfaces.scad, missions.csv]
2026-10-07 fw: fix SPI.h not found in CI (lib_ldf_mode deep+)
    Hypothesis: with lib_ldf_mode = deep+ and explicit Wire.h/SPI.h includes, the xiao_esp32s3 build in GitHub Actions finds SPI.h for Adafruit BusIO; pass = check workflow green on dev, 0 'SPI.h: No such file' errors.
    [main.cpp]
2026-10-08 fw: mission state machine + native tests (skeleton enum → firmware/armini, T1)
    New PlatformIO project firmware/armini: pure C++11 StateMachine in lib/core
    (IDLE, SEARCH, APPROACH, DEPLOY, LIFT, STOW, SHORE, SAFE), Hal interface,
    dry-run HAL for the ESP32-S3-DevKit-Lipo (serial commands in, CSV out at
    10 Hz), 15 Unity tests on the host. No pin is driven. All tunables in Config
    with SOURCE/VERIFY comments.
    Hypothesis: the mission logic is correct per T1 for any Config; verified only
    by host tests (pio test -e native: 15/15), not on hardware.
    [hal_devkit.cpp, hal_devkit.h, main.cpp]
2026-10-08 docs: check.sh runs armini host tests (pio run → pio run -e devkit_lipo + pio test -e native)
    Section 5 keeps the generic loop for other firmware projects and, for
    firmware/armini, builds the devkit_lipo env and runs the native Unity tests.
    Hypothesis: `bash scripts/check.sh` prints `check: OK` locally and in CI
    (ubuntu-24.04 has gcc for the native env).
2026-10-09 cad: v2.0 kick-up thruster mount + measured ROB0154 plate (L001, L003) · decision 0004 · STATE.md
    Hypothesis: with the kick-up hinge (pin z 75, 33 mm above the 42 mm waterline) the deployed duct top sits 10 ± 3 mm under the waterline with no hull holes below it, and ch_x 290 → 300 lands the measured plate slots within ±1.8 mm of the beams at x 385 / 500 (check via the plate_check print and the L005 coupon: all 4 M4 in by hand at 35.0 × 15.6).
    [AR-Mini_v1.scad]
2026-10-09 pcb: xiao-breakout-rev0 GND zone filled + DRC in CI (KiCad 9 → 10, warnings → errors only)
    Board saved from KiCad 10.0.6 with the bottom GND pour filled (was saved unfilled,
    so kicad-cli reported 7 "unconnected" GND pads in CI since the first push).
    check.sh: kicad-cli --refill-zones --severity-error, finds the macOS app bundle
    too. Workflow: ppa:kicad/kicad-10.0-releases (the board is now KiCad 10 format).
    Hypothesis: CI "check" on dev goes green with 0 DRC violations and 0 unconnected
    items; the exported Gerbers in the artifact now contain the GND pour.
    [AR-Mini_xiao_breakout_rev0.kicad_pcb]
2026-10-09 docs: English repo, LICENSE, English images and BOM (AR_BOM_2026-10-07 → 2026-10-09)
    Hypothesis: every file read by a reviewer of the repo is in English; the BOM
    spreadsheet is the 09.10 version only.
    [AR_BOM_2026-10-07.xlsx, AR_BOM_2026-10-09.xlsx, bom.csv]
2026-10-09 docs: CI check also on PRs into dev (pull_request branches main → dev, main)
    Night-task PRs (night/* → dev) now get a check status before Teddy merges them.
    Hypothesis: the next PR into dev shows a "check" status; pushes to dev/main unchanged.
2026-10-09 fw: devkit module confirmed N8R8 (VERIFY → SOURCE) · C010
2026-10-09 fw: safety layer with latch + ladder decoder, verdict feeds state machine (raw leak/kill/battery_low → debounced Safety verdict, T2)
    lib/core/Safety.h/.cpp: tick(SafetyInputs, now_ms) -> Verdict. Kill trips on the
    first tick (only non-debounced cause); leak 100 ms debounce; battery 500 ms
    debounce with hysteresis (trip < 9.9 V, clear > 10.5 V); heartbeat 500 ms.
    Latches; reset() only with no active cause. Priority KILL > LEAK > BATTERY > HEARTBEAT.
    lib/core/Ladder.h: A1 ladder decode (<0.6 KILL, 0.6-2.0 LEAK, >2.0 OK) with the
    10k/4.7k/1k resistor math; negative = not fitted. Decoded and OR-ed into leak/kill.
    Types.h: SafeReason::HEARTBEAT, Inputs::heartbeat_lost, Config::v_bat_low_v remov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
    [hal_devkit.cpp, hal_devkit.h, main.cpp]
2026-10-09 docs: armini README Safety section (state machine only → + safety causes, ladder math, latch/reset, hardware vs software)
    Adds the "Safety" section: three lines of defence (OE hardware kill, this
    module, task watchdog), the A1 ladder formula and table, VBAT divider, the
    cause table with debounce times and clear conditions, latch/reset rules,
    SafetyConfig with SOURCE/VERIFY status, new serial commands (hb, ladder) and
    a safety-only dry-run script. Test section updated to 33 cases.
    Hypothesis: Teddy can run the "Safety-only script" on the DevKit-Lipo dry run
    and see every listed reason in the CSV within ±1 tick (100 ms) of the stated time.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
2026-10-09 fw: bench sketches for 6 modules on the DevKit-Lipo (none → firmware/bench) · T3
    One PlatformIO env per module (bts7960, pca9685, st3215, mlx90640, bno055,
    ladder), src/common CLI + helpers, lib/benchcore (Ramp, Deadman, SoftLimit,
    CsvRow — pure C++11) with 17 Unity host tests, pins only in
    include/pins_devkit.h (SOURCE: breadboard 2b / VERIFY), one PROTOCOL.md per
    module and a README. Libraries pinned exactly. Builds with 0 warnings.
    Hypothesis: each sketch prints CSV at 10 Hz (MLX 4 Hz), ramps actuators at
    the configured rate (BTS: no two rows differ by > 13 PWM counts), refuses
    commands above the 60 % soft limit until `limit` is sent, and stops outputs
    within 2.0 s ± 0.1 s after th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
2026-10-09 fw: bench serial logger + CSV naming rule (none → scripts/bench_log.py, tests/data/README.md) · T3
    `python3 scripts/bench_log.py --port /dev/tty.usb* --card C005 --name bts-bench`
    writes data/logs/<date>_C005_bts-bench.csv, echoes to the screen, forwards
    typed commands to the board (logged as `# > cmd`), closes cleanly on Ctrl-C and
    never overwrites (_2, _3). `--fake` generates 3 s of CSV without hardware or
    pyserial; `--help` documents everything.
    Hypothesis: a 60 s bench run at 10 Hz yields 600 ± 5 rows in the file and
    pandas.read_csv(path, comment='#') loads it without errors.
    [bench_log.py]
2026-10-09 docs: DevKit-Lipo pin table + check.sh runs bench host tests (XIAO only → XIAO + DevKit-Lipo) · T3
    hardware/wiring/PINOUT.md gets the DevKit-Lipo table generated from
    firmware/bench/include/pins_devkit.h, with every VERIFY listed at the bottom
    (BTS7960 RPWM/LPWM order, IS pins, header pin numbers). scripts/check.sh
    section 5 builds all firmware/bench envs and runs `pio test -e native` there,
    like it already does for firmware/armini.
    Hypothesis: `bash scripts/check.sh` prints `check: OK` on dev after merging
    this PR, in CI and on the Mac, with no extra flags.
2026-10-10 tools: release video agent, picks + cuts + draft GitHub Release (none → tools/video, T5)
    make.py <rel> reads data/board/board.json and the card folders in iCloud, converts
    HEIC/MOV into build/video/cache, picks ≤ 3 items (rules path, or gemini-3.8-flash with
    the rules as fallback), writes a shot list, cuts a ≤ 45 s 1920×1080 H.264 clip with
    title card, lower-thirds from card fields and end card, and on --publish drafts a
    GitHub Release with gh and writes docs/releases/<rel>.md. 53 pytest cases, no network.
    Hypothesis: for a release with 2–3 cards the rules path yields a cut of 15–45 s (±0.5 s
    of title + items + end) on Teddy's Mac in < 2 min, and the shot list names every file.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
2026-10-10 docs: data/board README points at the video tool (board.json → make.py, rel = release name)
    Hypothesis: Teddy can go from Export JSON to a cut without reading the tool's source.
2026-10-10 fw: T3 review fixes (dm 10 s for manual steps, GPIO39 boot pull-up, st3215 resync) · T3
    Hypothesis: with `dm 10000` as step 0 Teddy can type each protocol step at human pace
    without a spurious `# DEADMAN`; `dm 2000` right before the dead-man step still shows the
    2 s trip within ± 0.2 s in the CSV. GPIO39 (L RPWM) during reset with the rocker in KILL:
    expected: record (if ≈ 3.3 V → pull-downs on GPIO39–42 for carrier revA, PINOUT VERIFY 4).
    st3215 `pos` resyncs the ramp to the real horn position whenever it is not mid-ramp.
    [main.cpp]
2026-10-10 docs: bts7960 protocol dm 10 s after the dead-man demo · T3
    Hypothesis: with step 4b (`dm 10000`) no `# DEADMAN` appears between steps 5–9 when
    typed at human pace; the 2 s trip is still logged once, between steps 3 and 4.
2026-10-10 fw: benchcore Csv buffer 40 → 48 (CI format-truncation) · T3
    Hypothesis: CsvRow::add(double, int) worst case (sign + 19-digit integer part + '.' +
    fraction + NUL) is 41 bytes; 48 removes gcc's -Werror=format-truncation in `pio test -e native`
    with no change in output (17/17 host tests still pass).
2026-10-10 ci: export an STL for every printed part
    Hypothesis: every print job gets its STL straight from the parametric CAD in CI, so the printed part always matches the committed parameters.
2026-10-10 tools: video agent uses ★ picks from captions.md, smaller Gemini requests, deletes uploads · T5
    Hypothesis: with ★ rows from captions.md the rules path picks Teddy's own photo for every starred card (0 misses on C001–C003, C010), and a Gemini request stays under 20 MB with photos at 1024 px (★ first; skipped files listed in the shot list); every File API upload is deleted right after the answer.
2026-10-10 docs: GitHub flow poster v1
2026-10-10 tools: parts agent — needs loader, order-by rules, 7 supplier adapters, report, tests (none → v0.1) · T4
    Hypothesis: with none of the 5 secrets set, `agent.py --dry-run` on the starter needs.yaml exits 0 in ≤ 60 s using ≤ 60 requests (measured 2026-10-10: 4 requests, 3.5 s); `pytest -q tools/parts` passes with no network (57 tests).
2026-10-10 ci: parts workflow — hourly 07–23 Sofia, state + REPORT.md on branch parts-bot (none → cron 7 4-20) · T4
    Hypothesis: a workflow_dispatch dry run on this branch prints the report in the job log and pushes nothing; actionlint 1.7.12 reports 0 problems.
2026-10-10 docs: parts/README — statuses, add a need, run locally, the 5 secrets; ignore agent output on dev · T4
    Hypothesis: Teddy can set up BotFather + the 5 secrets + first dry run from the README alone in ≤ 5 min.
2026-10-10 docs: FAILS_AND_FIXES 143–145 (thruster, hull bosses, printer jam)
2026-10-10 parts: watch list thruster_v2 (4 seeded) + night task T6 spec
2026-10-10 tools: parts agent watch lists, thrusters for v2 (none → T6)
    Hypothesis: seeded watch.yaml ranks W003, W001, W002, W004; a watch pass runs on the first run of the day or with --watch, stays within 20 requests, and a broken watch.yaml still exits 0.
2026-10-10 docs: FAILS_AND_FIXES 146 (nozzle at 140 °C)
2026-10-10 cad: TD-8120MG preset from C017 measurements (pocket, ear holes 48.26, case top) + FAILS 147
    [AR-Mini_v1.scad]
2026-10-10 cad: TD-8120MG from C017 (pocket 40.7x20.4x28.8, ear holes 48.26, case top 12.34, disc 8.84 -> idler boss 20.5, cradle 112) + FAILS 147
    [AR-Mini_v1.scad]
2026-10-10 docs: cradle width (123 → 112 mm) + FAILS 147 disc note
    Hypothesis: the plastic disc 8.84 mm above the case top puts the cradle rod centres 112 mm apart (±1 mm).
2026-10-10 cad: thruster bolt pattern 35.0 x 15.9 measured (A/B), coupon re-exported; STATE + 0004
    [AR-Mini_v1.scad]
2026-10-10 docs: decision 0005 — v1 controller = Olimex DevKit-Lipo, perfboard + Aisler carrier rev B
2026-10-11 docs: board export (2026-10-09 → 2026-10-11; R1a cut, C013–C033)
    Hypothesis: the AR-Mini Board export of 2026-10-11 12:50 UTC has R1a.cut set and 33 cards (was 12).
2026-10-11 docs: STATE 11.10 — R1a cut, C007/C008 pass
    Hypothesis: empty hull_fore draft is 12.99 mm (CAD 12.7) and the print is 345.0 g (slicer 344.79 g).
2026-10-11 hw: GPIO39–42 10k pull-downs (C015), header pins confirmed (C030)
    Hypothesis: a 10 kΩ pull-down on each of GPIO39–42 holds the BTS7960 PWM pins at ≈0 V through boot and download mode (GPIO39 was 3.15 V weakly HIGH), and the EXT1/EXT2 header map matches the board (C030).
2026-10-12 hw: carrier rev B spec + placement mockup (new) · C032
    Hypothesis: a 100 × 80 mm 2-layer carrier, DevKit on headers 25.40 mm apart, matches decision 0005 and is the file to lay out before the 13.10 order.
2026-10-12 docs: breadboard sheets 2b + 3 (new), DevKit across two BB400 · C027
    Hypothesis: DevKit-Lipo header rows are 25.40 mm apart (10 pitches), so the board spans two BB400s; sheet 2b's single 830 was wrong (measured C030, 11.10).
2026-10-12 cad: Pesho v3, SDF body + head + lid with float check (scad ball head → cad/pesho) · C021
    Hypothesis: a Ø46 × 68 capsule head takes the 82.6 × 52.3 mm warmer, and a shoulder ring plus M12 nuts in the boots keeps the face out of the water (numbers from pesho.py).
    [AR-Mini_v1.scad]
2026-10-12 docs: BOM arrivals 12.10 (Dispatch → Delivered ×16), lab supply 30 V/10 A, laptops · C006
    Hypothesis: the 12.10 deliveries are on the bench (16 rows that were in transit, plus the Jesverty SPS-3010N which is 30 V / 10 A, not 60 V / 5 A), and the two laptops are the workstations already in use.
    [bom.csv]
2026-10-13 hw: carrier rev B measured (U2 54.26, U3 Adafruit 2472, buck → DevKit USB-C, SPDT kill) · C032
    Hypothesis: with the measured U2 (rows 54.26, holes 54.26 × 17.36) and U3 (rows 17.78,
    holes 21.59 × 15.24) footprints, all 44 DevKit pins + both modules drop into the 1:1
    print of build/AR-Mini_carrier_revB_1to1_F.pdf within ±0.2 mm; kicad-cli DRC 0 errors.
    gen.py: U2 two 1×6 rows along X + 4 × Ø2.7, only resistors under it; U3 JP1 1×6 + JP2 1×4
    (mechanical) + 4 × Ø2.7 from Adafruit's BNO055.brd; U4A/U4B, F1, Q1, D1, C1, C4 and the
    12V_IN/12V_PROT/5V_RAW nets removed; J1 2-pin VBAT_SENSE → R1/R2/C5, TP1 = VBAT;
    J4/J5 6-pin (RPWM, LPWM, EN, +3V3, IS, GND); J10 3-pin (+5V, EN, GND);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
    [AR-Mini_carrier_revB.kicad_pcb, bom.csv]
2026-10-14 cad: thruster kick-up pin 14 → 19 (arm boss collided with the bracket plate) + STLs · C041
    Hypothesis: with th_pin_dx = 19 the arm's r 12 hinge boss sits 1.0 ± 0.3 mm aft
    of the 6 mm bracket plate through the whole 0–100° kick-up swing (boss front at
    x = 7, plate face at x = 6); lugs 5 mm longer, duct 5 mm aft (overall 733 → 738).
    Guarded by assert(th_pin_dx - 6 >= 12 + 1). FAILS 151.
    Exported build/thruster_bracket.stl and build/thruster_arm.stl (build/ is gitignored).
    [AR-Mini_v1.scad]
2026-10-14 bom: hanging scale 50 kg/10 g ×2 (new row 139), kitchen scale (Check at home → Have) · C025
    Hypothesis: a 50 kg / 10 g hanging scale in line with the tether reads the
    bollard-pull of one Cuifati thruster (listing says 1.2 kg) to ± 20 g.
    [bom.csv]
2026-10-15 hw: carrier rev B U2 footprint 54.26 → 55.88 × 19.05 (1:1 check failed), holes Ø3.0, PCA9685 datasheet notes · C032
    Hypothesis: with U2 rows 55.88 apart and holes on 55.88 × 19.05 (pin 1/6 to hole 3.175,
    the Adafruit 2.20" × 0.75" pattern), all 12 PCA9685 pins and 4 standoffs drop into the
    1:1 print of build/AR-Mini_carrier_revB_1to1_F.pdf within ±0.2 mm, with real header pins
    pushed through the paper (SPEC §9.2); kicad-cli DRC 0 errors, 0 warnings except the
    cosmetic 'AR-Mini' library ones.
    The 13.10 caliper reading was corrected: tips in two holes already read the centre
    distance (55.99 / 19.09); subtracting the 1.73 "single-hole" reading gave the wrong
    54.26 × 17.36 and the pin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
    [AR-Mini_carrier_revB.kicad_pcb]
2026-10-16 docs: session files into the repo (board page, PCB checks + DRC rounds, STL v1, drawings, process history), card files/media metadata, ASSETS.md · C032
    [2026-10-13_U2-54.26_failed-paper-check.kicad_pcb, arch_post.stl, arm_drive.stl, arm_idler.stl, coupler.stl, hull_aft.stl, hull_fore.stl, pivot_bracket.stl]
2026-10-16 board: History tab and CH history cards (0 → 15) · CH01–CH15
2026-10-18 release: R-1018 cut (8 cards, R1a → R-1018) · C041
2026-10-20 cad: cable slot in cam_pan_mount (closed pocket → 10 × 18 slot at the spline end) · C038
    Hypothesis: with servo_cable_w 10 × servo_cable_d 18 through the -x end wall the TD-8120MG drops fully into the cam_pan_mount pocket, ears flat on the block face (gap ≤ 0.5 mm), cable and plug passing through the slot; the two inserts at that end are sacrificed as on the drilled C038 prototype. Outlet size not measured yet (MEASURE on the servo before printing).
    [AR-Mini_v1.scad]
2026-10-21 cad: cam_pan_mount servo (TD-8120MG pocket → MG90S pocket, M2 ears, cable windows both ends) · C038
    [AR-Mini_v1.scad]
2026-10-21 bom: ESC level shifter + bench kit (row 139 → 145: 74AHCT125 × 5, DIP-14 socket × 3, mop bucket, bar clamp, pyrography set, pine blocks × 4) · C006
    [bom.csv]
2026-10-21 media: C006 and C045 rows in the card → folder table (none → C006 Pass, C045 open) · C006
2026-10-22 fw: ladder env Serial on UART0 (CDC_ON_BOOT 1 → 0) · C027
    Hypothesis: with the flag 0, Serial on the ladder sketch is UART0 (CH340, right port) so the bench log is on the port Teddy watches.
2026-10-22 media: C042 row in the card → folder table (none → C042 open) · C042
    Hypothesis: the thruster-fit loop folder is reachable from the card table as C042_2026-10-21_thruster-fit.
2026-10-22 docs: night tasks T7 pca9685 pair and T8 ladder 30k (none → task files) · C023 / C027
    Hypothesis: the pair command and the 30 k divider are specified before the firmware change, so the bench cards have a written test.
2026-10-22 firmware: ladder divider bottom (33k → 30k) · C027
    Hypothesis: v_bat = v_adc × 130/30 (4.33) matches the measured 100 k / 30 k divider, so 12.6 V is about 2.91 V at GPIO4.
2026-10-22 fw: pca9685 pair for two mirrored servos (single channel → pair) · C023
    Hypothesis: pair 10 11 <deg> moves both TD-8120MG from one degree, chB = 3000 µs − chA, so the U lifts in step; 215° and a pulse outside the soft window are refused. Not yet run on hardware.
2026-10-23 docs: FAILS 171–172 first powered lift + night task T9 pair trim (170 → 172) · C023
    Hypothesis: the I2C one-pin-off and the sheared arm screws are written down with their fixes before the trim command, so the next lift starts from the clocked-arms rule.
2026-10-23 fw: pca9685 pair trim (none → ±200 µs per channel) · C023
    Hypothesis: trim 11 <us> in ≤ 20 µs steps brings the two arms to the same angle within ± 1° at pair 10 11 90 and the match holds at 60° and 120°; the empty U then lifts with < 0.3 A standing. PROTOCOL rocker text fixed to the wiring used 22.10 (C → GPIO14, KILL → GND, OE open).
    [main.cpp]
2026-10-23 docs: night task T10 esc env (none → task file) · C024
    Hypothesis: the esc bench env is specified, with the C006 signal-level measurement as step 1, before any ESC is connected to GPIO1/2.
2026-10-23 fw: bench esc env (no sketch → LEDC GPIO1/2, arm, diff, KILL) · C024
    Hypothesis: after `arm` (3 s at 1500 µs) the thruster in the bucket turns forward at l 1550 and reverse at l 1450, `l 1700` is refused at the 1350–1650 limit, and the KILL rocker stops the prop in < 0.5 s. C006 (signal-wire voltage) is measured before GPIO1 is connected. Not yet run on hardware.
    [main.cpp, pins_devkit.h]
2026-10-23 docs: night task T11 esc invert (none → task file) · C006
    Hypothesis: the C006 result (ESC signal pulled up to 5 V through ≈ 3.9 kΩ) is written into a task before the esc output is inverted for the S8050 shifter.
2026-10-23 fw: esc output inverted for NPN shifter (direct → S8050, ESC pulls up to 5 V) · C006
    Hypothesis: with GPIO1 → 1 k → S8050 (10 k base → GND, collector → yellow) and the inverted LEDC duty, the collector carries a 1500 µs pulse every 20 ms (± 5 µs on the analyser) and the ESC arms on `arm`; before setup() the transistor is off and the ESC sees no pulses.
    [main.cpp]
2026-10-23 cad: thermal cameras + XIAO Sense fixed on the arch (pan mount → cam_fixed_mount, 15° down; pan later C046) · C038
    Hypothesis: cam_fixed_mount slides onto the arch tube and the plate leans 15° ± 1° below horizontal; both thermal boards' M2 holes line up with the board holes (± 0.3 mm; board A holes still MEASURE) and the XIAO Sense sits in its frame with USB-C reachable. STL not exported locally (no OpenSCAD on the Mac); CI renders it.
    [AR-Mini_v1.scad]
2026-10-23 bom: M3 standoff kit, cotter pins, HSS drills, M4 × 40 + A2 nuts (145 → 152 rows) · C042
    [bom.csv]
2026-10-23 docs: night task T12 remote wifi (none → task file) · C028
    Hypothesis: the phone remote (WiFi AP, sliders, 500 ms heartbeat) is specified with the C025 dead band and the C027 VBAT fit before any code is written.
2026-10-23 fw: bench remote env (none → WiFi AP, phone sliders, 500 ms heartbeat) · C028
    Hypothesis: with the phone on AP AR-Mini, slider +100 gives 1650 µs on both ESC outputs within 0.75 s ±0.1 s, and airplane mode gives # SAFE heartbeat with both at 1500 µs within 0.6 s of the last message.
2026-10-23 fw: remote linkLost signed age (false SAFE heartbeat → none) · C028
    Hypothesis: with the phone connected and sending every 100 ms, no # SAFE heartbeat appears in 5 min of idle and slider use; airplane mode still gives # SAFE heartbeat within 0.6 s.
2026-10-24 fw: remote page sliders (track 0 px tall, every touch ±100 → full-height tracks, proportional) · C028
    The slider track had height:90% inside a wrapper with auto height, so it
    resolved to 0 px: only the knobs showed, the thrust/turn labels sat hidden
    under them, and mv() divided by a zero height, so any touch sent t/r = ±100
    (1650 / 1350 µs) depending on whether the finger was above or below the
    knob centre. Wrappers are now flex columns that stretch to the row and the
    track takes flex:1; mv() ignores a zero-height track.
    Checked in an iPhone 13 emulation (Playwright): track 416 px, labels
    visible; centre → 0, 1/4 up → 50, top → 100, 1/4 down → −50, release → 0.
    Not yet run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
    [main.cpp]
2026-10-24 docs: FAILS 173 right thruster does not start (open → ESC/motor fault, claim) · C025
    Hypothesis: swapping the right ESC onto the left motor (and back) shows whether the fault follows the ESC or the motor; the faulty part draws the same ~2 A clicking at 12 V within ±0.3 A.
2026-10-24 docs: FAILS 173 GPIO2 re-check (open → GPIO2 OK, right thruster faulty) · C025
    Hypothesis: a replacement right thruster on GPIO2 (row 13) spins at r 1600 with no clicking, like the left one does.
2026-10-24 docs: release R-1024 (Done 13 → Released, page + LOG + STATE) · C028
2026-10-24 docs: FAILS 174 remote SAFE on ARM (unsigned age → signed) · C028
2026-10-25 docs: .mailmap unifies Teddy's four commit identities (5 authors → 2) · C013
    Hypothesis: git shortlog -sne --all lists exactly two names, Teodora Kyoseva (86) and parts-bot (1); history unchanged.
2026-10-25 firmware: xiao env cam, OV3660 MJPEG stream (none → VGA stream) · C049
    Hypothesis: iPhone on AP AR-Mini-cam opens http://192.168.5.1/ and sees a live 640x480 picture; serial reports fps 10 ± 5 with one viewer and the heap does not fall over 5 min.
2026-10-25 firmware: bench env thermal, D45 + 110° on the DevKit (110° only → both cameras) · C048
    Hypothesis: at boot the scan finds the D45 at 0x66 (not hard-coded) and both cameras give rows at 250 ± 20 ms; on a uniform wall mean_C of d45 and w110 agree with the ThermoSpot within ± 3 °C.
2026-10-25 firmware: xiao cam SD recording (stream only → stream + rec to microSD) · C049
    Hypothesis: with a 32 GB FAT32 card, rec 1 while one phone streams keeps the stream at ≥ 8 fps (or prints the every-2nd-frame switch), and frames_to_mp4.sh turns a 60 s run into an mp4 whose length is 60 ± 2 s.
2026-10-25 firmware: xiao cam stream on :81 + one-file recording (one JPEG per frame, 15→8 fps → video.mjpeg) · C049
    Hypothesis: with the stream open on :81, /rec?on=1 on :80 answers within 1 s and the stream stays ≥ 8 fps; rec_fps holds 12 ± 3 over 60 s instead of falling from 15 to 8; frames_to_mp4.sh gives an mp4 of 60 ± 2 s.
2026-10-25 firmware: xiao cam recorder independent of the stream (stream-fed, 0.5 fps → own task) · C049
    Hypothesis: with the phone streaming at whatever fps the link allows (run 2: 0.5–1.5), rec_fps stays ≥ 10 for 60 s and the mp4 is 60 ± 2 s long; stream fps with the phone 1 m from the XIAO (rssi > −60 dBm) is ≥ 5; tx kB/s ≈ fps × 25–40 kB (VGA q12).
2026-10-25 firmware: bench boot log survives RST + d45 timeouts (lost banner → `boot` replays it) · C048
    Hypothesis: after RST with the monitor open, the banner appears within 3 s in ≥ 4 of 5 tries, and `boot` reprints every setup line in all 5; with the D45 SDA pulled, the sketch keeps printing w110 rows at 4 Hz ± 1 and `WARN d45 timeout` appears within 1 s.
2026-10-25 firmware: thermal mean skips NaN pixels + masked serials (mean overflow → finite mean) · C029
    Hypothesis: on the same 110° board, mean_C lies between min_C and max_C on 100 % of rows over 60 s (was 9.2e17), the WARN names the same pixel count ± 2 on every print, and no row contains a value > 1000.
    [main.cpp]
2026-10-25 firmware: thermal init retries + `init` command (first probe missed → 5 tries, 110° 300 ms / D45 200 ms) · C048
    Hypothesis: over 10 power-ups both cameras come up at boot in ≥ 9, the 110° within attempts 1–3 and the D45 READY read within attempts 1–2; the one miss, if any, comes up with `init` without a reset.
    [main.cpp]
2026-10-26 docs: FAILS 175–177 thermal bring-up (bus hang, wrong port, NaN mean) · C048 C029
2026-10-28 docs: system architecture v2 (v1 of 06.10 → as built 27.10) · P03
2026-10-28 docs: architecture v2 in four views (block, parts, schematic, breadboard) · P03
2026-10-28 media: LINKS.md card rows (41 → 55) · C053 C054
2026-10-28 docs: visual BOM v3 (v2 of 09.10 → status 28.10, first dry assembly) · C053
2026-10-28 docs: system architecture v3 poster (v2 block diagram → as built 28.10 with photos) · C053
2026-10-29 firmware: Mega thruster bench sketch, PlatformIO (ESP32 S8050 stage → Mega pin 9 direct) · C055
2026-10-29 docs: C055 result, FAILS 173 confirmed on the Mega (open → right thruster faulty, 3 drivers) · C055
2026-10-29 cad: beam_leg + centre rudder for the pool run (transom → beams) · C056
    [beam_leg.scad, beam_leg.stl, rudder.scad, rudder_blade.stl, rudder_hub.stl, rudder_mount.stl]
2026-10-29 firmware: remote_rudder env (2 ESCs → 1 ESC + MG90S rudder on GPIO2) · C056
2026-10-31 cad: rudder_frame — one-piece rudder mount between beam_leg and thruster_bracket (collar rudder_mount superseded) · C057
    [rudder_frame.scad, rudder_frame.stl]
2026-10-31 firmware(remote): envs remote_rudder_hct (74HCT125, not inverted) + remote_pool (cradle lift on PCA9685 CH10/11 from a third phone slider) · pool run 31.10
    [main.cpp]
2026-10-31 media: LINKS C058 + C059 rows, docs/diagrams FINAL 2 breadboard sheet (0 → 2 files; schematic + per-group sheets not on this Mac yet) · C059
2026-10-31 docs: FAILS 178–179 (rails mirrored, GPIO1 in 1OE) · C059
2026-10-31 remote: lift servo A CH10 → CH12, PCA9685 CH10 output dead (10 → 12) · C059
    Hypothesis: with kLiftChA = 12 the boot banner reads LIFT CH12/CH11 and servo A plugged into CH12 follows the lift slider 50–130° together with B on CH11 (mirrored), ±0°; CH10 stays unused.
2026-10-31 remote: lift servo B CH11 → CH13, PCA9685 CH11 output dead too (11 → 13) · C059
    Hypothesis: with kLiftChB = 13 the boot banner reads LIFT CH12/CH13 and servo B plugged into CH13 mirrors servo A on CH12 (us_B = 3000 − us_A) across the lift range 50–130°, ±2°; CH10 and CH11 stay unused.
2026-10-31 remote: PCA9685 I2C clock 400 kHz → 100 kHz, second lift channel not updating (400000 → 100000) · C059
    Hypothesis: at 100 kHz standard mode over the long I2C jumpers every register write to the PCA9685 lands, so lift 90 / 60 / 120 moves both cradle servos together (A on CH12, B on CH13 mirrored) within ±2° of each other; at 400 kHz only one channel updated.
2026-10-31 remote: PCA9685 I2C clock back to 400 kHz, 100 kHz did not fix the lift (100000 → 400000) · C059
    Hypothesis: the I2C clock is not the cause — at 100 kHz the same single lift channel moved (the higher PCA9685 channel), so the diff of 31.10 holds only the channel change CH10/CH11 → CH12/CH13; at 400 kHz the banner still shows LIFT CH12/CH13 and the board behaves identically.
    [main.cpp]
2026-10-31 media: LINKS C059 row + bathtub test, docs/diagrams FINAL 2 schematic + per-group sheets 5d/9a/10/10cd/12d/14/15 (2 → 17 files) · C059
    Hypothesis: every 1031 sheet handed over from the workshop chat (FINAL 2 breadboard re-export, FINAL 2 schematic, 7 per-group sheets as .png + .html source) is now in the repo, so a wiring check at the lake can be done from docs/diagrams alone; 17 files in total, PNG in docs/diagrams/, HTML in docs/diagrams/src/.
2026-10-31 docs: FAILS 180 (lift one channel only, OPEN; 178–179 already in) · C059
    Hypothesis: the fault sits in this PCA9685 module (or its PWM pins), not in the firmware or the servos — with a second PCA9685 module both lift servos move together on the same two channels within ±2°; if they still don't, the scope on both PWM pins during `lift` shows which pin stays flat.
2026-10-31 cad: printed-parts scene for Fusion 360, 19 models (none → STEP + 3MF) · C057
    Hypothesis: the STEP opens in Fusion 360 as 19 separate bodies laid out as in render.html, every body matches its cad/stl/v1 STL within ±0.1 mm, and the slide P26 (iCloud 07_Portfolio) shows all 19 printed parts.
    [AR-Mini_printed_parts.3mf, AR-Mini_printed_parts.step]
2026-10-31 cad: stl/v1 lists every printed part (14 → 19 models; coupon marked skipped) · C057
    Hypothesis: beam_bracket.stl (C045) and cam_fixed_mount.stl (C047) are byte-identical to the files that were sliced and printed (copied from build/), and the README rows cover all 19 printed models with thruster_coupon marked skipped (C011, never printed).
    [beam_bracket.stl, cam_fixed_mount.stl]
2026-10-31 docs: system architecture poster (v3 28.10 → v4 as wired 31.10) · C059
    Hypothesis: every block and fuse on the v4 poster (F1 thruster, F2 QIQIAZI → PCA9685 V+, F3 empty, F4 MZHOU + VBAT sense, 74HCT125, beam_leg + MG90S rudder, lift on CH12/13) matches the box as photographed on 31.10 with zero differences on a pin-by-pin walk-through; v1–v3 stay in docs/diagrams/ as history.
2026-11-01 cad: printed-parts slide number after the portfolio reorder (P26 → P08) · C057
2026-11-01 docs: release R-1101 (Done 10 → Released, page + LOG + STATE) · C059
2026-11-01 data: board export for R-1101 (18.10 → 01.11) · C059
2026-11-01 docs: README front page for the public repo (status 09.10 → 01.11, lake run, R-1101, as-built table) · C059
2026-11-02 docs: FAILS 180 closed — servo columns counted from 1 (OPEN → CLOSED) · C060
2026-11-05 bom: add servo extensions ×30, M3 kit, IP65 box 200×100×70 (152 → 155 rows) · C060
    [bom.csv]
2026-11-05 docs: C072 enclosure plan + box and perfboard diagrams (none → rev 2) · C072
2026-11-05 cad: C072 logic tray for the EXP14 board on the rev B grid (none → v1) · C072
    [C072_logic_tray.scad]
2026-11-05 docs: LOG 05.11 — c57da3d also carries the C072 BOM rows (155 → 159) · C072
2026-11-10 docs: C072 one EXP-14 logic board — carrier drawing, boxes rev 2 → rev 3, plan rev 3 · C072
2026-11-10 cad: C072 logic tray standoffs on the EXP-14 factory holes (93 × 73 → 76 × 90.1) · C072
    [C072_logic_tray.scad]
2026-11-10 bom: EXP-14 measured 100 × 90 not cut (156 To buy → Have), 159 note, Preciva 992D+ station (159 → 160 rows) · C072
    [bom.csv]
2026-11-10 bom: replacement Cuifati right thruster, source confirmed (— → row 161 Delivered, Amazon) · C055
    [bom.csv]
